RolandThsive/3D-printer-Plastic-Recycler/1.png

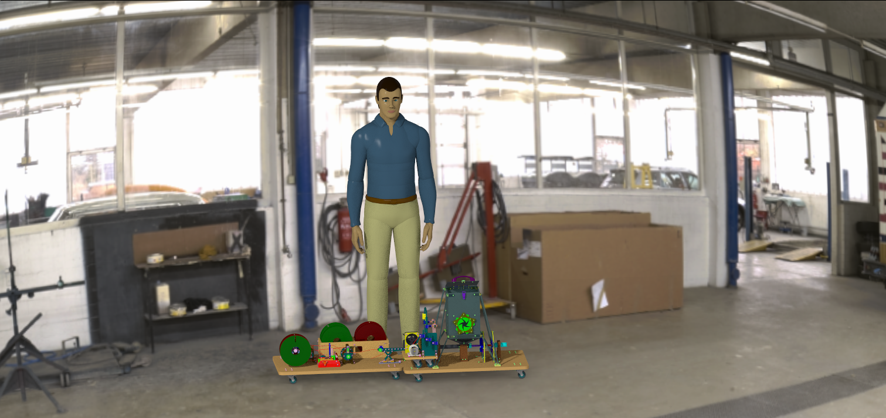
1.png
