RolandThsive/3D-printer-Plastic-Recycler/README.md

# 3D-printer-Plastic-Recycler
A device to recycle 3d Printed plastic back to filament

To view the final file - Go to assemblage_final - It containes the whole assembly.
