RolandThsive/3D-printer-Plastic-Recycler/2020-05-30 Données annexes (André ERNESTO)/2019-12-06 Rapports de conception/Projet Bobineuse - Groupe A1.pdf

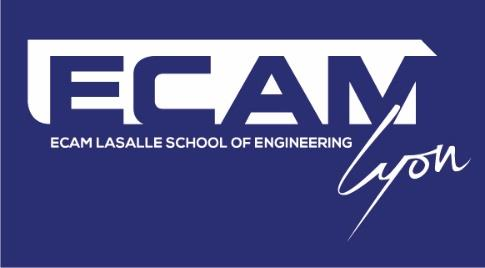
[picture p2: figure]

# RAPPORT DE PROJET BOBINEUSE

### Par FIL’ECAM3D

### ARTS ET METIERS PROMO 2022

Tuteur : Mr. Ernesto André

Membres du projet : | GROUPE A

Ambroggi Franc
Caltran Thibault
De Salins Hippolyte
Hugonnot Sarah

Khelifi Antoine
Masseret Alexandre
Mangin Simon
Picou Adrien

# Sommaire :

# - Introduction au projet

# - Prémices du projet

# - Les différents pôles de la bobineuse : I) Guidage et découpe II) Orientation du fil III) Maintien de la bobine IV) Moteur V) Support général VI) Sécurité et pédagogie

# - Annexes

Introduction du futur projet :

L’année dernière, l’ECAM a mis en place une extrudeuse afin de pouvoir fabriquer son propre fil polymère utilisé pour les imprimantes 3D.

Le but final est de faire des économies quant à l’achat de bobines de fil pour imprimantes 3D mais aussi de participer au recyclage des déchets plastiques (pots de yaourt, emballages, bols…) qui peuvent servir de matière première pour ces fils. Cela ira du nettoyage des déchets plastiques au stockage des bobines avant l’utilisation pour les imprimantes 3D. En outre, l’alimentation en électricité pour être renouvelable (solaire par exemple). Après l’extrusion, une bobineuse est nécessaire pour enrouler le fil proprement sur des bobines et ainsi pouvoir le stocker plus facilement. Cette machine est donc un besoin matériel mais aussi essentiel afin de répondre aux différents besoins. Ce besoin est apparu parce qu’à la sortie de l’extrudeuse, le fil polymère se déposait sur l’embase de l’extrudeuse de manière désorganisée.

Elle devra pouvoir être utilisé par le corps enseignant de l’ECAM mais aussi par les étudiants travaillant sur divers projets. Cette bobineuse se situera au FABLAB sur une chaîne de production juste après l’extrudeuse. Celle-ci pourra aussi être amenée à être déplacé au sein de l’école ou même en dehors selon les cas d’usage. La machine pourra être accessible à tous, que ce soit pour l’observer et comprendre son fonctionnement ou bien l’utiliser en vue de mener divers projets.

De plus, cette machine est avant tout un projet avec un but pédagogique. Celui-ci doit amener les étudiants à travailler en groupe pour commencer à vivre une première expérience de réflexion sur un projet. Ce groupe de travail devra apprendre à résoudre les différents problèmes jalonnant cette entreprise afin de trouver les meilleures solutions et ainsi concevoir une bobineuse avec un rendement optimal. Il aura la fonction de bureau d’études, de bureau des méthodes et enfin d’atelier de fabrication. Pour cela, les huit étudiants en ECAM3 ARTS ET MÉTIERS, Franc AMBROGGI, Thibaud CALTRAN, Hippolyte DE SALINS, Sarah HUGONNOT, Antoine KHELIFI, Alexandre MASSERET, Simon MANGIN et Adrien PICOU devront piloter un projet, concevoir et dimensionner un système mécatronique, utiliser les outils numériques de CAO et fabriquer la bobineuse à l’aide d’un prototypage rapide. Cette équipe sera encadrée par Mr André ERNESTO, professeur de conception mécanique et CAO.

Prémices du projet :

## La mise en forme de notre bobineuse s’est faite à l’aide de

plusieurs outils connus dans le monde de l’industrie.

## Nous avons commencé en créant une bête à cornes puis un diagramme en pieuvre pour pouvoir sortir des fonctions importantes de notre bobineuse. Ces fonctions se sont incorporées dans notre cahier des charges que notre professeur

nous a préalablement fourni.

## Nous avions un budget de 750€ et après estimation, nous

avoisinons les 300€ de frais matériels.

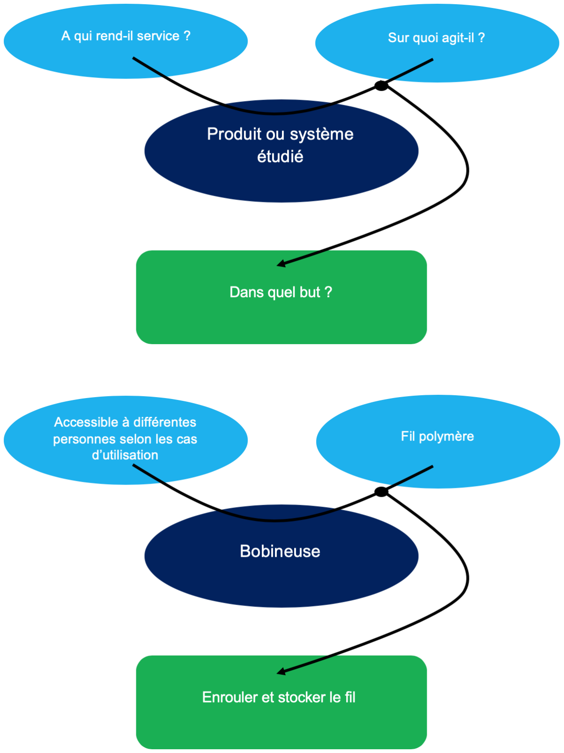
[picture p3: figure]

# La bête à cornes

# Fil

# Bobine

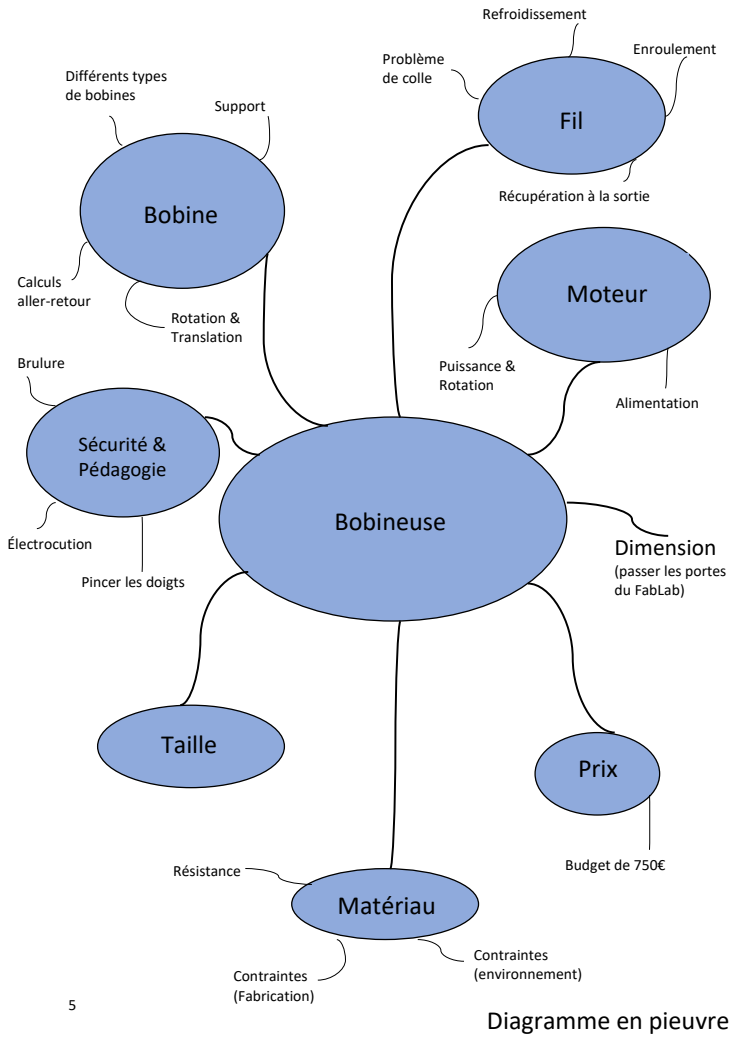
[picture p4: page 6]
Bobineuse; Moteur; Taille; Prix; Matériau; Différents types de bobines; Support; Rotation & Translation; Sécurité & Pédagogie; Calculs aller-retour; Problème de colle; Refroidissement; Enroulement; Résistance; Contraintes; (environnement); (Fabrication); Budget de 750€; Brulure; Électrocution; Puissance & Rotation; Alimentation

Récupération à la sortie

Dimension
(passer les portes
du FabLab)

Pincer les doigts

Diagramme en pieuvre

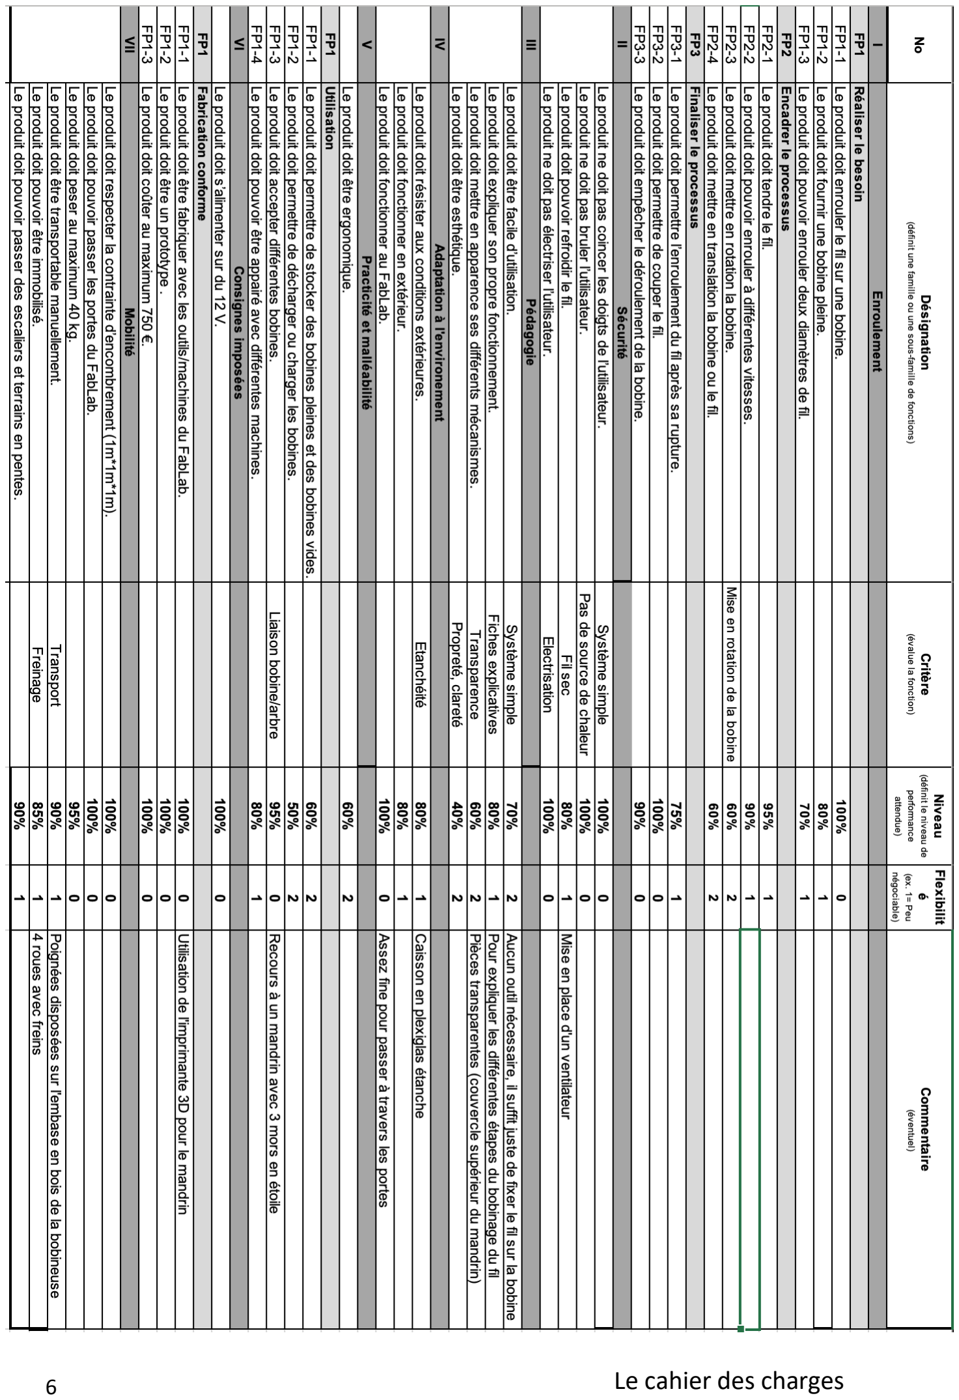
[picture p5: page 7]

6 | Le cahier des charges

# SOUS-ENSEMBLE : GUIDAGE ET DÉCOUPE

## TABLES DES MATIERES :

## I) Description du problème II) Principe du stylo rétractable III) Coûts

I) Description du problème

Tout d’abord, cette partie de la bobineuse est la première de la chaîne. Ce système est composé de deux pièces : une première pour découper le fil et une autre pour maintenir le fil pour éviter que le fil déjà enrouler sur la bobine se déroule. Ce système peut intervenir en cas de problèmes ou lorsque la bobine est pleine. Il fonctionne manuellement et nécessite donc l’aide du technicien responsable de la machine. Il suffit d’appuyer une première fois sur un bouton pour actionner la machine, le fil va alors être découpé au niveau de la sortie de l’extrudeuse. Le système est alors bloqué dans cette position grâce au principe du « stylo » afin que la pince maintienne le fil. Puis pour enlever la bobine pleine, il suffit qu’une personne maintienne le fil, en le gardant tendu, afin que la pince puisse retrouver sa position initiale en appuyant une seconde fois sur le bouton.

II) Principe du stylo rétractable

Le mécanisme a été placé pour la première fois dans un Parker Jotter, (https://en.wikipedia.org/wiki/Jotter) usine de fabrication de stylo, en 1954 et s’est vendu dans cette seule configuration à plus de 750 millions d’exemplaires. Ce système repose en une géométrie simple mais efficace. L'idée nous est venue car nous souhaitions que le fil soit à la fois maintenu et coupé, et qu'une fois coupé ce dernier reste maintenu.

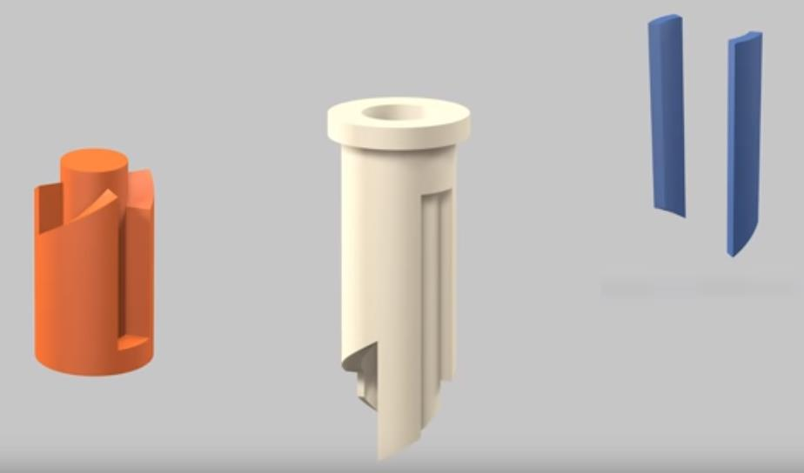
[picture p6: figure]

Vidéo explicative sur YouTube : How a Retractable Ballpoint Pen Works

lien: https://www.youtube.com/watch?v=MhVw-MHGv4s&t=181s

Pourquoi ce système ?

Au départ, nous avions pensé à un mécanisme capable d’effectuer les deux actions simultanément, puis on s’est rendu compte qu’il nous fallait une marge plus grande, pour qu’entre la découpe et le maintien se trouve suffisamment de fil pour ensuite pouvoir le récupérer manuellement. Alors nous avons imaginé un système divisé en deux parties mais qui sont mis en marche en même temps et par le même mécanisme, ici un bouton poussoir.

## III) Coûts

- 20*TÊTE CYLINDRIQUE BOMBÉE LARGE EMPREINTE POZIDRIVE TCBLZ DIN 7985 : 2,06€
- 20*RONDELLE "Z" ACIER ZINGUÉ BLANC NFE 25513 : 0,17€
- Boîte de 5 ressorts de compression : 6,10€
- 1*tige de longueur 80mm et de diamètre 10mm ; tige qui sera ensuite percée puis taraudée aux deux extrémités à 5mm : 3,38€
- Barre de métal carrée creuse (section :10*10mm) et 1 m de longueur pour usinage : 6,10€
- Pylône en acier creux : 20*20mm et 1m de longueur pour usinage : 7,20€
- 2*patins de pinçage en plastique à usiner dans une plaque en plastique : 2€
- 1*cylindre creux (diamètre extérieur : 20mm ; diamètre intérieur : 16mm) : 5€
- 10*écrou M5 : 0,48€
- 1 pièce intermédiaire à usiner : pièce de métal plate de 2mm d’épaisseur, 15mm de hauteur et de 50mm de longueur, trous percés aux 2 extrémités : 3,90€ : -trou de 10,5mm

-trou de 5,5mm

- 2 pièces imprimées en 3D (pour le maintien et l’amortissement de la lame lors de la découpe)
- Lame à découper dans une plaque de métal puis à aiguiser si besoin
- Tôle en métal : 5,99€ ; dans laquelle on usine 3*socles cylindriques ( 1mm d’épaisseur) à souder sur les 2 pylônes et le cylindre creux
- Système du stylo à imprimer en 3D

Total : 42,38€

Sources : | « commentfer.fr » | , | « visseriesfixations.fr », | « rs-online.com »,
« leroymerlin.fr »

# SOUS-ENSEMBLE : ORIENTATION DU FIL

## TABLE DES MATIERES

I- | Schéma cinématique
II- | Fonctions contraintes et principales du Cahier Des
| Charges

## III- Désignations des pièces - Choix matériaux et moyens de fabrication - Dimensionnement - Références des pièces à acheter IV- Analyse budgétaire V- ANNEXE : Dessins

I- Schéma cinématique

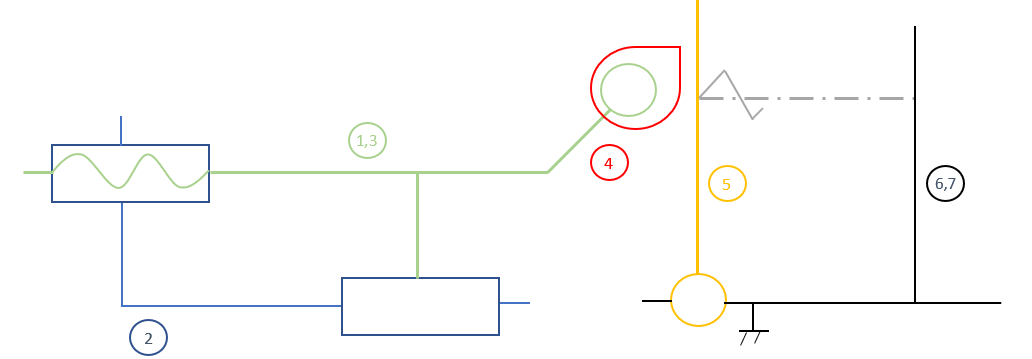
[picture p7: figure]

Fonctionnement global du sous-ensemble :

Le but de ce sous-ensemble est d’orienter le fil de façon à remplir la bobine uniformément entre ses deux extrémités. Pour cela, le fil est contraint de suivre le mouvement de l’extrémité de la pièce N°5. Cette même pièce est en liaison pivot avec le bâti, ce qui lui permet d’osciller dans un mouvement de balancier. Ce mouvement est contrôlé par la came N°4 qui pousse la pièce N°5 dans un sens et par le ressort N°5a qui la ramène dans sa position initiale. Ce mouvement est également implicitement contrôlé par les pièces N°1,3 et N°2. Celles-ci permettent de choisir la distance séparant la came N°4 de la pièce N°5 et ainsi d’obtenir des oscillations d’amplitudes plus ou moins grande. Le mouvement avance/recul de la came N°4 est autorisé grâce à la combinaison des liaisons hélicoïdale et glissière. Finalement, la bobine à remplir est en rotation autour d’un axe perpendiculaire au fil, tandis que celui-ci balaie l’espace disponible : l’enroulement organisé du fil est assuré.

II- Fonctions contraintes et principales du Cahier Des Charges

ENROULEMENT

Le produit doit pouvoir enrouler deux diamètres de fil.
Cela est pris en compte dans la variation de vitesse soit de la came, soit de la bobine.

Le produit doit mettre en translation la bobine ou le fil.
Finalement, le produit met en translation le fil. Plus précisément, la bobine est en rotation autour de son axe et le fil est orienté tout du long de celle-ci. Ce mouvement est possible grâce à la pièce N°4, une came qui vient faire pivoter la pièce N°5 dont le rôle est de soutenir le fil. Ce mouvement de balancier va alors permettre le balayage de la bobine entière par le fil qui va s’enrouler de façon contrôlée et organisée.

PEDAGOGIE

Le produit doit être facile d’utilisation.
L’utilisateur n’a de contact qu’avec une seule pièce, la N°1 : une tige filetée qui permet la translation du moteur servant à mettre en rotation la came N°4. La translation est provoquée par la rotation de la tige filetée N°1. L’utilisateur n’aura alors d’action que sur cette pièce afin de contrôler la distance entre la came N°4 et la pièce N°5. Un seul degré de liberté lui sera accordé, et même conseillé, la rotation de la pièce N°1.

Le produit doit expliquer son propre fonctionnement.
Un tableau explique à l’utilisateur jusqu’où viser afin que la came N°4 soit à son bon positionnement en fonction de la taille de la bobine.

Le produit doit mettre en apparence ses différents mécanismes.
Toutes les pièces principales de ce sous-ensemble sont visibles. La vis N°1, les rails N°2 ainsi que le support moteur N°3 imitent le principe de fonctionnement d’un étau. Le réglage de la distance de la came N°4 est permis grâce à la combinaison des liaisons hélicoïdale (entre les pièces N°1 et N°2) et glissière (entre N°3 et N°2) : la vis N°1 est bloquée en translation dans la pièce N°3 par la vis N°3b positionnée perpendiculairement à celle-ci. Ce principe devient alors très compréhensif lorsque l’on voit le mécanisme en action. Toutes les liaisons mécaniques : hélicoïdale, glissière ainsi que pivot entre N°5 et N°6 sont apparentes.

PRATICITE ET MALLEABILITE

Le produit doit accepter différentes bobines.
Grâce au réglage possible de la position de la came N°4 par rapport à la pièce N°5, le fil peut balayer la distance souhaitée par l’utilisateur et donc le produit peut remplir plusieurs types de bobine.

CONSIGNES IMPOSEES

Le produit doit s’alimenter sur du 12 V.
La pièce N°9, le moteur mettant en translation la came s’alimente en Courant Continu 12V.

III- Désignations des pièces

DESIGNATION DES PIECES
N° DE LA PIECE | NOM DE LA PIECE | MATERIAUX | MOYEN DE FABRICATION
0 | Moteur
1 | Tige filetée | Acier | TCN
1b | Écrou
2 | Rails | Acier | TCN
3 | Support moteur | Acier | TCN
3b | Vis
4 | Came | Plastique | Imprimante 3D
4b | Clavette
5 | Guidage fil | Bois | Découpe laser
5a | Ressort
5b | Joint
6 | Support pivot | Acier | TCN
7 | Support ressort | Bois | Découpe laser
7b | Vis
8 | Arbre moteur | Acier | TCN
8b | Écrou

Pièce N°0 : Moteur

On sait qu’un aller-retour du fil sur la bobine équivaut à un tour complet de la came. De plus, durant un tour complet de la came, la bobine doit effectuer l diamètre du fil

tours. Donc la vitesse de rotation de la came est proportionnelle à celle de la bobine. Pour une vitesse wbobine fixée, wcame =

w.diamètre du fil
l

REFERENCE D’ACHAT : https://www.amazon.fr/DOLITY-Moteur-Courant-Continu-Engrenages/dp/B07HWTQMG8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 (https://www.amazon.fr/DOLITY-Moteur-Courant-Continu-Engrenages/dp/B07HWTQMG8)

Pièce N°1b et Pièce N°8b : Écrous

REFERENCE D’ACHAT : https://fr.rs-online.com/web/p/ecrous-hexagonaux/1224405/ (https://fr.rs-online.com/web/p/ecrous-hexagonaux/1224405/)

Pièce N°3b : Vis

REFERENCE D’ACHAT : https://fr.rs-online.com/web/p/vis-a-six-pans/4838269/

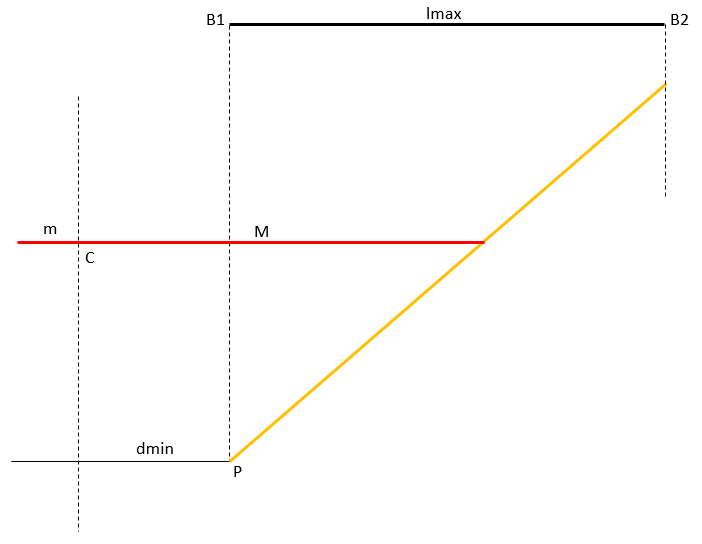
[picture p8: figure]

Pièce N°4 : Came

Dans un premier temps, on se place à dmin= 10mm avec une bobine de longueur maximale lmax. Ainsi on pose m = 8mm < dmin puis on calcul distance M = dmin +

lmax
2

d’après le
théorème de Thalès.
Dans un second temps, une fois la came fixée avec m et M, on calcul d pour un l donné : d = M -

l
2

Pièce N°4b : Clavette

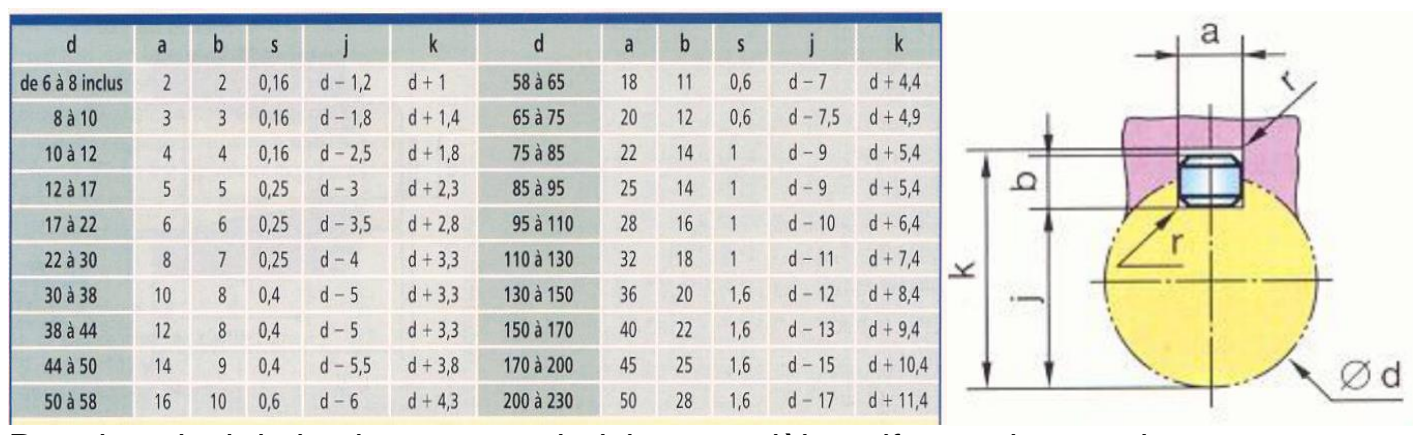
[picture p9: figure]

Pour le calcul de la clavette, on choisit un modèle uniforme de pression au contact entre la clavette et le moyeu : Pour tout MꞒS, p(M) = p = F
S

Calcul de la pression de contact :

d
2

x F = C d’où F = 2C
d

dans l’hypothèse où les
dimensions de la clavette sont petites devant le diamètre.
Avec d : diamètre de l’arbre
h : hauteur de la clavette en contact avec le moyeu et h = j + b - d l : longueur de la clavette
b : hauteur de la clavette
j : cote de position du fond de la rainure

Ainsi S = l x h = l (j + b – d). Soit, en tenant compte du critère : l > 2C padm.d(j+b−d) .

REFERENCE D’ACHAT : https://fr.rs-online.com/web/p/products/3023999/

Pièce N°5a : Ressort

REFERENCE D’ACHAT : https://fr.rs-online.com/web/p/ressorts-de-compression/0821251/ (https://fr.rs-online.com/web/p/ressorts-de-compression/0821251/)

Pièce N°5b : Joint

REFERENCE D’ACHAT : https://www.conrad.fr/p/joint-axxatronic-sa8-noir-1-pcs-1279804 (https://www.conrad.fr/p/joint-axxatronic-sa8-noir-1-pcs-1279804)

Pièce N°7b : Vis

REFERENCE D’ACHAT : https://fr.rs-online.com/web/p/vis-a-six-pans/2328423/
IV- | Analyse budgétaire
N° DE LA PIECE | NOM DE LA PIECE | COUT A L’UNITE (€) | PRIX AU PAQUET (€)
0 | Moteur | 13.13 | 13.13
1 | Tige filetée
1b | Ecrou | 0.17 | 10.18
2 | Rails
3 | Support moteur
3b | Vis | 0.152 | 18.19
4 | Came
4b | Clavette | 0.34 | 3.40
5 | Guidage fil
5a | Ressort | 0.278 | 2.78
5b | Joint | 2.24 | 2.24
6 | Support pivot
7 | Support ressort
7b | Vis | 0.265 x 2 | 15.89
8 | Arbre moteur
8b | Ecrou | 0.17 | ---
TOTAL | | 16.98 | 65.81
V- | ANNEXES

Dessin d’ensemble « Sous-ensemble orientation du fil » : 4 feuilles A3 Dessins de chaque pièce du sous-ensemble : 8 feuilles A4

# SOUS-ENSEMBLE : MAINTIEN DE LA BOBINE

## TABLES DES MATIERES :

## I) Analyse globale de la solution retenue II) Support et rotation de l’arbre III) Arrêt en translation et en rotation du mandrin IV) Étude du mandrin, support de la bobine

Vis à bois à tête cruciforme

I) Analyse globale de la solution retenue :

Afin de pouvoir à la fois maintenir la bobine et s’adapter à différents diamètres de bobines, nous avons décidé de mettre en place un mandrin qui grâce à son système de mors en étoile permettra de répondre à ces deux exigences capitales.

Cet ensemble de pièces sera composé de :

- 3 mors,
- 3 boutons moletés avec pignon,
- Un couvercle supérieur,
- Un couvercle inférieur
- Une pièce complexe cylindrique avec d’un côté des rainures formant une spirale et de l’autre une face dentée.
- Un support maintenu par deux vis sur lequel sera déposé le moteur,
- Deux piliers maintenus par deux vis chacun.

Le moteur sera disposé sur un plateau maintenu par des vis à bois à tête cruciforme de type FZ et entraînera en rotation un arbre qui passera à travers deux piliers. Au bout de cet arbre, nous trouverons le mandrin qui sera arrêté en rotation mais aussi en translation à l’aide d’une clavette et d’un écrou à encoche.

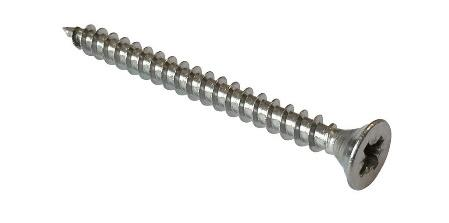
[picture p10: figure]

II) Support et rotation de l’arbre :

L’arbre de sortie du moteur aura un diamètre de 10mm et entraînera en rotation grâce à un méplat mâle dans l’arbre principal de 30mm. Un méplat femelle sera réalisé dans l’arbre principal avec une fraise puis une broche. Il sera disposé sur un support en bois.

Afin d’assurer le maintien de l’arbre et d’éviter un problème de porte-à-faux qui pourrait être fatal à la bobineuse, celui-ci sera soutenu par deux piliers qui seront réalisés en bois. Les piliers seront fixés sur l’embase (elle-aussi en bois) avec des vis à bois à tête cruciforme de type FZ.

Achat : 6 vis tête fraisée pozidrive vis bois VBA TFZ acier zingué bichromaté 4.5x25

Prix unitaire à 0,0240 € (0,03€ TTC), REF : VBATFZ04.5/025BI.

Pour assurer la rotation de l’arbre, il y aura deux coussinets en bronze qui seront disposés à l’intérieur des deux piliers.

L’arbre aura un diamètre de 30mm au début, puis 42mm entre les deux arbres, puis à nouveau 30mm et enfin 10mm sur la surface où sera déposé le mandrin. Il sera réalisé en acier C40 (350MPa≤Re≤460MPa). C’est un acier pour trempe + revenu et pour forgeage non allié avec une teneur moyenne en carbone (0,40% de carbone).

Au niveau du dimensionnement des coussinets, en s’appuyant sur la norme ISO, ils auront un diamètre de 40mm et une longueur de 25mm pour un arbre de diamètre 30mm.

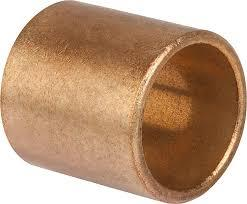
[picture p11: figure]

Pour le calcul des coussinets (en régime non hydrodynamique), il faut déterminer la pression diamétrale (en MPa ou N/mm²
) : p =

F
d×L

avec F la charge sur le palier (en N), d le diamètre de l’alésage (en mm) et L la longueur du coussinet (en mm).

Coussinet utilisé
pour la bobineuse

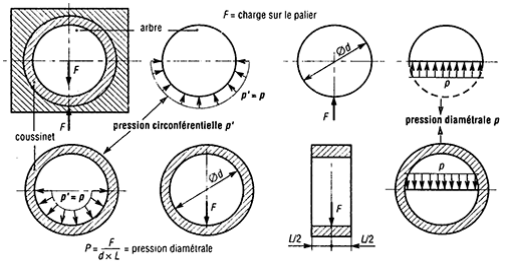
[picture p12: figure]

Pression diamétrale p et
pression circonférentielle p’

La pression diamétrale p répartie uniformément sur la surface diamétrale d×L est égale à la pression circonférentielle p’ répartie uniformément sur une demi périphérie.

Avec la pression diamétrale p calculée, nous pourrons déterminer le produit pV qui permet de mesurer la capacité du matériau à supporter l’énergie engendrée par le frottement. S’il y a dépassement, la température du palier lisse augmente et il y a risque de destruction :

Où v =

πNd
60

avec N la vitesse de rotation (tr.min⁻¹ ) et le diamètre de l’arbre.

Nous avons fait le choix de prendre des coussinets en bronze fritté. Le produit pV admissible doit donc être environ égal à 1,8 (N/mm²
).(m/s).

Au niveau des tolérances, le coussinet doit être monté serrer sur la bague extérieure (tolérance H7) et glissant sur l’intérieur (tolérance f7). Il pourra être monté à la presse.

Calculs :

p =

Charge radiale
Surface projetée

Avec l’abaque, pour d=30mm et n= 600 tr/min, on a p ≈ 1,8MPa.

On a de plus : V= r × ω = 30.10⁻³ × 600 × π
60

= 1 m.s⁻¹
Pour le produit pV ;

pV= 1,8 Nm/mm²s
p =

F
S

=

F
d×L

avec F = 1500N,
pV = F×V
d×L

= 1,8 < 2,
→ L >

1500 ×1
30 ×2

= 25 mm

On prend L = 25 mm.

Désignation : Coussinet cylindrique fritté 30×40×25

Achat : Coussinet cylindrique auto-lubrifiant en bronze fritté

REF : FP38221, 7,2213€ (8,6656 € TVA incluse).

pV = pression diamétrale (N/mm2) × vitesse circonférentielle (m/s)

III) Arrêt en translation et en rotation du mandrin :

Afin d’arrêter le mandrin en rotation et en translation (donc réaliser une liaison encastrement), nous avons choisi comme solution d’arrêter le et en translation à l’aide d’un épaulement à gauche et d’un écrou à encoches à droite avec rondelle de sécurité et en rotation à l’aide d’une clavette parallèle.

L’écrou à encoches a pour fonction d’immobiliser axialement le mandrin à droite. Un problème majeur est que si on vient serrer l’écrou à encoches à droite, l’arbre va vouloir sortir par la gauche. Pour pallier ce problème, nous avons décidé de réaliser un épaulement sur l’arbre entre les deux piliers en bois. Le diamètre sera alors de 42mm.

Les encoches seront utiles pour venir y replier les extrémités de la rondelle frein pour empêcher le desserrage.

Ayant un diamètre de 12mm en bout d’arbre et pour respecter la norme ISO, nous avons décidé de mettre un écrou à encoches de diamètre 12mm, de pas 1mm et d’épaisseur 4mm. La rondelle frein aura alors une épaisseur de 1mm et l’encoche fera 3mm de large pour 1,5mm de haut.

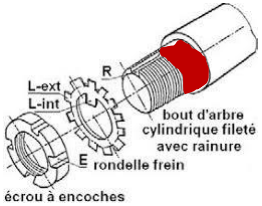
[picture p13: figure]

La rainure sera réalisée avec une fraise à rainurer et le filetage avec un outil à tarauder.

Achat :

- Écrou de serrage à encoches série KM (KM1 c’est-à-dire M12 avec un pas de 1mm) en acier 40 kg/mm²
, prix ; 6,14€ HT (7,31€ TCC), REF : 95018002.
- Rondelle-frein MB1-SKF (diamètre 12mm), prix; 1,56 € TTC,
REF ; 3663952263397

Montage d’un écrou à
encoches avec rondelle frein sur arbre fileté avec rainure

: Surface occupée par le

Pour arrêter l’arbre en translation à droite, un épaulement sera réalisé avec une diminution du diamètre de l’arbre de 30 à 10mm. Cet épaulement évite d’avoir un contact entre le pilier de droite et le mandrin ce qui pourrait entraîner une usure du mandrin.

Les différents diamètres de l’arbre seront réalisés à partir d’un lopin cylindrique de diamètre 35mm que l’on viendra usiner avec un outil à charioter-dresser pour obtenir les différents diamètres et ainsi avoir les épaulements. On viendra ensuite découper ce lopin de 40mm de long avec un outil à tronçonner.

Achat :

- Barre en acier rond INOX 304L diamètre 30mm/longueur 1000mm, prix ; 51,70 € (62,04 € TCC), REF : 304LD30.

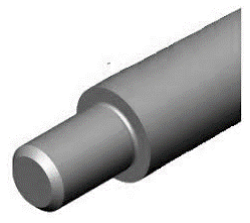
[picture p14: figure]

Enfin pour assurer l’arrêt en rotation, il faudra mettre une clavette en acier. Pour un arbre de diamètre 10mm il faudra une clavette de hauteur 4mm et de largeur 4mm d’après la norme ISO.

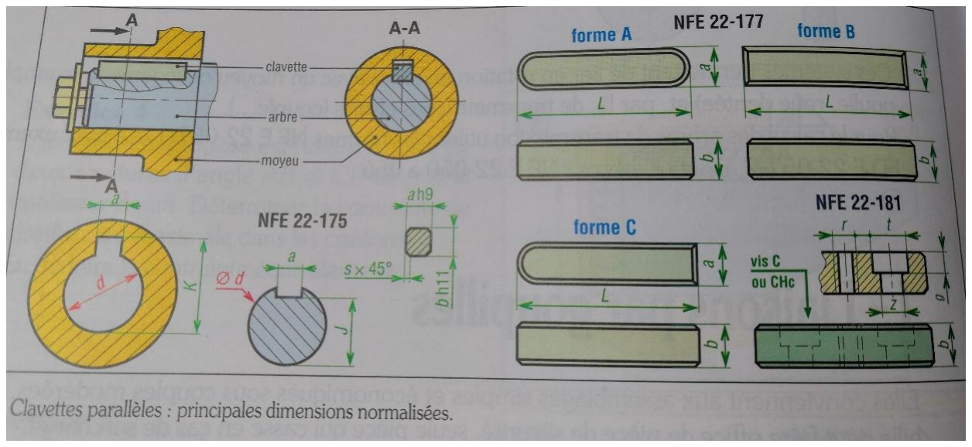
[picture p15: figure]

Dimension des clavettes
parallèles

Épaulement réalisé sur
un arbre

La clavette sera désignée par sa désignation :

Clavette parallèle, forme A, 4×4×L, NF E 22-177

Celle-ci doit respecter la condition suivante : Rr ≥ 600MPa.

Comme les clavettes sont en acier, on prendra un acier C45 (630MPa≤Rr≤850MPa). C’est un acier pour trempe + revenu et pour forgeage non allié avec une teneur moyenne en carbone (0,45% de carbone).

Au niveau des tolérances, nous aurons une tolérance D10/h9 entre le moyeu et la clavette, une tolérance H9/h9 entre l’arbre et la clavette et enfin une tolérance H7/g6 entre l’arbre et le moyeu. Cela correspond à un ajustement serré de la clavette sur l’arbre et « glissant juste » entre la clavette et le moyeu.

La rainure de la clavette sera réalisée avec une fraise à rainurer.

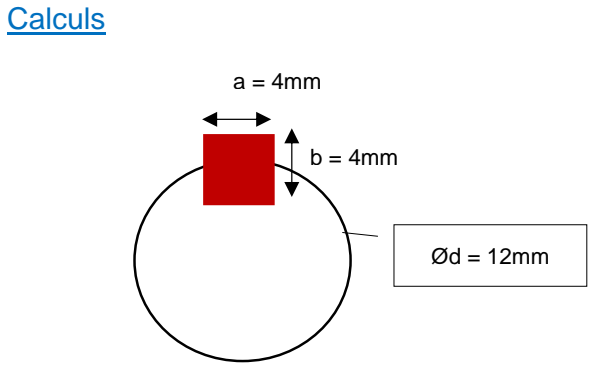
[picture p16: figure]
Calculs

Calcul de la pression de matage car plus restrictif,

- p =

F
S

=

4C
L.b.D

avec F =

C
R

et S = L ×

b
2
- p< padm
- Donc 4C
L.b.D

< padm → L > 4C
L.b.D
Pour un montage fixe avec de bonnes conditions de fonctionnement, on a : padm = 100MPa.

Caractéristiques moteur :

- P = 10W, N = 600 tr.min⁻¹ ,
- ω = 600 × π
30

= 62,8 rad.s⁻¹
,
- P = C × ω = 0,16 Nm.

→ L > 4×0,16.10³
4×12×100 → L > 0,13 mm

a = 4mm

L

Forme A

On veut L
D

< 1,5 donc L < 18mm.
On prend L = 18mm (longueur normalisée).
Désignation : Clavette parallèle, forme A, 4 × 4 × 18, NF E 22-177

Achat : Clavette parallèle dim-6685, type haut en acier (C45)

REF : FP40469, 0,0953€ (0,1144€ TVA incluse).

IV) Etude du mandrin, support de la bobine :

La bobine sera maintenue par un mandrin où toutes les pièces seront en plastique d’impression 3D. Habituellement utilisé sur des tours à commande numérique ou des fraiseuses, cet ensemble de pièces permettra de s’adapter aux différents diamètres de bobines. Il aura un diamètre de 98mm et une hauteur de 45mm.

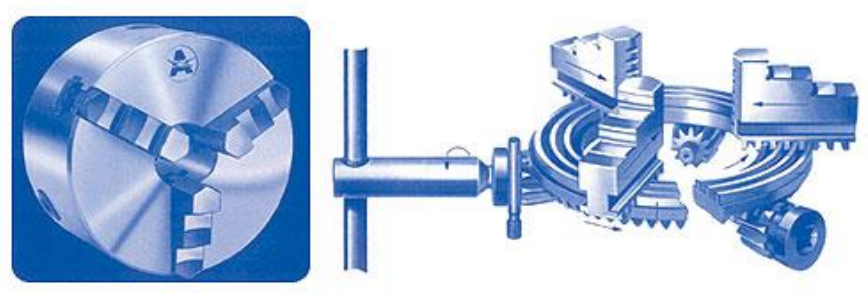
[picture p17: figure]
mandrin à trois mors en étoile

Principe de fonctionnement :
- Un mandrin est composé de :
- 3 mors,
- 3 boutons moletés avec pignon,
- Un couvercle supérieur,
- Un couvercle inférieur
- Une pièce complexe cylindrique avec d’un côté des rainures formant une spirale et de l’autre une face dentée.
- En tournant le bouton moleté à la main, le pignon va entrer en rotation et engrener avec la surface dentée de la pièce complexe. Cette pièce entrera alors elle-aussi en rotation. Sur sa surface rainurée en spirale, il y aura trois mors rainurés sur la surface inférieure. Par ce mouvement de rotation, les trois mors disposés en étoile se translateront soit vers l’avant ou soit vers l’arrière selon la rotation du bouton moleté.

Schéma expliquant le fonctionnement d’un

Schéma expliquant le fonctionnement d’un mandrin à trois mors en étoile

Normalement, ce ne sont pas des boutons moletés qui sont utilisés dans un mandrin mais des vis avec pignons. Nous avons préféré choisir des boutons moletés puisqu’il n’y a pas besoin d’outils (clé…) pour desserrer les mors à l’inverse des vis avec pignons. Cela évite notamment une perte de temps à chercher l’outil si celui-ci n’a pas été replacé à sa place habituelle.

Le moletage permet d’assurer une adhérence suffisante pour la manœuvre d’une pièce à la main. On mettra un moletage droit avec un angle d’inclinaison a de 0°.

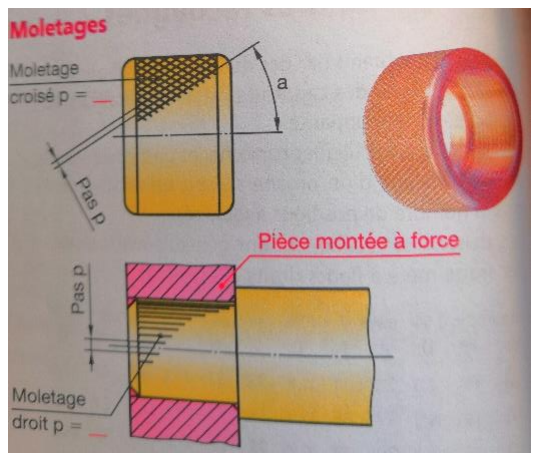
[picture p18: figure]

Ces boutons moletés avec pignon seront réalisés par impression 3D au FabLab de l’ECAM Lyon. Le diamètre des pignons à denture droite sera de 20mm avec un module m=1,3mm donc un nombre de dents Z1= 15 dents.

Le couvercle inférieur sera lui aussi réalisé par impression 3D et présente une rainure de clavette. Pour le couvercle supérieur (qui sera transparent pour expliquer le fonctionnement du madrin), il sera plus complexe à réaliser par impression 3D. Bien sûr il aura lui-aussi une rainure de clavette mais aura de plus trois rainures disposées en étoiles et concourantes vers le centre du couvercle afin d’y accueillir les trois mors. Un alésage de diamètre 10mm sera réalisé dans chaque couvercle pour assurer le passage de l’arbre ainsi que la rainure de clavette.

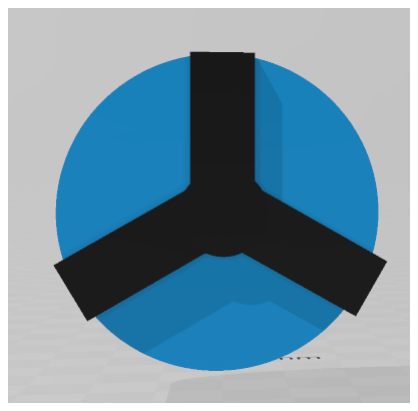
[picture p19: figure]

Ces deux couvercles seront maintenus par l’épaulement à gauche et l’écrou à encoches à droite.

Moletage

Vue de face du couvercle
supérieur avec l’alésage et les trois rainures

Concernant les trois mors, ce seront de simples parallépipèdes et non des mors en escalier (utilisés dans la plupart des cas). L’angle φ entre chaque mors sera de 120°.

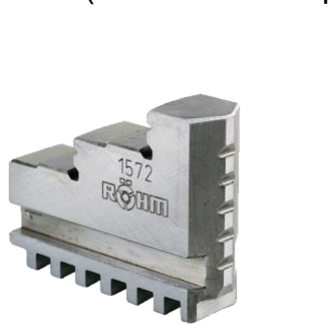
[picture p20: figure]
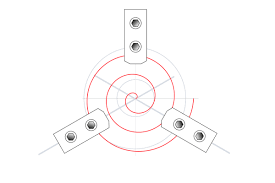
[picture p21: figure]

Ces trois mors seront réalisés par impression 3D.

Les mors feront 10mm de large, 20mm de haut et 7mm d’épaisseur.

Concernant la dernière pièce, elle sera réalisée elle-aussi par impression 3D du fait de sa complexité. Le diamètre extérieur sera de 92mm et celui intérieur sera de 38mm.

Sur la face inférieure de celle-ci, avec un module de 1,3mm, un diamètre moyen de

dmoyen =

(92+38)
2

=204mm donc un pas p= π×m= 4.09mm, on obtient un nombre de dents Z2= 50 dents.

Le fait d’avoir un mandrin réalisé par impression 3D permettra d’avoir un ensemble léger ce qui permettra de ne pas trop solliciter l’arbre.

Disposition des mors

Mors en escalier

Calculs :

Calcul du couple exercé sur le mandrin, avec P = 10W et N = 600tr.min⁻¹ ,

C =

P
ω

=

10
600 ×

π
30

= 0, 16 Nm.

Calcul de la vitesse du mandrin,

v = r × ω = 46. 10⁻³ × 600 ×

π
30

= 2, 8 m. s

−1

Calcul de l’effort exercé sur un mandrin,

P = F × v → F =

P
v

=

10
2,8

= 3, 57 N

Calcul de la masse du mandrin,

F = m × g → m =

F
g

=

3,57
9,81

= 0,364 kg = 364 g

Le mandrin aura alors une masse de 364g.

# SOUS-ENSEMBLE : MOTEUR

## TABLES DES MATIERES :

## I) Le moteur principal II) Le moteur pour la came

## I) Le moteur principal

Fonction à remplir :

Mise en rotation de l’arbre sur lequel sera positionner la bobine

Solution choisie :

L’arbre sur lequel sera positionner la bobine sera en liaison encastrement avec l’arbre d’un moteur électrique à courant continu (avec balai).

Choix du moteur :

Pour dimensionner le moteur, il faut déterminer la vitesse à laquelle il devra tourner le couple nécessaire. De plus notre système doit pouvoir accueillir un large panel de bobines, présentant des rayons intérieurs et des rayons maximums différent. Pour sélectionner le moteur nous avons donc pris l’échantillon de bobines disponible pour déterminer les dimensions extrêmes que pouvait avoir une bobine. Nous avons donc créé un tableau Excel nous permettant d’avoir les cotations d’une bobine aux dimensions minimales et les dimensions d’une bobine maximale. Les valeurs de la colonne min sont les plus petites valeurs auxquelles on a retranché 10%, et, les valeurs de la colonne Max sont les valeurs les plus élevés auxquelles on a ajouté 10%.

La vitesse d’extrusion maximale est de 15mm/s on en déduit la vitesse de rotation maximale en la calculant pour le plus petit rayon possible : v
r

= ω

Ce qui nous donne :

1,5
3,06

= 0,49 rad/s. Ainsi le moteur doit-il pouvoir faire tourner une bobine pleine d’un poids d’environ 1kg, à une vitesse de rotation de maximale de 0,5 rad/s.

Le poids de la bobine ne nous permet pas de déterminer le couple nécessaire

Bobine paramètres | 1 | 2 | 3 | 4 | min | Max
largeur (cm) | 4,7 | 4,1 | 5,5 | 6 | 3,69 | 6,6
rayon de fixation (cm) | 2,27 | 2,25 | 2,255 | 2,28 | 2,025 | 3,8
rayon intérieur (cm) | 5,25 | 3,4 | 4,5 | 5 | 3,06 | 5,775
rayon extérieur (cm) | 8,85 | 9 | 9,1 | 9 | 7,965 | 10,01

directement. En effet seules les forces de frottement dans le moteur et les frottements de l’air s’opposeront à la rotation.

Nous avons donc choisi le moteur suivant proposant une puissance nominale de 10 w permettant de faire tourner notre arbre à une vitesse de 0,5 rad/sec tout en ayant un couple de 20 Nm largement suffisant pour entrainer l’arbre en rotation. En effet un tel couple permettrait de soulever une charge de 2 Kg avec un bras de levier de 1m.

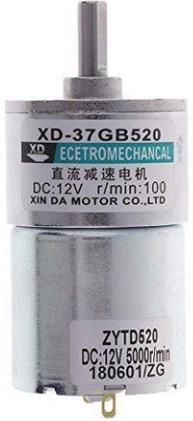
[picture p22: figure]
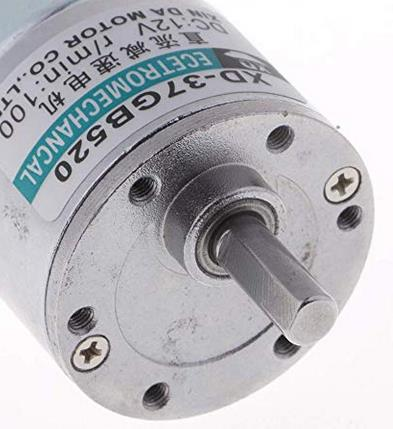
[picture p23: figure]

Il s’agit du Baoblaze XD-37GB520. On a également choisi ce moteur pour son arbre présentant un méplat, ce qui simplifie la fabrication d’une liaison encastrement avec l’arbre sur lequel sera fixé la bobine.

Sous fonction de contrainte :

La vitesse du moteur doit s’adapter à la vitesse d’enroulement du fil qui augmente à mesure que la bobine se rempli. Effectivement la quantité de fil enroulé en un tour de bobine est plus importante lorsque la bobine est presque pleine que lorsque la bobine

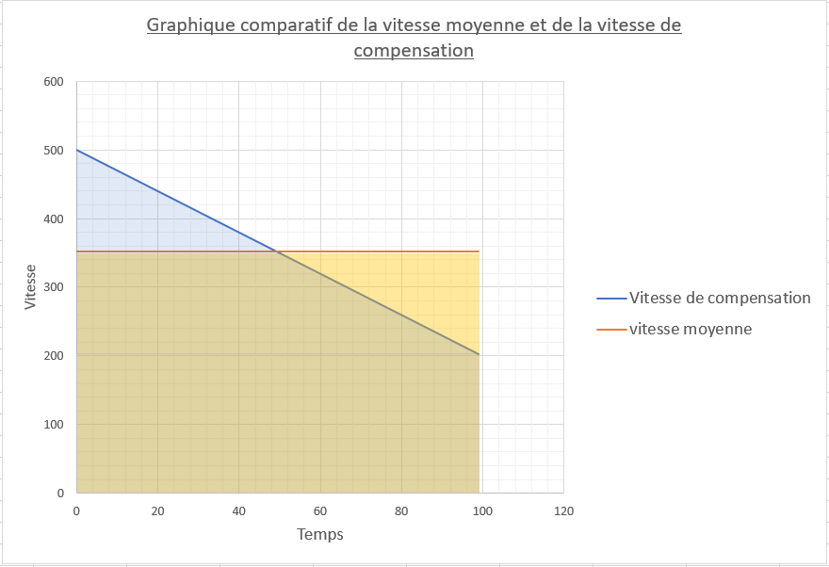
[picture p24: figure]

est vide. Ainsi la vitesse de rotation doit diminuer à mesure que la bobine se remplie de sorte à conserver une vitesse linéaire (vitesse d’enroulement) constante.

Solution choisie :

Nous avons trouvé un moyen de contourner le problème et de ne pas avoir à mettre en œuvre un système faisant varier la vitesse du moteur. Pour ce faire nous avons choisi de faire tourner le moteur qui entraine la bobine à la valeur moyenne des vitesses maximales et minimales. Ainsi en début de bobine la vitesse d’enroulement (vitesse moyenne) sera inférieure à vitesse d’extrusion et du mou se créera. Ensuite lorsque la vitesse moyenne sera supérieure à la vitesse d’extrusion la longueur de mou créé pendant la première partie diminuera complétement jusqu’à ce que la bobine soit terminée. On a représenté sur ce graphique la vitesse du moteur en fonction du temps. La courbe bleue est la vitesse du moteur qui s’adapte progressivement à la vitesse d’enroulement et la courbe orange représente la vitesse moyenne. Les aires sous les courbes représentent la quantité de fil enroulé. On remarque que l’aire sous la courbe bleue et l’aire sous la courbe orange sont égales. En effet pour une vitesse minimale de a mm/s, une vitesse maximale de Amm/s on obtient une vitesse moyenne
de A+a
2

mm/s. Ainsi, l’aire sous la courbe bleue= l’aires sous la courbe orange = A+a
2

∗ t.

Dans notre cas la vitesse de rotation minimale vaut :

Vitesse d

′extrusion

Rayon maximal

=

1
10

= 0,1rad/s,

la vitesse de rotation maximale vaut :

Vitesse d′extrusion
rayon minimal

=

1
3

= 0,33rad/s. On en déduit
une vitesse moyenne de 0,33+0,1
2

= 0,215rad/s.

## II) Le moteur pour la came

Fonction à remplir :

Mise en rotation de l’arbre à came

Solution choisie :

Mise en place d’un deuxième moteur électrique du même type que celui servant à faire tourner l’axe de la bobine.
Nous avons donc opté pour le même moteur, l’alimentation sera commune aux deux moteurs. Ainsi, en cas de problèmes les deux moteurs seront mis hors tension simultanément. De plus les moteurs devront tourner à la même vitesse pour le bon fonctionnement de la came.

# SOUS-ENSEMBLE : SUPPORT GÉNÉRAL

## TABLES DES MATIERES :

## I) Support général II) Environnement extérieur

## I) Support général

L’ensemble des autres pôles viendront se fixer sur une planche en bois. Elle sera pourvue de chevilles métalliques à frapper d’une longueur de 6mm ou de 8mm. Ces chevilles permettront de pouvoir démonter les différents pôles

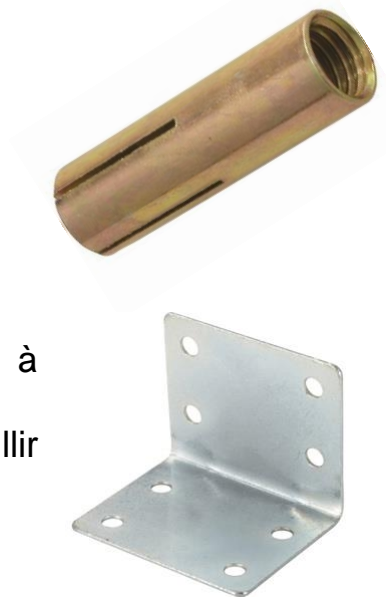
[picture p25: figure]

facilement. La protection en plexiglas est directement visée à même le bois à l’aide d’équerres d’assemblages.
Pour l’assemblage de la came, un trou spécial pouvant accueillir un joint sera fabriqué.

REFERENCE D’ACHAT: https://www.toolstation.fr/chevilles-metalliques-a-frapper/p12620
Prix : Entre 1,91€ et 2,16€ le lot de 10 pièces

## II) Environnement extérieur

A côté de la bobineuse, deux boîtes en bois seront disposées pour permettre le stockage des bobines pleines mais aussi celles vides afin de pouvoir remplacer rapidement les bobines.

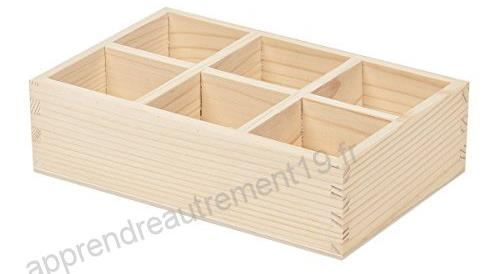
[picture p26: figure]

Ces boîtes seront créées artisanalement à partir de matériaux de récupération pour réduire le coût du projet.

Concernant l’enroulement du fil, aucun outil n’est nécessaire pour desserrer le mandrin puisque nous avons fait le choix de mettre trois boutons moletés qui permettent un desserrage manuel. De même pour la découpe du fil. Si besoin, il y aura à proximité des outils tel que des pinces ou des clés pour gérer la maintenance de la bobineuse.

# SOUS-ENSEMBLE : SÉCURITÉ ET PÉGAGOGIE

## TABLE DES MATIERES :

## I) Sécurité II) Pédagogie

I) Sécurité :

Concernant l’aspect sécurité, la bobineuse doit répondre à plusieurs exigences du cahier des charges :

- Ne pas coincer les doigts de l’utilisateur,
- Ne pas brûler l’utilisateur,
- Ne pas blesser l’utilisateur,
- Être déplacé facilement.

Pour éviter à l’utilisateur de se coincer les doigts, l’équipe a pris la décision de ne pas incorporer d’engrenages ou trains épicycloïdaux dans le système global pour éviter à l’utilisateur de se blesser.

De plus, afin d’assurer une sécurité complète, la bobineuse sera confinée sous un box.

Concernant le risque de brûlures, nous avons décidé de mettre en place un ventilateur en début de chaîne afin d’avoir un fil parfaitement sec en vue de pouvoir l’enrouler sur une bobine.

Un dernier risque à éviter est de blesser l’utilisateur où le personnel se trouvant autour au moment d’une visite du FabLab pour découvrir la bobineuse. Si le fil est amené à être cassé, il y a une possibilité que le fil atteigne le visage d’une personne de manière violente. C’est pour cela qu’une boîte va être déposée sur la bobineuse pour éviter ce genre de situation. Afin de pouvoir accéder à la machine en cas de problème sur celle-ci, nous avons fait le choix de mettre une porte vitrée sur cette boîte. Cette porte comportera une ouverture afin de ne pas gêner le fil au moment de l’ouverture et de la fermeture de la porte. Cette porte sera maintenue par deux charnières à l’arrière De plus, une petite ouverture sera faite à l’arrière pour permettre la sortie des fils des deux moteurs vers le réseau électrique.

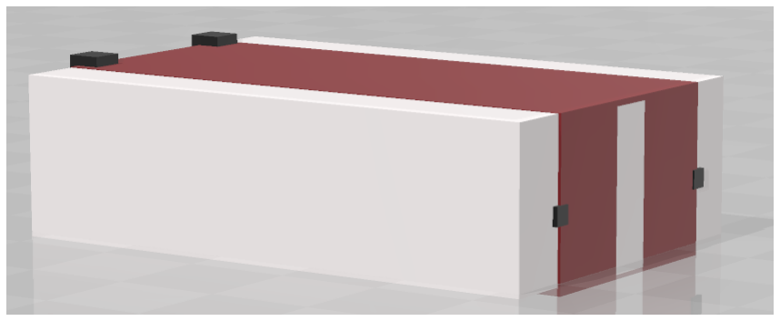
[picture p27: figure]

Vue d’ensemble de la
protection en plexiglas avec la porte avec ouverture fixée avec deux charnières à
l’arrière et deux aimants à l’avant.

Achat :

- Plaque plexiglas 4mm d’épaisseur à 19,16€ (23,00€ TCC), 502×1020mm,
REF ; 100-100-4.
- Lot de 2 aimants magnétiques plastique HETTICH, L.17,3mm×l.75mm (4,30€ l’unité), REF ; 67557952.
- Deux charnières de fixation à 10,72€ l’unité (REF ; ME1059366).
- 8 équerres d'assemblage acier zingué HETTICH, l.32 mm à 0,44€ l’unité

Au niveau de la mobilité de la bobineuse, celle-ci sera fixée sur une planche en bois sur roulettes équipées de freins pour qu’elle soit fixe et stable en phase de fonctionnement. De plus, des poignées seront disposées autour de la bobineuse pour permettre de la porter plus aisément.

Achat :

- Lot de 4 roulettes pivotantes 50mm avec frein (7,69€ TCC), REF ; B006GX8E4O.
- 4 poignées de tirage noires à 1,50€ l’unité, REF ; ME7622726
- Planche en bois

II) Pédagogie :

Au niveau pédagogique, la boîte posée au-dessus de la bobineuse sera transparente pour pouvoir l’observer en fonctionnement au moment d’une visite ou d’un salon. De plus, certaines pièces de la bobineuse comme le couvercle supérieur du mandrin seront transparentes afin de voir le fonctionnement interne de celui-ci du fait de sa complexité technique (pièces complexes).

Afin d’expliquer les différentes étapes du bobinage du fil (découpage du fil, positionnement du fil, enroulement du fil…), des fiches explicatives numérotées seront disposées sur la protection transparente. Celles-ci devront être claires afin de pouvoir expliquer à une personne ne connaissant pas la bobineuse de comprendre facilement son fonctionnement.

Vue de l’arrière de la bobineuse avec l’ouverture arrière
