RolandThsive/3D-printer-Plastic-Recycler/2020-05-30 Données annexes (André ERNESTO)/2019-12-06 Rapports de conception/Projet Bobineuse - Groupe A2.pdf

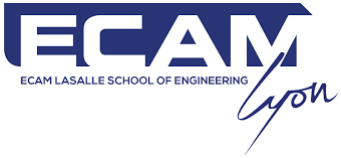
[picture p28: figure]

# Projet de conception : Bobineuse/Enrouleuse de fil

BUDE Matei

CATTAUD Noémie

FABRE Ian

GAUTHIER Loïc

LAMBERT Philéas

REZZOUKI Imad

VUILLERME Paul

ZHANG Bodian

ECAM 3 Arts & Métiers 2022

Groupe A-2

Année 2019-2020

# SOMMAIRE

I. Qu’est-ce que la bobineuse ? | 3
II. Définition du besoin | 3
1. QQOQC | 4
2. Bête à corne | 5
3. Cahier des charges fonctionnel | 6

III. Conception

1. Sous ensemble : transport du fil | 7
2. Sous ensemble : liaison entre le moteur et la bobine | 11
3. Sous ensemble : enroulement homogène du fil | 15
4. Sous-ensemble : détection lorsque la bobine est pleine | 22
IV. Conclusion | 22

## I. Qu’est-ce que la bobineuse ?

L’enrouleuse de bobine ou encore bobineuse est un terme désignant un appareil qui enroule un fil (cuivre, fer, plastique) autour d’une bobine vide.

On se rend compte assez vite que pour stocker le fil de façon ordonnée, le mouvement de rotation de la bobine autour de son propre axe ne suffit pas et qu’il faut ajouter une translation et plus (tronçonnage).

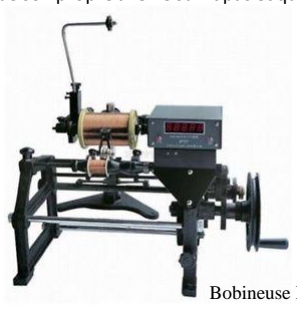
[picture p29: figure]

# II. Définition du besoin

Dans l’objectif de réduction de l’impact écologique des polymère non recyclés sur le campus, l’ECAM Lyon a imaginé un système de recirculation de ce type des matériaux grâce à un procédé autochtone permettant de transformer ces déchets en fil pour les imprimantes 3D.

L’appel d’offre du 01/09/2019 de la fondation ECAM de Lyon, au travers de son commanditaire M.ERNESTO consiste à réaliser une bobineuse qui enroule un fil polymère autour d’une bobine. Notre entreprise « A1 », composée d’élèves de la promotion ECAM3 Arts&Métiers (Noémie CATTAUD, Philéas LAMBERT, Ian FABRE, Imad REZZOUKI, Loïc GAUTHIER, Bodian ZHANG, Paul VUILLERME, Matei BUDE) a répondu à cet appel d’offre et a mené à bien ce projet. La bobineuse complète le système EXTRUDEUSE déjà existant qui en partant de granulés de polymère fabrique notre fil de la façon suivante :

-récupération des granulés dans la trémie d’alimentation
-chauffe du polymère
-extrusion et mise en forme

Étant donné qu’à la sortie de l’extrudeuse le fil n’est ni réceptionné ni stocké, la bobineuse rend service à l’ensemble de l’ECAM Lyon dans ses activités (pédagogiques, de promotion etc.) en enroulant de façon ordonnée le fil extrudé sur des bobines. Ce nouveau besoin est né suite au développement récent (2018/2019) de l’extrudeuse par des membres de la précédente promotion ECAM3 Arts&Métiers.

Notre objectif principal est de satisfaire le besoin de notre client, ainsi les solutions techniques apportées seront précises et détaillées.

Bobineuse Manuelle Avec Comptage Électronique

### 1. QQOQC : Pour exprimer clairement le besoin d‘un objet technique, il faut répondre aux

questions suivantes :

✓ | Quoi ?
| ❖ De quel besoin s'agit-il ?
| Stocker le fil de façon ordonné.
✓ | Qui ?
| ❖ Quelles sont les personnes concernées par ce besoin ?
| Ayant une extrudeuse et une imprimante 3D.
✓ | Où ?
| ❖ À quels endroits ?
| Fablab/ECAM
| ❖ Dans quelles conditions ce besoin est ressenti ?
| Le fil produit par l’extrudeuse n’est pas stocké.
✓ | Quand ?
| ❖ À quels moments ?
| Lors de la sortie du fil de l’extrudeuse. ❖ À quelle époque est exprimé ce besoin ?
| Pendant l’année scolaire 2019/2020.
✓ | Comment ?
| ❖ Sous quelles formes ?
| Sous forme de bobine.
| ❖ Dans quels cas est ressenti le besoin ?
| Quand le fil n’est pas rangé de manière ordonné.
✓ | Pourquoi ?
| ❖ Quelles sont les raisons qui ont fait apparaître ce besoin ?
| Le fil sortant n’est pas facilement stockable à la sortie de l’extrudeuse.
✓ | Combien ?
| ❖ Combien de personnes sont concernées par ce besoin ?
| L’ensemble de l’ECAM.

## 2. Bête à corne

A qui ça rend service ? | Sur quoi agit la bobineuse ?

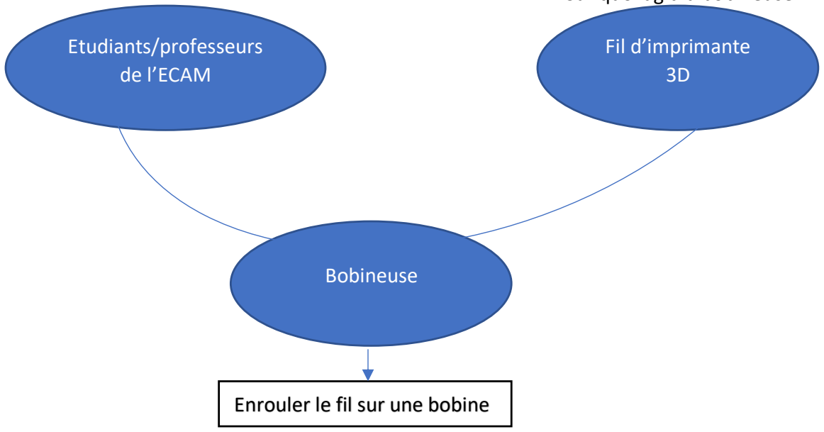
[picture p30: figure]
Etudiants/professeurs de l’ECAM; Fil d’imprimante 3D; Bobineuse; Enrouler le fil sur une bobine
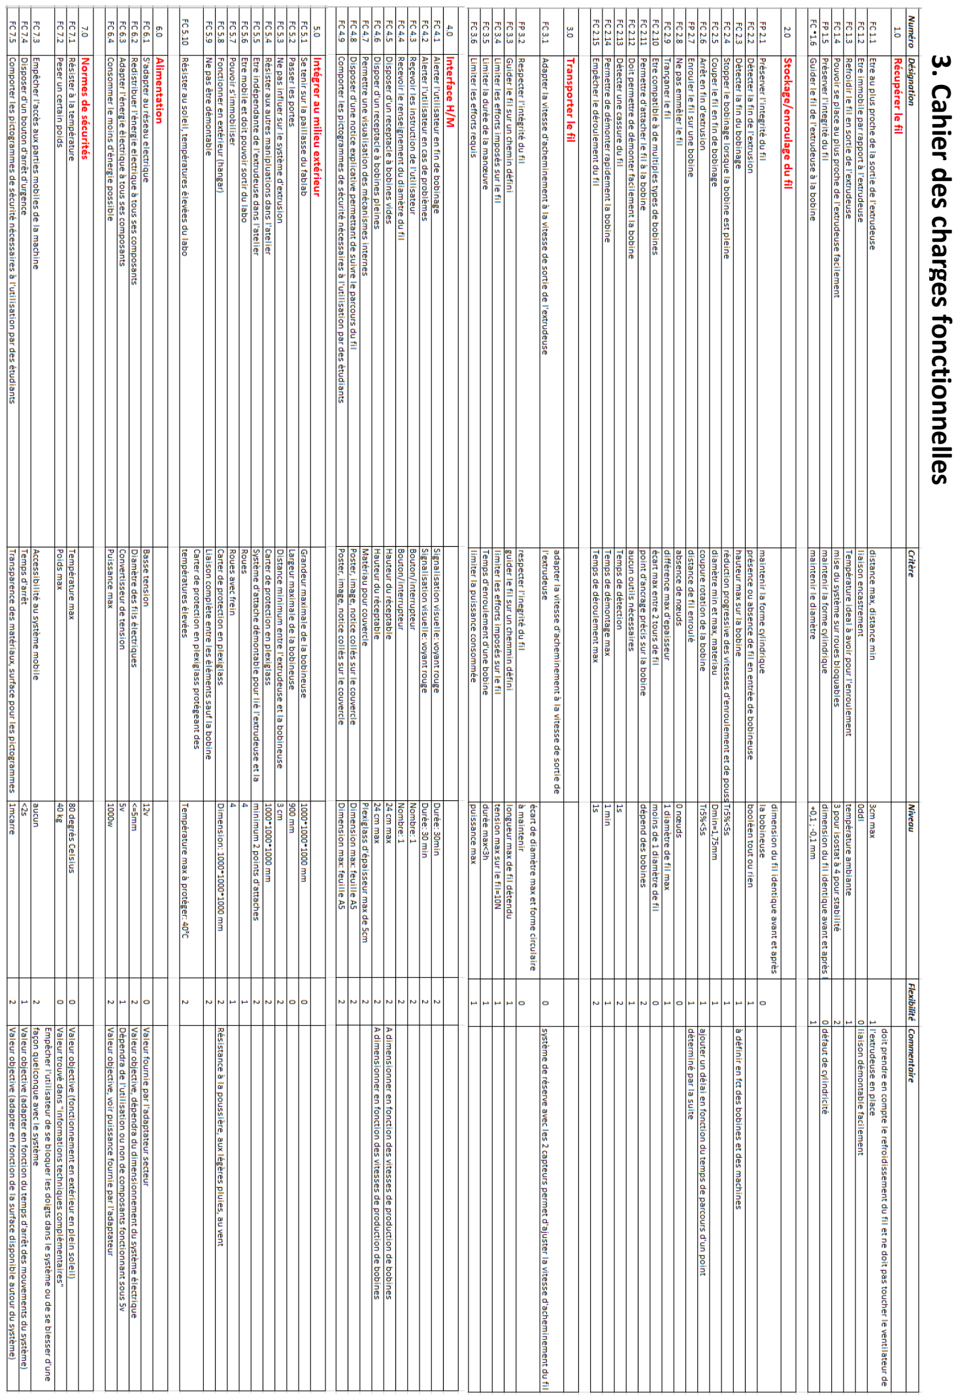
[picture p31: page 6]

## 3. Cahier des charges fonctionnelles

# III. Conception

## 1. Sous ensemble : transport du fil

a) Objectifs :

Intégré à la bobineuse le sous ensemble transport-fil doit permettre de transporter le fil chaud de la sortie de l’extrudeuse au système d’enroulement du fil sur la bobine. Ainsi il doit permettre un guidage précis du fil, sans déformation de celui-ci. Ce mécanisme doit pouvoir s’adapter à différents diamètres de fil et être facile d’utilisation. On pourra profiter du transport du fil pour finaliser son refroidissement.

En tenant compte de ces critères et en minimisant son encombrement on a cherché à développer des solutions possibles.

b) Solution, croquis :

Plusieurs études et croquis ont été fait afin de remplir les fonctions requises du sous-ensemble. Nous avons opté pour une transmission par poulie et ressort. Une poulie avec gorge pour permettre un bon guidage du fil sans trop l’endommager et les ressorts assurent à la fois le maintien du fil contre la 1ére poulie et l’adaptabilité du système à différents diamètre de fil.

Schéma cinématique 2D :

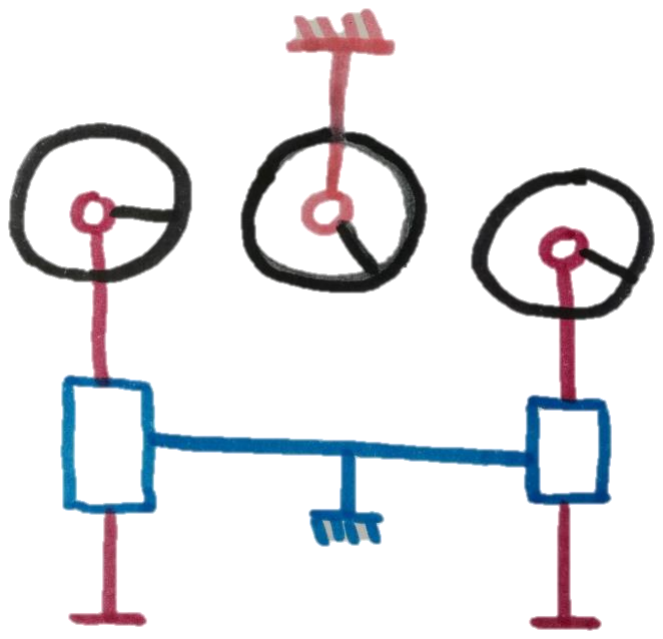
[picture p32: figure]
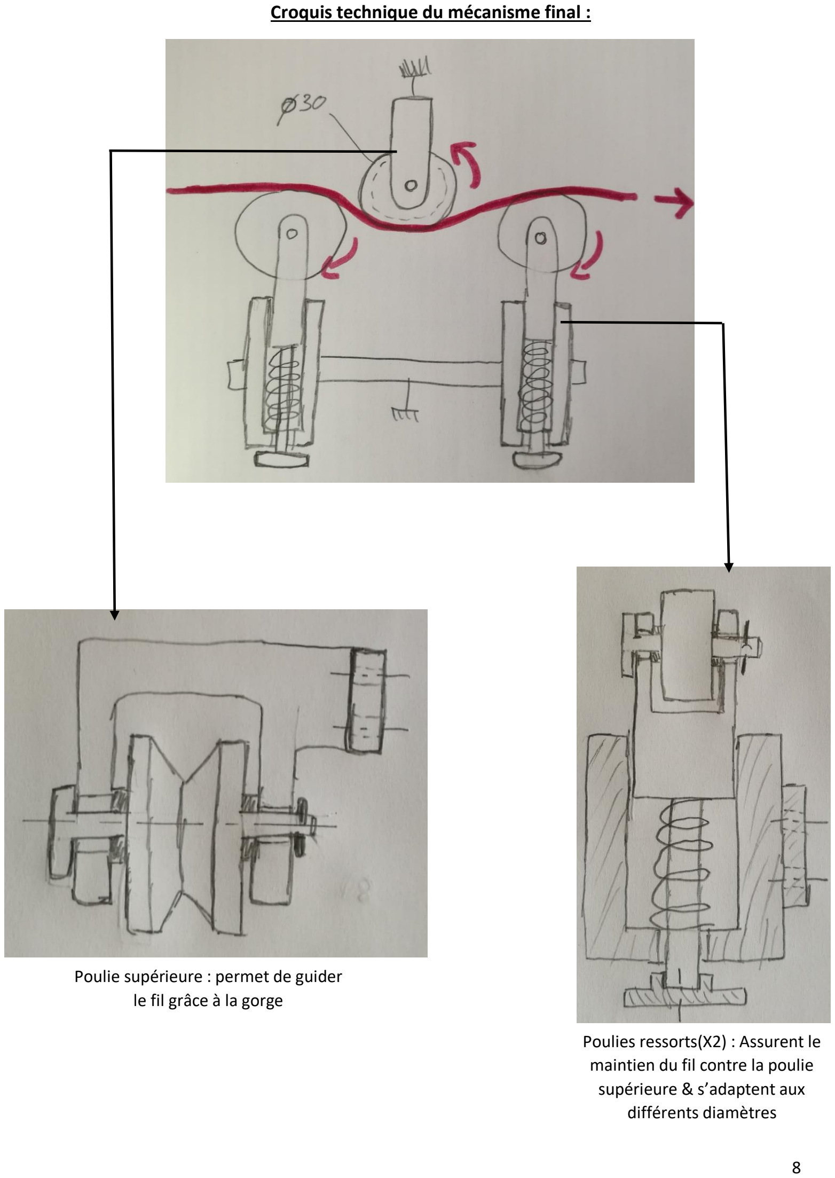
[picture p33: page 8]

Croquis technique du mécanisme final :

Poulie supérieure : permet de guider le fil grâce à la gorge

Poulies ressorts(X2) : Assurent le maintien du fil contre la poulie supérieure & s’adaptent aux différents diamètres

c) Dimensionnement :

Une fois la solution développée sous forme de croquis, il est nécessaire de réaliser une étude de dimensionnement sur les composants afin de donner les dimensions générales du sous-ensemble et de chaque pièce. Une majorité des cotes ont été fixées arbitrairement après avoir dimensionner les cotes les plus importantes.

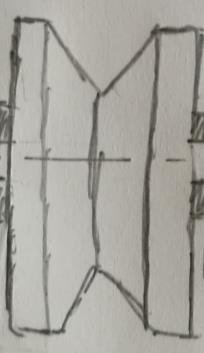
[picture p34: figure]

i. Gorge poulie supérieure :

Afin de pouvoir entrainer tous les fils sans que la gorge soit trop grand un dimensionnement de celle-ci a été fait en tenant compte du plus petit diamètre de fil utilisé (soit Ø1,75mm en rouge sur le schéma) :

D

′après le Theoreme de Thales:

0.875
x

=

5
4

⁄
5

⇔ 0.875 × 4 = x ⇔ x = 3.5mm

Donc α=35°

ii. Axes poulies :

Les axes des poulies sont les pièces les plus sollicitées, notamment en cisaillement : →calcul de la résistance d’une poutre en ABS au cisaillement :

τ =

T
S

< Rpg =

Reg
s

Avec T =

| F
| 2 , F force de renvoi du ressort ; S =

πD²
4

la section de
la poutre ; Reg=39Mpa pour l’ABS et s=5 le coefficient de sécurité.

τ < 7.8Mpa

| Si on prend D = 8mm ⇒ S = 25.13mm² ⇒ T < 196N

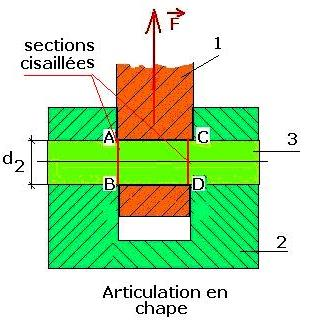
[picture p35: figure]

Donc si on cℎoisit D = 8mm alors F ≤ 392N

iii. | Ressorts :
| On sait que F ≤ 392N , de plus on fixe les deux position suivantes (ressort à vide et ressort comprimé) :

5/4mm

| 1,75/2
α | | 5mm

x

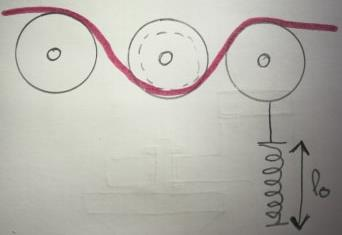
[picture p36: figure]
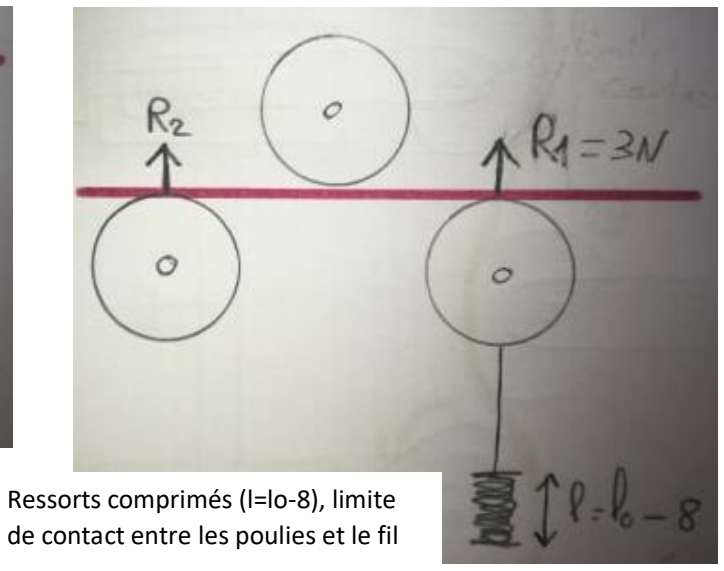
[picture p37: figure]
de contact entre les poulies et le fil

On fixe une force de rappel R1=R2=3N pour chaque ressort, ainsi on détermine la raideur nécessaire :

F = −k(l − lo) ⇔ k =

F
l − lo =

3
8

= 0.38 N/mm

Donc on choisit des ressorts de longueur L=20mm ; de Diamètre intérieur D=9mm et de raideur k=0,38 N/mm

d) Nomenclature :

Les dessins techniques ont été réalisés sur papier, on peut ainsi établir une nomenclature des pièces du sous-assemblage :

N° Pièce | Nom pièce | Mode d’obtention | Matériau | Quantité | Prix unitaire
1 | Poulie supérieure | Impression 3D | PLA | 1 | /
2 | Axe poulie | sous-traitant | inox | 3 | 2.04€
3 | Support poulie supérieure | Impression 3D | PLA | 1 | /
4 | Support poulie ressort | Impression 3D | PLA | 1 | /
5 | Axe ressort | Impression 3D | PLA | 2 | /
6 | Butée poulie ressort | Impression 3D | PLA | 2 | /
7 | Poulie ressort | Impression 3D | PLA | 2 | /
8 | Rondelle plate M3 | Sous-traitant | inox | 2 | 0.064€
9 | Rondelle Grower M3 | Sous-traitant | inox | 2 | 0.071€
10 | Vis CHC 3X8 | Sous-traitant | inox | 2 | 0.018€
11 | Ressort 20mm9mm0.38N/mm | Sous-traitant | inox | 2 | 4.69€
12 | Goupille fendue 1x20 | Sous-traitant | Acier galvanisé | 3 | 0.60€
Ressorts à vide (lo) | Ressorts comprimés (l=lo-8), limite

## 2. Sous-ensemble : liaison entre le moteur et la bobine

Dans cette partie, nous allons dimensionner le moteur que nous allons utiliser pour entraîner la bobine. Pour le dimensionner, il faut 3 données : son couple, sa vitesse de rotation et sa puissance. Il sera également nécessaire d’ajouter un réducteur entre le moteur et la bobine car la bobine tourne beaucoup plus lentement.

Nous souhaitons utiliser la bobineuse sous 2 modes différents :

- Fonctionnement en liaison avec l’extrudeuse : Vmax=15mm/s
- Pour l’enroulement des chutes de fil de plusieurs bobines : Vmax=50 cm/s

Pour satisfaire ses 2 modes de fonctionnement, on choisit un moteur à résistance variable. La vitesse critique nécessaire au dimensionnement du moteur est alors V=50 cm/s.

En ce qui concerne le couple à fournir, la situation critique correspond à lorsqu’on enroule les chutes de fils. En effet, l’utilisateur va devoir tenir la seconde bobine pendant que sera enroulé le fil sur la bobine entrainée par le moteur. Il va alors exercer une tension sur le fil. On peut fixer celle-ci à 1kg. Le rayon critique sera le rayon maximal de la bobine pleine.

Nous pouvons schématiser cette situation :

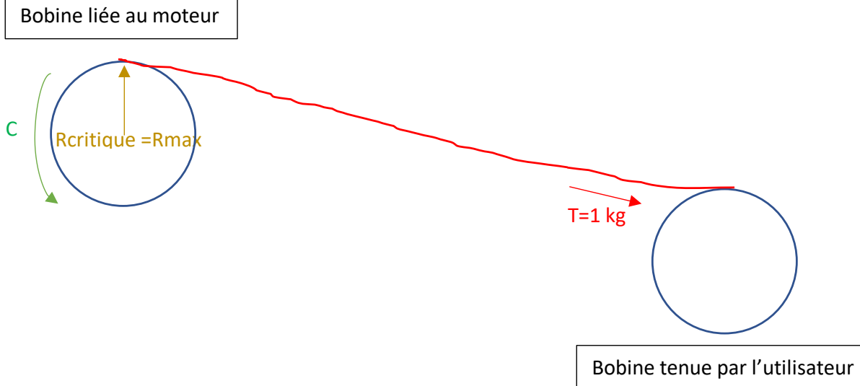
[picture p38: figure]
Rcritique =Rmax; Bobine liée au moteur; Bobine tenue par l’utilisateur

Alors Cmax = T ∗ g ∗ Rmax = 1 ∗ 9,81 ∗ 0,18 = 1,77 Nm

a) Réducteur : nous choisissons un réducteur double étage composé d’un train d’engrenage simple et un train épicycloïdal.

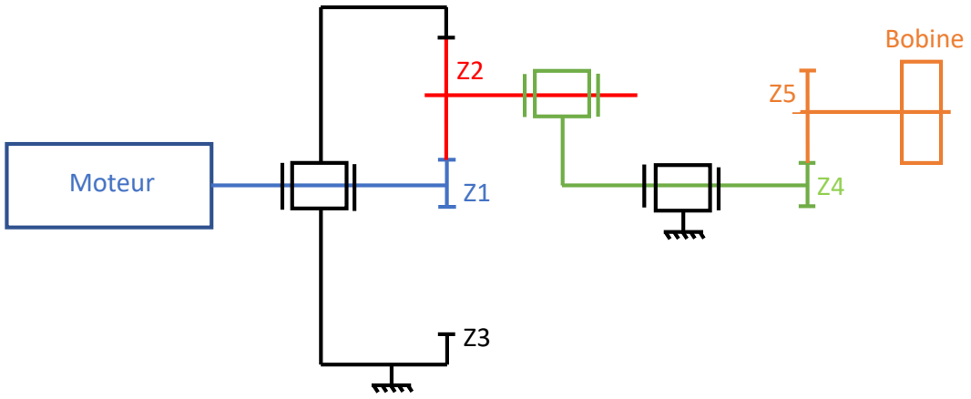
[picture p39: figure]
Moteur; Bobine

Sachant que r1 + d2 = r3 ⇔ Z1 + 2. Z2 = Z3

On a alors ktot = k1 ∗ k2 = 0, 022

- On peut alors savoir la vitesse à laquelle doit tourner notre moteur dans la position critique :

On a ωbob =

Vmax
Rmin =

0,5
0,035

= 14,29 rad/s

De plus: ktot =

ωbob
ωmot

⇔ ωmot =

ωbob
ktot

=

14,29
0,022

= 667 rad/s

Nmot = 6367 tour/min

- On peut déduire également le couple à fournir :

η =

Ps
Pe =

Cbob. ωbob
Cmot. ωmot

=

Cbob
Cmot ∗ k

⇔ Cmot =

Cbob ∗ k
η

On fixe arbitrairement le rendement du réducteur à η = 60% du fait de toutes les pertes du système (entre chaque liaison, entre chaque engrènement). Alors :

Cmot = 0, 064 Nm

Il nous faut donc un moteur à résistance variable ayant un couple au minimum de 0,065 Nm et une vitesse de rotation maximale d’au moins 6400 tour/min.

Une dernière valeur doit être vérifiée pour notre moteur, c’est la puissance. On doit avoir une puissance de Pmeca = Cmot ∗ ωmot = 42,2 W

Nous proposons alors l’utilisation de ce moteur, avec ci-dessous une image présentant son aspect ainsi que son prix et sur la seconde, ses caractéristiques techniques.

Train d'engrenage simple
m (mm) = | 3
Z4= | 12
Z5= | 70
D4 (mm) = | 36
D2 (mm) = | 210
K2= | 0,17142857

Train épicycloïdal
m (mm)= | 3
Z1 (planétaire 1)= | 10
Z2 (satellite)= | 30
Z3 (couronne)= | 70
Encombrement (d3) (mm)= | 210
K1= | 0,125

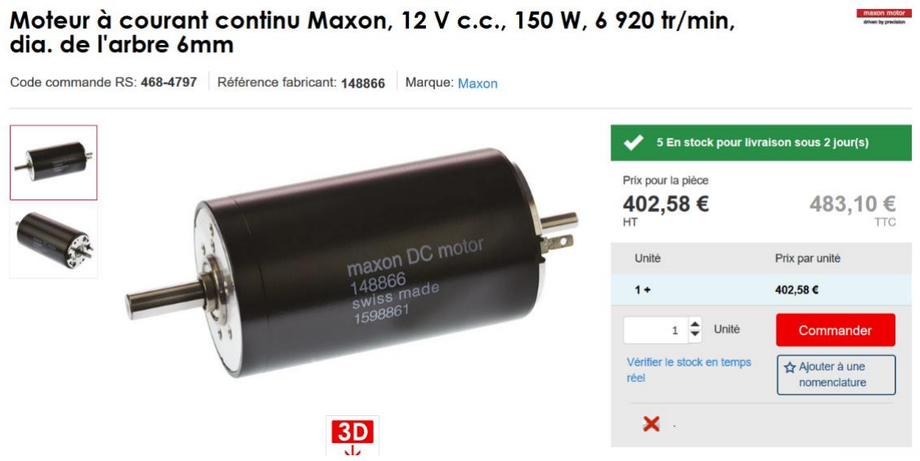
[picture p40: figure]

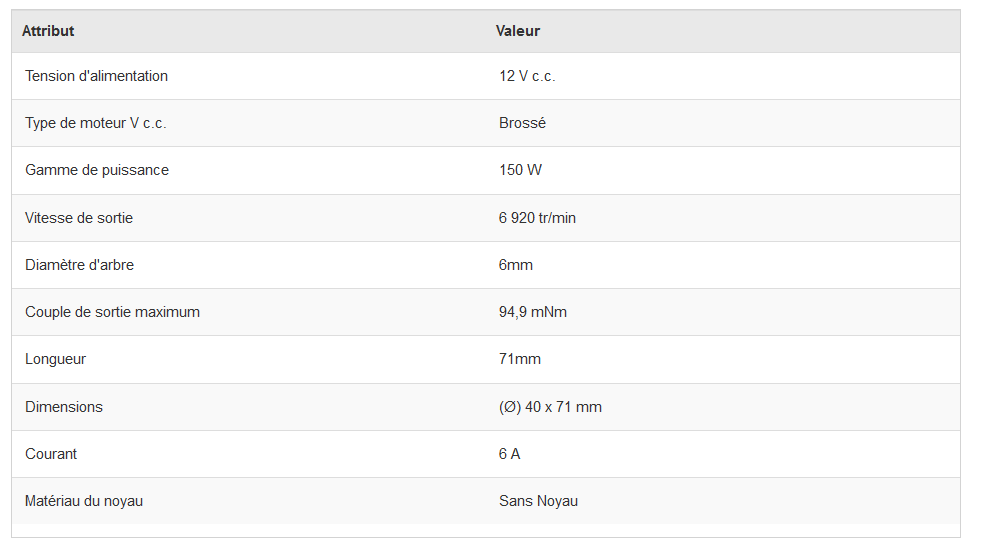
[picture p41: figure]

b) Dimensionnement des clavettes dans le réducteur :

Nous choisissons des clavettes parallèles de forme B.

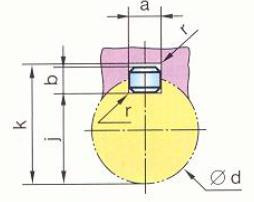
[picture p42: figure]

On prend Padm=60 Mpa, car les conditions d’utilisation sont des conditions moyennes.

Alors Lu =

2∗Ct
Padm∗d∗(j+b−d)

Dans notre montage, le couple maximal correspond au couple exercé sur l’arbre de la bobine.

Cmax = 1,77 Nm

Les arbres présents dans le système ont un diamètre entre 14 et 20mm.

Ainsi, nous pouvons déterminer la longueur minimale des clavettes nécessaire pour notre système dans le pire cas, c’est-à-dire lorsque le couple est maximal et le diamètre est le plus petit :

Lumin = 2,2 mm

Toutes les clavettes devront alors faire au minimum 2,2 mm.

c) Dimensionnement roulement :

Nous voulons utiliser la bobineuse environ 8h par jour, 5 jours par semaine, pendant les semaines de cours uniquement, pendant au moins 10 ans.

Duree de vie souℎaitée = 8 ∗ 5 ∗ 35 ∗ 10 = 14000h

Nous choisissons des roulements résistants à des efforts radiaux, de type roulements à 1 rangée de billes à contact radial. On suppose que les charges axiales sont négligeables et que les charges radiales ne dépassent pas 500N, en prenant un coefficient de sécurité (on compte le poids ainsi que les efforts d’engrènements). Le diamètre étant de 16mm au niveau des roulements, on choisit un roulement de type 16BC02 donc C=960 daN. On peut alors vérifier si notre roulement convient en termes de durée de vie : duree de vie = (

C
Fr

)

3
∗

10⁶
60 N

= 15000h donc le roulement convient bien.

d) Dimensionnement de la résistance variable :

On veut que Vmot = 12V donc Ur = 0Vsoit :

Rmin = 0Ω

Ou Vmot = 0V donc Ur = 12V soit :

Rmax =

Ur
I

=

12
6

= 2Ω

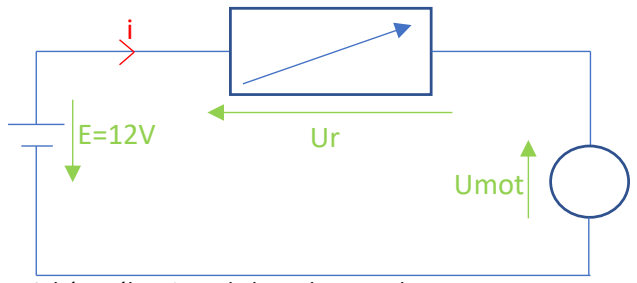
[picture p43: figure]
Umot

Schéma électrique du branchement du moteur au secteur

Il nous faut un potententiomètre avec un résistance variant de 0 à 2Ω, nous pouvons alors utiliser ce type de potentiomètre :

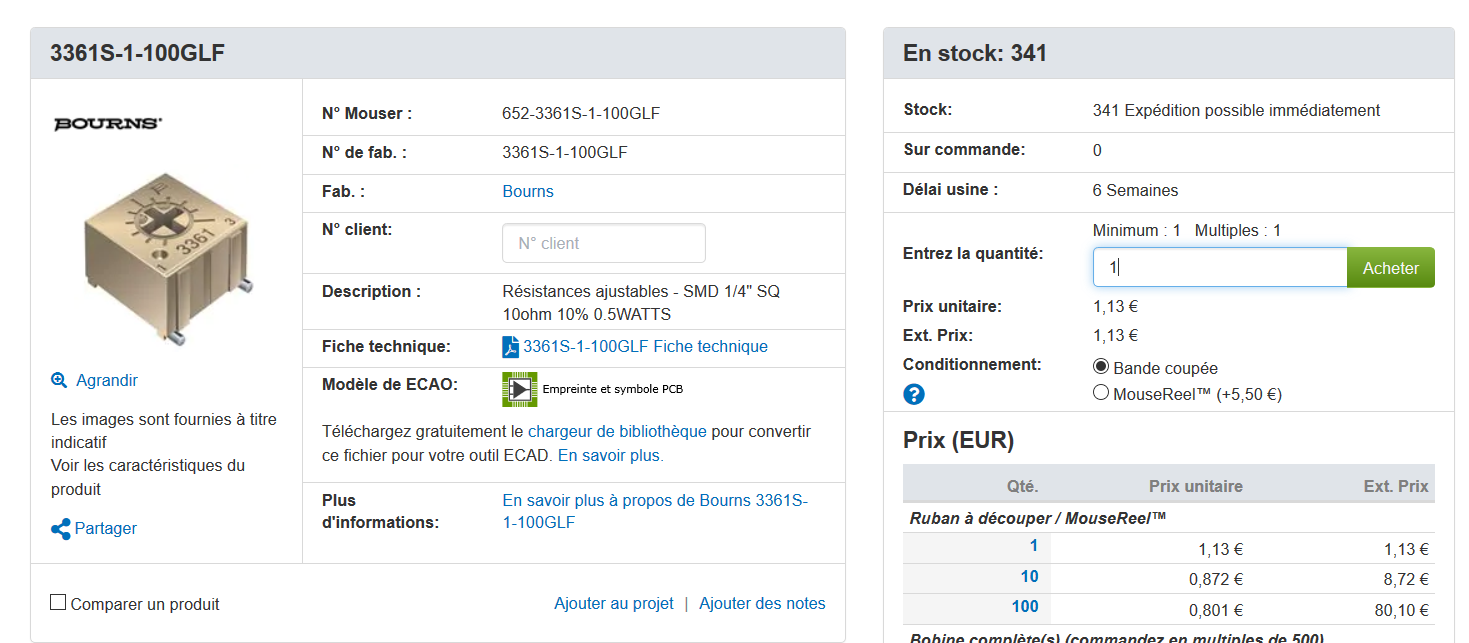
[picture p44: figure]

e) Nomenclature

Pour construire la liaison entre l’axe moteur et l’axe bobine, on choisit d’utiliser des coussinets autolubrifiants (absence des efforts radiaux importants), dont la nomenclature est la suivante :

Désignation | Nombre | Nom | Matériau | Prix unitaire

Dimensions (d – D1 -Dc1 –
e1 – L1) (mm)

Masse(g)

C2-251-60-70 | 2 | Coussinet
fritté
autolubrifiant
à collerette
Bronze | 20-40€ | Ø60 - Ø72 - Ø84 - 6 - 50 | 390
C2-251-30-38 | 2 | Coussinet
fritté
autolubrifiant
à collerette
Bronze | 5-30€ | Ø30 - Ø38 - Ø46 - 4 - 25 | 86

Ensuite on a la nomenclature de la chaîne moteur :

Désignation | Nom | Mode d’obtention | Nombre | Matériau | Prix (€)
Moteur | Moteur | Sous-traitant | 1 | | 402,52
| Potentiomètre | Sous-traitant | 1 | | 1,13
A-1 | Arbre 1 | Impression 3D | 1 | PLA | 0
A-2 | Arbre 2 | Impression 3D | 1 | PLA | 0
A-3 | Arbre 3 | Impression 3D | 1 | PLA | 0
E-1 | Engrenage 1 | Découpe laser | 1 | Bois | 0
E-2 | Engrenage 2 | Découpe laser | 1 | Bois | 0
0 | Engrenage 3 | Découpe laser | 1 | Bois | 0
E-3 | Engrenage 4 | Découpe laser | 1 | Bois | 0
E-4 | Engrenage 5 | Découpe laser | 1 | Bois | 0
8 | Ecrou | Sous-traitant | 4 | Inox | 0-10
9 | Coussinet 2 | Sous-traitant | 1 | Bronze fritté | 4,13
10 | Coussinet 1 | Sous-traitant | 2 | Bronze fritté | 5,47*2
11 | Roulement 16BC02 | Sous-traitant | 2 | | 9,90*2
12 | Clavette | Sous-traitant | 3 | Acier | 0,25*3
13 | Entretoise | Sous-traitant | 1 | Acier | 0-10
14 | Entretoise | Sous-traitant | 1 | Acier | 0-10
15 | Entretoise | Sous-traitant | 1 | Acier | 0-10
16 | Ecrou | Sous-traitant | 4 | Inox | 0-10
17 | Vis CHC M4 | Sous-traitant | 9 | Acier | 0-10
18 | Vis CHC M3 | Sous-traitant | 6 | Acier | 0,05*6

## 3.Sous-assemblage : enroulement homogène du fil

Pour la fonction de l’enroulement de manière homogène, nous choisissons le système de bielle/manivelle dont le dimensionnement est expliqué ci-dessous :

Ce système permet d’assurer une translation de la tête qui apporte le fil à enrouler sur la bobine afin d’assurer un enroulement homogène sur toute la largeur de la bobine

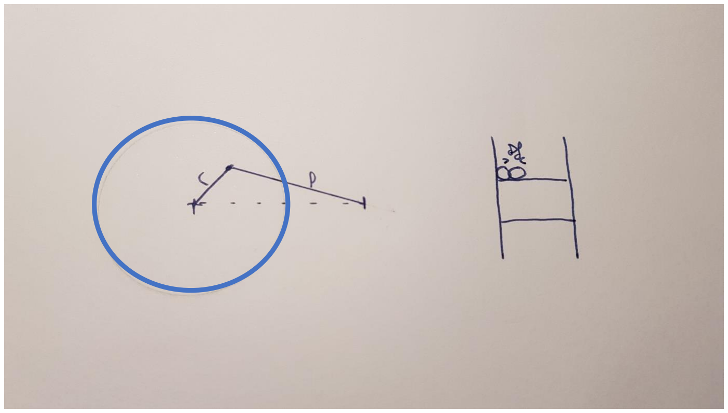
[picture p45: figure]

En considérant le schéma suivant on a donc :

- r : défini par la course du système soit la largeur de la bobine
- l la longueur du bras à régler à l’aide de la vis en fonction de r, du diamètre du fil (Df) et du rapport de réduction (R)via la loi suivante : l² = [Df² - r*cos(2 π*R)]²+ r²*sin²(2 π*R) obtenue à l’aide de la loi entrée-sortie du système poulie-courroie

Pour chaque réglage du réducteur précédent on a donc un l correspondant :

Df | Largeur bobine | Rapport de réduction | l
1,75mm | 59mm | 0,0148 | 0,277mm
1,75mm | 54mm | 0,0162 | 0,252mm
1,75mm | 41mm | 0,0214 | 0,187mm
2,85mm | 59mm | 0,0242 | 0,266mm
2,85mm | 54mm | 0,0264 | 0,241mm
2,85mm | 41mm | 0,0238 | 0,177mm

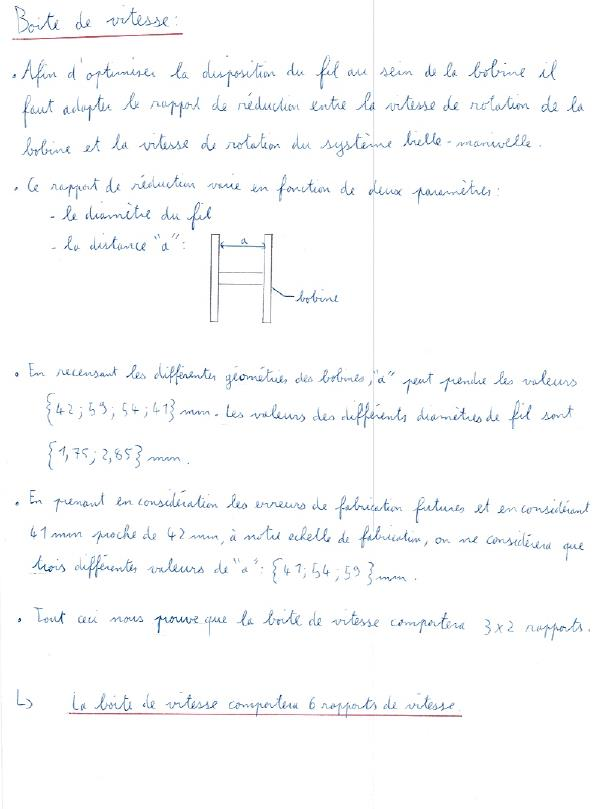
[picture p46: page 17]
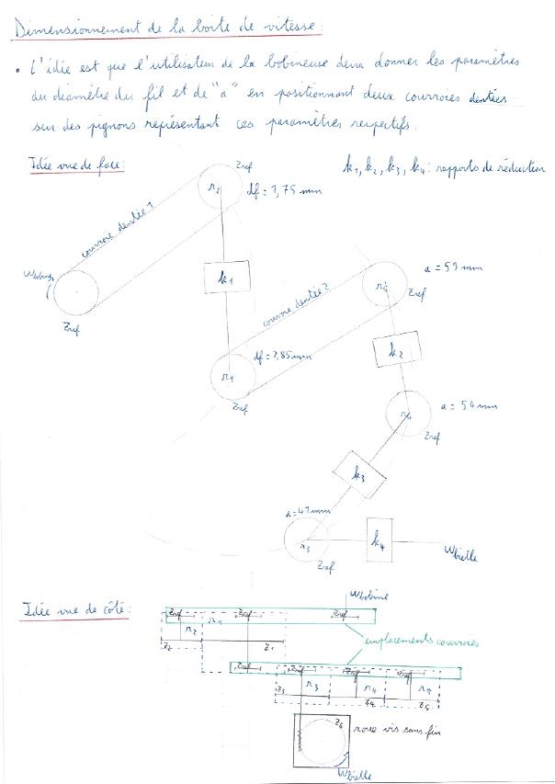
[picture p47: page 18]
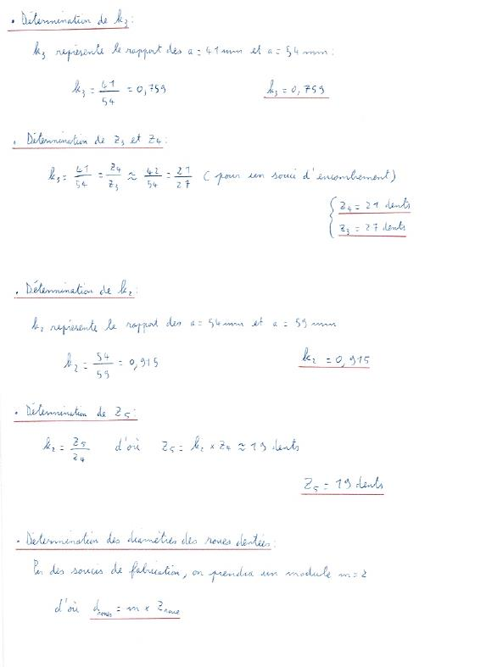
[picture p48: page 19]
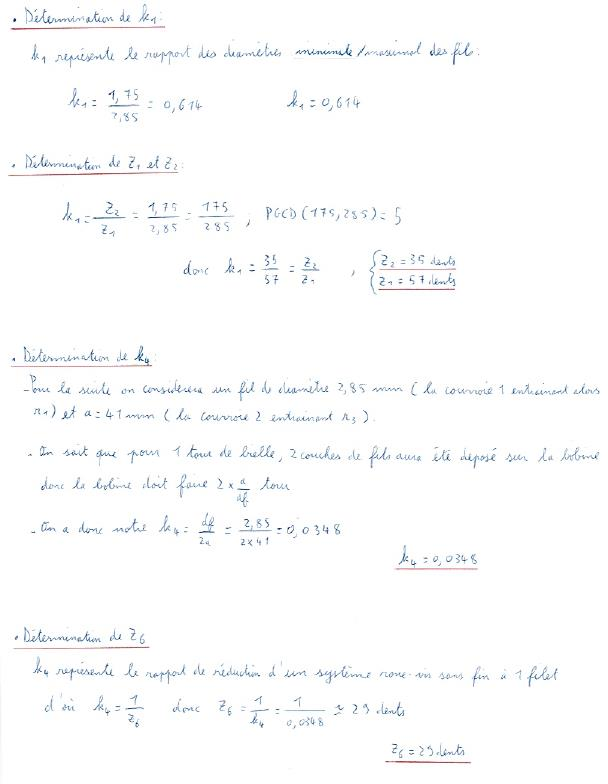
[picture p49: page 20]
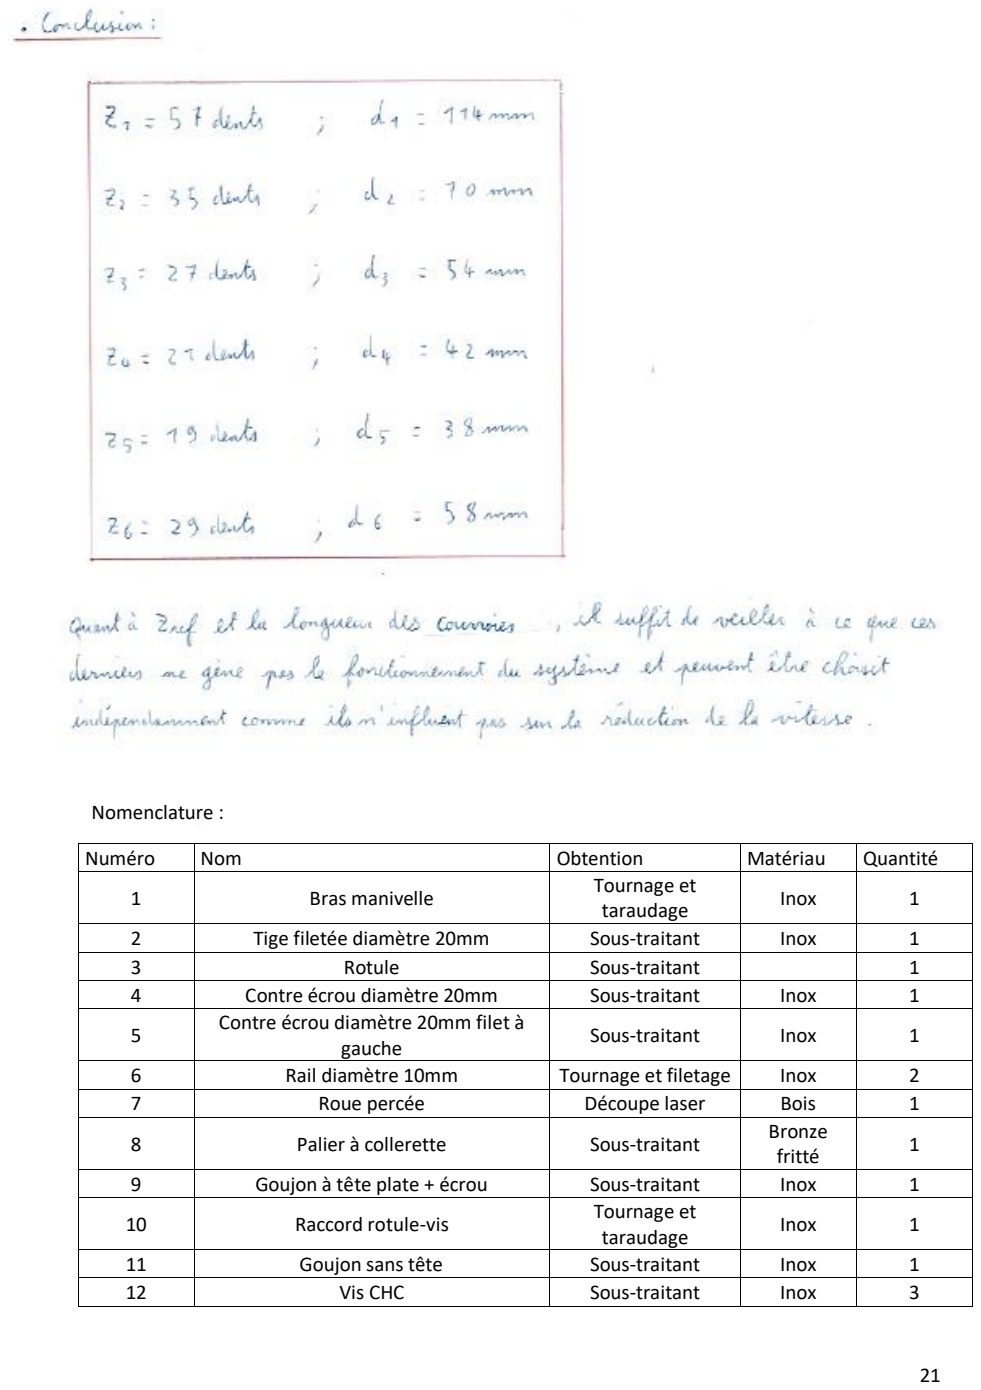
[picture p50: page 21]

Numéro | Nom | Obtention | Matériau | Quantité
1 | Bras manivelle | Tournage et taraudage | Inox | 1
2 | Tige filetée diamètre 20mm | Sous-traitant | Inox | 1
3 | Rotule | Sous-traitant | | 1
4 | Contre écrou diamètre 20mm | Sous-traitant | Inox | 1
5 | Contre écrou diamètre 20mm filet à gauche | Sous-traitant | Inox | 1
6 | Rail diamètre 10mm | Tournage et filetage | Inox | 2
7 | Roue percée | Découpe laser | Bois | 1
8 | Palier à collerette | Sous-traitant | Bronze fritté | 1
9 | Goujon à tête plate + écrou | Sous-traitant | Inox | 1
10 | Raccord rotule-vis | Tournage et taraudage | Inox | 1
11 | Goujon sans tête | Sous-traitant | Inox | 1
12 | Vis CHC | Sous-traitant | Inox | 3

Nomenclature :

## 4. Sous-ensemble : détection lorsque la bobine est pleine

Lorsque la bobine est pleine, il faut que l’enroulement cesse. Il faut savoir à quel moment la bobine est pleine. Pour cela, nous utilisons un capteur tout ou rien placé à l’extrémité de la bobine qui va détecter si oui ou non la bobine est pleine. En effet, lorsque la bobine est pleine (les dernières lignes de fil ont été enroulées), le capteur va alors changer de mode et ceci va provoquer l’arrêt de l’enroulement.

Ce même fonctionnement est envisagé pour détecter la fin de fil qui sort de l’extrudeuse. En effet, nous pouvons mettre un capteur à la sortie de l’extrudeuse qui détecte la présence du fil et dès qu’il n’y a plus de fil produit, le capteur change de mode et la bobineuse se stoppe. Nous n’avons pas ajouté cette fonctionnalité dans le système car avec peu de grain, l’extrudeuse fonctionne pendant un temps très important ainsi, le système devra s’arrêter soit car l’utilisateur le stoppe (arrête le moteur), soit car la bobine est pleine et donc le système se stoppe grâce au capteur cité juste avant.

## IV. Conclusions

Pour conclure, notre entreprise propose une solution pour enrouler le fil qui sort de l’extrudeuse. Le système se divise en différents sous-ensemble répondant à des fonctions et des exigences différentes. Nous répondons aux principales exigences. En effet, si on rassemble toutes les dépenses, celles-ci sont inférieures à 750€, correspondant au prix maximal. De plus, le volume maximal est respecté. Nous répondons à l’exigence d’enroulement du fil, de manière homogène le long de la bobine, quel que soit le type de bobine, quelle que soit la vitesse voulue (soit le fil sort de l’extrudeuse, soit nous voulons enrouler des morceaux de fil) et quel que soit le diamètre de fil.

La fondation ECAM peut faire appel à notre entreprise qui saura répondre à sa demande.

Diamètre
d’enroulement max

On peut illustrer ce fonctionnement avec le schéma ci-contre. Dès que la bille rouge va venir en contact avec le
fil | lorsque | le | diamètre
d’enroulement est maximal, la bobineuse va se stopper.
