RolandThsive/3D-printer-Plastic-Recycler/2020-05-30 Données annexes (André ERNESTO)/2019-12-06 Rapports de conception/Projet Bobineuse - Groupe B2.pdf

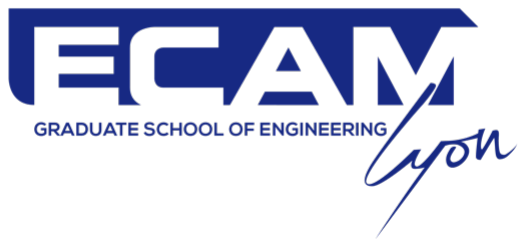
[picture p51: figure]

# Projet de conception d’une bobineuse

## Travaux dirigés par Mr André Ernesto ECAM 3 – Groupe B2

Auteurs : Louise Vigouroux Tom Gavage Raphaël Pelloux Antoine Duclos Antoine Loock Clément Deshormière Théo Pasquet Jihao Zhang

Remerciements

En premier lieu, nous tenions à remercier Monsieur André ERNESTO qui a initié ce projet et qui nous a accompagné depuis le début. Il a su nous orienter au fil des séances afin de nous placer dans le rôle de réels ingénieurs en nous exposant toutes les problématiques auxquelles nous devions répondre.
Nous voulions également remercier l’ECAM de mettre à disposition plusieurs machines industrielles qui nous permettent de concevoir des outils réalisables gratuitement au sein de notre école. De plus l’école nous permet de travailler sur des projets d’avenir et d’utilité générale car de tels projets seront utiles aux personnes interagissant sur notre campus.

Table des matières

## I) Définition du besoin

## 1) Introduction

I. Contexte du projet et visée pédagogique

Ce projet a été proposé par Monsieur André Ernesto, professeur de Mécanique travaillant à l’ECAM Lyon. La mise en place de ce travail a permis une immersion fictive dans le monde de l’entreprise car l’appel d’offre émis par le client (Mr Ernesto, le professeur) aux entreprises concurrentes (différents groupes d’élèves) a favorisé l’importance d’innover et de personnaliser son projet.

Il a été mené par un groupe de 8 étudiants en troisième année à l’ECAM Lyon (section Arts et Métiers). Le groupe est composé de Louise Vigouroux, Tom Gavage, Raphaël Pelloux, Antoine Duclos, Jihao Zhang, Antoine Loock, Théo Pasquet et Clément Deshormières. Ensemble, la finalité du projet était de définir le besoin avant de répondre aux problématiques soulevées et de concevoir et réaliser la machine virtuellement dans un premier temps. Un budget a été alloué à ce projet afin de rendre sa conception possible.

Le projet de conception se déroule sur l’année scolaire 2019-2020 et a pour objectif de permettre aux étudiants de concevoir et de modéliser un outil industriel. La création de cet outil a pour intérêt de développer les connaissances techniques des étudiants dans les domaines de CAO et de Mécanique. De plus les différents groupes d’élèves travaillent en autonomie et doivent considérer ensemble les éventuels problèmes environnementaux, énergétiques ou économiques liés aux choix du groupe.

II. La bobineuse
a. La machine

L’outil qui a été pensé et modélisé est une bobineuse qui récupère un fil de diamètre variable et l’enroule sur différentes sortes de bobines. Ce projet fait suite à la création d’une extrudeuse l’année précédente qui produit du fil en valorisant du plastique usagé récolté sur le campus de l’école. Cet outil devait pouvoir s’insérer à
la suite de l’extrudeuse et leurs utilisations devaient être accordées.

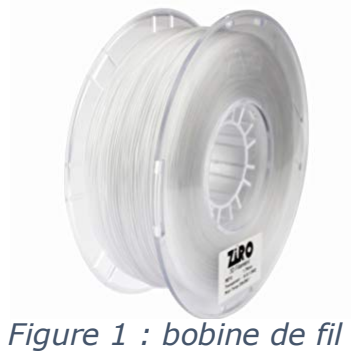
[picture p52: figure]
Figure 1 : bobine de fil

| La bobineuse doit être mobile et en mesure d’être déplacée car son utilisation n’est pas
exclusivement réservée au FabLab. En effet, la bobineuse pourrait être installée à la suite de l’extrudeuse de manière ponctuelle afin de répondre à des besoins particuliers. Également cet outil pourrait être installé dans un atelier afin de rendre sa production continue et pourrait être sujet à des visites pour des intervenants extérieurs à l’ECAM.

b. Les visées de ce projet

Un but écologique : Le contexte actuel du recyclage conduit tous les jours à innover et valoriser nos ressources. Il apparaît que sur le campus, une grande quantité de plastique usagé est disponible. Les professeurs de l’ECAM ont ainsi songé à valoriser ces déchets polluants afin d’allier l’écologie avec la recherche.

Un but économique : Ce travail écologique et éducatif permet ainsi à l’ECAM, d’être auto-suffisant quant à la production de bobine de fil (matière première) destinée à l’utilisation régulière des imprimantes tridimensionnelles. Cette production peut conduire ainsi à de grandes économies si le système de production est à haut rendement.

Un but pédagogique : Les personnes concernées par ce besoin sont principalement les étudiants de l’ECAM, filière Arts et Métiers et Engineering. Néanmoins, les professeurs pourraient également s’appuyer sur la bobineuse lors de leurs cours et travaux pratiques pour en étudier le mécanisme. Un ensemble de 1500 personnes pourrait être ainsi concerné par ce projet (étudiants, professeurs, intervenants extérieurs et industriels)

Un but promotionnel : Cette production Ecamienne peut de
plus avoir une visée communicative pour mettre en avant
les activités diverses réalisées au sein de notre école ainsi
que valoriser l’utilité d’un FabLab.

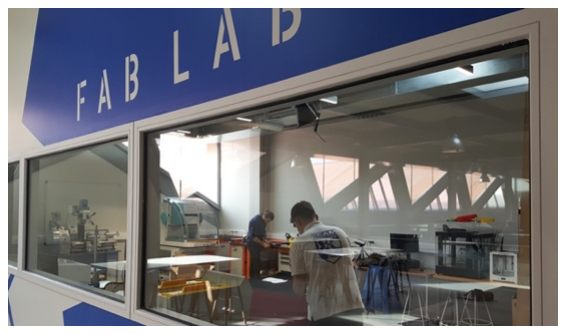
[picture p53: figure]

Figure 2 : FabLab de l'Ecam Lyon

## 2) La demande

ü Quoi ?

v De quel besoin s'agit-il ?

Une machine qui enroule du fil et produit des bobines de fil utilisables directement par l’imprimante 3D

ü Qui ?

v Quelles sont les personnes concernées par ce besoin ?

Les étudiants et professeurs de l’ECAM ainsi que l’ensemble des intervenants extérieurs

ü Où ?

v À quels endroits ?

La machine se trouvera proche d’une extrudeuse, dans un atelier ou le FabLab de l’ECAM

v Dans quelles conditions ce besoin est ressenti ?

Optimisation des ressources, considérations écologiques et économiques, besoin pédagogique innovant

ü Quand ?

v À quels moments ?

Au cours de l’année d’ECAM 3 : La machine devra être opérationnelle en Juin (10 mois de projet)

v À quelle époque est exprimé ce besoin ?

En Septembre 2019 durant l’année scolaire d’ECAM 3 depuis la création de l’extrudeuse

ü Comment ?

v Sous quelles formes ?

Une machine industrielle capable de fonctionner en continu

v Dans quels cas est ressenti le besoin ?

Grand besoin de fil et volonté de réaliser un projet éducatif intéressant

ü Pourquoi ?

v Quelles sont les raisons qui ont fait apparaître ce besoin ?

Pour des raisons économiques, écologiques et pédagogiques ü Combien ?

v Combien de personnes sont concernées par ce besoin ?

A peu près 1500 personnes sur le campus de l’ECAM.

## 3) Diagramme bête à cornes

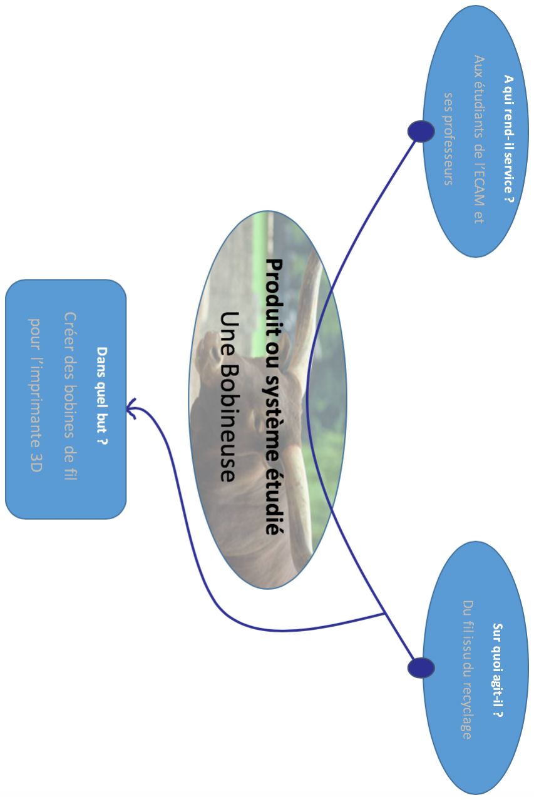
[picture p54: figure]

## 4) Diagramme pieuvre

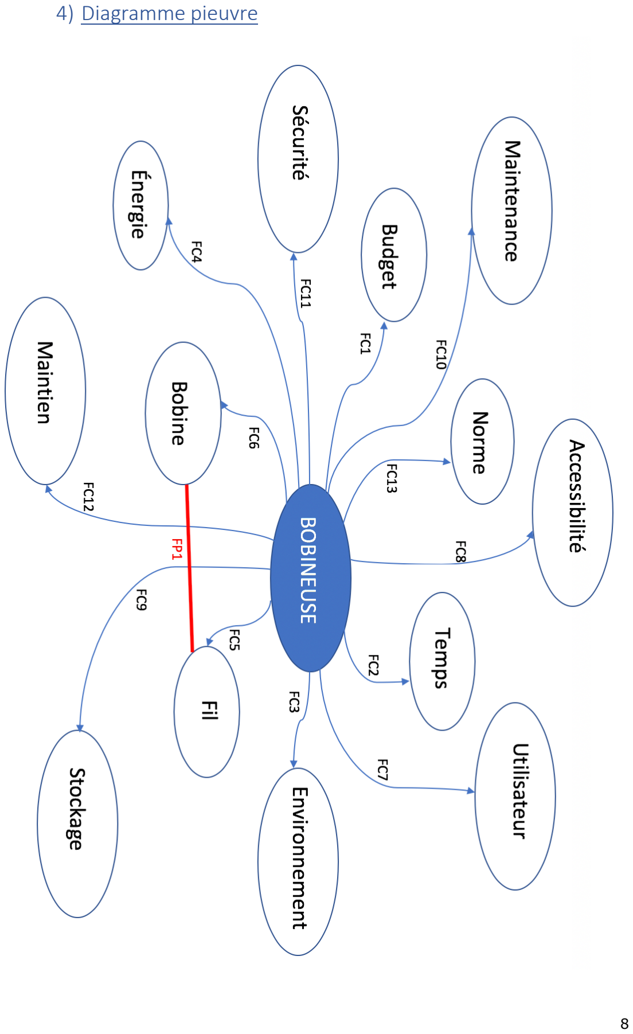
[picture p55: page 8]

## 5) Cahier des charges fonctionnel

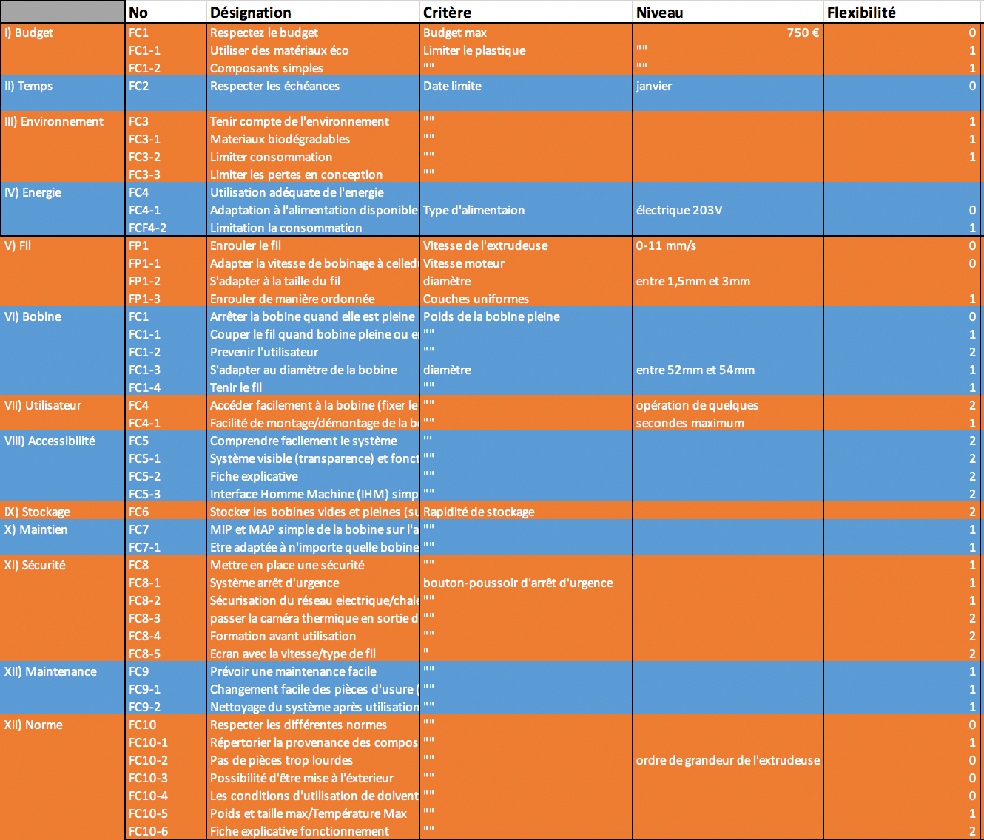
[picture p56: figure]

## II) Conception

## 1) Introduction

Pour la conception de la bobineuse, plusieurs bobines nous ont été mises à disposition. En effet l’outil à concevoir devait enrouler le fil de l’extrudeuse sur différentes sortes de bobines de dimensions variables.
Les dimensions variant le plus suivant les bobines sont répertoriées dans ce tableau :

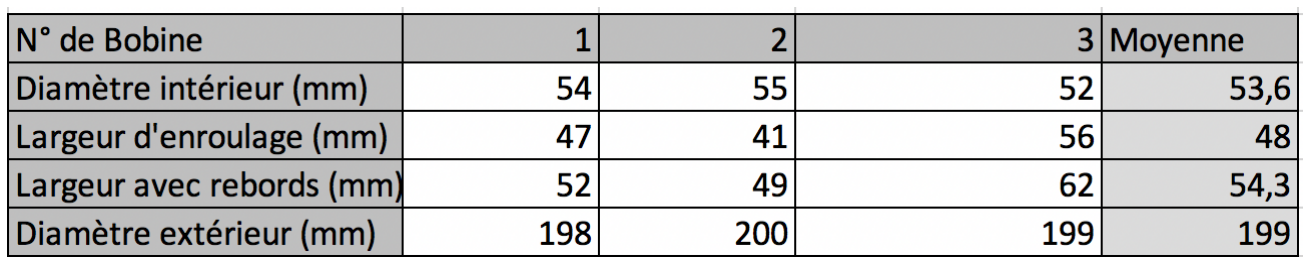
[picture p57: figure]

Pour la conception de la bobineuse, nous avons ainsi divisé la machine en quatre sous-ensembles :
- Acheminement du fil : Théo Pasquet et Antoine Duclos
- Maintien de la bobine et enroulage : Louise Vigouroux, Raphaël Pelloux, Tom Gavage
- Guidage du fil : Clément Deshormières
- Coupage du fil et système d’arrêt : Antoine Loock et Jihao Zhang (système d’arrêt) Ces trois sous-ensembles sont détaillés dans les paragraphes suivants et un dessin d’ensemble a été réalisé pour chacun d’eux.

## 2) Acheminement du fil

Pour amener le fil de la sortie de l’extrudeuse jusqu’à la bobine, il fallait créer un système d’acheminement qui disciplinerait le fil avant son enroulage sur la bobine. Pour ce faire nous avons mis en place une succession de trois poulies à gorge fixées sur un support qui permettront de créer la ligne de guidage que doit suivre le fil. En effet, la gorge permet d’éviter que le fil ne sorte de cette ligne et donc d’être acheminé correctement.
Ce sous ensemble est représenté dans le dessin Sous Ensemble 1.
En faisant varier la hauteur des supports et donc des poulies puis en

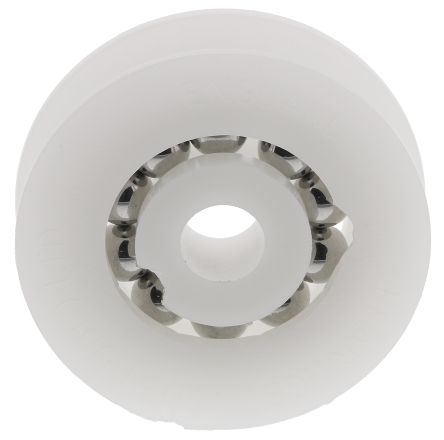
[picture p58: figure]

faisant passer le fil successivement en haut et en bas de celles-ci, le fil est pincé entre les poulies et sa ligne de guidage est assurée.
Ainsi, nous avons imaginé deux supports de taille identique et un légèrement plus grand. Ces supports sont constitués d’un socle et d’une tige au sommet duquel sera placé l’arbre de notre poulie.

Figure 3 : Poulie à gorge

Ces deux constituants sont fixés à l’aide d’une vis et d’une équerre permettant d’assurer la perpendicularité entre les deux. Les deux pièces seront en bois puis fabriquées à l’aide de la machine à découpe laser du FabLab et ensuite usinées à l’aide d’un CUCN.
Quant à l’arbre autour duquel va tourner la poulie, celui-ci est en fait une vis située au sommet de la tige. Cela permet de fixer l’arbre sur le support à l’aide d’un écrou à collerette. Ainsi la poulie sera placée sur la partie non filetée de la vis et l’on réalisera ses arrêts axiaux à l’aide de deux entretoises situées de part et d’autre de la poulie.
L’avantage principal de cette solution est qu’elle permet à l’opérateur de faire passer le fil beaucoup plus facilement dans les poulies au début du cycle d’enroulage d’une bobine sans être gêné par le support. En outre, cette solution présente aussi un avantage économique du fait de la simplicité des composants utilisés.

Estimation du coût :

- Bois : 25€
- 12 vis M6 de longueur l = 30mm : 20€
- 3 vis M6 de longueur l = 60mm et l = 40mm non taraudé : 5€
- 3 poulies à gorge : 10€
- 6 entretoises de diamètre intérieur d = 6mm : 6€
- 3 écrous à collerette M6 : 6€
- 3 équerres de largeur l = 20 mm : 3€
- Usinage CUCN : ECAM
- Découpe laser : ECAM

Le coût de ce sous-ensemble est estimé à 75€.

## 3) Maintien de la bobine

a. Bâti et pièce intérieure 1
Pour la solution technique du maintien de la bobine, nous avons dessiné trois pièces pour répondre aux besoins de notre cahier des charges. Les dessins de ces trois pièces sont joints à ce dossier et dénommés :
- Pièce intérieure 1
- Arbre 1
- Bâti
De plus le montage de la solution technique est détaillé dans le dessin du Sous Ensemble 2. La pièce intérieure viendra se fixer à l’intérieur du bâti car sa réalisation nécessite un usinage précis que l’on obtiendra grâce à l’impression tridimensionnelle. La production du support nécessite lui, beaucoup de matière, il apparaît donc plus efficace de diviser cette pièce en deux. En effet en créant la pièce intérieure 1, le support peut être fabriqué en bois de récupération et la géométrie intérieure de ce support sera produit précisément en impression tridimensionnelle. Enfin l’ensemble sera fixé grâce à deux vis pour assurer le maintien et la mise en position de ces deux pièces l’une par rapport à l’autre.

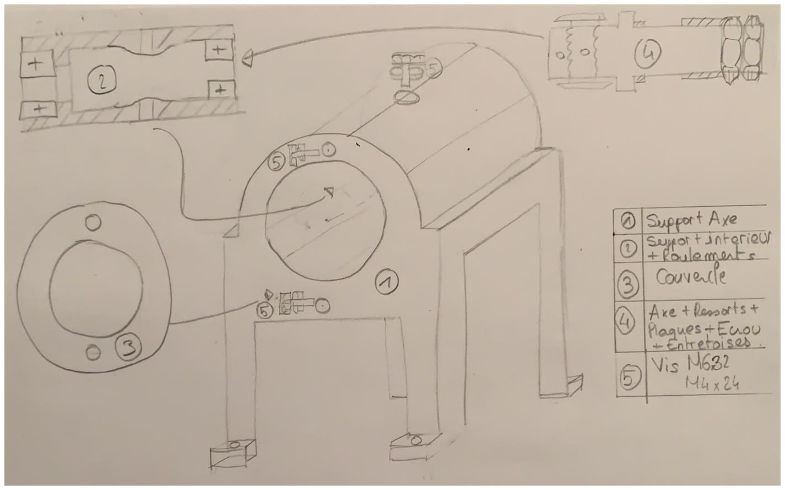
[picture p59: figure]

Figure 4 : Schéma illustrant le sous-ensemble 2
b. Fixation de la bobine sur l’arbre
Pour le maintien de la bobine sur l’arbre, les avis du groupe divergeaient et différentes solutions technologiques ont été proposées.

Solution 1 : Utilisation d’un mandrin industriel
Ce système assure une adaptation idéale aux diamètres des bobines mais son coût est très important. Le mandrin serait normalisé et acheté dans le commerce pour être directement fixé en bout d’arbre. La fixation en bout d’arbre apparaît compliquée.

Solution 2 : Utilisation d’entretoises
La fabrication d’entretoises pour chacun des diamètres assurerait une mise en position mais nécessiterait en plus, un maintien en position. La production sera peu coûteuse (impression tridimensionnelle). Cette solution ne semble pas optimale car elle nécessite une manipulation de l’utilisateur lors de chaque changement de bobines avec de nombreux diamètres différents.

Solution 3 : Utilisation de ressorts
L’implantation des ressorts permettrait de s’adapter parfaitement aux différents diamètres de bobines. Nous pourrions ainsi insérer des ressorts au sein de l’arbre qui s’adapteront en compression aux différents diamètres des bobines. Cette solution a un coût faible.

Pour choisir la solution idéale vis-à-vis de nos critères, nous avons réalisé un tableau de choix :

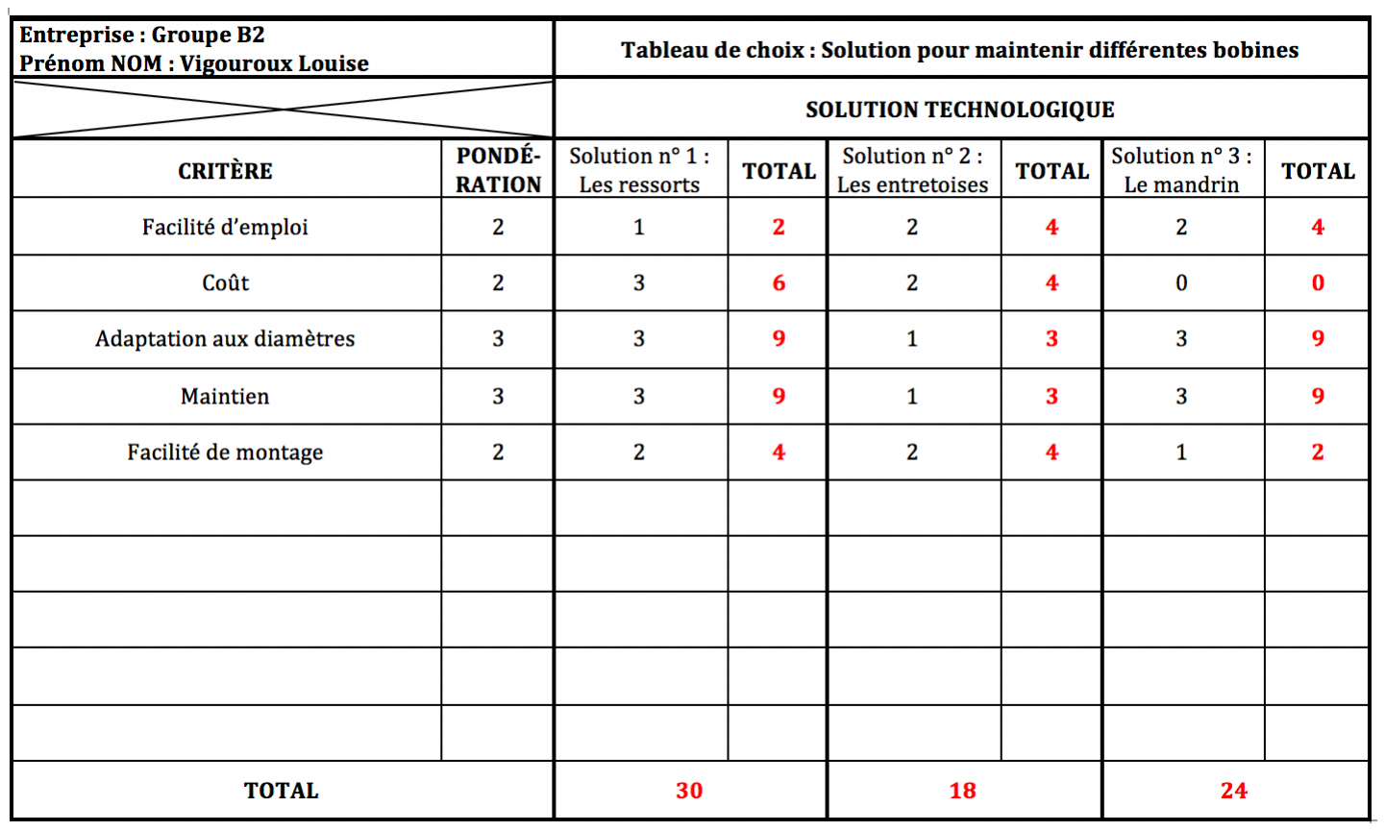
[picture p60: figure]

En effet, il apparaît que l’utilisation de ressorts est idéale car elle assure à la fois un maintien de la bobine seulement grâce à la mise en position mais elle permet également une adaptation parfaite aux différents diamètres. Sa réalisation est de plus très peu coûteuse. L’utilisateur devra serrer les différentes plaques caoutchouteuses, positionner sa bobine puis relâcher les différentes parties. La bobine sera alors encastrée à l’arbre et permettra un enroulage du fil optimal. Le mandrin était également une bonne solution technologique mais son coût était trop élevé et le montage au bout de l’arbre, trop complexe.

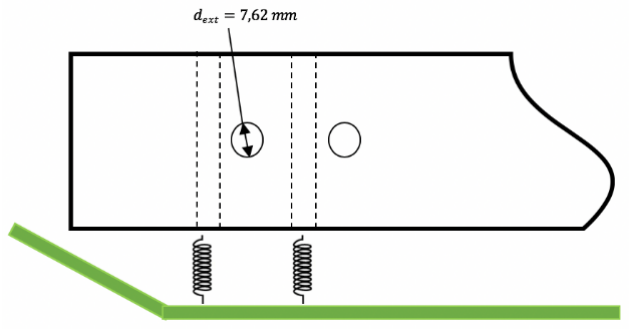
[picture p61: figure]

Ainsi nous fixerons aux extrémités des ressorts des plaques suivant la forme de l’axe sur lesquelles seront fixés des lamelles de caoutchouc afin d’assurer l’adhérence avec le diamètre intérieur de la bobine. Cette solution est adaptable dans notre cas car les efforts à transmettre afin de réaliser la liaison encastrement sont relativement faibles. Si les efforts avaient été plus importants, il aurait été nécessaire d’utiliser des clavettes/cannelures.
La mise en place de cette solution technique nécessite l’utilisation de quatre ressorts. La fixation des morceaux de caoutchouc s’effectuera avec de la colle.

Figure 5 : Schéma du montage

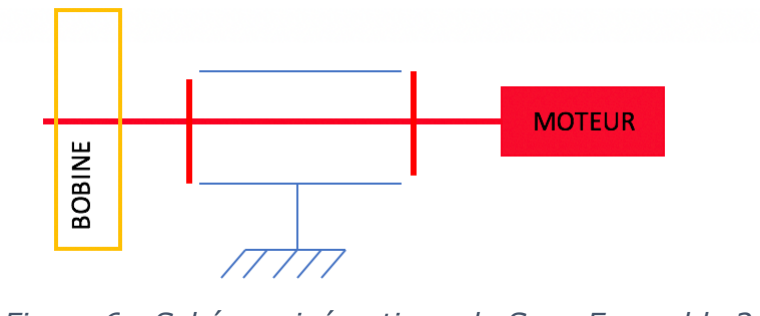
[picture p62: figure]

Pour accompagner la rotation de l’arbre par rapport au support, il a été choisi d’utiliser en plus deux roulements à billes (Voir III.1. Pour le dimensionnement).
L’arbre d’entraînement aura ainsi une géométrie complexe car il doit pouvoir accueillir les 4 supports en caoutchouc et doit assurer les arrêts axiaux des roulements.

Estimation du coût :
- Support en bois de récupération : 10€
- Pièce intérieure 1 : ECAM
- Arbre en acier ∅ = 45mm et l = 246mm : 15€
- Usinage sur TCN : ECAM
- 2 vis CHC M6x32 (capot) : 2€
- 2 vis CHC M4x24(arbre et pièce intérieure 1) : 2€
- 4 rondelles M5 : 2€
- 4 ressorts Sodemann : 18,76€ (voir III. Pour le dimensionnement)
- 2 roulements à billes : 15 €
- 2 écrous : 10€
- 2 entretoises : 10€
- 1 moteur CC : 160€
- Contrôleur de moteur : 15,52€
Le sous ensemble fixation de la bobine sur le support représenterai ainsi un minimum de 75€ si l’usinage de l’arbre et l’impression de la pièce intérieure 1 sont possibles au sein du FabLab de l’ECAM.
4) Enroulage du fil

Il faut pouvoir translater le fil qui vient s’enrouler sur la bobine afin d’avoir un enroulage homogène sur toute la largeur de cette dernière.

Pour ce faire, nous avons deux solutions :
- Un système de bielle-manivelle faisant translater une pièce sur un rail afin d’avoir une course de la largeur de la bobine.
- Un système avec un servomoteur faisant varier l’angle de la pièce guidant le fil afin de couvrir la largeur de la bobine.

La première solution a rapidement été retenue, en effet la largeur de la bobine fait que les dimensions de la pièce guidant le fil pour la deuxième solution étaient disproportionnées par rapport à la bobineuse. De plus, l’utilisation en mode « rapide » de la bobineuse aurait engendré des problèmes en raison de l’inertie qu’aurait eu cette pièce en variant d’angle à haute fréquence.

Figure 6 : Schéma cinématique du Sous Ensemble 2

Il fallut désormais trouver une pièce adaptée pour guider le fil.
La première idée était un simple cube en plastique avec une entaille en V qui translaterait sur deux rails. Mais les frottements engendrés au niveau de l’entaille auraient causé une usure trop rapide de la pièce et le système aurait été défectueux, abîmant le fil à son passage.
Nous avons donc opté pour un roulement à roulette afin qu’il n’y ait aucun frottement avec le fil, le roulement tournant au contact du fil.
Afin de pouvoir translater cet élément, la conception d’une pièce pour se coller au roulement fut effectuée. Cette pièce va ainsi pouvoir se coller sur la bague intérieure du roulement, tout en translatant également sur le rail. Ensuite, une extrusion est prévue avec un taraudage afin que la bielle puisse se fixer à cette pièce avec un système de contre-écrou, mais sans empêcher sa rotation autour de cette extrusion.

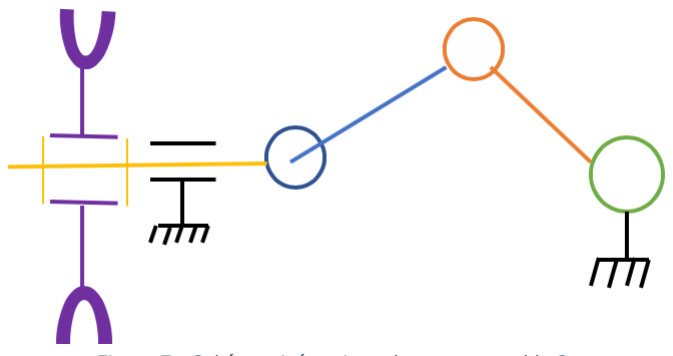
[picture p63: figure]

Figure 7 : Schéma cinématique du sous ensemble 3
De plus, notre système doit pouvoir s’adapter à plusieurs bobines de taille différentes. La distance dont doit translater le fil pour remplir un étage sur la bobine est donc amenée à varier. Pour ce faire, la liaison pivot entre la roue (manivelle) et la bielle est réglable à l’aide d’un axe mobile pouvant translater dans un trou oblong et que l’on serre contre la roue par le biais de deux écrous : plus l’axe est loin du centre de la roue plus la translation du fil est grande et inversement.

Estimation du coût :

- Roulement à roulette : 10€
- Rail en acier : 10€
- Liaison bielle-manivelle : ECAM
- Fixation rail : ECAM
- Support roue et moteur : ECAM
- Roue : ECAM
- Axe mobile acier : 1€
- Moteur CC : 34€
- Bielle : ECAM
- Accouplement roue-moteur : 7€
- Contrôleur de moteur : 15,52€

## 5) Coupage du fil

a. Description et solution

Ce sous-ensemble devra remplir deux fonctions principales : bloquer et sectionner le fil. Ces deux actions devront être liées et pouvoir être effectuées en un seul mouvement, dans un premier temps le fil sera bloqué puis coupé (et non l’inverse pouvant causer des problèmes de retour de fil).
La contrainte associée à ce sous-ensemble est que, comme expliqué précédemment, les deux fonctions doivent être liées dans la première partie du mouvement (blocage/coupage) puis indépendante dans la seconde partie. En effet une fois le fil coupé, celui-ci doit être maintenu fixe même après la remontée de la lame ce qui explique pourquoi les deux actions doivent pouvoir être dissociées l’une de l’autre.
La solution retenue se base sur l’exploitation du « point dur » d’un matériau plastique, le tube carré sur lequel sera fixé la lame viendra appuyer sur cette partie plastique situé au-dessus du fil, passant ainsi le point dur de celui-ci et venant plaquer fermement le fil contre le support. La lame pourra ainsi remonter tout en assurant le maintien du fil.

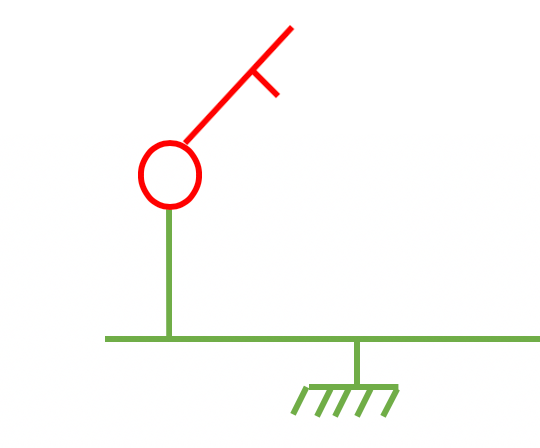
[picture p64: figure]

Figure 8 : Schéma cinématique du sous ensemble 4
Estimation du coût :
- Plateau support (aluminium) : 20€
- 2 supports partie plastique (aluminium) : 7€
- 2 supports axe : 9€
- Partie plastique : 4€
- 2 roulements à billes D./0 = 20mm : 8€
- Axe tube (aluminium) : 4€
- Lame : récupération
- Support lame (aluminium) : 5€
- 4 Vis M6x20 : 6 €
- Usinage : ECAM
- 2 Circlips : 3€

Coût approximatif total : 60€ (ce coût peut varier suivant les matériaux dont dispose déjà l’ECAM.)
Le choix de l’aluminium est principalement dû à la robustesse et la stabilité que doit avoir ce sous-ensemble. De l’impression 3D ne pourrait pas supporter les contraintes exercées. De plus le poids de l’aluminium facilitera le maniement et la prise en main du coupe fil lors de la phase de coupe, contrairement à du plastique.
b. Usinage, montage et durée de vie

L’usinage des différentes pièces est très simple et pourra être effectué sur une fraiseuse conventionnelle pour les pièces carrées et sur un tour conventionnel pour les pièces cylindriques, l’utilisation de machines CN n’est pas indispensable.
En ce qui concerne le montage, celui-ci ne posera pas de problèmes particuliers dû à la géométrie très simple des différentes pièces à assembler, le démontage pourra s’effectuer très rapidement en cas de besoins précis ou de maintenance.
Le facteur « durée de vie » ne pourra qu’être pris en compte au niveau de la lame car c’est la seule pièce d’usure de ce sous-ensemble, celle-ci pourra s’émousser avec le temps pouvant nuire à la découpe du fil, c’est pourquoi elle doit pouvoir être changée très facilement par l’opérateur, ou tout simplement retirée pour être affutée.

## 6) Arrêt de la machine

Afin d’interrompre la rotation de la bobine lorsque cette dernière est pleine nous avons décidé d’utiliser un Interrupteur de fin de course :
Sur la bobineuse, nous avons installé un commutateur de course
supérieure qui se déplace par rapport à celle-ci. Cet interrupteur
est directement connecté à la source de tension du moteur afin que la rotation de la bobine s’arrête lorsque l’alimentation du moteur est coupée.
La butée au point fixe est installée à la position fixe ou, à la position d’installation opposée. Lorsqu’il s’effectue un contact mécanique entre l'interrupteur de course et la butée, le circuit de commande est coupé (ou modifié) et la machine s'arrête ou change de fonctionnement. En raison du mouvement d'inertie de la machine,
cet interrupteur a une certaine "surcourse" qui le protège des
possibles dommages liés aux chocs.

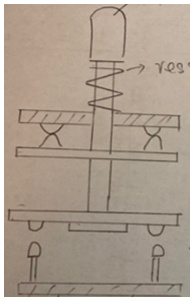
[picture p65: figure]

Dans le cas d’une utilisation réelle, l'interrupteur de fin de course est installé dans une position prédéterminée. Lorsque le module touche l'interrupteur de course, le contact de l'interrupteur de fin de course agit pour réaliser la commutation du circuit. Par conséquent, le commutateur de course est un appareil électrique qui commute le circuit en fonction de la position de course de la pièce mobile et dont la fonction est similaire à celle d’un bouton.

Figure 9 : capteur de fin de course

## 7) Fixation

Mobilité : La bobineuse se divise en plusieurs sous-ensembles ce qui ne facilite pas sa mobilité, c’est pourquoi un plateau support de fixation doit être conçu en parallèle pour pouvoir la déplacer. Ce support pourra aussi faciliter la cratérisation du tout mais aussi la liaison avec l’extrudeuse en créant une liaison fixe entre le plateau de l’extrudeuse déjà existant et le plateau de la bobineuse.
Pour les déplacements, celle-ci devra pouvoir circuler sans problème au sein de bâtiments en ayant la possibilité de passer des portes, des cages d’escalier etc.…

En comparant les dimensions standard de porte, le plateau ne devrai impérativement pas passer 63cm de largeur, la hauteur ne sera à priori pas un problème.
Une fois le plateau construit, celui-ci pourra potentiellement venir se fixer sur un chariot roulant de façon à faciliter accroître sa mobilité.
Le support de l’axe sera fixé sur le bâti par le biais de 4 vis M6. Des trous ont été percés à cet effet.

Maintenance : Les différents sous-ensembles devront obligatoirement pouvoir être démontés du plateau support pour des questions d’entretien et/ou pouvoir subir de potentielles modifications.
Fonctionnement : La bobineuse est liée à l’extrudeuse par un fil (axe) suivant une trajectoire rectiligne jusqu’à l’arrivée dans la bobine. Pour ces raisons, il est très important que chaque sous-ensemble soit placé de manière cohérente afin d’obtenir un meilleur enroulement. En effet le fait de produire un plateau obligeront les sous-ensembles à être situé au même endroit, ainsi obtenir une récurrence dans les résultats et augmenter leur fiabilité.
Par exemple, le coupe/bloque fil devra être placé à la même distance à chaque fois entre l’extrudeuse et la bobine et parfaitement dans l’axe du fil.

Figure 10 : Dimension porte standard

## III) Dimensionnement

## 1) Les roulements situés sur l’arbre

Schéma du montage :

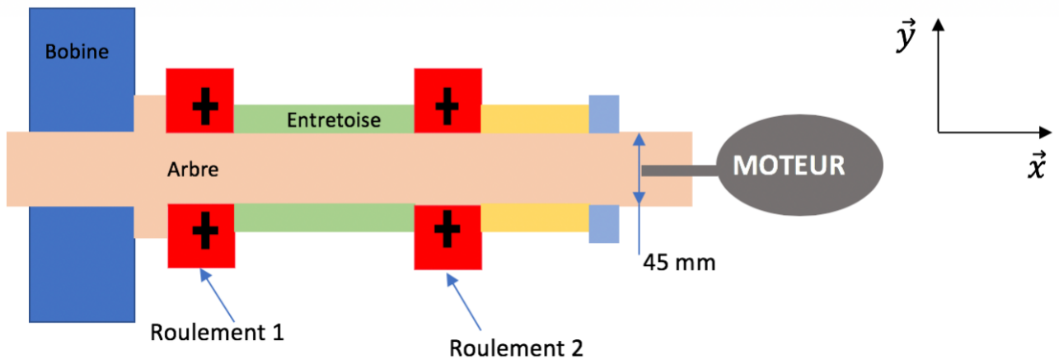
[picture p66: figure]

Données de l’arbre pour le dimensionnement : L = 246 mm et R = 22,5 mm
Les roulements choisis ici sont des roulements à billes car l’effort axial (uniquement les vibrations engendrées lors du fonctionnement de la bobineuse) et car ce sont les moins chers. Efforts présents sur les roulements :
Nous considérons ici uniquement les efforts liés au poids des composants, les vibrations sont négligées pour notre système car peu importantes.
- Poids maximum de la bobine : 1 kg
- Poids de l’arbre : l’arbre est en acier, d’un diamètre de 45 mm sur une longueur de 246mm, ainsi P5676. = Π × (22,5. 10=>)@ × (246. 10=>) × 7800 = 3,05 kg
- Le poids des autres composants est négligé devant le poids de ces deux.
Nous affectons au système un coefficient de sécurité : s = 2.
De cette manière nous obtenons un effort total sur les roulements de F = 79,5N.

Étant donné la configuration du système, l’effort est supposé entièrement appliqué sur le roulement 1 car c’est le plus proche de la bobine. Afin de sécuriser au maximum cette bobineuse, nous considérerons que l’autre roulement sera identique au premier.
Rotation de l’arbre en tours/min :
ω = C

R = 30
2,25 = 13,3 rad. s=M = 127 trs. min=M

Pour cette étude, la vitesse maximum de l’arbre est de 127 tours/min, et la durée de vie souhaité des roulements est d’un million de tours.
Sachant que LMQ = (

R
S

)> pour les roulements à billes, avec LMQ la durée de vie, C la charge de base en Newton qui permet de déterminer le roulement nécessaire et P qui vaut dans le cas présent la charge radiale, F = 79,5N. En effet dans cette modélisation, la charge axiale est supposée nulle.

De cette manière, il faut C ≥ P × ULMQ V | soit C ≥ 79,5 × √1. 10X V | = 795 daN
Grâce à la table de dimensionnement des roulements à billes (voir Annexe), le roulement pour notre système a un diamètre intérieur de dYZ0 = 45 mm, diamètre extérieur de d./0 = 75 mm et une largeur de l = 16 mm.
2) Les ressorts

Nous avons décidé d’utiliser 4 ressorts. Le poids d’une bobine pleine est estimé à P7a7 = 1 kg. Ainsi la puissance maximale sur un ressort est Pb5/ = 0,5 kg
La forme maximale est ainsi : Fb5/ = 4,9 N
La déformation maximum acceptée pour notre système est de defb5/ = 7 mm.
Le diamètre des bobines à remplir est variable et 52 mm < D7a7YZ. < 55 mm donc le support en caoutchouc sera d’une épaisseur de e = 2mm.
Schéma du système ressort-caoutchouc :

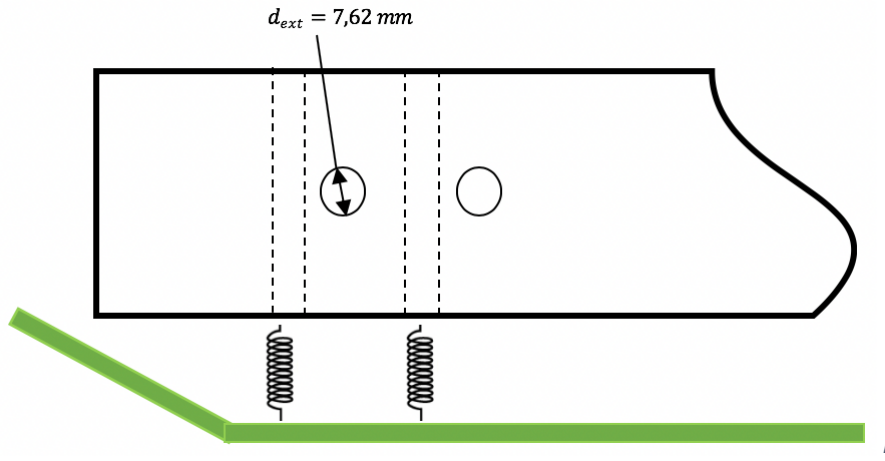
[picture p67: figure]

Figure 11 : Schéma du montage
En utilisant le site internet traceparts, les ressorts sélectionnés sont de la marque Sodemann et leur référence est : C03000512250M
Son diamètre extérieur est de D./0 = 7,62 mm
Son coût est de : PrixhZY0é = 4,69€
3) Le moteur
a. Dimensionnement moteur bobine

Vitesse minimale du moteur bobine : (fil provenant de l’extrudeuse)

Données :
- vitesse minimale de sortie du fil :VbYZ = 15 mm. s=M
- diamètre de la bobine : D7 = 45mm

VbYZ = (

D7
2 ) ∗ ωbYZ

ωbYZ = VbYZ ∗ 2
D7

= 0,66 rd. s=M = 0,11 rd. s=M = 6, 6 tr. min=1

Vitesse maximale du moteur bobine : (fil provenant de chutes de bobines)

Données :
- vitesse maximale de sortie du fil : Vb5/ = 200 mm. s=M
- diamètre de la bobine :D7 = 45mm

Vb5/ = (

D7
2 ) ∗ ωb5/

ωb5/ = Vb5/ ∗ 2
D7

= 8,89 rd. s=M = 1,41 tr. s=M = 84, 6 tr. min=1

Donc pour la vitesse de rotation du moteur de la bobine :

6, 6 tr. min=1 ≤ ωbobine ≤ 84, 6tr. min=1

Le moteur choisi est un moteur CC de référence RS 773_6784. Nous avons décidé d’utiliser un motoréducteur afin d’assurer une vitesse de ω = 85 trs. min=M qui ne nécessite l’ajout d’un système de roue et vis sans fin ou d’engrenages.

b. Dimensionnement moteur guidage en translation du fil (moteur 2)

Vitesse minimale du moteur 2 :

Données :
- vitesse de rotation minimale de la bobine : ωbYZ = 0,11 tr. s=M = 6,6 tr. min=M
- diamètre minimal du fil :DbYZ = 1,5 mm
- diamètre de la bobine : D7 = 45mm
- longueur maximale de la bobine : L b5/ = 58 mm
Temps de remplissage d’un étage de fil :

Nombre de tour pour un aller : n = w xyz
{x|}

= 38,67 trs

Il faut donc n = 38 trs pour remplir un étage de fil.

t 1tour = 1
ωbYZ

= 9, 1 s

La bobine fait un tour en 9,1 s.

taller = n ∗ t 1tour = 346 s

Vitesse minimale du moteur 2 :

Sachant qu’avec le système bielle manivelle un tour de manivelle correspond à un aller-retour pour la pièce guidant le fil sur la longueur de la bobine, le temps pour la roue d’effectuer un tour correspond au temps qu’il faut pour faire deux fois un aller avec le fil sur la bobine.

On a donc : t0ah67a7YZ. = 2 ∗ t5ÑÑ.6

Ainsi, ω2min = M
0Üáàâäáä|}ã

= M
@×taller

= 1,4 × 10=>tr. s=M = 8, 4 × 10=2 tr. min=1

Vitesse maximale du moteur 2 :

Données :
- vitesse de rotation maximale de la bobine : ωb5/ = 1,41 tr. s=M = 84,6 tr. min=M
- diamètre minimal du fil : Db5/ = 3 mm
- diamètre de la bobine : D7 = 45mm
- longueur minimale de la bobine :LbYZ = 41 mm

Temps de remplissage d’un étage de fil :

Nombre de tour pour un aller : n = wx|}
{xyz

= 13,67 trs
Il faut donc n = 13 trs pour remplir un étage de fil.

t 1tour = 1
ωb5/

= 0, 71 s

La bobine fait donc un tour en 0,71 s.

taller = n ∗ t 1tour = 9, 2 s

Vitesse maximale du moteur 2 :

Sachant qu’avec le système bielle manivelle un tour de manivelle correspond à un aller-retour pour la pièce guidant le fil sur la longueur de la bobine, le temps pour la roue d’effectuer un tour correspond au temps qu’il faut pour faire deux fois un aller avec le fil sur la bobine.

On a donc : t0ah67a7YZ. = 2 ∗ t5ÑÑ.6

Ainsi, ω2max = M
0Üáàâäáä|}ã

= M
@×taller

= 0,054 tr. s=M = 3, 2 tr. min=1

Donc pour la vitesse de rotation du moteur 2 :

0, 0084 tr. min=1 ≤ ωmoteur2 ≤ 3, 2 tr. min=1

Le moteur 2 choisi est un moteur à courant continu de référence RS PRO 417-9649 sur le site internet RS Pro. On a choisi ce moteur car la vitesse maximale dont on a besoin est de
3,2 tr/min , étant donné qu’il n’y aura que des efforts relativement faibles, ce moteur de 4 tr/min est amplement suffisant pour faire tourner la roue qui entraînera la bielle et ainsi la translation de la pièce guidant le fil en rotation.
c. Roulement lié au guidage du fil

Le rail sur lequel translate ce roulement a un diamètre de d = 4 mm, de cette manière le roulement choisi, sur le site 123Roulement, est référencé 605 − 2RS − RW, avec un diamètre extérieur de d = 19 mm et une épaisseur de e = 7,9 mm.

## IV) Conclusion :

1) Estimation finale du coût et cahier des charges

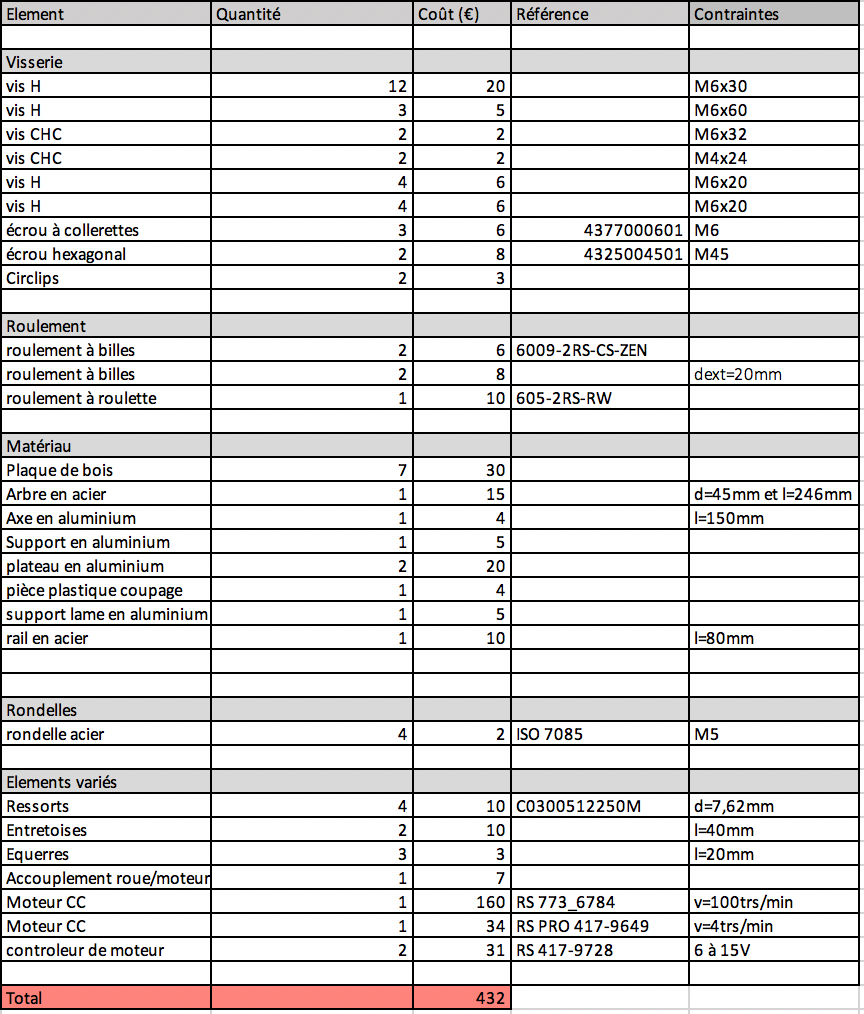
[picture p68: figure]

Le coût des composants nécessaires à la réalisation de notre outil s’élève à 432€. Ainsi le budget de 750€ a été respecté tout en répondant au cahier des charges et l’argent restant pourrait donner lieu à des améliorations de la machine notamment pour la création d’un carter pour être déplacé dans tous les milieux.

2) Enrichissement personnel
Le projet de conception de bobineuse fut une expérience enrichissante pour l’ensemble du groupe car il a permis de développer nos compétences à divers niveaux. En effet en travaillant à huit nous avons pu nous confronter à des avis divergents mais également aux qualités de chacun. Il a été important de tous s’écouter et de travailler de manière dynamique pour que personne ne se sente à l’écart.
La répartition du travail a été importante car la construction d’un tel projet nécessite beaucoup de travail et chacun a dû se concentrer sur sa tâche.
3) Enrichissement technique
La bobineuse est le premier projet de recherche industrielle dans le cadre de nos études à l’ECAM. Il nous a permis de découvrir les problématiques quotidiennes d’un ingénieur. En effet lors de la conception d’un outil industriel, un ingénieur se doit de prendre beaucoup de paramètres en compte. Il est important d’associer la production à la sécurité et à la simplicité d’utilisation tout en minimisant les coûts et l’empreinte écologique. La théorie que nous avons pu acquérir lors de nos deux années précédant l’ECAM 3 nous a permis de mettre en application les notions et les adapter aux besoins de production et aux contraintes de travail. Les principales contraintes rencontrées durant ce projet ont été le temps et le budget qui nous ont été imposés. Le travail au sein du groupe a pu poser un problème également au niveau de la motivation de chacun au cours des séances ou le manque de communication entre les groupes.

## V) Annexes

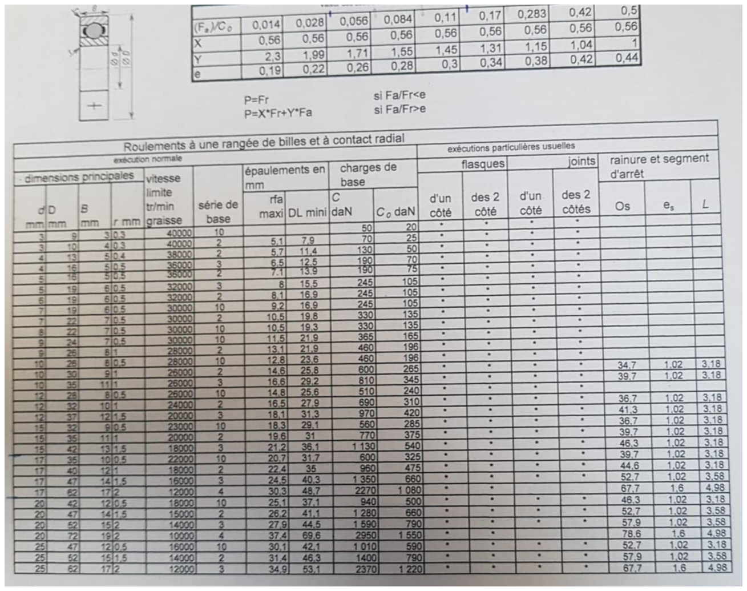
[picture p69: figure]
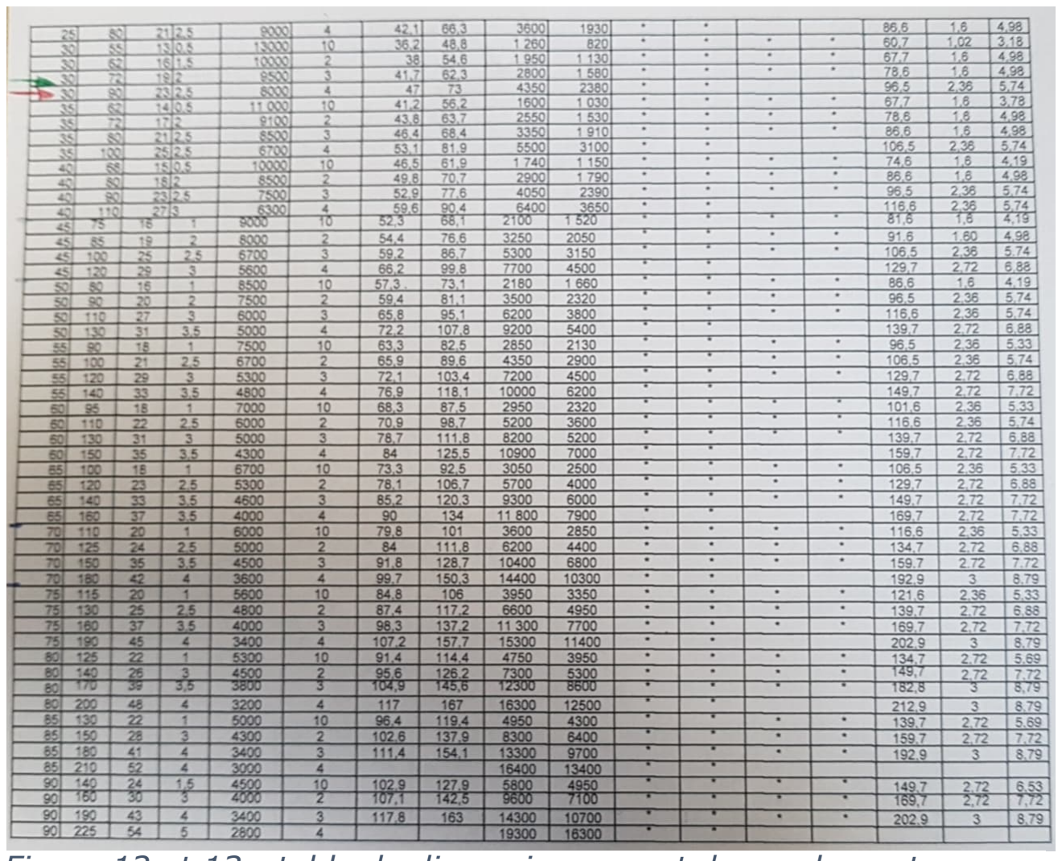
[picture p70: figure]

Figure 12 et 13 : table de dimensionnement des roulements
