RolandThsive/3D-printer-Plastic-Recycler/2020-05-30 Données annexes (André ERNESTO)/2019-12-06 Rapports de conception/Projet Bobineuse - Groupe J1.pdf

No | Désignation | Critère | Niveau | Flexibilité | Commentaire
1 Enroulage FP1 FP1-1 FP1-2 FC1 FC1-1 | Enrouler le fil autour d'une bobine Enrouler à partir de l'extrudeuse Renrouler une bobine possédant déjà du fil Eviter que le fil accroche Refroidir pour pas que le fil ne se colle à lui-même | Vitesse d'enroulement Temps d'enroulement Température maximale du fil en entrée de la bobineuse | Entre 10 et 15 mm/s 20 secondes 50 °C | 0 1 1 | Informations techniques de l'extrudeuse Estimation sur la base d'un enroulement à 50 cm/s de 10 mètres de fil Température de transition vitreuse de 50°C du PLA
2 Intégrité du fil FC2 FC2-1 FC2-2 FC2-3 | Préserver les propriétés du fil Préserver l'intégrité de l'extrème surface Préserver la cylindricité du fil Préserver le diamètre de la section du fil | Proportion maximale de surface polluée Espacement de deux cylindres coaxiaux entre lesquels l'intégralité de la suface est comprise Tolérance par rapport au diamètre commandé | 5% ± 0,02 mm ± 0,02 mm | 2 0 0 | Estimation Tolérance sur l'imprimante Tolérance sur l'imprimante

### 3 Utilisation

FC3 | Être accessible
FC3-1 | Pouvoir changer la bobine facilement et rapidement | Durée max d'un changement | 3 min | 3 | Estimation d'un temps raisonnable et relativement faible par rapport au
| | | | | temps de bobinage (estimé à 5h en sortie d'extrudeuse)
FC3-2 | Stocker les bobines pleines | Capacité de stockage minimale | 3 bobines | 3 | Estimation vis-à-vis de la fréquence à laquelle une bobine est terminée
| | | | | (estimée à une bobine en 5h en sortie d'extrudeuse)
FC3-3 | Stocker les bobines vides | Capacité de stockage minimale | 3 bobines | 3 | Estimation vis-à-vis de la fréquence à laquelle une bobine est terminée
| | | | | (estimée à une bobine en 5h en sortie d'extrudeuse)
FC3-4 | Être accessible à la maintenance | Durée maximale d'intervention nécessaire
| | pour démonter une pièce | 5 min | 3 | Estimation
FC3-5 | Être accessible à l'entretien | Durée maximale d'intervention d'entretien | 1 min | 3 | Estimation
FC3-6 | Être facile à utiliser | Durée maximale de formation à l'utilisation
| | du système | 15 min | 3 | Estimation
FC3-7 | S'adapter au diamètre intérieur de la bobine | Intervalle de variation du diamètre | [49.5 ; 60.5] mm | 0 | Valeur moyenne du diamètre intérieur d'une bobine (55 mm) ± 10%
FC3-8 | Prévoir un arrêt d'urgence | Temps d'arrêt maximal du système | 2 s | 1 | Estimation
FC3-9 | Communiquer avec l'utilisateur | Eclairement minimal des voyants | 150 lux | 2 | Estimation
FC3-10 | Répartir correctement le fil sur la bobine | Proportion maximale de vide sur l'ensemble
| | du volume occupé par le fil | 15% | 2 | Estimation

### 4 Système

FC4 | Préserver l'intégrité du système
FC4-1 | Maintenir la bobine en position | Adhérence minimale | 100% | 1 | La bobine ne doit pas glisser sur l'axe qui l'entraine en rotation
FC4-2 | S'adapter à l'emcombrement de la bobine | Diamètre minimal et hauteur minimale du
| | volume cylindrique libre autour de l'axe de la
| | bobine | Diamètre : 22 cm
| | | Hauteur : 7,5 cm | 1 | Valeur moyenne du diamètre extérieur d'une bobine (20 cm) + 10%
| | | | | Valeur moyenne de la largeur d'une bobine (6,5 cm) + 10%
FC4-3 | Supporter le poids de la bobine | Masse supportée par l'arbre au minimum | 2,5 kg | 1 | Masse maximale de bobine trouvée dans le commerce : 2,3 kg
FC4-4 | Rendre le système solide | Fréquence de vibration à laquelle le système
| | résiste au minimum | 5 Hz | 1 | Estimation
FC4-5 | Adapter la vitesse de la bobine par rapport au débit du fil | Ecart relatif maximal entre la vitesse du fil en
| | entrée de la bobineuse et celle au niveau de
| | la bobine | 1% | 1 | Estimation pour éviter d'abimer le fil
FC4-6 | Adapter la vitesse de la bobine par rapport à son remplissage | Ecart relatif maximal entre la vitesse du fil en entrée de la bobineuse et celle au niveau de la bobine | 1% | 1 | Estimation pour éviter d'abimer le fil
FC4-7 | Limiter les frottements lors de la rotation de la bobine | Rendement energétique minimum | 90% | 2 | Estimation

## Fonction principale et fonctions contraintes

5 Mobilité FC5 FC5-1 FC5-2 FC5-3 | Être transportable Être transportable par deux opérateurs (homme ou femme) Être adaptable au chassis de l'extrudeuse Être compact | Masse maximale du système Largeur maximale du chassis Emcombrement maximal du système | 40 kg 800 mm 1000x850x1000 mm | 0 2 0 | Masse maximale qu'une femme est autorisée à porter seule : 25 kg (article R4541-9 du code du travail) Largeur du chassis de l'extrudeuse : 700 mm Encombrement maximal de 1000x1000x1000 mm dans le document technique et possibilité de passer les portes (largeur 900 mm)
6 Sécurité FC61 FC61-1 FC62-2 FC62 FC62-1 FC62-2 | Être protégé de l'environnement extérieur Cartériser le système Rendre le système étanche Respecter les mesures de sécurité Réguler la chaleur du système Isoler électriquement le système | Proportion minimale du système couverte Proportion minimale du système protégée de l'eau Température maximale à la surface du système Proportion minimale des systèmes électriques isolés | 100% 95% 50°C 100% | 2 1 1 0 | Nécessaire pour assurer une bonne protection du système Estimation Eliminer les risques de brûlures (destruction rapide des tissus à partir de 52°C) Eliminer les risques d'électrocution
7 Ecole FC7 FC7-1 FC7-2 FC7-3 | Être pédagogique Rendre le système observable Avoir une notice d'utilisation claire Rendre le système esthétique | Proportion minimale de pièce visible Nombre maximal de pages Nombre minimal de personnes trouvant la machine belle sur 20 personnes interrogées | 85% 5 pages 15 | 3 3 3 | Estimation Estimation Estimation
8 Automatisme FC8 FC8-1 FC8-2 FC8-3 FC8-4 FC8-5 | Rendre le système autonome Détecter que la bobine est pleine Arrêter la bobine une fois pleine Anticiper la bobine pleine (arrêt de l'extrudeuse) Bloquer le fil lorsque la bobine est pleine Couper le fil lorsque la bobine est pleine | Erreur maximale sur le remplissage de la bobine en pourcentage de la masse voulue Temps d'arrêt maximal du système Instant de l'arrêt de l'extrudeuse Déplacement maximal du fil dans la bobine une fois la bobine pleine Temps maximal entre l'arrêt du système et la coupe du fil | ± 2% 2 s 3 min avant la fin du remplissage 2 mm 5 s | 1 1 1 1 3 | Estimation Estimation Estimation du temps pendant lequel l'extrudeuse continue de débiter du fil après l'arrêt de son moteur Estimation pour que le fil ne se déroule pas Estimation
9 Energie FC9 FC9-1 | Être alimenté en énergie électrique Être économe en énergie | Consommation énergétique maximale | 12 W | 1 | Fonctionnement en basse tension : 12 V x 1 A
10 Economie FC10 FC10-1 FC10-2 | Respecter le budget Limiter les coûts d'entretien Assurer une durée de vie convenable | Coûts d'entretien maximum par an Durée de vie minimale | 50 € 5 ans | 2 2 | Estimation vis-à-vis du budget de départ pour la construction du système Estimation
