RolandThsive/3D-printer-Plastic-Recycler/2020-05-30 Données annexes (André ERNESTO)/2019-12-06 Rapports de conception/Projet Bobineuse - Groupe E2.pdf

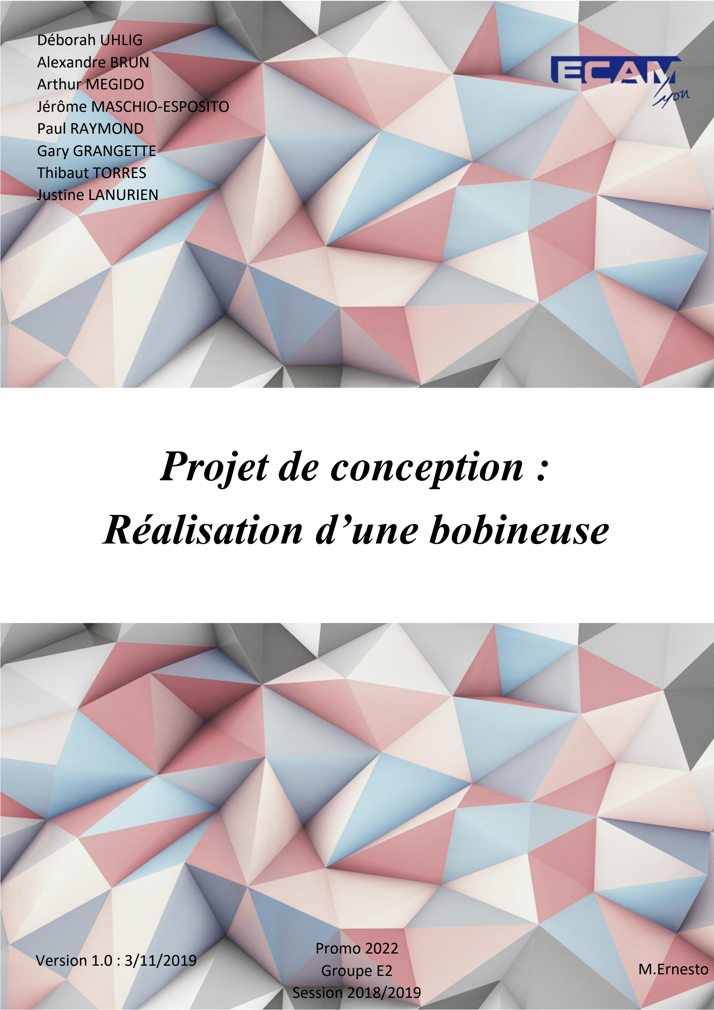
[picture p227: page 1]

11111122

Déborah UHLIG
Alexandre BRUN
Arthur MEGIDO
Jérôme MASCHIO-ESPOSITO
Paul RAYMOND
Gary GRANGETTE
Thibaut TORRES
Justine LANURIEN

Promo 2022
Groupe E2
Session 2018/2019

M.Ernesto Version 1.0 : 3/11/2019

# Projet de conception :

# Réalisation d’une bobineuse

2 /30

## SOMMAIRE

### I. Analyse du besoin et étude de la faisabilité

a. Contexte général du projet
b. Cahier des charges

### II. Conception et définition du produit

a. Structure du système
i. Schéma cinématique
ii. Première esquisse 2D du prototype
iii. Esquisse 3D du prototype
b. Description du fonctionnement général du système
c. Choix technologiques

### III. Etude de la fabrication du produit

a. Moyens disponibles
b. Sous-traitance éventuelle

### IV. Conclusion

### V. Annexes

a. Annexe 1A : Diagramme de bête à cornes
b. Annexe 1B : Diagramme pieuvre
c. Annexe 1C : QQOQCPC

### VI. Conception et dessin

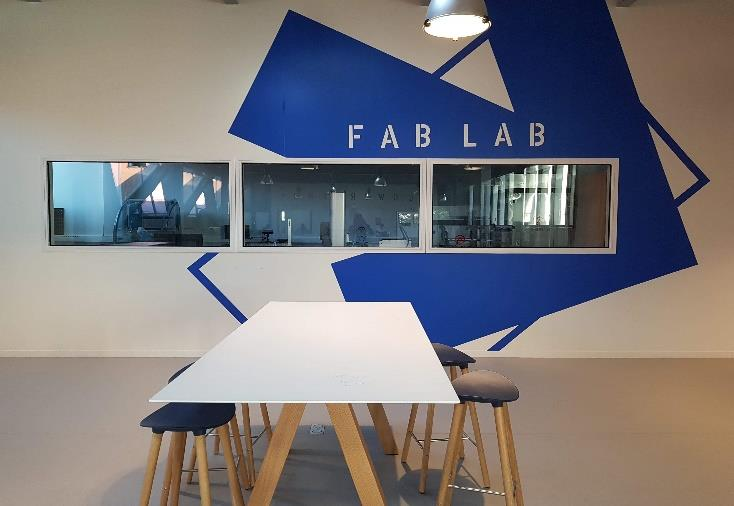
[picture p228: figure]

3 /30

I. Analyse du besoin et étude de faisabilité
a. Contexte général du projet

Le travail suivant s’inscrit dans le cadre d’une approche pédagogique en conception lors de notre cursus en troisième année à l’ECAM (Ecole Catholique des Arts et Métiers) Lyon. Il a pour but de permettre aux étudiants de découvrir les méthodes de travail qui se rapprochent le plus possible de celui de l’ingénieur en conception, et ceux, au sein d’un groupe de 8 élèves.

Ce projet tend à réaliser
une bobineuse qui sera
utilisée prochainement au
sein de l’ECAM, plus
spécifiquement dans un
espace de travail : le
FabLab.

Récemment, les imprimantes 3D ont subi une augmentation conséquente de leurs utilisations engendrant des coûts supplémentaires (fils/ matière première principalement : 30€/bobine). L’ECAM Lyon avec la complicité de M.ERNESTO ont donc lancé un appel d’offre à laquelle notre entreprise a décidé de répondre, avec pour objectif d’améliorer les dépenses financières de l’école dans les imprimantes 3D.
L’année dernière, une extrudeuse fut conçue par nos camarades d’ECAM 3 promo 2021 dans le but de répondre à la problématique. Cette année, pour donner suite à l’appel d’offre, l’entreprise E2 est amenée à concevoir une bobineuse.

Ainsi, il s’agit de concevoir un système qui permettrait d’enrouler autour de bobines de plusieurs tailles, différents diamètres de fils provenant de l’extrudeuse.
Pour se faire, les étudiants auront à leur disposition un logiciel de conception 3D (CREO 3.0 PARAMETRIC), des machines de prototypages rapides et un dossier de conception.

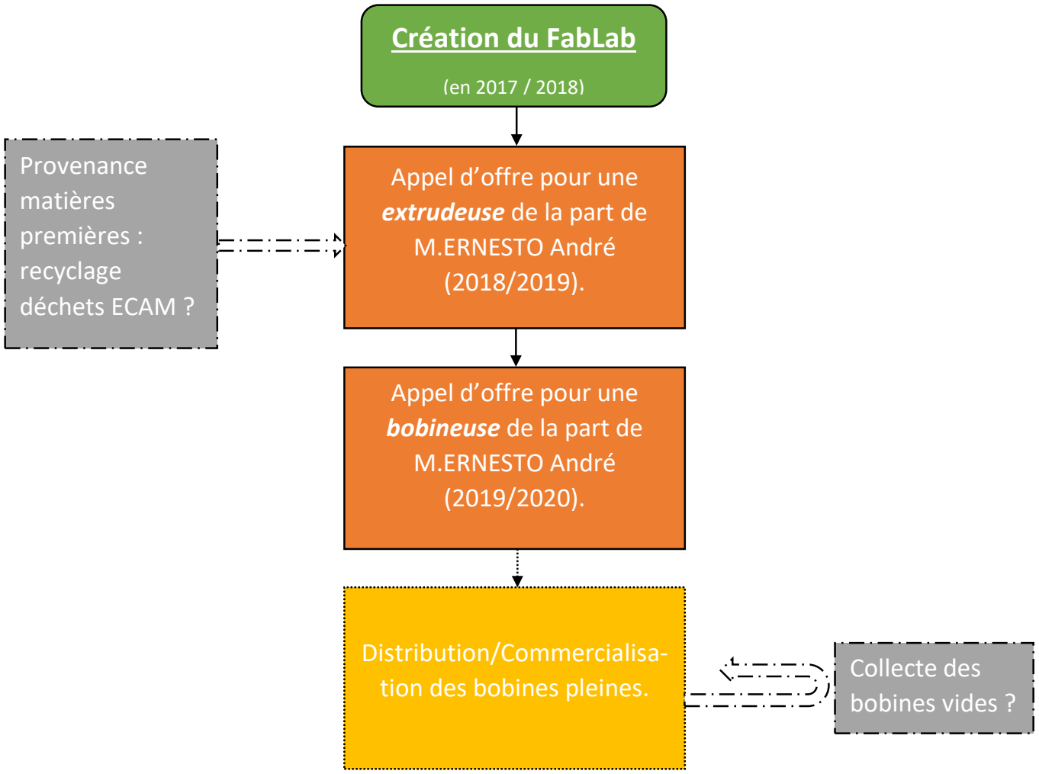
[picture p229: figure]
Création du FabLab; Appel d’offre pour une extrudeuse de la part de M.ERNESTO André (2018/2019).; Appel d’offre pour une bobineuse de la part de M.ERNESTO André (2019/2020).; Distribution/Commercialisa- tion des bobines pleines.; Collecte des bobines vides ?; Provenance matières premières : recyclage déchets ECAM ?

4 /30

Et après ? Pour aller plus loin dans la démarche, l’école pourrait fabriquer et commercialiser ses propres bobines de fils pour la bobineuse. De plus toute une réflexion peut se faire autour de la provenance de la matière premières pour fabriquer le fils : qu’en est-il du recyclage des matières plastiques fait à l’ECAM ?

Le schéma suivant récapitule les démarches de l’entreprise et ceux depuis la création de FabLab jusqu’à potentiellement toutes les idées à venir concernant la réduction des dépenses dans le prototypage rapide.

N.B : la méthode du Q.Q.O.Q.C.P.C et le diagramme de bête à cornes nous ont permis de mettre en évidence le cadre général du projet.

5 /30

a. Cahier des charges
II | Adaptabilité
FC1 | Facilement transportable
FC1-1 | Mobile pour être transportée
FC1-2 | Rendue statique ou fixe | Degrés de mobilité | 0 | 0
FC1-3 | Avoir un poids adapté pour être portée par 2 personnes | Poids | 40kg | 0
FC1-4 | Avoir une dimension maximale | Dimensions | 1000*1000*1000 mm | 0
FC2 | Coût
FC2-1 | Le prix de la bobineuse ne doit pas dépasser un certain coût | Prix | 750€ | 0 | Peut être inférieur.
III | S'ajuster
FP3 | Polyvalent
FP3-1 | Réglable en hauteur | Translation verticale | 10cm < L < 100cm | 2
FP3-2 | Capable de se déplacer en translation horizontale | Translation horizontale | ? | 2
FP3-3 | Capable d'accepter plusieurs diamètres de bobines | Diamètre variable | ? | 0
FP3-4 | Pouvoir enrouler 2 types de fils | Diamètre variable | {2,85; 1,75} mm | 0
FP3-5 | Avoir une vitesse modifiable en temps réel | Vitesse variable | ? | 1
No | Désignation | Critère | Niveau | Flexibilité | Commentaire
I | Enrouler le fil
FP1 | Faciliter la manœuvre
FP1-1 | Enrouler le fil à une vitesse ajustée | Vitesse max | 10 tr/min | 0
FP1-2 | Avoir un système de démarrage simple pour l’utilisateur | Nombre de composants max. | 2 composants | 2
FP1-3 | Avoir un système d’arrêt automatique | Nombre de composants max. | 2 composants | 1
FP2 | Homogénéiser la répartition du fil sur la bobineuse
FP2-1 | Permettre un balayage horizontal pour l’embobinage | Vitesse | 1 mm/s | 0
FP2-2 | Tendre le fil pour permettre l’embobinage | Force max. | 5 N | 0

6 /30

No | Désignation | Critère | Niveau | Flexibilité | Commentaire
IV | Utilisation
FP4 | Faciliter l’utilisation
FP4-1 | Avoir un stockage de bobine plein et un stockage de bobine vide à proximité | Stockage max. | 30 bobines | 2
FP4-2 | Démontage rapide et simple d’utilisation | Durée max. | 1 min | 1
FP4-3 | Fournir un effort pour maintenir le fil lors de la découpe | Force max. | 30 N | 0
FP4-4 | Avoir un stockage de fils défectueux | Stockage max. | 2 bassines | 2
FP4-5 | Avoir un moyen d’alimentation | Nombre de composants max. | 1 batterie | 0
FP5 | Communiquer avec l’utilisateur
FP5-1 | Avoir un moyen de prévention lorsque la bobine est pleine | Nombre de composants max. | 1 LED | 0
FP5-2 | Avoir un système d’affichage lorsque la machine est en marche | Nombre de composants max. | 2/3 LED | 1
FP5-3 | Avoir un manuel d’utilisation | Nombre de composants max. | 1 manuel | 0
FP5-4 | Avoir une légende sur les composants | Nombre de composants max. | 10 composants | 1
V | Sécurité
FP6 | Protéger l'utilisateur | | | 2
FP6-1 | Stabilité de l'appareil lors de l'utilisation | | | 2
FP6-2 | Protéger l'utilisateur contre l'électrocution | | | 2 | Fil terre
FP6-3 | Protéger l'utilisateur contre les blessures mécaniques | | | 2
FP6-4 | Protéger l’utilisateur des brûlures dû au contact avec le fil chaud | Présence de gants | 1 paires | 1
FP7 | Protéger la machine | | | 2
FP7-1 | Protéger la machine d'un point de vue électrique | | | 2 | Fusible, isolement
FP7-2 | Protéger la machine de l'environnement extérieur | | | 2
FP7-3 | Protéger la machine de l'environnement extérieur | | | 2

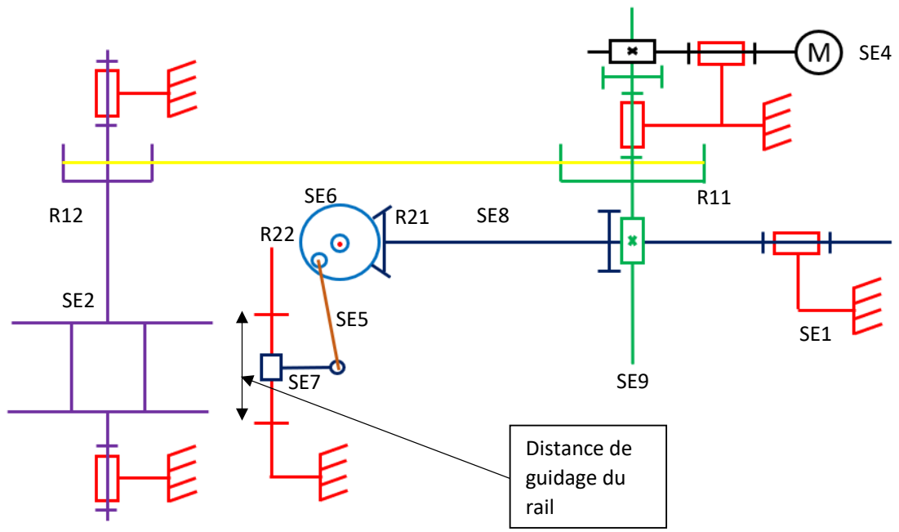
[picture p230: figure]
Distance de guidage du rail

7 /30

II. Conception et définition du produit
a. Structure du système
i. Schéma cinématique vue de dessus

Sous-ensemble 1 : Bâti.

Sous-ensemble 2 : Bobine, Arbre de guidage bobine, Poulie crantée R12.

Sous-ensemble 3 : Courroie crantée.

Sous-ensemble 4 : Moteur, Vis sans fin 1.

Sous-ensemble 5 : Bielle.

Sous-ensemble 6 : Engrenage conique R22.

Sous-ensemble 7 : Rail de guidage.

Sous-ensemble 8 : Roue du système roue et vis sans fin 2, Engrenage conique R21.

Sous ensemble 9 : Arbre de transmission en sortie du moteur, Poulie crantée R11, Vis sans fin 2, Roue du système roue et vis sans fin 1.

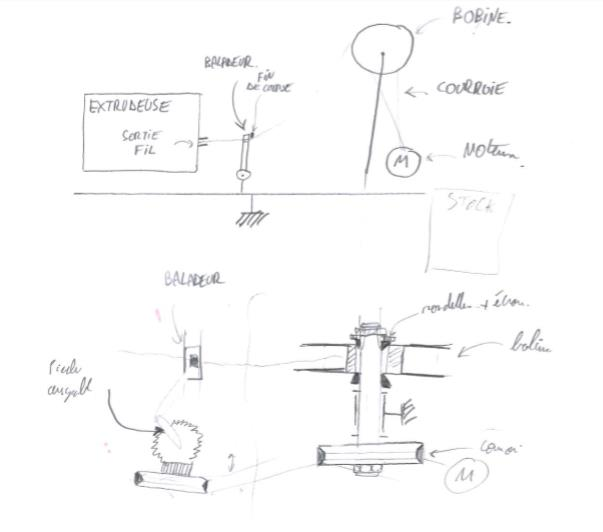
[picture p231: figure]

8 /30

ii. Première esquisse 2D du prototype :

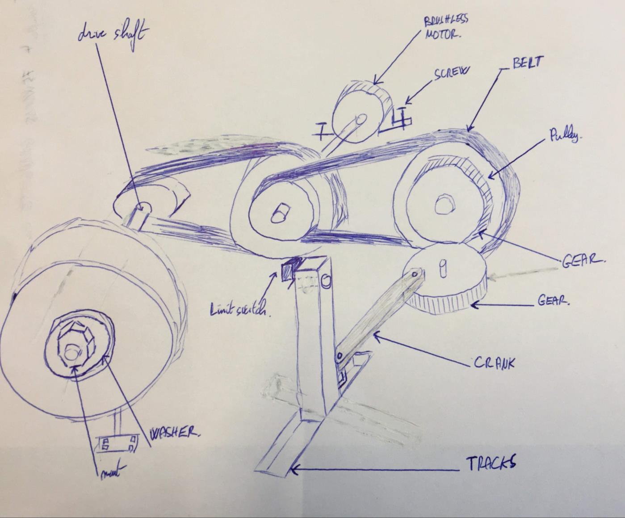
[picture p232: figure]

9 /30

iii. Esquisse 3D du prototype (version sans roue et vis sans fin)

Ordre de grandeur des dimensions de la bobineuse : 800mm x 500mm x 600mm

10 /30

b. Description du fonctionnement général du système

En entrée du système on a un moteur. Ce moteur sera accouplé à un système de roue et vis sans fin (le 1er) fournissant un premier rapport de réduction. La roue du système roue et vis sans fin est en liaison pivot avec le bâti et celle-ci est fixé sur un arbre. Sur ce même arbre est fixé une poulie crantée R11 et une deuxième vis sans fin. A partir de là le système possède deux parties de fonctionnement distincts :

- La première : la poulie R11 est relié à une seconde poulie R12 à l’aide d’un courroie crantée (2ème rapport de réduction). Cette deuxième poulie R12 est liée à un second arbre qui est en liaison pivot avec le bâti et sur lequel est monté la bobine.
- Le deuxième : La vis sans fin 2 engraine sur la roue du système roue et vis sans fin 2 ce qui induit un troisième rapport de réduction. La roue est fixée sur un troisième arbre en liaison pivot avec le bâti et sur lequel est fixé un
engrenage conique R21. Cet engrenage engraine avec un autre : R22. Et enfin sur R22 est fixé un baladeur qui va permettre de répartir le fil de manière homogène sur la bobine.

11 /30

c. Choix technologiques
i. Enrouler le fil

FP1-1 : Enrouler le fil à une vitesse adaptée

C’est une des fonctions principales à satisfaire. En effet, au fur et à mesure de l’enroulement du fil autour de la bobine le rayon d’enroulement R de la bobine varie, ainsi il faut ajuster la vitesse de rotation du moteur ω car la vitesse de sortie du fil V doit est constante.

V= R×ω

Pour répondre à cette fonction nous avons étudié 2 solutions :

- Capteur de fin de course
- Potentiomètre

Après études de ces deux solutions, le capteur de fin de course s’est avéré la meilleure solution. En effet, le potentiomètre permet de choisir un grand panel de vitesse de rotation pour le moteur, cependant ce système nécessite qu’un utilisateur soit constamment présent lors du bobinage pour adapter ω, or une des fonctions contraintes du système est d’être autonome dès lors que l’utilisateur a mis en route la bobineuse et accrocher le fil sur la bobine.

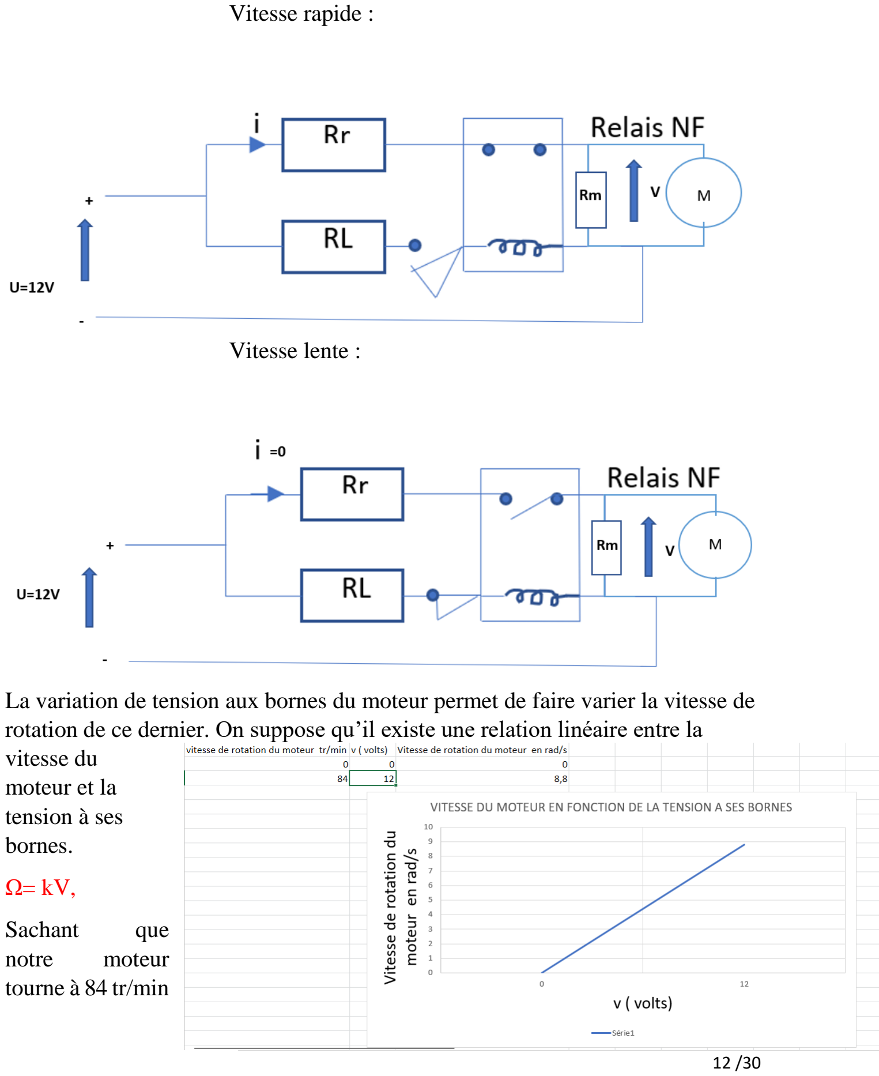
[picture p233: page 12]

12 /30

Vitesse rapide :

Vitesse lente :

La variation de tension aux bornes du moteur permet de faire varier la vitesse de rotation de ce dernier. On suppose qu’il existe une relation linéaire entre la vitesse du
moteur et la
tension à ses
bornes.

Ω= kV,

Sachant | que
notre | moteur
tourne à 84 tr/min

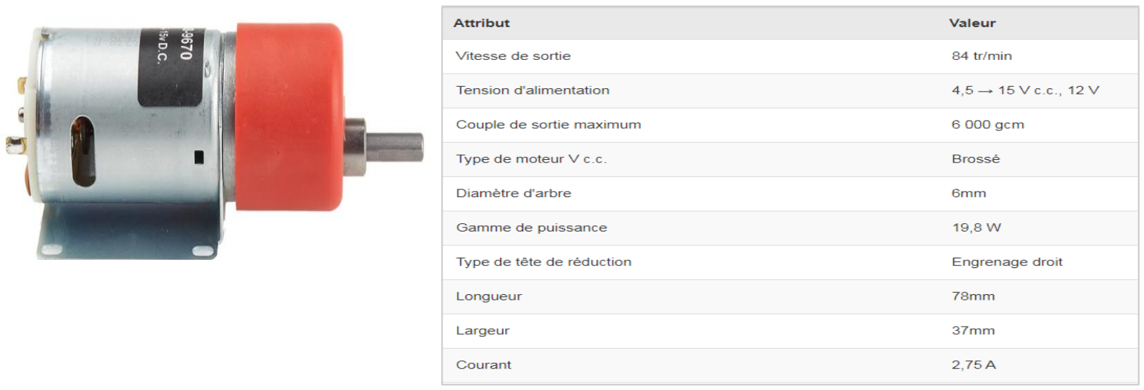
[picture p234: figure]

13 /30

à 12 V on trouve k=0,73 pour notre moteur.

Dimensionnement des résistances : on fixe Rm =1 Ω

Lorsque notre bobine est pleine, la vitesse de rotation de notre bobineuse est minime.

On va dimensionner le couple RL qui permet d’imposer une tension précise au moteur et faire tourner notre bobineuse à une vitesse minimum.

Dans le cas où le fin de course est activé (ωbob minimum) :

ωbob : vitesse de rotation de la bobineuse en rad/s
Vsortie = 0,015 m/s : vitesse de sortie du fil au niveau de l’extrudeuse rymax = 0,2 m : rayon de la bobine lorsque celle-ci est pleine
V : tension aux bornes du moteur
ωm: vitesse de rotation du moteur en rad/s
U : tension du générateur 12v
Rl : résistance à dimensionner
Rr : résistance à dimensionner

14 /30

ωbob =

Vsortie

rymax(1+

15
100

)

or

ωbob

ωm

= 1/25 donc ωm = 25 Vsortie

rymax(1+

15
100

)

On a vu avant que ωm = k x V

Donc V = 25 | Vsortie
| k ×rymax(1+

15
100

)

= 2,2 V

On applique maintenant un diviseur de tension on obtient :

U
V

=

Rm
Rm+RL

<=> Rl = Rm (1 −

V
U

) ×

U
V

= 4,45 Ω

De la même manière lorsque la bobine n’a encore enroulé aucun fil, la vitesse de la bobineuse est maximale.

Cas du fin de course non activé ( ωbobmax) :

rymin=0,1 cm

ωbob =

Vsortie

rymin(1−

15
100

)

or

ωbob
ωm

= 1/25 donc ωm = 25 Vsortie

rymin(1−

15
100

)

On a vu avant que ωm = k x V

Donc V = 25 | Vsortie
| k ×rymin(1−

15
100

)

= 6V

Or U
V

=

Rm
Rm+Rr

donc Rr = Rm (1 −

V
U

) ×

U
V

=1 Ω

Finalement : Rr =1 Ω et RL= 4,45 Ω

Afin de mener au bon fonctionnement et au suivi de la bobineuse on pourra rajouter des LEDs qui permettront de suivre en temps réel la vitesse de cette dernière. Ces LEDs faciliteront la communication avec l’utilisateur et l’une d’entre elle permettra de répondre à la fonction FP5-1 « Avoir un moyen de prévention lorsque la bobine est pleine », en effet lorsque la bobine sera pleine toutes les LEDs seront éteintes grâce à la fonction d’arrêt automatique FP1-3 du système assuré par un autre fin de course qui coupera l’alimentation lorsque la bobine sera pleine. Ce fin de course sera placé à une distance R de l’axe de la bobine qui correspond au rayon de la bobine pleine. Aussi un fusible sera

15 /30

également ajouté afin de protéger le moteur, soit la fonction FP7-1 « protéger la machine d’un point de vue électrique ».

| Type de roue | Diamètre primitif (mm) | Nombre de dents
R12 | Poulie crantée | 20
R11 | | 40
R21 | Roue conique | 26
R22 | | 70
Vis sans fin 1 | Roue dent droite | | 50
Vis sans fin 2 | | | 40

TRANSMISSION ROUE ET VIS SANS FIN :

Combien de tours de bobine faut-il pour enrouler le fil sur toute sa largeur? Lbobine
Øfil = n [tour] = n. 2. π [rad]

Combien de temps faut-il pour enrouler le fil sur une largeur ? Soit ω’ la vitesse de rotation de la bobine.

Vis sans fin
r=1/50

Système poulie
crantée r=2

bobine R=1/25

Vis sans fin
r=1/40

roue conique
r=10/27

Baladeur
R=1/5400

16 /30

t =

n.2.π
ω′

=

Lbobine.2.π
Øfil.ω′

=

Lbobine.2.π.R11.ω
Øfil.R12

[s] avec w la vitesse de rotation du

moteur.

On veut que t soit égale à la demi période du déplacement du baladeur, ainsi le baladeur permettra d’enrouler sur toute la largeur de la bobine, le fil extrudé.

t =

T
2

=

π
ω′′

Ainsi :

ω

′′ =

Øfil. ω. R11
Lbobine. 2. π. R12
w’’ correspond à la vitesse de rotation de sortie de la roue R22.

En appliquant les valeurs numériques on trouve un rapport de réduction de 1/5400 noté r2.

Globalement on cherche à réduire cinématiquement fortement nos transmissions. C’est pour cette raison que nous mettrons dès la sortie de l’arbre moteur une roue et vis sans fin avec un rapport de 1/50. Nous obtiendrons r1 en multipliant ce rapport par deux avec un système courroie poulie cranté (système transmettant le mouvement synchrone et de manière amortie).

Nous obtiendrons r2 avec une roue et vis sans fin d’un rapport de réduction de 1/40 et des engrenages coniques pour le renvoie d’angle à 90° avec un rapport de 1/2,7. On a bien r2 = 1/5400.

17 /30

ii. Adaptabilité

FC1-1 : Mobile pour être transportée

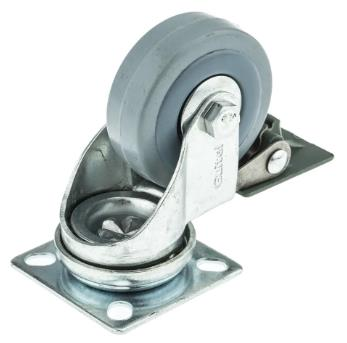
[picture p235: figure]

La bobineuse repose entièrement sur un socle d’un mètre carré. Ce socle est constitué de 4 roulettes de part et d’autre qui permettront la mobilité et la stabilité du système.

Notre choix s’est porté sur les roulettes suivantes, avantageuses au niveau du coût, d’efforts supportés, de leurs tailles et aussi du fait que ce sont les mêmes que l’extrudeuse.

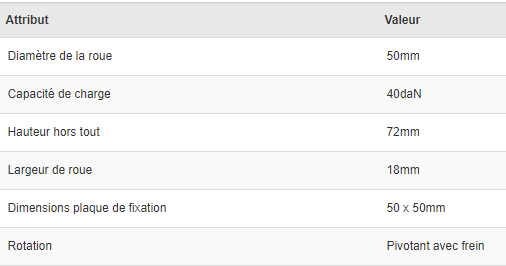
[picture p236: figure]

iii. S’ajuster

FP3-2 : Capable de se déplacer en translation horizontale

Dans un premier temps, notre choix technologique pour cette fonction s’était porté sur le déplacement en translation de la bobine directement. Plusieurs solutions s’offraient à nous seulement aucune ne convenaient. Le mécanisme pignon crémaillère pouvait provoquer trop de frottements. Le système bielle manivelle en rotation lente proposait un fonctionnement sinusoïdal qui ne correspondait avec le cahier des charges « une bonne répartition du fil sur toute la surface de la bobine ». Enfin nous avions pensé au moteur pas à pas mais la manipulation retour aurait été difficile à obtenir.

18 /30

Nous avons finalement pris la décision de déplacer le fil. Il s’est révélé que cette solution était beaucoup plus pratique. Le fil sera introduit dans un fin perçage relié au baladeur afin qu’il soit réparti le long de la surface de la bobine. Le perçage sera assez grand afin de respecter la fonction FP3-4 du cahier des charge qui permet à l’utilisateur d’enrouler 2 types de fils. Le baladeur quant à lui obtiendra son mouvement de translation via un système de rotation entrainé par un enchainement d’engrenages.

FP3-1 : Réglage en hauteur

De la même manière pour cette fonction nous aurions pu travailler sur le socle de maintien de la bobine mais nous avons préféré user du système précédent pour régler la hauteur d’arrivée du fil, qui varie selon le diamètre des bobines. Le système est simple, sur le sous-ensemble engrenage conique on placera sur la roue plusieurs perçages à des distances différentes du centre. Ainsi le déplacement de la bielle sera plus ou moins important en hauteur et le guidage du fil également.

Grace à ces différents réglages, notre système de bobineuse est capable d’accepter tout type de bobine et donc répond à la fonction FP3-3 du cahier des charges.

iv. Utilisation

FP4-1 : Avoir un stockage à proximité de bobines pleines et vides.

Nous avons pensé à 3 solutions différentes pour répondre à cette fonction :

- Solution n°1 : Présence de deux bacs sous la table (un pour les bobines vides, un autre pour les bobines pleines).
- Solution n°2 : Fixation de deux baguettes verticales (une pour les bobines vides, une autre pour les bobines pleines) sur le socle.
- Solution n°3 : Fixation de deux poteaux sur le socle équipés de deux barres horizontales mobiles (un pour les bobines vides, un autre pour les bobines pleines).

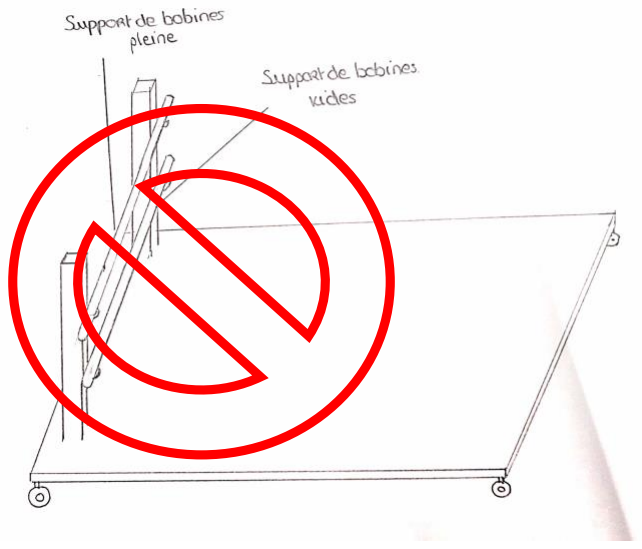
[picture p237: figure]

19 /30

Critère | Pondération | Solution n°1 | Total | Solution n°2 | Total | Solution n°3 | Total
Encombrement | 1 | 3 | 3 | 3 | 3 | 3 | 1
Faciliter de mise en œuvre | 1 | 3 | 3 | 3 | 3 | 2 | 2
Prix | 1 | 2 | 2 | 2 | 2 | 2 | 2
Mobilité (lié au socle) | 1 | 0 | 0 | 3 | 3 | 3 | 3
Total | | 8 | | 11 | | 8

Grâce à ce tableau, les solutions n°1 et 3 n’ont pas été retenue respectivement à cause de la mobilité et de son encombrement.

On choisira donc la solution n°2.

Choix des matériaux :

- Liteaux à sections circulaires de diamètre compris en 20 et 50 mm

FP4-2 : démontage rapide et simple de la bobine

On a réfléchi à plusieurs solutions pour la mise en place de la bobine sur son arbre de rotation.

Solution n°1 : Soufflet avec un système bielle manivelle et un ressort

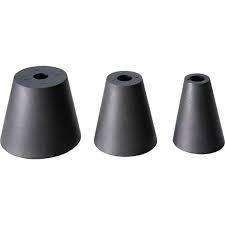
[picture p238: figure]

Solution n°2 : Cônes

20 /30

Critère | Pondération | Solution n°1 | Solution n°2
Encombrement | 1 | 1 | 3
Facilité d’utilisation | 1 | 1 | 3
Coût | 1 | 2 | 2
Mobilité (remplacé la bobine facilement) | 1 | 1 | 3
Précision de maintien | 1 | 3 | 2
Total | | 8 | 13

Finalement la solution n°2 nous a paru la plus appropriée notamment pour sa facilité d’utilisation et sa mobilité. Lorsqu’on utilisera la bobineuse, la rapidité de changement de la bobine est importante. Ainsi les critères de mobilité et de facilité d’utilisation sont primordiaux.

FP4-3 : avoir un système de découpe du fil quand la bobine est pleine

Un ciseau (pince coupante) sera placé à côté de la bobineuse.

FP4-4 : avoir un stockage de fil défectueux

Une petite poubelle en-dessous de la bobineuse sera mis à disposition.

v. Sécurité

Afin de protéger notre système contre les intempéries on va venir poser une protection en plexiglass ou PET autour de notre bobineuse, nous avons choisi le matériaux plexiglass ou le PET afin de pouvoir observer notre système à travers cette protection .

On va prendre un dôme de plexiglass rectangulaire de 99cm x 99cm x 60 cm que l’on viendra déposer sur le plateau qui supporte notre bobineuse comme on le voit ci-dessous :

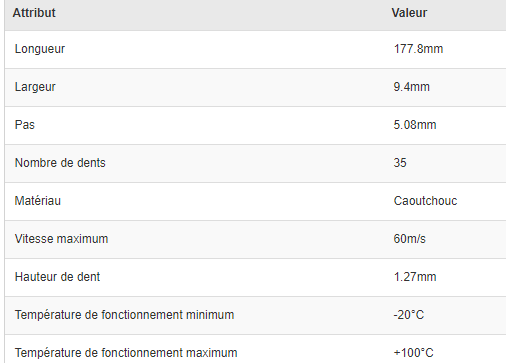
[picture p239: figure]

21 /30

III. Etude de la fabrication du produit
a. Moyens disponibles

Nous avons dans un premier temps l’accès au site d’achat des différents éléments nécessaires « Radio spare » qui nous a permis de choisir quelques pièces en adéquation avec notre système et correspondant aux normes industrielles.

Liaison poulie-courroie :

Notre choix de courroie s’est portée sur une courroie synchrone dont le pas est de 5mm.

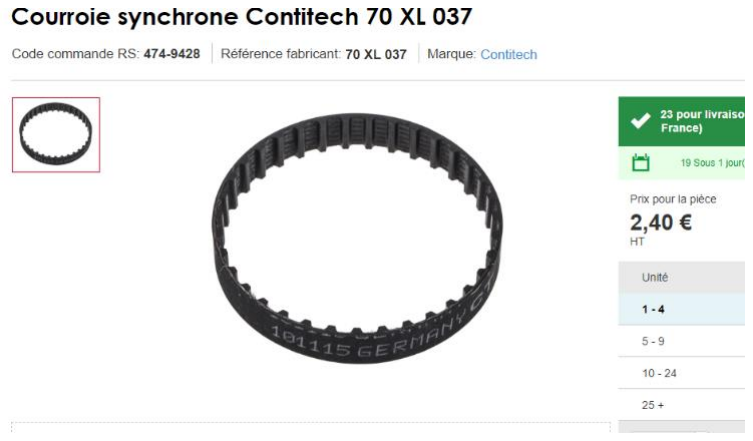
[picture p240: figure]

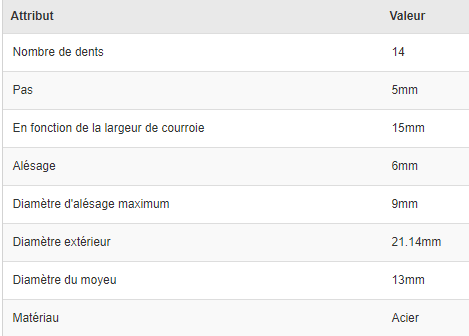
[picture p241: figure]
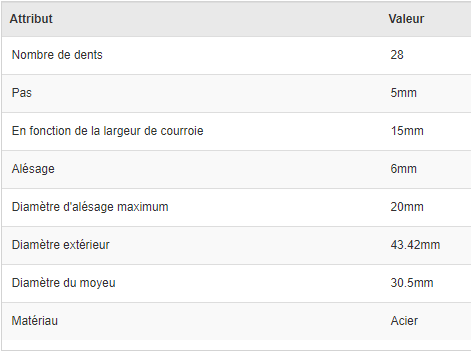
[picture p242: figure]
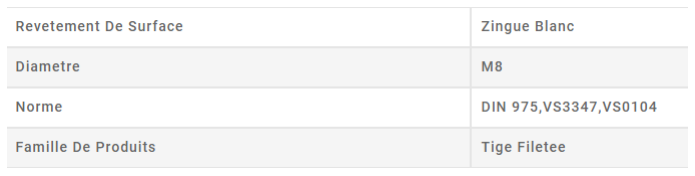
[picture p243: figure]

22 /30

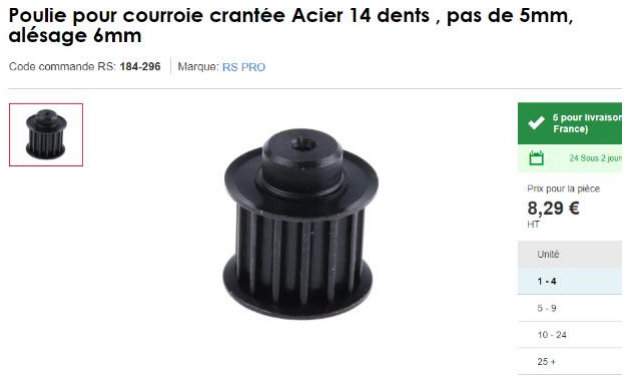
[picture p244: figure]
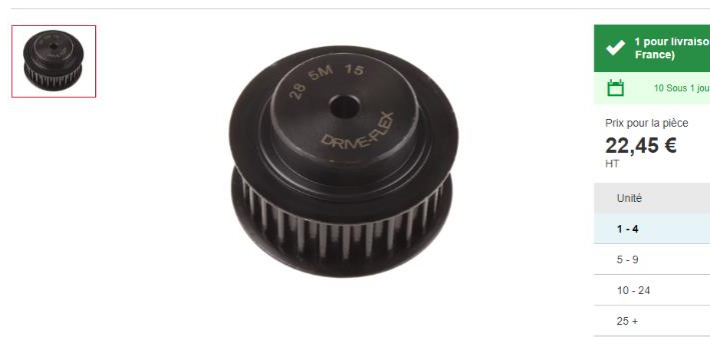
[picture p245: figure]

Afin de créer notre liaison poulie-courroie, ce qui était important de respecter dans le choix de poulie, était la valeur du pas qui devait être égale à celle de la courroie, de 5mm. On cherchait également un diamètre de 20mm. La valeur la plus approchée était de 21mm. Notre choix se portera sur les mêmes caractéristiques pour la deuxième poulie R11.

Cette tige correspond à l’arbre qui sera en liaison encastrement avec la bobine et la roue R12.

On a choisi un arbre assez résistant pour soutenir le poids de la bobine.

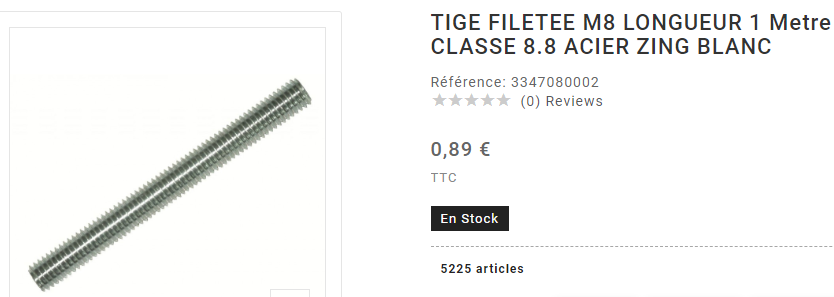
[picture p246: figure]

Afin d’obtenir une liaison encastrement entre l’arbre et la bobine, on placera des écrous aux extrémités des cônes pour bloquer la translation.

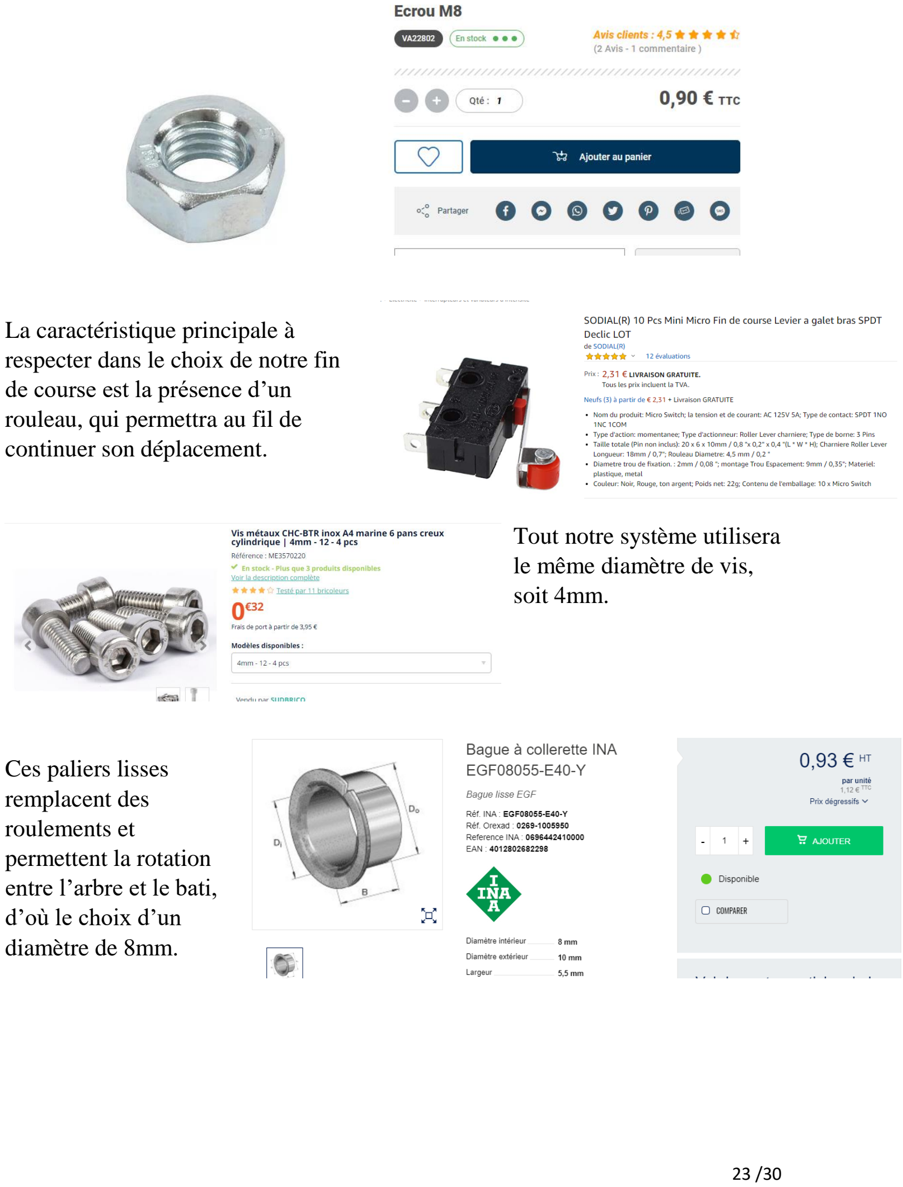
[picture p247: page 23]

23 /30

La caractéristique principale à respecter dans le choix de notre fin de course est la présence d’un rouleau, qui permettra au fil de continuer son déplacement.

Tout notre système utilisera le même diamètre de vis,
soit 4mm.

Ces paliers lisses
remplacent des
roulements et
permettent la rotation
entre l’arbre et le bati,
d’où le choix d’un
diamètre de 8mm.

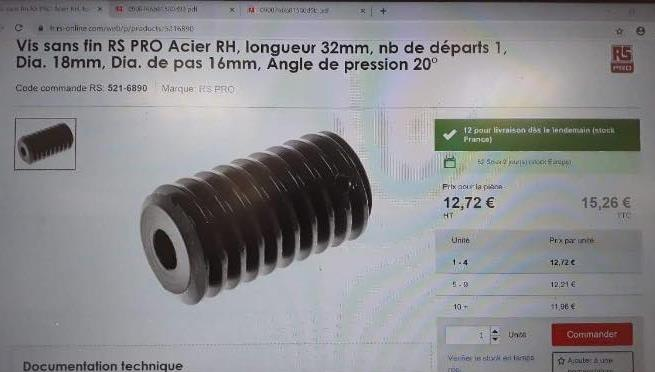
[picture p248: figure]

24 /30

Ces plaques de PET seront reliées les unes autres par des équerres, elles-mêmes fixées par des vis-écrous, afin de former notre protection du système.

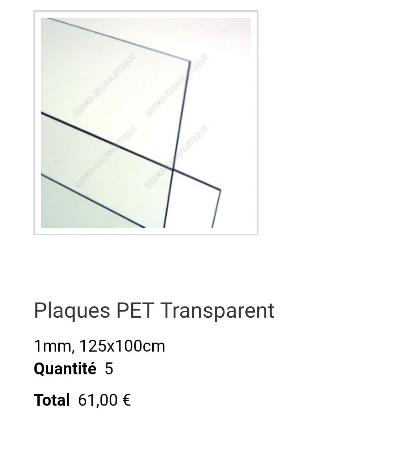
[picture p249: figure]

Notre choix de vis sans fin s’est porté sur ce modèle pour la valeur de son pas.

L’ECAM Lyon met également à notre disposition toutes les machines nécessaires à la fabrication de nos produits :

- Découpe laser.
- Tour.
- Fraise.
- Imprimantes 3D.

Certaines pièces du système sont à usiner notamment le support en forme de L dans lequel nous devons intégrer un rail pour le baladeur. Également, la pièce de guidage sera à usiner pour laquelle il faudra penser au matériau. En effet cette pièce devra être résistante à la température dans le cas où le ventilateur à la sortie de l’extrudeuse n’est pas assez efficace. Le matériau qui semble le plus approprié est le polymère-céramique.

En considérant que la vitesse de rotation de notre système de manière globale n’est pas très élevée, nous avons décidé de réaliser la liaison roue-conique (R22-R21) en impression 3D.

Les cônes qui permettent le blocage en rotation par frottement, seront réalisés en impression 3D, car les diamètres recherchés ne sont pas disponibles dans le milieu industriel.

25 /30

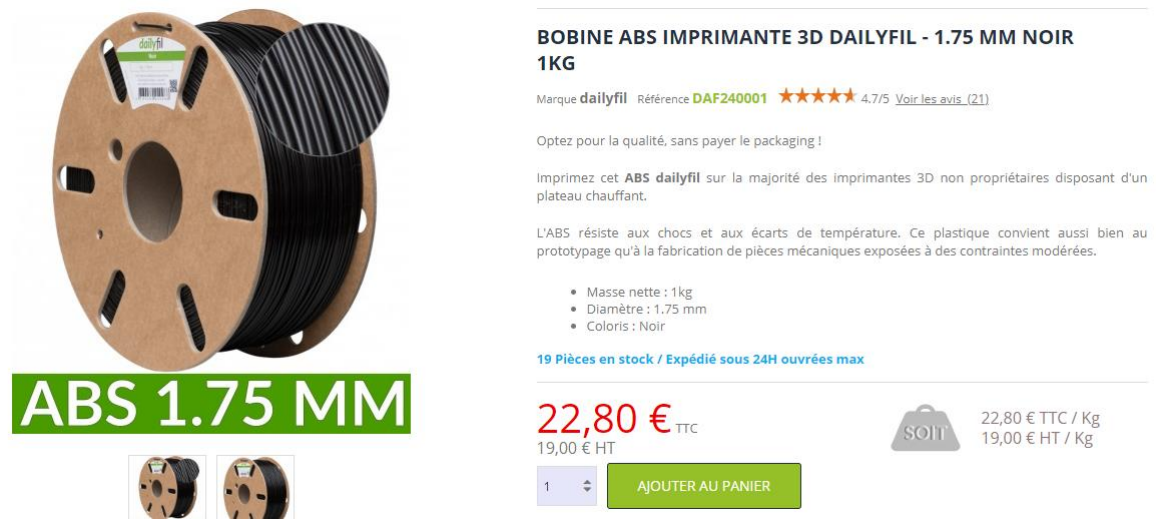
[picture p250: figure]

Afin d’imprimer ces
pièces, on aura besoin
d’une importante
quantité de fil à
imprimante 3D si
l’école n’en met pas à
notre disposition.

D’autres pièces à usiner ? Quelles techniques d’usinage ? MIP ? Machines ? Outils ?

b. Sous-traitance éventuelle

Quelque chose de non réalisable à l’ECAM (soudage par exemple) ? Achat des pièces sur d’autres sites ?

26 /30

IV. Conclusion

Dans l’appel d’offre lancée par l’école, la bobineuse ne devait pas dépasser un certain coût fixé, soit 750 euros. Ci-dessous, vous trouverez un récapitulatif des pièces que nous devrons acheter sur le site Radio Spare.

Pièces | Prix(euros)
Courroie synchrone | 2,40
Poulie R12 | 8,29
Poulie R11 | 22,45
Tige filetée | 0,89
Ecrou (x4) | 3,6
Fin de course (lot de 10) | 2,31
Fil à imprimante 3D | 22,80
Vis 4mm (x4) | 1,28
Bague à colerette(x2) | 1,86
Plaque de PET | 61
Roue vis sans fin(x2) | 25,44
Résistance (x12) | 3
Total | 135,32

Le prix de notre bobineuse est largement inférieur à 750 euros ce qui nous laisse de la marge pour tout autre achat. Ainsi la fonction FC2-1 est respectée.

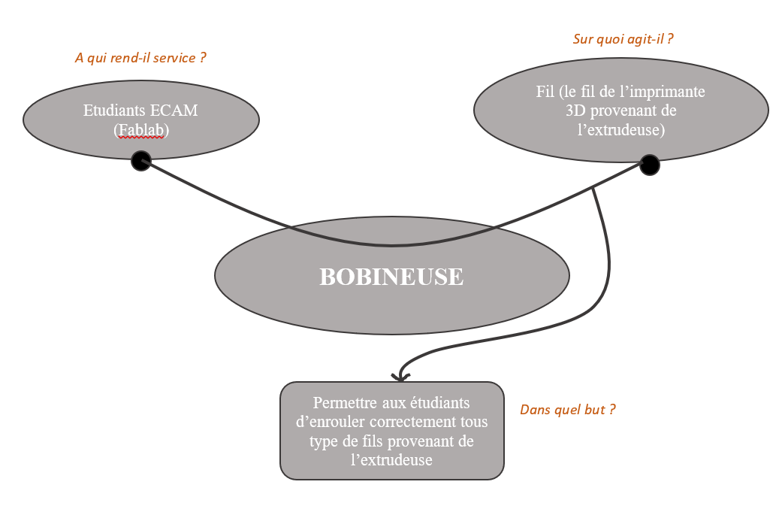
[picture p251: figure]

27 /30

V. Annexes
a. Annexe 1a : Diagramme de bête à cornes

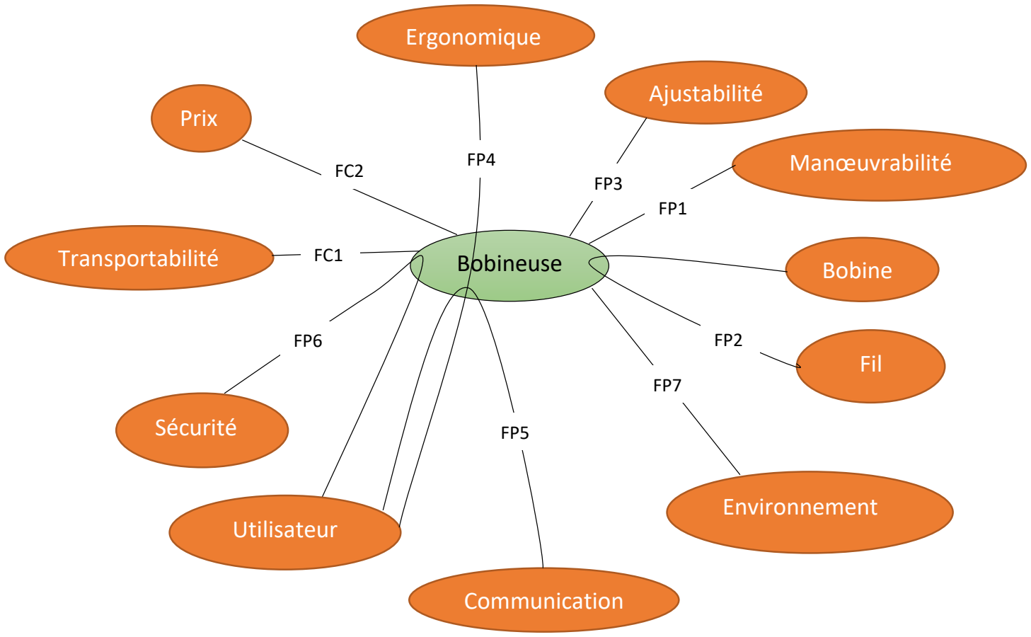
[picture p252: figure]
Bobineuse; Transportabilité; Ajustabilité; Sécurité; Prix; Fil; Manœuvrabilité; Environnement; Ergonomique; Utilisateur; Communication; Bobine

28 /30

b. Annexe 1B : Diagramme pieuvre

Se référer au CDCF pour les noms des différentes fonctions.

29 /30

c. Annexe 1C : Q.Q.O.Q.C.P.C

Pour exprimer clairement le besoin d‘un objet technique, il faut répondre aux questions suivantes :

✓ | Quoi ?
| ❖ De quel besoin s'agit-il ?

Bobineuse.

✓ | Qui ?
| ❖ Quelles sont les personnes concernées par ce besoin ?
| Etudiants, personnel ECAM, dans un probable futur : industriels.
✓ | Où ?
| ❖ À quels endroits ?

Dans les locaux de l’ECAM Lyon : FabLab.

| ❖ Dans quelles conditions ce besoin est ressenti ?

Réduire les coûts liés à l’augmentation conséquente de l’utilisation des imprimantes 3D. Suite logique après la fabrication d’une extrudeuse. Pédagogique.
Environnementale : réduire les déchets = réutilisation des déchets plastiques de l’ECAM pour produire du fil.
✓ | Quand ?
| ❖ À quels moments ?

En ECAM 3 (Durée : 1 an)

| ❖ À quelle époque est exprimé ce besoin ?
| Actuel (2019/2020), à la suite de la création du FabLab.
✓ | Comment ?
| ❖ Sous quelles formes ?

CAO, prototypages rapides et dossier de conception.

| ❖ Dans quels cas est ressenti le besoin ?

Inexistant actuellement.

✓ | Pourquoi ?
| ❖ Quelles sont les raisons qui ont fait apparaître ce besoin ?
| Augmentation spectaculaire de l’utilisation des imprimantes 3D.
✓ | Combien ?

30 /30

❖ Combien de personnes sont concernées par ce besoin ?

Etudiants, personnel ECAM.

### VI. Conception et dessin

Voir feuille A4 jointes au dossier.
