RolandThsive/3D-printer-Plastic-Recycler/2020-05-30 Données annexes (André ERNESTO)/2019-12-06 Rapports de conception/Projet Bobineuse - Groupe H1.pdf

Page 1 sur 44; Enseignant tuteur :; André ERNESTO; Groupe H1 :; TP Conception : ECAM3 A&M; Année 2019/2020

Dossier de Conception : Bobineuse

Projet de Conception ECAM3 : Bobineuse | Année 2019 / 2020

Page 2 sur 44

Sommaire :

Page 3 sur 44

Page 4 sur 44

I- Présentation de l’appel d’offre

Contexte

L’équipe de projet H1 a reçu une appel d’offres de la fondation ECAM de Lyon, au travers de son commanditaire M. ERNESTO, afin de concevoir et fabriquer une bobineuse capable d’enrouler un fil polymère autour de bobines. Cette bobineuse devra fonctionner en complément d’une extrudeuse (qui produira un fil à partir de granulés en polymère) réalisée précédemment.

Le groupe H1 est composée de 8 étudiants d’ECAM 3 A&M de l’Entreprise H : Groupe H1
Motors, | travaillant | ensemble | dans | le | cadre | de | la | matière | conception.
Cette entreprise est spécialisée dans la conception mécanique et l’automatisation de process. Elle s'inscrit dans la lignée d’ingénieurs formée depuis plus de 100 ans à L’ECAM Lyon. L’établissement bénéficie d'une grande expérience et renommée auprès des entreprises Lyonnaise.

De la réponse d'appels d'offres à la livraison des produits, tout est traité par le Groupe H1. Innovant par leur jeunesse, performant par leurs valeurs, savoir être et connaissances générales et techniques, par leur formation professionnelle, les membres du groupe H1 s'adaptent à tous vos besoins pour trouver la solution qui vous convient. Forts de la confiance qui leur est accordé par les entreprises, ils représentent le futur. En les choisissant les entreprises choisissent la sécurité, l'économie, l'écologie et la technologie.

Réponse à l’appel d’offre

Pour répondre à l’appel d’offres de la fondation ECAM Lyon, nous concevrons une machine automatisée pouvant enrouler du fil polymère (PLA) autour de bobines existantes de différentes tailles. Nous nous assurerons que cette machine puisse non seulement fonctionner en complément d’une extrudeuse, mais aussi indépendamment de cette dernière. Elle sera évidemment facile à transporter et à utiliser, et devra fonctionner dans un environnement extérieur afin de servir de support pédagogique auprès des différents publics auxquels l’établissement peut s’adresser.
Dans le cadre du développement de travaux pratiques s’articulant autour de projets de mécanique et de CAO, ainsi que l’augmentation de l’utilisation des imprimantes 3D de l’ECAM, il est nécessaire que la bobineuse puisse stocker un certain nombre de bobines afin d’alimenter leurs différentes imprimantes. Plusieurs personnes doivent pouvoir accéder à cette machine. En effet, que ce soit le personnel de la fondation, les étudiants ou chercheurs dans les pôles de l’ECAM, ils doivent tous pouvoir avoir accès à la bobineuse. Elle devra alors être facile d’accès et d’utilisation. Des notices seront fournies pour soutenir et aider les personnes devant utiliser la bobineuse. Enfin l’aspect sécuritaire étant un des critères primordiaux de l’entreprise, nous veillerons à cartériser la bobineuse, pour le bien de ses utilisateurs.

Page 5 sur 44

II- Enoncé fonctionnel du besoin

1) Enoncé et caractérisation des fonctions de service et des contraintes

Le système doit :

Page 6 sur 44

Fonctions principales et contraintes | Désignationdela fonction | Critères | Niveau | Flexibilité | Commentaires
FP1 | Enrouler le fil
FP1.1 | Gérer la Vitesse d’enroulement | Vitesse linéaire constante | 15mm/s Max (±1 mm/s) | 1 | La vitesse d’enroulement va dépendre du rayon du fil et de la vitesse de sortie de fil de l’extrudeuse
FP1.2 | Tendre le fil | Tension constante | Oui | 2 | Adapter la vitesse de bobinage correspondant à la valeur de tension du fil
FP1.3 | Maintenir la tension du fil | Gestion de la force et des angles d’enroulement | xx N | 2 | Assurer la conservation du diamètre du fil et sa continuité
FP1.4 | Répartir de façon ordonnée le fil sur la bobine | Gestion du déplacement de la bobine | xx mm/s | 3 | Eviter l’emmêlement du fil pour faciliter son déroulement
FP1.5 | Assurer l’enroulement du fil | Adhérence du fil | | 2 | Choix de matériaux adapter pour éviter le risque de glissement
FP2 | Couper le fil
FP2.1 | Couper à une longueur prédéfinie | Tolérance de longueur | ± 5mm | 1 | Permet d’assurer le poids maximum de la bobine
FP2.2 | Détecter une bobine remplie | Capteur de détection du diamètre de la bobine | 750g | 1 | Valeur connue dépendant du diamètre du fil et de son type
FP2.2 | Couper différents type de fil | Force de cisaillement de l’ABS et PLA et adhérence du système de coupe | 110/293N | 2 | Eviter que le fil ne colle au système de coupe
FP2.4 | Être peu encombrant | Dimension maximum | 40x40 mm | 4
FC1 | Résister à son environnement
FC1.1 | Être étanche | Système de protection (parois…) | IP1 | 3 | Résister au risque de projection d’eau ou de pluie faible

Page 7 sur 44

FC1.2 | Résister à la température du fil | Choix des matériaux (adhérence et température de fusion) | Tf=190°C PLA Tf=240°C ABS | 3 | Les températures de fusion des matériaux devront être inférieur à 120°C (le fil aura déjà refroidit)
FC1.3 | Être utilisable dehors | Système de protection au vent et aux corps extérieur | IP1 | 5 | Protection à la poussière et autres type d’impureté
FC2 | Être transportable
FC2.1 | Être facilement déplaçable | Poids maximum | 40 Kg maximum | 2
FC2.2 | Être facile de préhension | Géométrie simple | Oui | 3 | Forme cubique
FC2.3 | Ne pas dépasser un volume maximum | Encombrement | 1000x100x900m m | 2 | Correspond aux dimensions des portes de l’ECAM
FC2.4 | Être démontable | Démontable | 5 min | 3
FC2.5 | Résister aux chocs et vibration | Résistant au vibrations et chocs liés aux transport | Oui | 4
FC3 | Être facile de maintenance
FC3.1 | Être facilement démontable | Démontable | 5 min | 2 | Montage du système réversible
FC3.2 | Permettre une réparation manuelle en cas de panne | Choix de composant standard | Oui | 2
FC4 | Avoir plusieurs mode de fonctionnement
FC4.1 | S’adapter à l’extrude | Système de fixation à l’extrudeuse démontable | Oui | 1
FC4.2 | Fonctionner seul | Embobiner du fil seul | Oui | 2 | Châssis différent de celui de l’extrudeuse
FC5 | Respecter le budget
FC5.1 | Respecter le budget | Coût | 750€ max | 1

Page 8 sur 44

FC6 | Communiquer avec l’opérateur
FC6.1 | Informer l’opérateur de couper le fil | Présence de voyants | Voyant | 1
FC6.2 | Indiquer des disfonctionnement (pannes) | Présence de capteurs | Voyants et alarmes | 1
FC6.3 | Pouvoir régler l’épaisseur du fil | Automate commun avec l’extrudeuse | IHM/clavier | 3 | Permet de savoir à quelle longueur couper le fil
FC6.4 | Pouvoir régler le diamètre de bobine | Automate commun avec l’extrudeuse | IHM/clavier | 3 | Permet de savoir à quelle hauteur la bobine est remplie
FC7 | Être facile d’utilisation
FC7.1 | Être facilement arrêtable | Présence de bouton d’arrêt d’urgence et stop | Boutons stop et d’arrêt d’urgence | 2
FC7.2 | Nécessiter un seul opérateur | Nécessite un seul opérateur | Oui | 2
FC7.3 | Permettre de resouder le fil en cas de coupe | Température de fusion | Tf=190°C PLA Tf=240°C ABS | 1
FC8 | Respecter les normes de sécurités
FC8.1 | Être cartérisé | Cartériser tous les moteurs et autres zones à risque | Oui | 1 | Choisir des matériaux transparent afin de répondre à FC9
FC8.2 | Avoir un géométrie simple | Limiter les angles vifs, et surfaces coupantes | Oui | 1
FC8.3 | Indiquer les dysfonctionnements | Présence de voyants | Oui | 1
FC8.4 | S’arrêter en cas de panne | Boutons d’arrêt d’urgence et sécurités | Oui | 1
FC8.5 | Respecter l’environnement | Matériaux recyclable | Oui | 2 | Choisir des matériaux respectant les normes d’usage et environnemental

Page 9 sur 44

FC9 | Être pédagogique
FC9.1 | Pouvoir être utilisé comme support de cours | Être pédagogique | Matériaux transparent | 2
FC9.2 | Être simple d’utilisation | Emploie de notices de fonctionnement | Notice de fonctionnement , étiquettes… | 2
FC9.3 | Avoir un bon design | Être attrayant | Couleurs, formes, matériaux… | 2
FC10 | Être alimenté
FC10.1 | Pouvoir convertir l’énergie électrique | Convertir AC/DC | De 230V en 12V | 1 | Correspondant à la tension du Fablab
FC10.2 | Minimiser les pertes | Limiter les frottements, les chocs… | Choix des matériaux, lubrification… | 2
FC11 | Être automatisable
FC11.1 | Vérifier le bon fonctionnement du système | Contrôle du processus | Capteurs | 4
FC11.2 | Pouvoir avoir un automate commun avec l’extrudeuse | Automatisation d’une partie du fonctionnement | Oui | 4

Page 10 sur 44

2) Cycle d’utilisation du produit et identification de son environnement
| Utilisateur du produit | Equipements | Matière
Fabrication | Elève ECAM 3 A&M | Machine de production du Fablab | -
Livraison | M. ERNESTO | - | -
Utilisation | Fondation ECAM de Lyon/ Professeurs | - | Fils de PLA / ABS
Recyclage | - | Adapté aux matériaux et technologies utilisés aujourd’hui | Adapté aux matériaux et technologies utilisés

Analyse de l’existant :

Bobineuse Bricolage TSF

Description :


Cette machine est conçue pour embobiner des fils allant d’un diamètre de 0,5/10 à 1mm. Un potentiomètre est utilisé pour faire varier la vitesse de rotation de la bobine. La répartition du fil sur la bobine s’effectue grâce à un levier qui assure la fonction de débrayage. La tension du fil se fait à l’aide de pince réglable et/ou de galets caoutchoutés suivant le diamètre du fil.


Page 11 sur 44

Lien : http://hubert.frappier.free.fr/radio/brico/bobineuse/P-bobineuse.html

Prix : inconnu ?

Bobineuse molle de bobine de fil à coudre


Description :

Cette machine est conçue pour embobiner du fil de coton sur des bobines molle de diamètre 250 mm maximum. Un système de came cylindrique est utilisé pour la répartition du fil sur la bobine afin d’éviter l’emmêlement de ce dernier. Le process est entièrement automatisé et fonctionne avec 12 bobine chacune motorisée en même temps.

Liens : https://french.alibaba.com/product-detail/sewing-thread-bobbin-soft-winding-machine-before-yarn-dyeing-60521346507.html (https://french.alibaba.com/product-detail/sewing-thread-bobbin-soft-winding-machine-before-yarn-dyeing-60521346507.html)

Prix : 28 000$

TwinTAPE 200XL de Starlinger company

Page 12 sur 44

Description :

Cette machine est conçue pour embobiner des fils de PP/HDPE de 1.8 à 6mm de diamètre. Chaque axe accueillant une bobine de diamètre allant jusqu’à 35mm de diamètre est motoriser, est la vitesse de rotation est gérée par un variateur de fréquence. Un système de galet pouvant se déplacer, permet de gérer le glissement du fil et les à-coups lors de l’enroulement. Le fil est guidé tout au long du processus à travers des orifices pour éviter tout emmêlement.

Liens : https://www.starlinger.com/en/packaging/extrusion-winding/twintape/

Prix : Non indiqué

Machine de bobinage de fils textiles


Description :

Cette machine embobine du fil textile rigide ou élastique de grande largeur (60mm). Un variateur de fréquence de fréquence est utilisé pour faire varier la vitesse de rotation de la bobine et un guide fil standard se déplace transversalement et en hauteur pour répartir le fil sur la bobine. Le comptage des mètres ainsi que tous les autres systèmes sont automatisés.

Liens :

https://www.rius-comatex.com/pages/fr/machines/enroulage/enrouleuses.php?id=367&lang=FR

Prix : Non indiqué


Page 13 sur 44

Bobinoir croisé


Description :

Cette machine est conçue pour bobiner du fil de laine de façon croisée. Un système de came cylindrique assure la répartition du fil sur la bobine ainsi que le motif croisé. Un mécanisme de va est vient est unique suivant la largeur du ruban et la largeur de la bobine. De plus un dispositif de tension du fil assure le maintien de ce dernier sur la bobine et limite les risques de glissement.

Liens : https://www.rius-comatex.com/pages/fr/machines/enroulage/bobinoir-croise.php?id=358&lang=FR

Prix : Non indiqué

Chariot manipulateur de bobine


Page 14 sur 44

Description :

Cette machine permet de déplacer et retourner à 90° des bobines. Son mandrin extensible lui permet de s’adapter aux différents alésages de bobines à manipuler. Il assure le maintien en position d’une bobine afin que celle-ci puisse être débobinée. Un vérin hydraulique lui permet de soulever des charges jusqu’à 600Kg.

Liens : http://www.zoneindustrie.com/Produit/Chariot-manipulateur-de-bobines-19704.html (http://www.zoneindustrie.com/Produit/Chariot-manipulateur-de-bobines-19704.html)

Prix : Non indiqué

Page 15 sur 44

III- Choix techniques et technologiques

Système de notation :

+++ : Très bon | - - - : Très mauvais
++ : Bon | - - : Mauvais
+ : Correct | - : Moyen

Système de découpe du fil

Une fois que la bobine a atteint son poids maximum, le fil doit être coupé afin de pouvoir commencer à bobiner une nouvelle bobine.

Voici les différents systèmes auxquels nous avons pensé :

- Système de type guillotine : Une lame est actionnée en translation et viens couper le fil sur une plaque sur lequel est en appui.
- Système de balayage circulaire : Une lame circulaire est fixée en sortie de l’extrudeuse et tourne pour couper le fil.
- Système à lame excentrée : Une lame est en liaison pivot avec la plaque sur laquelle le fil glisse. L’opérateur n’a alors qu’à faire descendre la lame pour couper le fil.
- Système de fil chaud : un fil est chauffé avec le courant électrique et un mouvement de translation est réalisé pour couper le fil.
| Guillotine | Balayage circulaire | Lame excentrée | Fil chaud
Efficacité | +++ | ++ | +++ | +++
Adaptabilité | +++ | - - | +++ | -
Coût | +++ | ++ | +++ | -
Encombrement | ++ | +++ | +++ | +++
Sécurité | ++ | ++ | ++ | -

Le système de lame excentrée est choisi car il nécessite un encombrement inférieur au système de guillotine. De plus il nécessite moins de pièce est facile à mettre en œuvre. Afin d’améliorer la découpe du fil et sont maintient en position une fois coupé et assurer le maintien en tension du fil enroulé dans la bobine, un système de sauterelle de serrage sera fixé sur le bâti.

Page 16 sur 44

Système de transport du fil

Le fil doit être récupéré en sortie de l’extrudeuse et être transporté jusqu’à la bobine afin d’y être enroulé. De plus le système de transport doit prendre en compte la mise en place du système de coupe du fil, choisi précédemment.

Voici les différents systèmes auxquels nous avons pensé :

- Système de convoyeur : par gravité, le fil tombe sur un convoyeur situé à une hauteur inférieure de la sortie de l’extrudeuse. La phase de découpe s’effectuerai sur le convoyeur ( risque d’usure et de détérioration). Deux types de convoyeurs sont alors possible, un convoyeur à courroie ou un convoyeur à rouleaux.
- Système de galets : des galets seraient positionnés de la sortie de l’extrudeuse jusqu’à la bobine, avec un passage sur une planche afin de procéder à la coupe du fil. Afin de pourvoir s’adapter aux différents diamètres de fils, des galets en caoutchouc seront utilisé pour ne pas déformer le fil.
| Convoyeur | Galets
Efficacité | ++ | ++
Adaptabilité | + | ++
Coût | - - | ++
Encombrement | - | ++
Déformation du fil | ++ | +
Frottement | - | +
Glissement | + | - -

La solution des galets est choisie puisqu’elle permet de limiter l’encombrement du système et est plus facilement adaptable avec le système de coupe du fil. Deux galets seront positionnés en sortie de l’extrudeuse afin d’exercer une pression sur le fil et ainsi de limiter tout risque de glissement du fil sur le galet inférieur. De plus la vitesse de rotation devant être constante, chaque galet sera relié à un unique moteur dans le mouvement de rotation sera transmis par un système de poulies/courroies qui est plus avantageux (prix, bruit, rendement, poids…) qu’un système de chaine/pignons et que nous dimensionnerons par la suite:

Page 17 sur 44

Solution des pignons et chaînes :

Avantages | Inconvénients
Résistant à des milieux difficiles (température) | Bruit
Longévité | Nécessite beaucoup d’énergie d’entrainement (frottement/inertie)
Rendement élevé | Poids
Puissance de transmission importante | Nécessite du graissage
| S’utilise pour des vitesses réduite
| Prix

Solution des poulies et courroie :

Avantages | Inconvénients
Adapté pour réduire les vibrations | Rapport de réduction limité sur la transmission de puissance
Coût faible | Durée de vie plus faible
Rendement élevé ( 98%) | Résiste moins à la température

Nécessite peu d’entretien

Nécessite une faible puissance pour entraîner les éléments

Léger

Système de rotation de la bobine et répartition du fil

Pour être correctement utilisé et être la plus rentable possible, le fil être disposé de façon ordonnée sur la bobine. Pour cela un chariot ou un mouvement de translation de la bobine tout entière est nécessaire. Ainsi le fil sera disposé de façon repartie horizontalement.

Cette partie a été travaillée de façon conjointe avec la partie de répartition du fil, puisque la deuxième partie sont dépendante l’une de l’autre.


Page 18 sur 44

Nous avions plusieurs choix :

- Augmenter la vitesse du fil de façon linéaire avec la bobine (à cause de la relation : v = ω × r, avec r augmentant au fur et à mesure qu’une rangée de fil est déposée)
- Garder la vitesse constante. Cela étant une question importante pour garder le fil dans un état optimale.

Voici les différents systèmes auxquels nous avons pensé :

- Système de bielle et pivot glissant : Pour cette solution la bobine entière se déplace, cela évite l’utilisation de chariot et au fil de se tordre. Ainsi, le système de bielle est directement relié au pivot glissant de la bobine qui lui octroie la translation, le moteur étant placé sur la partie de la pivot ne tournant pas et relié par un réducteur au système pivotant.

Schéma du système pivot glissant

Pour l’incrémentation de la vitesse, un système de poussoir relié à un potentiomètre par le biais d’une roue à dent rétractable viendrait augmenter la vitesse du moteur grâce aux relation électrique liant la vitesse et le courant. Ainsi à chaque fois que la bobine serait en position extrême, le poussoir solidaire de la bobine viendrait tirer la roue et donc changer la valeur de résistance.


Schéma du mécanisme de dents rétractables

Page 19 sur 44

- Système de motorisation sur cylindre avec glissement :

(Les deux systèmes utilisent la même méthode de motorisation de la bobine et un chariot pour répartir le fil, car la bobine cette fois-ci n’est animée que par une rotation). Ces solutions privilégient le fait de garder la vitesse de la bobine constante, pour ce faire la bobine est placé sur deux cylindres (un motorisé l’autre libre). La vitesse de ce galet est la même que celui situé en sortie d’extrudeuse puisqu’ils sont entraînés par un système de poulies/courroie comme expliqué précédemment. La bobine est donc entraînée à la vitesse constante (celle du fil), mais cette dernière aura tendance à accélérer à cause de l’effet indiqué plus tôt. Pour que la vitesse du système reste constante il suffit de faire glisser la bobine sur le cylindre.

Vis de trancannage :
Une fois cette motorisation réalisée il faut guider le fil, pour cela il est possible de relier un chariot avec une vis de trancannage, qui permet de mettre en œuvre la translation nécessaire sur la largeur de la bobine.


Figure 1 Vis de trancannage (www.pinterest.com)

Came cylindrique :
Il s’agit du même principe que la vis de trancannage cependant avec une seule rainure guide, il faut simplement faire attention aux frottements et à la durabilité de la pièce ( cela fera partie d’une étude ultérieurement).


Figure 2 Came cylindrique (http://jeanclaude.deponte.free.fr)

Page 20 sur 44

Transmission du mouvement de rotation :

| Transmission par cylindre | Transmission par dent
Efficacité | ++ | +++
Adaptabilité | +++ | +
Coût | +++ | +++
Changement de vitesse | +++ | - - -
Facilité de mise en œuvre | ++ | - - -

Sur un grand nombre de point, la transmission par contact direct est plus intéressante, mais son avantage le plus grand est le changement de vitesse. En effet en partant sur cette solution nous n’avons plus ce caractère à prendre en compte grâce au glissement. Effectivement devoir changer de vitesse de façon mécanique et non informatique est très dur à mettre en œuvre (Cf. > roue denté), ainsi éviter ce désagréments est grandement préférable, c’est donc l’argument principal de son choix.

Répartition du fil

| Translation de la bobine | Bobine « fixe »
Vis de trancannage | Came cylindrique
Facilité de mise en œuvre | - - - | ++ | ++
Détérioration du fil | +++ | + | +
Coût | + | - - | +++
Encombrement | - - - | +++ | +++
Frottement | - | - | - -
Nombre de pièces utilisées | - - | ++ | ++

Pour ce système là nous avons préféré un système à bobine fixe car la mise en place du procédé est bien plus simple, en effet réalisé une pivot glissant s’avère assez complexe et venir faire translater la bobine prends bien plus de place que simplement un chariot.

Quant à la vis de trancannage nous nous sommes rendu compte que bien que son fonctionnement soit très intéressant, elle est assez difficile à réaliser avec nos moyens comparés à une came cylindrique qui est principalement utilisée dans l’industrie. Ainsi il aurait fallu acheter cet élément technologique qui peut être assez onéreux, ainsi cela nous a

Page 21 sur 44

conduit à privilégier la came. L’un des seuls défauts de la came cylindrique étant les frottements présents lors de son fonctionnement, ainsi chercher à les réduire au maximum est un des objectifs à atteindre.

Cette solution sera donc logiquement animée par un second moteur et donc un réducteur de taille conforme et la came n’aura qu’une rainure.

Combinaison des solutions

De ces deux systèmes nous pouvons en conclure que la combinaison la plus intéressante est :

- Transmission par cylindre
- Répartition du fil grâce à un chariot guidé par came cylindrique

Ainsi cette combinaison, outre les avantages déjà cités nous permet de réaliser les fonctions demandées avec premièrement moins de pièces, des pièces plus simples à fabriqués et une utilisation très simple car il suffit de simplement de poser la bobine et de placé le fil dessus.

Support de bobine

La bobineuse devant également pouvoir servir à réembobiner du fil ou à souder plusieurs bobines de fils, une partie totalement autonome du système peut y est rajouté afin d’y remplir ce rôle. Ce système reprend le principe du bras manipulateur de robot. Un éperon qui servira à fixer la bobine, peut translater verticalement grâce à un trou oblong dans le bâti afin d’être compatible avec des bobines de différents diamètres. Un système d’écrou contre écrou assura le maintien à une certaine hauteur de l’éperon correspondant à son utilisation. Une fois la bobine en place, l’utilisateur n’aura qu’à dérouler le fil pour le faire passer entre les galets normalement situés en sortie d’extrudeuse, et la sauterelle assurera le rôle de maintien en place du fil lors des opération de soudage entre deux bobines. (cf dessin)

Stockage des bobines

Notre système sera mis en place sur un chariot à roulette à 2 plateaux, afin de pouvoir y stocker des bobines vides et des bobines à souder. Cet élément n’étant pas réalisable au fablab (nécessité d’une structure soudée), il sera acheté. Cependant, le système sera utilisable sur d’autres support (tables…) puisqu’il ne sera pas fixe sur le chariot. Cela permettra un emploie plus facile de la bobineuse et une non obligation d’achat du chariot.


Page 22 sur 44

IV- Notice de dimensionnement

1) Système de transport
a) Choix du moteur

Pour le transport du fil, nous avons choisis le système des galets. Afin de limiter le nombre de moteur un système de poulies/courroie transmettra le mouvement de rotation au second galet qui assure la rotation de la bobine pour enrouler le fil. Le système possède donc deux moteurs ( un pour le galet moteur et le second pour la came cylindrique). Nous avons cherché sur le site RS un moteur à courant continu ayant une vitesse de rotation la plus faible possible, un diamètre d’arbre suffisant afin de pouvoir clavetter ou faire un méplat dessus, une tension d’alimentation de 24V et enfin le prix le plus faible possible pour respecter le budget. Nous avons finalement opté pour le moteur suivant dont voici les caractéristiques techniques :

Afin de faciliter le système et les calculs, nous choisirons le même moteur pour la came cylindrique mais avec un réducteur adapté à la vitesse nécessaire au niveau de la came.

b) Dimensionnement du système poulies/courroie

Une fois le moteur choisi nous cherché à déterminer le rapport de réduction nécessaire afin de s’adapter à la vitesse linéaire de sortie du fil de l’extrudeuse qui est de 15mm/s. Nous avons cherché sur le site RS des galets en caoutchouc, pour ne pas déformer le fil avec un alésage proche du diamètre de l’axe du moteur

Voici le galet que nous avons choisi pour le système, il a un diamètre extérieur de 48mm et un alésage de 6,5mm et est recouvert de 2mm de caoutchouc :


A partir de son diamètre extérieur nous pouvons calculer la vitesse linéaire du galet :

Vgalet = ω ∗ R = 3600 ∗ π/30 ∗ 24 = 9048 mm/s

On en déduit le rapport de réduction au niveau du galet :

Rgalet =

Vfil
Vgalet =

15
9048 = 1,657 ∗ 10e − 3

Cela équivaut à diminuer par 603 la vitesse de rotation du moteur.

Afin de sélectionner notre courroie, nous avions besoin du facteur de service de l’emploie de cette dernière. Nous l’avons déterminée à l’aide du Manuel de détermination Courroies synchrones industrielles de l’entreprise GATES. Nous avons un moteur à courant continu utilisé dans le cadre d’un convoyeur, cela nous donne un facteur de service de 1,2 :

Page 23 sur 44

Page 24 sur 44

En rentrant toutes les informations dans le logiciel DesignFlexPro et en sélectionnant uniquement les courroies de type trapézoïdales, nous avons obtenu les résultats suivants :

Nous avons sélectionné des courroies de type trapézoïdale et plus particulière de type Poly-V, car elles présentent de nombreux avantages :

Dimensions de la bobine

Page 25 sur 44

A cause de l’entraxe important entre les deux galets qui est nécessaire pour le système de coupe et de répartition du fil, le site RS de propose aucune courroie aux dimensions nécessaire ou même proche des courroies dimensionnées. Cependant la première courroie est disponible sur le site 123Courroies :

Nous optons donc pour une courroie trapézoïdale de type Poly-V à 9 stries et de longueur 558mm et dont les données techniques et dimensions des poulies sont données en annexe 5.

2) Système de came cylindrique
- Dans un premier temps nous cherchons à déterminer la vitesse linéaire du chariot ( dispositif qui guide le fil sur la came) :

Le périmètre intérieur de la bobine est : Pbobine = 2πR bobine = 2 ∗ π ∗

Le temps nécessaire pour enrouler une largeur de fil: t1 tour bobine= Pbobine /Vfil = 172,78/15 =11,52s.

Sur une rangée il y a : Nbfil = 41/2.85 = 14

Il faut donc t1 rangée pour remplir une rangée : t1 rangée = t1 tour × 14 = 161,26 s.

Donc V déplacement chariot = Largeur bobine / t1 rangée = 41 / 161,62 = 0,25 mm/s.


Page 26 sur 44

De plus on sait que la came fait ½ en 161,26s, il lui faut donc 322,52s pour faire un tour complet, on en déduit donc la vitesse de rotation de la came ( qui est calculé sur le diamètre le plus petit de la bobine) : ω =

1
322,52

∗ 60 = 0,186 tr/min

Le rapport de réduction entre le moteur et la came est: Rcame = 0,186/3600 = 5,17x10-5

Il faut donc réduire la vitesse de 19354 fois. Ce résultat est tout à fait cohérent puisqu’il correspond environ à 28 fois le rapport de réduction du galet, or sur la came nous répartissons 28 diamètre de fils. Ainsi pour facilité le dimensionnement des réducteurs, nous réutiliserons le réducteur du galet, auxquels on ajoutera en série un réducteur de 28.

- Nous allons maintenant calculer la longueur et l’angle de la rainure.

D’après le “ théorème de Pythagore “ , on obtient la longueur de la rainure sur 1 demi-cylindre qui est =√ 41² + 62,8² = 75 mm

L’angle ɸ est d’alors : tan(ɸ) = 41 / 62,8. Soit ɸ = arctan (41/62,8) = 33,14°.

On a alors, une longueur de rainure sur tout le cylindre de 75 mm et de largeur 11 mm.

- Le frottement étant un des désavantages de la came cylindrique, nous allons étudier deux solutions pour déterminer laquelle répond au mieux à cette problématique.

40 mm

Page 27 sur 44

Cas de la bille :

de frottement (cf schéma).; V déplacement; phi

On a des appuis ponctuels entre la bille et la rainure. On trace alors les cônes de frottement en A et B. On sait que la force tangentielle est égale au produit du coefficient de frottement et de la force normale. Or la force tangentielle s’oppose à la vitesse de déplacement. De plus, on a glissement en A et B; on en déduit alors que la force résultante à B est dans la partie droite et tangent au cône

De plus, on a le poids de la bille qui est de 0,001kg soit une action P=9,8*10⁻³ N. On réalise donc un produit en croix pour connaître les forces en A et B.

On a TA = 0,00612 N et NA = 0,03 N. | Et TB = 0,0049 N et NB = 0,0196 N.

Or μA = TA / NA et μB = TB / NB.

On a donc μA = 0,20 et μB = 0,25.

Cas d’un roulement à aiguilles
| On a le poids de l’aiguille qui est de 0,003kg soit une action P=0,0294 N. On réalise donc un produit en croix pour connaître les forces en A et B.

On a TA’ = 0,0294 N et NA’ = 0,124 N.

Et TB’ = 0,02205 N et NB’ = 0,06615 N.

Or μA’ = TA / NA et μB’ = TB / NB.

On a donc μA’ = 0,23 et μB’ = 0,33.

V déplacement; phi

On obtient donc : μA < μA’et μB < μB’


Page 28 sur 44

Conclusion : On a un coefficient de frottement plus élevé sur le roulement à aiguilles, de par sa surface de contact avec la rainure qui est plus grande que la bille (contact ponctuel). De plus, le prix est plus élevé pour le roulement à aiguilles que pour celui à bille. On choisit donc la bille pour notre système.

| Roulement à aiguilles | Bille
Prix | - | +
Frottement horizontal | - | ++
Frottement vertical | ++ | +
Usure de la pièce | + | -
3) Dimensionnement des réducteurs

Comme expliqué précédemment, nous dimensionnerons deux blocs réducteurs. Un premiers de rapport 603 entre le moteur et le galet, et un second qui sera positionné en série avec un second de rapport 30 ( en prenant en compte les erreurs dû aux arrondis des calculs).

- 1er cas : Pour obtenir le premier rapport k = 1 ⁄ 603 nous faisons une combinaison de trains épicycloïdaux comme sur le schéma suivant de rapport k1, k2 et k3 :

On a également k1k2k3 =

1
603

et k1 = k2 = k3 =

1
8,44

afin de faciliter les calculs et

l’usinages des trains


Page 29 sur 44

Nous avons la formule suivante :

k =

ȠS

ȠE

=

ȠPS′′
1

= (

Z1
Z1 + Z3

) . (
Z1

′

Z1

′ + Z3

′

) . (
Z1

′′

Z1

′′ + Z3

′′) = k1k2k3

Comme les trois trains ont le même rapport de réduction, on obtient : Z1 = Z1

′ = Z1

′′ et Z3 = Z3

′ = Z3

′′

Finalement, (

Z1
Z1+Z3

) =

1
8,4

On fixe Z1 = 10 dents, on obtient alors Z3 = 75 dents

- 2

ème Cas : on veut un rapport de réduction de 30, on note k = 1 30 ⁄

Nous utiliserons le même système que précédemment mais avec seulement 2 trains.

On a la formule suivante :

k =

ȠS

ȠE

= (

Z1
Z1 + Z3

) . (
Z1

′
Z1

′ + Z3

′

) = k1k2

On impose au deux trains le même rapport de réduction : k1 = k2 =

1
5,5

On a alors Z1 = Z1

′
et Z3 = Z3

′

et finalement, (

Z1
Z1+Z3

) =

1
5,5
On fixe Z1 = 10 dents et on a Z3 = 45 dents.

Système de découpe : dimensionnement des roulements

Le système de découpe utilise deux roulements, au niveau de la lame. Ces roulements ne sont pas constamment en rotation et ne tournent à une vitesse faible. De plus nous n’avons pas de contraintes concernant les dimensions des roulements ( encombrement).

Nous choisissons des roulements à billes qui supportent les efforts radiaux, tolèrent les efforts axiaux, contrairement aux roulements à aiguilles. Ils seront montés en X.

Calcul de la tension du fil

Page 30 sur 44

Bilan des forces sur N : - Poids P=mg.

-R réaction du plan perpendiculaire au plan.

- T tension porté par le fil.

On applique le principe fondamental de la dynamique : mg+R+T=ma

On projette l’expression vectorielle sur la base polaire cylindrique.

mlφ’²=-T sur up | mlφ’’=0 sur uφ | -mg+R=0 sur ez

or φ’’=0 donc φ=constante=ω (vitesse angulaire)

donc on obtient T=mlω²

Application numérique : T=3.58 N

Calcul de glissements des galets

On applique le modèle de Coulomb sur les galets :

On sait que V = r ∗ ωbobine et que ωbobine =

Vini
r+(n−1)dfil

La loi de frottement de Coulomb relie localement les composantes normales et tangentielles de vecteur densité de force soit : f(M, 1 → 2) = FNn + Ft

Deux cas sont à envisager :

- si adhérence {

V(M, S1|S2) = 0
||ft|| ⩽ f│fN│

-si glissement {

T opposé et de même direction que V(M, S1|S2) ||ft|| = f│fN│

Avec fc, le coefficient de frottement dont la valeur dépend des caractéristiques de contact (couple de matériaux, lubrifiant, état de surface) ; valeurs communément comprises entre 0,1 et 0,6. Le vecteur densité de force ne peut pas sortir d’un cône de demi-angle au sommet φ tel que f = tan φ. Pour un contact ponctuel en M, le torseur des actions mécaniques s’écrit {T(S1 → S2)} ={
Nn + T
0

}M

-si adhérence {

V(M, S1|S2) = 0
||T|| ⩽ f│N│

Hypothèses :
-fil inextensible
-Pas de frottement
→ | → | →
→ | →

→

→

→

→

→

→ →

→

Page 31 sur 44

-si glissement {

T opposé et de même direction que V(M, S1|S2) ||T|| = f│N│

df(M, 1 → 2) = f(M, 1 → 2)ds

Dans notre cas il faut du glissement entre le galet et la bobine.

Pour le coefficient de frottement on choisit de prendre fc= 0,3.

Donc ||T||=0.3*|N|

f=N(1+0.3) et φ=arctan(f)

Le tableau des coefficients de frottement est donné en annexe 6.

Dimensionnement des goupilles

Pour réaliser la liaison complète des poulies avec les axes, nous avons opté pour du goupillage. Ces goupilles seront en en acier et nous souhaitons savoir le diamètre minimum des goupilles que nous pouvons utiliser.

On suppose que la distribution des forces extérieures et que la distribution des fores tangentielles dans la section soient réparties uniformément dans l’aire de la section de cisaillement.

Dimensionnement au cisaillement :

La détermination du diamètre d’une goupille s’effectue d’après la condition de résistance au cisaillement :

T =

V
Acis

≤ Tadmcis Et avec A

cis =

π∗db²
4

On obtient db ≥ √
4V
| π∗Tadmcis


Application numérique : db⩾0.9 mm Nous prenons un coefficient de sécurité de 2 ce qui nous donne un diamètre de goupille de 1,8mm qui est bien inférieur au 1/3 du diamètre de l’arbre qui est de 6,5mm.

(S2)

(S1)

P ds

df(M,1→2)

→

→ | →

V : effort tranchant

Acis : section de la goupille au cisaillement

Db : diamètre de la goupille

Tadmcis : contrainte admissible du matériau de la goupille


Page 32 sur 44

Dimensionnement de la clavette

L’axe du moteur étant de 5mm et le diamètre d’une goupille ne pouvant dépasser le tiers du diamètre de l’arbre, nous optons pour le choix d’une clavette afin de réaliser la liaison entre l’axe du moteur et le reste du système.Nous la dimensionnerons au cisaillement :

Hypothèses :

-La clavette est encastrée dans l’arbre.

-La clavette exerce une action de contact uniformément répartie sur le moyeu.


Extrait du guide du dessinateur industriel

d=5 mm | a=2 mm | b=2 mm
s=0.16 | j=d-1.2 | k=d+1

Page 33 sur 44

On a la surface cisaillée Acis de la clavette qui est égale à Acis= a*l

τmoyen =

V
Acis =

V
a ∗ l

V =

2Mt
d
Donc : τmoyen =

2Mt
a∗l∗d

≤ τadmcis

D’où l ≥

2Mt
a∗d∗τadmcis

τadmcis = 0.58 ∗

Re
S
Application numérique : l ≥ 0.18 mm l : longueur de la clavette

V : effort tranchant s’exerçant sur la clavette

Mt : moment de torsion

τadm : dans le cas d’un matériau ductile la contrainte tangentielle admissible en cisaillement est obtenue en tenant compte d’un coefficient de sécurité S par rapport à la limite élastique en cisaillement

S : coefficient de sécurité

Re : limite élastique.

Page 34 sur 44

V- Tableau des coûts prévisionnels

a) Liste des composants standard
- Moteur : https://fr.rs-online.com/web/p/moteurs-a-courant-continu/8814488/
- Galet : https://fr.rs-online.com/web/p/galets-de-guidage/2352230/
- Courroie : https://www.123courroies.com/courroie-flexonic/80292-courroie-betonniere-
| 558j9.html (https://www.123courroies.com/courroie-flexonic/80292-courroie-betonniere-558j9.html)
- Roulements rigides à billes : https://fr.rs-online.com/web/p/roulements-a-billes/6190086/
- Vis H M5-15 : https://fr.rs-online.com/web/p/vis-sans-tete-et-vis-de-reglage/4827786/
- rondelle plate M10 : https://fr.rs-online.com/web/p/rondelles-plates/0189670/
- écrou hexagonal M10 : https://fr.rs-online.com/web/p/ecrous-hexagonaux/0189614/
- Vis à bois F3 : https://fr.rs-online.com/web/p/vis-a-bois/2631808/
- Vis à six pans : https://fr.rs-online.com/web/p/vis-a-six-pans/1838597/
- Roulement à bille : https://fr.rs-online.com/web/p/roulements-a-billes/6189957/
- Rondelles plates : https://fr.rs-online.com/web/p/rondelles-plates/0189620/
- Circlips : https://fr.rs-online.com/web/p/circlips/2096621/

Les différents arbres, la lames de découpes qui nécessite des dimensions précises, le bâti, la came… seront usiné et fabriqué au Fablab.

b) Tableau des coûts
Composant | Quantité | Prix (€) | Prix total (€)
Moteur | 2 | 26,97 | 53,94
Galets | 4 | 21,07 | 21,07 (sachet de 10)
Courroie | 1 | 41,91 | 41,91
Roulement rigide à bille | 2 | 2,81 | 5,62
Rondelle plate M10 | 2 | 11,70 | 11,70 (sachet de 50)
Ecrou hexagonal M10 | 2 | 28,18 | 28,18 (sachet de 50)
Vis H M5-15 | 4 | 27,07 | 27,07 (sachet de 100)
Vis à bois F3 | 1 | 2,52 | 2,52 (sachet de 100)
Vis à six pans | 16 | 17,46 | 17,46 (sachet de 100)
Roulement à bille | 4 | 2,81 | 11,24
Rondelle plate | 1 | 5,75 | 5,75 (sachet de 100)
Circlips | 8 | 13,24 | 13,24 (sachet de 50)
| | Total | 239,70€

NB : Ce prix ne tiens pas compte des coûts des bruts nécessaire à l’usinage des pièces que nous réaliserons.

Page 35 sur 44; Annexe; A la fondation ECAM; Le Fil polymère; A qui rend-il service ?; Sur quoi agit-il ?; BOBINEUSE; Bobineuse; Fil; Sécurité; Budget; Bobine; Energie; Environnement; Extrudeuse; Opérateur/utilisateur

1) Analyser le besoin

Dans quel but ?

Stocker le fil de manière ordonnée sur une bobine

La bobineuse doit acheminer le fil en sortie de l’extrudeuse jusqu’à la bobine afin d’y déposer le fil de
manière ordonnée sur la bobine.

2) Organisation des fonctions

Système de coupe


Page 36 sur 44

3) Fiche technique ABS


Page 37 sur 44


Page 38 sur 44

4) Fiche technique PLA


Page 39 sur 44

Page 40 sur 44


Page 41 sur 44

5) Fiche techniques poulies et courroie
6) Tableau des coefficients de frottements
Matériaux | Matériaux | Contact | Coefficient de frottement | Facteur d'adhérence
Acier | Acier | - | 0,1 | 0,2
Acier | Acier | graisse | 0,05 | 0,1
Acier trempé | Acier trempé | huile | 0,1 / 0,07 | 0,11
Acier trempé | Acier trempé | huile sous pression | 0,05 | 0,11
Acier | XC35 | eau | 0,25 | .
XC35 | XC35 | huile | 0,09 | .
Acier 16NC6 | Acier | eau | 0,065 | .
Acier cémenté | fonte trempée | - | 0,15 | .
Acier cémenté | fonte trempée | lubrifié | 0,08 | .
Acier | fonte | lubrifié | 0,08 / 0,05 | 0,08
Acier | fonte | - | 0,1 | 0,12

Page 42 sur 44

Acier Z30C13 | Fonte grise alliée | huile | 0,23
Acier 16NC6 | AU4G | eau | 0,45 | .
Acier 16NC6 | AU4G | vaseline | 0,075 | .
Acier trempé | Bronze trempé | - | 0,25 /0,15 | 0,2
Acier trempé | Bronze trempé | lubrifié | 0,12 | 0,2
Acier trempé | Bronze trempé | huile sous pression | 0,05 | 0,11 / 0,12
Acier 16NC6 | CuSn12Zn1P | eau/vaseline | 0,17 | .
Acier inoxydable chromé | Aluminium | - | 0,4 | .
Acier inoxydable chromé | Aluminium | lubrifié | 0,1 | .
Acier | Cuivre étamé | - | 0,12 | .
Acier | Cuivre étamé | lubrifié | 0,09 | .
Acier | Métal Fritté | - | 0,1/0,12 | .
Acier | Métal Fritté | lubrifié | 0,03/0,06 | .
Acier | Ferrodo | - | 0,25/0,35 | .
Acier | Graphite | lubrifié | 0,09 | .
Acier graphité | Téflon | - | 0,1 | .
Acier graphité | Téflon (PTFE) | lubrifié | 0,05/0,08 | .
Acier | Téflon (PTFE) | - | 0,1 | 0,15
Acier inoxydable | Téflon graphité | eau | 0,06 | .
Acier | Palier PTFE | - | 0,02/0,08 | .
Acier | Palier PTFE | lubrifié | 0,003! /0,05 | .
Acier | Polyéthylène | - | 0,3/0,8 | .
Acier | Nylon | - | 0,15 | 0,2
Acier | Nylon | eau | 0,5 | .
Acier | Nylon | huile | 0,1 | 0,15
Acier | Acétal | huile | 0,2 | .
Acier | Polyamide 6.6 | huile | 0,12 | .
Fonte grise alliée | Fonte GS rectifiée | huile | 0,13 | .
Fonte grise alliée | Fonte blanche | huile | 0,11 | .
Fonte | Bronze | - | 0,21 | 0,43
Fonte | Caoutchouc | - | 0,20 | 0,80
Fonte polie | Cuir | - | 0,10 | 0,43
Fonte polie | Cuir | gras | 0,20 | 0,43
Fonte polie | Corde neuve | - | 0,075 | 0,79
Bronze | Bronze | - | 0,20 | 0,43
Caoutchouc | Fonte polie | - | 0,20 | 0,80
Caoutchouc | Sol moyen | - | 0,65 | 0,80
Caoutchouc | Sol moyen | humide | 0,30 | 0,80
Caoutchouc | Sol moyen | boueux | 0,10 | 0,80
Caoutchouc | Sol moyen | très mouillé | 0,25 | 0,80
Pneu | Route | - | 0,5/0,6 | .

Page 43 sur 44

Pneu | Route | mouillé | 0,3/0,5 | .
Pneu | Asphalte à 25km/h | - | 0,02/0,03 | .
Roues en fer | Asphalte bon état | - | 0,010 | .
Roues en fer | Dalles en pierre | - | 0,006 | .
Roues en fer | Rail sec | - | 0,35 | .
Roues en fer | Pavé bois | - | 0,018 | .
Roues en fer | Pavé pierre | - | 0,02 | .
Roues en fer | Pavé pierre mauvaise état | - | 0,033 | .
Roues en fer | Route empierré bon état | - | 0,023 | .
Roues en fer | Route empierré avec poussière | - | 0,028 | .
Roues en fer | Route empierré défoncée, boue | - | 0,035 | .
Roues en fer | Chemin terre bon état | - | 0,08 | .
Roues en fer | Chemin terre mauvais état | - | 0,16 | .
Roues en fer | sable | - | 0,15 /0,30 | .
Chêne | Chêne | - | 0,34 | 0,54
Chêne | Chêne | savonné | 0,16 | 0,44
Chêne | Chêne | humide | 0,25 | 0,71
Chêne | Corde neuve | - | 0,52 | 0,80
Chêne | Cuir | - | 0,33 | 0,43
Chêne(sens des fibres) | Fer | humide | 0,26 | 0,65
Billes | Plan | - | 0,05 | .
Galets | Plan | - | 0,005 | .
Roulements | rail | - | 0,003 | .
Douilles à billes | Axes | - | 0,002 | .
Sources: Formulaire technique de Mécanique Générale par Jacques Muller Systèmes mécaniques - Théorie et dimensionnement / DUNOD Construction mécanique - 1ére et Terminale / DUNOD Précis de construction mécanique - Tome 3 / AFNOR-NATHAN


Page 44 sur 44

7) Schéma cinématique
a) Système de découpe
b) Système de came cylindrique
Vue de face | Vue de droite
