RolandThsive/3D-printer-Plastic-Recycler/2020-05-30 Données annexes (André ERNESTO)/2019-10-21 Nomenclatures des entreprises (André ERNESTO).xlsx

Sheet: Nomenclature
Total |  |  |  |  | #REF! | #REF! | #REF! | #REF! | 853.38 €
Entreprise | Fonction | Pièce | Référence | Lien | Site | Quantité | Prix HT | Prix TTC | Prix final | Commentaires
 |  | Roulettes | 400-003 | https://fr.rs-online.com/web/p/roulettes-industrielles/0400003/?sra=pstk | RS | 4 | 4.19 € | 5.03 € | 20.11 €
B1 | Guidage du fil | Poulie | 352-0664 | https://fr.rs-online.com/web/p/poulies-pour-courroies-trapezoidales/3520664/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 | RS | 1 | 2.37 € | 2.84 € | 2.84 €
B1 | Guidage du fil | Microrupteur | D2SW-01L3H | https://fr.rs-online.com/web/p/microrupteurs/6822086/ | RS | 2 | 3.62 € | 4.34 € | 8.68 €
B1 | Motorisation | Moteur | 162.4101.2B.00 | https://fr.rs-online.com/web/p/moteurs-a-courant-continu/8496232/ | RS | 1 | 107.09 € | 128.51 € | 128.51 €
B2 | acheminement du fil | poulie à gorge creuse | AF4P32/2N/D | https://fr.rs-online.com/web/p/poulies-pour-courroies-trapezoidales/3520664/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 | radiospare | 3 | 2.37 € | 2.84 € | 8.53 €
I2 | acheminement du fil | poulie | Estink9zmu5xbsg4 | https://www.amazon.fr/Roulement-Guidage-Mouvement-Lin%C3%A9aire-Syst%C3%A8me/dp/B07KS329GF?hvadid=330871957614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 | Amazon | 1 | 6.49 € | 7.79 € | 7.79 € | Groupe I2
D2 | Découpe fil | Poignées | 237-439 | https://fr.rs-online.com/web/p/poignees-de-tiroirs-et-d-armoires/0237439/ | RS | 2 | 12.12 € | 14.54 € | 29.08 € | Poignées pour la découpe + la portabilité
K2 | Motorisation | Roue du système roue et vis sans fin | 521-6957 | https://fr.rs-online.com/web/p/roues-et-vis-sans-fin/5216957/?searchHistory=%7B%22enabled%22%3Atrue%7D | RS | 1 | 27.51 € | 33.01 € | 33.01 €
K2 | Motorisation | Vis du système roue et vis sans fin | 521-6890 | https://fr.rs-online.com/web/p/vis-sans-fin/5216890/?searchHistory=%7B%22enabled%22%3Atrue%7D | RS | 1 | 13.23 € | 15.88 € | 15.88 €
A1 | Maintien de la bobine | Clavette | 302-3949 | https://fr.rs-online.com/web/p/clavettes/3023949/ | RS | 1 | 4.62 € | 5.58 € | 5.58 €
A1 | Maintien de la bobine | Roulement | 618-9862 | https://fr.rs-online.com/web/p/roulements-a-billes/6189862/ | RS | 2 | 4.68 € | 5.62 € | 5.62 €
A1 | Maintien de la bobine | Clavette | 302-4015 | https://fr.rs-online.com/web/p/clavettes/3024015/ | RS | 1 | 3.92 € | 4.70 € | 4.70 €
C1 | Reducteur Guidage | Roulements a bille | 893-7424 | https://fr.rs-online.com/web/p/roulements-a-billes/8937424/?searchHistory=%7B%22enabled%22%3Atrue%7D | RS | 6 | 2.92 € | 3.50 € | 21.02 € | Semblables a ceux de l'extrudeuse
H1 | Guidage de l'arbre bobine | Roulement à bille | 618-9957 | https://fr.rs-online.com/web/p/roulements-a-billes/6189957/ | RS | 2 | 2.34 € | 2.81 € | 5.62 €
H1 | bridage fil avant decoupe | sauterelle | 254-620 | https://fr.rs-online.com/web/p/outils-de-serrage/0254620/ | RS | 1 | 9.91 € | 11.89 € | 11.89 €
G1 | guidage arbre trancannage | Palier auto-aligneur à semelle avec serrage par vis | 747-440 | https://fr.rs-online.com/web/p/roulements-paliers-et-accessoires/0747440/ | radiospare | 2 | 33.40 € | 40.08 € | 80.16 € | tracepart :https://www.traceparts.com/fr/product/nsk-palier-auto-aligneur-a-semelle-avec-serrage-par-vis-np15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
André ERNESTO |  | Equerre extrudeuse |  | https://www.amazon.fr/dp/B07CKW1HHD/ref=pe_3044141_189395771_TE_dp_1 | Amazon |  |  | 0.00 € | 0.00 € | Celles de l'extrudeuse
J1 | Mise en rotation galet | Ecrou H M10 | 122-4405 | https://fr.rs-online.com/web/p/ecrous-hexagonaux/1224405/ | RS | 1 | 8.48 € | 10.18 € | 10.18 € | 4 pièces nécessaires
J1 | Mise en rotation galet | Tige filetée M10 L200 |  | https://www.leroymerlin.fr/v3/p/produits/lot-de-2-tiges-filetees-acier-zingue-l-200-x-diam-10-mm-standers-e123816 | Leroy Merlin | 1 | 3.33 € | 4.00 € | 4.00 € | 2x 200 mm nécessaires
J1 | Mise en rotation galet | Tube acier D30 L100 |  | https://www.metalaladecoupe.com/francais/panier.asp?tbout=acier | Metalaladecoupe | 2 | 4.48 € | 5.37 € | 10.74 € | 2x 100 mm nécessaires
J1 | Mise en rotation galet | Roulement rigide à bille | 619-0187 | https://fr.rs-online.com/web/p/roulements-a-billes/6190187/ | RS | 4 | 2.80 € | 3.36 € | 13.44 € | 4 pièces nécessaires
A2 | Arret axial arbres poulies | Goupille Beta | 827342 | https://www.amazon.fr/Goupille-beta-2mm-48mm-AISI/dp/B001MSEGNQ?__mk_fr_FR=%C3%85M%C3%85%C5%BD%C3%95%C3%91 | Amazon | 3 | 2.07 € | 2.07 € | 6.21 €
H2 | Motorisation bielle-manivelle | Moteur CC 33tr/min 24V c.c. | 921-1454 | https://fr.rs-online.com/web/p/motoreducteurs-a-courant-continu/9211454/ https://fr.rs-online.com/web/p/motoreducteurs-a-courant-continu/9211454/ https://fr.rs-online.com/web/p/motoreducteurs-a-courant-continu/9211454/ | RS | 1 | 25.92 € | 31.10 € | 31.10 € | Référence fabricant : HG37-120-AB-00
H2 | Guidage du fil en translation | Vis sans fin | 136-3885 | https://fr.rs-online.com/web/p/entretoises/1363885/ | RS | 1 | 25.09 € | 30.11 € | 30.11 € | groupe I2
H2 | Guidage du fil en translation | Roue et vis sans fin | 521-6979 | https://fr.rs-online.com/web/p/roues-et-vis-sans-fin/5216979 | RS | 1 | 53.23 € | 63.88 € | 63.88 € | 8 sur 50 utilisées
G2 | Fixation ventilateur supplémentaire | Vis à six pans creux, M3 x 10mm | 797-6266 | https://fr.rs-online.com/web/p/vis-a-six-pans/7976266/ | RS | 1 | 15.74 € | 18.89 € | 18.89 € | 4 sur 50 utilisées
G2 | Fixation ventilateur supplémentaire | Rondelle plate, M3, Acier, 3.2mm x 7mm | 560-338 | https://fr.rs-online.com/web/p/rondelles-plates/0560338/ | RS | 1 | 1.72 € | 2.06 € | 2.06 € | 8 sur 250 utilisées
G2 | Fixation ventilateur supplémentaire | Écrou hexagonal M3 | 560-293 | https://fr.rs-online.com/web/p/ecrous-hexagonaux/0560293/ | RS | 1 | 6.17 € | 7.40 € | 7.40 € | 16 sur 250 utilisés
C2 | Guidage de l'arbre bobine | roulement à billes à contact radiaux | 6800-2RS | https://fr.rs-online.com/web/p/roulements-a-billes/6189979/?searchHistory=%7B%22enabled%22%3Atrue%7D | RS | 2 | 3.10 € | 3.72 € | 7.44 €
G2 | Transport | Roulette pivotante | 828-6293 | https://fr.rs-online.com/web/p/roulettes-industrielles/8286293/ | RS | 4 | 6.71 € | 8.05 € | 32.21 € | Supporte 50kg
H2 | Motorisation bielle-manivelle | Alimentation de bureau 60W sortie 24V c.c. | 188-781 | https://fr.rs-online.com/web/p/alimentations-de-bureau/0188781/ | RS | 1 | 37.88 € | 45.46 € | 45.46 €
H2 | Motorisation bielle-manivelle | Câble d'alimentation pour alimentation de bureau | 626-6694 | https://fr.rs-online.com/web/p/products/6266694/ | RS | 1 | 5.16 € | 6.19 € | 6.19 €
B2 | Motorisation bielle-manivelle | Moteur | 417-9649 | https://fr.rs-online.com/web/p/motoreducteurs-a-courant-continu/4179649/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 | RS | 1 | 33.97 € | 40.76 € | 40.76 €
COLORATION D | Entrainement du fil | Assemblage de glissière linéaire | 749-323 (commande RS); BSR1530SL (référence fabricant) | https://fr.rs-online.com/web/p/glissieres-lineaires-assemblees/0749323/ | RS | 1 | 47.82 € | 57.38 € | 57.38 €
COLORATION D | Entrainement du fil | Galet | 125-1219 | https://fr.rs-online.com/web/p/galets/1251219/ | RS | 1 | 36.06 € | 43.27 € | 43.27 €
 |  | Ressort de compression | 821-380 | https://fr.rs-online.com/web/p/ressorts-de-compression/0821380/ | RS | 1 | 5.50 € | 6.60 € | 6.60 €
 |  | Ressort de compression | 821-245 | https://fr.rs-online.com/web/p/ressorts-de-compression/0821245/ | RS | 1 | 3.52 € | 4.22 € | 4.22 € | coloration D ; 2 pièces nécessaires (2 sur 10 utlisées)
H1 | bridage du fil avant decoupe | p clip | 187-7592 | https://fr.rs-online.com/web/p/p-clips/1877592/ | RS | 1 |  | 10.61 € | 10.61 €
COLORATION A |  |  | 171347 | https://www.bricodepot.fr/catalogue/profile-en-u-aluminium-brut-l-250m15x20x15-mm-interieur-17mm/prod1723/ | brico depot | 1 |  | 10.20 € | 10.20 € | profilé en U coloration B
COLORATION A | anneau ressort soudage fil | anneau de levage | B07PQPKWKP | https://www.amazon.fr/M10X18-Inoxydable-Filetage-Anneau-Machines/dp/B07PQPKWKP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 | amazon | 1 |  | 1.99 € | 1.99 € | sur amazon car non existant sur rs

Sheet: TCD
Étiquettes de lignes | Somme de Prix final
A1+A2 | 33.02
Bricovis | 33.02
A1 | 443.89
123 roulement | 4.44
Castorama | 8.9
plaqueplexiglass | 12.62
Leroy Merlin | 17.5
metalaladecoupe | 37.89
Amazon | 114.52
RS Pro | 248.02
A2 | 542.53
Axall | 1.6
Leroy Merlin | 6.75
(vide) | 21.3
123 roulement | 40
Amazon | 70.74
plaqueplexiglass | 73.8
Castorama | 83.2
RS Pro | 245.14
Total général | 1019.44
