RolandThsive/3D-printer-Plastic-Recycler/Nomenclature.xlsx

Sheet: Nomenclature
Index | Désignation | Quantité | Matériau | Fabrication | Check
70 | SOCLE_MOTEUR_STIRLING | 1 | Bois | Découple laser
84 | SUPPORT_VENTILATEUR | 1 | Bois | Découple laser
3 | BIELLETTE_A_MOTEUR_STIRLING | 2 | Plexiglass | Découple laser
4 | CHAPEAU_EXT_STIRLING | 1 | Plexiglass | Découple laser
21 | FLASQUE_POULIE_A_STIRLING | 2 | Plexiglass | Découple laser
22 | FLASQUE_POULIE_SUPPORT_BOBINE | 2 | Plexiglass | Découple laser
29 | PLAQUE_REGENERATEUR_STIRLING | 2 | Plexiglass | Découple laser
33 | RONDELLE_MANIVELLE_STIRLING | 2 | Plexiglass | Découple laser
25 | MORS_1_VOLANT_INERTIE_STIR | 1 | Acier | GHC
5 | CLAVETTE_3_3_12 | 4 | Commerce
7 | COLLIER_CHAUFFANT | 1 | Commerce
8 | COLLIER_SERRAGE_30 | 5 | Commerce
10 | COURROIE_STIRLING | 1 | Commerce
11 | DURITE_A_STIRLING | 3 | Commerce
12 | ECROU_FREIN_M3 | 22 | Commerce
13 | ECROU_FREIN_M4 | 39 | Commerce
14 | ECROU_HEX_M4 | 4 | Commerce
15 | ECROU_M8 | 14 | Commerce
20 | EQUERRE_METALLIQUE | 4 | Commerce
28 | MOTEUR_ELECTRIQUE_STIRLING | 1 | Commerce
34 | RONDELLE_PLATE_M3 | 40 | Commerce
35 | RONDELLE_PLATE_M4 | 82 | Commerce
36 | RONDELLE_PLATE_M8 | 17 | Commerce
43 | ROULEMENT_BILLES_12_32_10 | 1 | Commerce
44 | ROULEMENT_BILLES_12_32_10_A | 1 | Commerce
45 | ROULEMENT_BILLES_12_32_10_B | 1 | Commerce
46 | ROULEMENT_BILLES_12_32_10_C | 1 | Commerce
47 | ROULEMENT_BILLES_12_32_10_D | 1 | Commerce
48 | ROULEMENT_BILLES_12_32_10_E | 1 | Commerce
49 | ROULEMENT_BILLES_12_37_12 | 1 | Commerce
50 | ROULEMENT_BILLES_12_37_12_A | 1 | Commerce
51 | ROULEMENT_BILLES_12_37_12_B | 1 | Commerce
52 | ROULEMENT_BILLES_12_37_12_C | 1 | Commerce
53 | ROULEMENT_BILLES_12_37_12_D | 1 | Commerce
54 | ROULEMENT_BILLES_12_37_12_E | 1 | Commerce
55 | ROULEMENT_BILLES_25_37_7 | 1 | Commerce
56 | ROULEMENT_BILLES_25_37_7_A | 1 | Commerce
57 | ROULEMENT_BILLES_25_37_7_B | 1 | Commerce
58 | ROULEMENT_BILLES_25_37_7_C | 1 | Commerce
59 | ROULEMENT_BILLES_25_37_7_D | 1 | Commerce
60 | ROULEMENT_BILLES_25_37_7_E | 1 | Commerce
37 | ROULEMENT_BILLES_3_8_4 | 4 | Commerce
38 | ROULEMENT_BILLES_3_8_4_A | 4 | Commerce
39 | ROULEMENT_BILLES_3_8_4_B | 4 | Commerce
40 | ROULEMENT_BILLES_3_8_4_C | 4 | Commerce
41 | ROULEMENT_BILLES_3_8_4_D | 4 | Commerce
42 | ROULEMENT_BILLES_3_8_4_E | 4 | Commerce
61 | ROULETTE_DEPLACEMENT | 4 | Commerce
62 | ROULETTE_PARTIE_A | 4 | Commerce
63 | ROULETTE_PARTIE_B | 4 | Commerce
64 | ROULETTE_PARTIE_C | 4 | Commerce
65 | SERINGUE_EXTERIEURE_PLASTIQUE | 3 | Commerce
66 | SERINGUE_EXTERIEURE_VERRE | 2 | Commerce
67 | SERINGUE_INTERIEURE_PLASTIQUE | 3 | Commerce
68 | SERINGUE_INTERIEURE_VERRE | 2 | Commerce
85 | THERMOCOUPLE_FOURREAU | 1 | Commerce
90 | VENTILATEUR_REFROIDISSEUR_FIL | 1 | Commerce
91 | VIS_CHC_M3_16 | 7 | Commerce
92 | VIS_CHC_M3_20 | 8 | Commerce
93 | VIS_CHC_M3_25 | 2 | Commerce
94 | VIS_CHC_M4_20 | 34 | Commerce
95 | VIS_CHC_M4_30 | 16 | Commerce
26 | MORS_2_VOLANT_INERTIE_STIR | 1 | Acier | GHC
27 | MORS_3_VOLANT_INERTIE_STIR | 1 | Acier | GHC
83 | SUPPORT_MOTEUR_STIRLING | 1 | PLA | Imprimante 3D | Oui
1 | ARBRE_ENTRAINEMENT_STIRLING | 1 | PLA | Imprimante 3D
6 | COLLECTEUR_VENTILATEUR | 1 | PLA | Imprimante 3D
9 | COQUILLE_SERINGUE_STIRLING | 4 | PLA | Imprimante 3D
16 | ECROU_RENVOIT_ANGLE_STIRLING | 2 | PLA | Imprimante 3D
17 | ENTRETOISE_A_STIRLING | 1 | PLA | Imprimante 3D
18 | ENTRETOISE_B_STIRLING | 1 | PLA | Imprimante 3D
19 | ENTRETOISE_TRANSMISSION_STIRLIN | 4 | PLA | Imprimante 3D
23 | MANIVELLE_MOTEUR_STIRLING | 2 | PLA | Imprimante 3D
30 | PORTE_MORS_VOLANT_INERTIE_STIR | 1 | PLA | Imprimante 3D
31 | POULIE_132D_7L_STIRLING | 1 | PLA | Imprimante 3D
32 | POULIE_42D_7L_A_MOTEUR_STIRLING | 1 | PLA | Imprimante 3D
69 | SERRE_MORS_VOLANT_INERTIE_STIR | 1 | PLA | Imprimante 3D
82 | SUPPORT_ARBRE_STRILING | 1 | PLA | Imprimante 3D
86 | TIGE_FILETEE_A_M3_STIRLING | 3 | Acier | Scie à métaux
87 | TIGE_FILETEE_A_M8_STIRLING | 2 | Acier | Scie à métaux
88 | TIGE_FILETEE_B_M3_STIRLING | 1 | Acier | Scie à métaux
89 | TIGE_FILETEE_B_M8_STIRLING | 2 | Acier | Scie à métaux
2 | ASSEMBLAGE_MOTEUR_STIRLING | 1 | N.C.
24 | MANNEQUIN | 1 | N.C.
71 | SOL_MOTEUR_STIRLING | 1 | N.C.
72 | SOUS_ASSEMBLAGE_ARBRE_STIRLING | 1 | N.C.
73 | SOUS_ASSEMBLAGE_BIELLE_STIRLING | 2 | N.C.
74 | SOUS_ASSEMBLAGE_REGENERATEUR_ST | 1 | N.C.
75 | SOUS_ASSEMBLAGE_ROUES_STIRLING | 1 | N.C.
76 | SOUS_ASSEMBLAGE_SERINGUE_CHAUDE | 1 | N.C.
77 | SOUS_ASSEMBLAGE_SERINGUE_FROIDE | 1 | N.C.
78 | SOUS_ASSEMBLAGE_SOL_STIRLING | 1 | N.C.
79 | SOUS_ASSEMBLAGE_TRANSMISSION_ST | 1 | N.C.
80 | SOUS_ASSEMBLAGE_VENTILATEUR_STI | 1 | N.C.
81 | SOUS_ASSEMBLAGE_VOLANT_INERTIE | 1 | N.C.

Sheet: Data
Étiquettes de lignes | Somme de Quantité
Découple laser | 13
Bois | 2
Plexiglass | 11
GHC | 3
Acier | 3
Imprimante 3D | 22
PLA | 22
Scie à métaux | 8
Acier | 8
Total général | 46
