RolandThsive/3D-printer-Plastic-Recycler/augmente_couple_2.stl

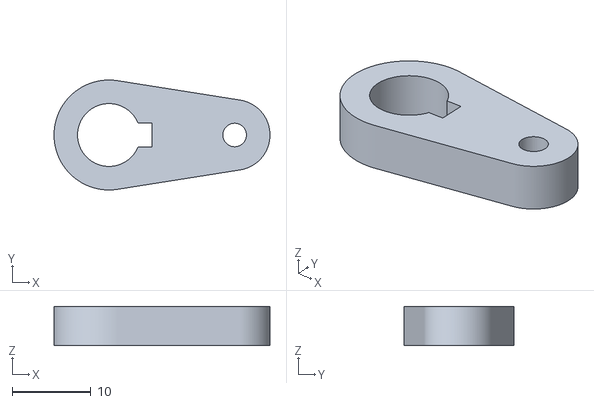
[picture p302: CAD file, 2021-12-22]
augmente_couple_2.stl
27.5 x 14.0 x 5.00
