RolandThsive/3D-printer-Plastic-Recycler/entretoise_a_stirling.stl

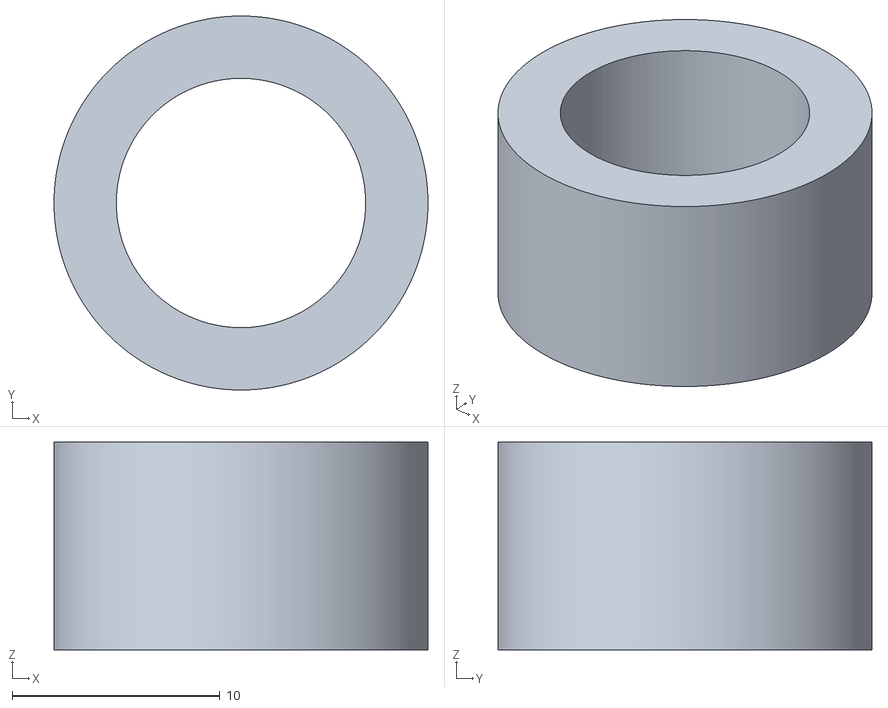
[picture p303: CAD file, 2021-12-22]
entretoise_a_stirling.stl
18.0 x 18.0 x 10.0
