RolandThsive/3D-printer-Plastic-Recycler/support_hauban_mince_pince.stl

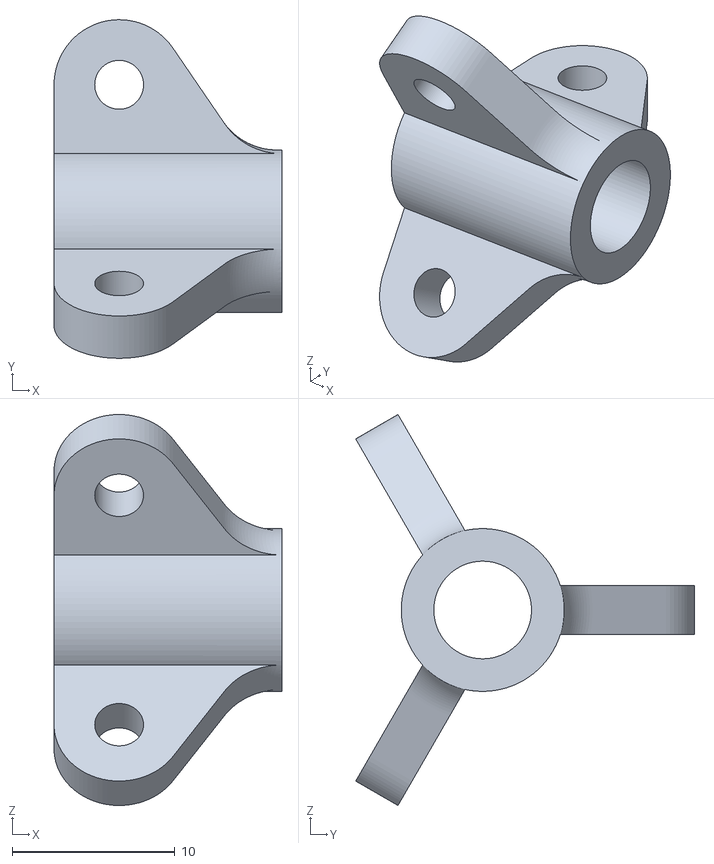
[picture p304: CAD file, 2021-12-22]
support_hauban_mince_pince.stl
14.0 x 20.8 x 24.0
