RolandThsive/3D-printer-Plastic-Recycler/arbre_droit_limiteur_couple.stl

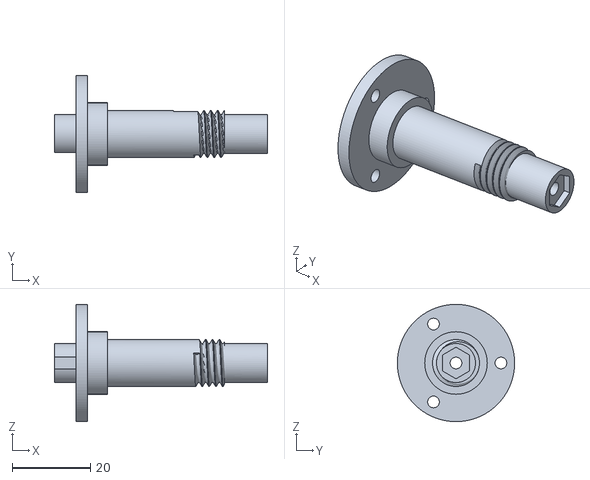
[picture p305: CAD file, 2021-12-22]
arbre_droit_limiteur_couple.stl
54.5 x 30.0 x 30.0
