RolandThsive/3D-printer-Plastic-Recycler/entretoise_b_guide_fil.stl

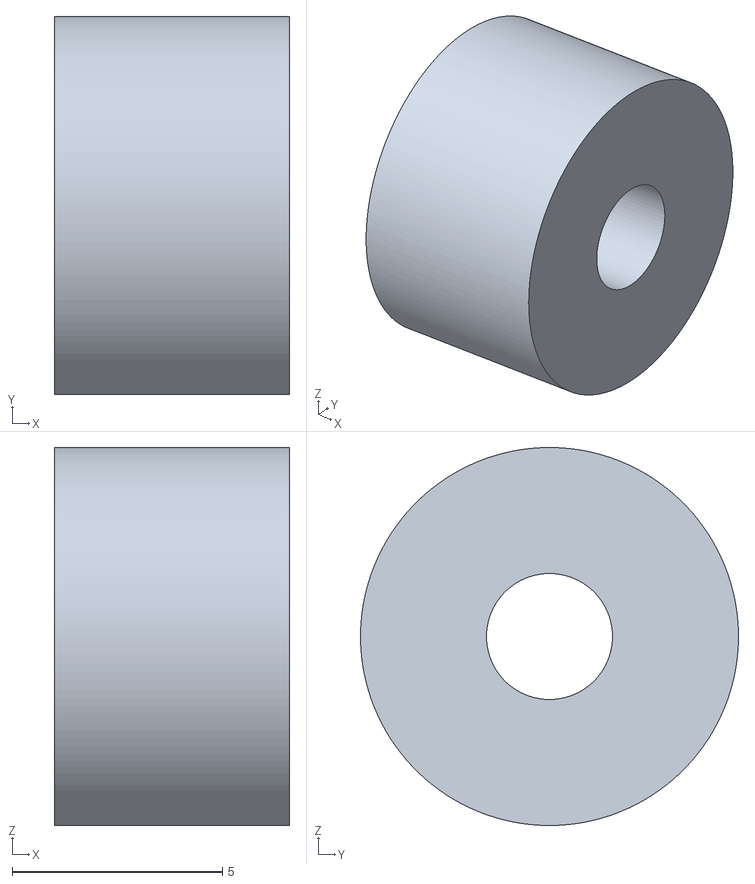
[picture p306: CAD file, 2021-12-22]
entretoise_b_guide_fil.stl
5.60 x 9.00 x 9.00
