RolandThsive/3D-printer-Plastic-Recycler/poulie_84d_7l_entrainement_fil.stl

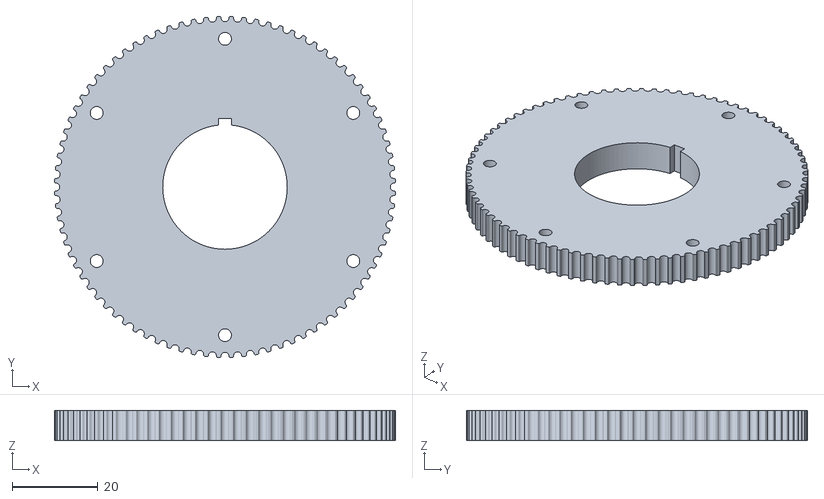
[picture p307: CAD file, 2021-12-22]
poulie_84d_7l_entrainement_fil.stl
79.4 x 79.4 x 7.00
