RolandThsive/3D-printer-Plastic-Recycler/entretoise_entrainement_fil.stl

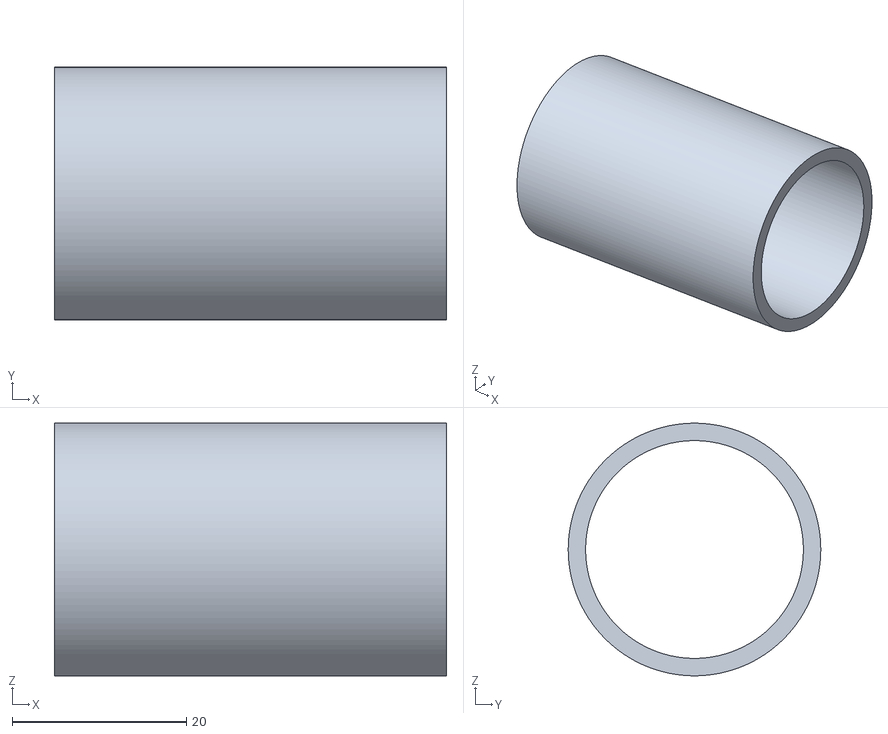
[picture p308: CAD file, 2021-12-22]
entretoise_entrainement_fil.stl
45.0 x 29.0 x 29.0
