RolandThsive/3D-printer-Plastic-Recycler/manivelle_moteur_stirling.stl

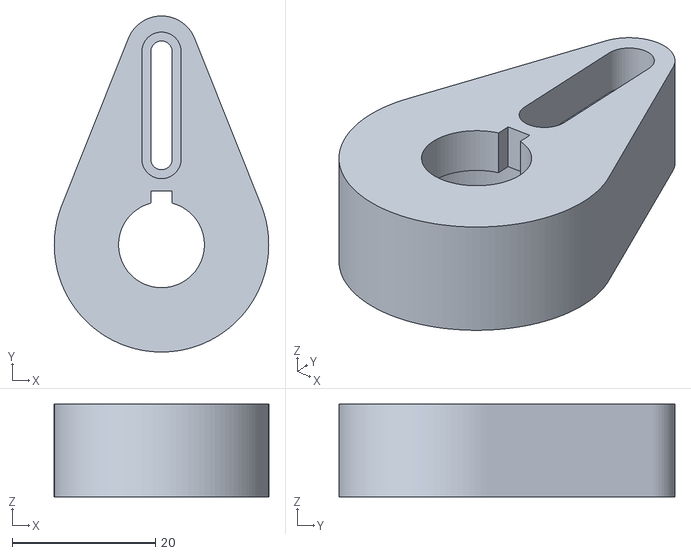
[picture p309: CAD file, 2021-12-22]
manivelle_moteur_stirling.stl
30.0 x 47.0 x 13.0
