RolandThsive/3D-printer-Plastic-Recycler/flasque_poulie_support_bobine.dxf

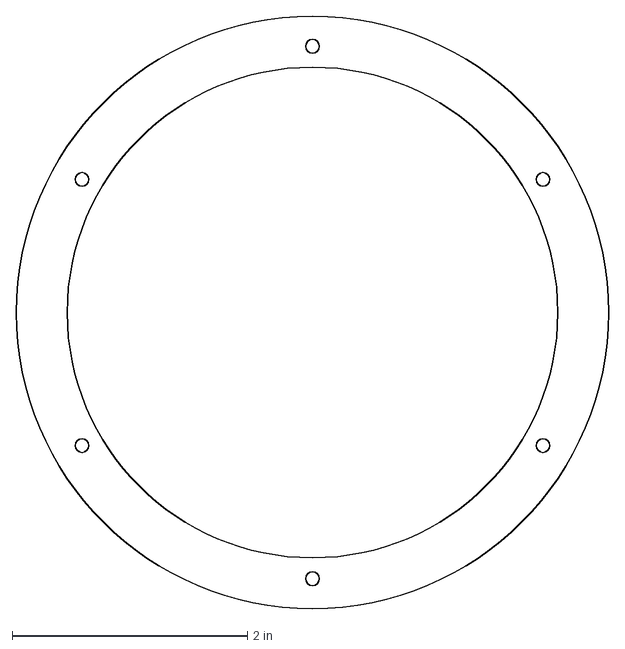
[picture p310: CAD file, 2021-12-22]
flasque_poulie_support_bobine.dxf
5.04 x 5.04 in
