RolandThsive/3D-printer-Plastic-Recycler/entretoise_transmission_stirlin.stl

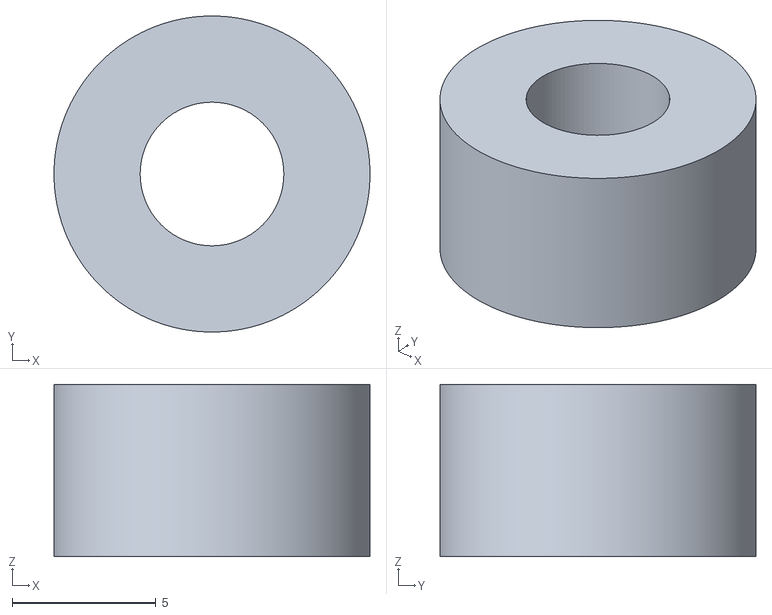
[picture p311: CAD file, 2021-12-22]
entretoise_transmission_stirlin.stl
11.0 x 11.0 x 6.00
