RolandThsive/3D-printer-Plastic-Recycler/fourche_trancannage.stl

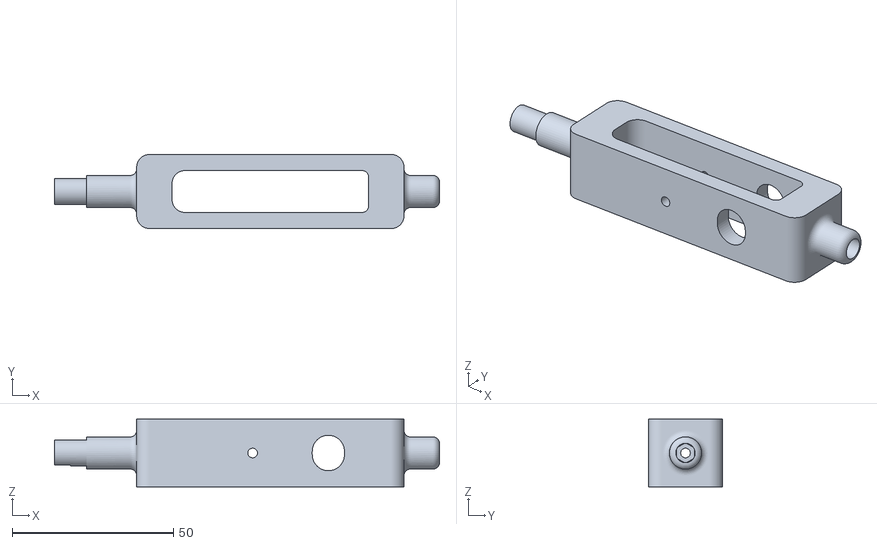
[picture p312: CAD file, 2021-12-22]
fourche_trancannage.stl
119.5 x 23.0 x 21.0
