RolandThsive/3D-printer-Plastic-Recycler/rondelle_manivelle_stirling.dxf

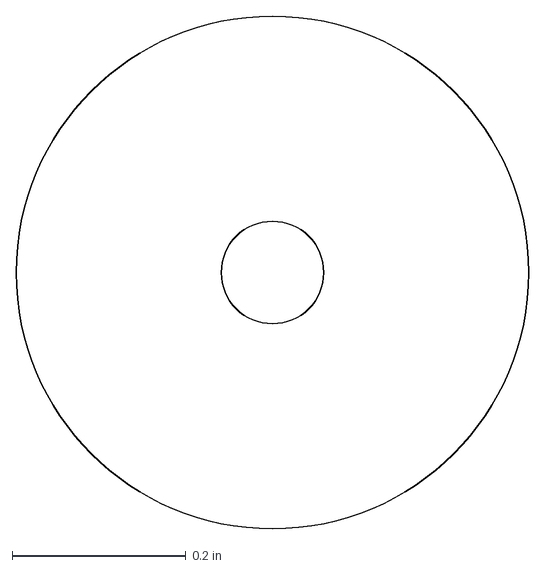
[picture p313: CAD file, 2021-12-22]
rondelle_manivelle_stirling.dxf
0.591 x 0.591 in
