RolandThsive/3D-printer-Plastic-Recycler/bati.stl

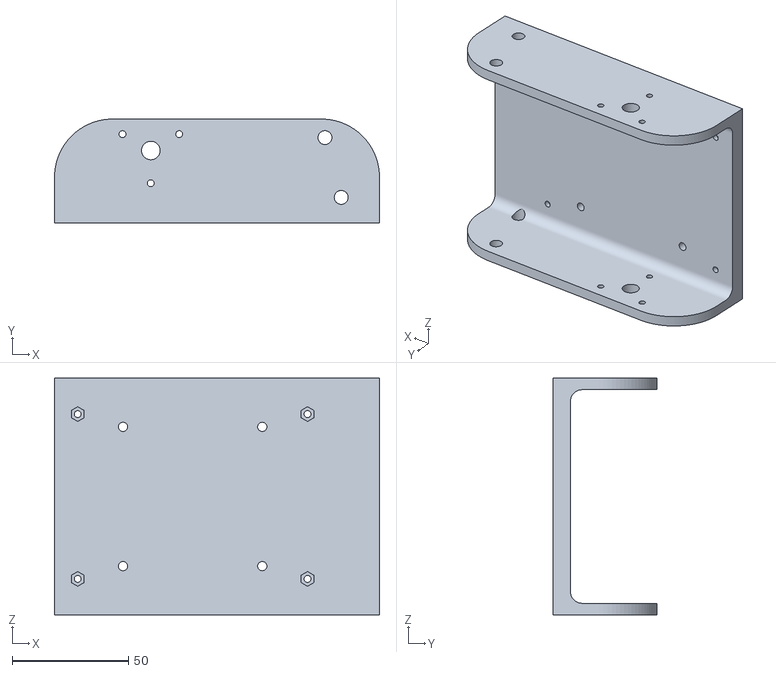
[picture p314: CAD file, 2021-12-22]
bati.stl
140.0 x 44.8 x 102.0
