RolandThsive/3D-printer-Plastic-Recycler/ecrou_renvoit_angle_stirling.stl

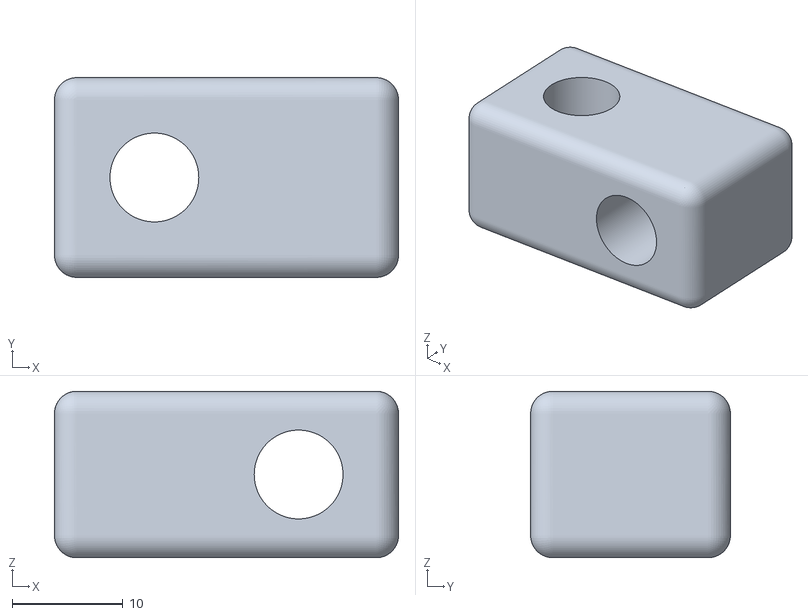
[picture p315: CAD file, 2021-12-22]
ecrou_renvoit_angle_stirling.stl
31.0 x 18.0 x 15.0
