RolandThsive/3D-printer-Plastic-Recycler/arbre_gauche_limiteur_couple.stl

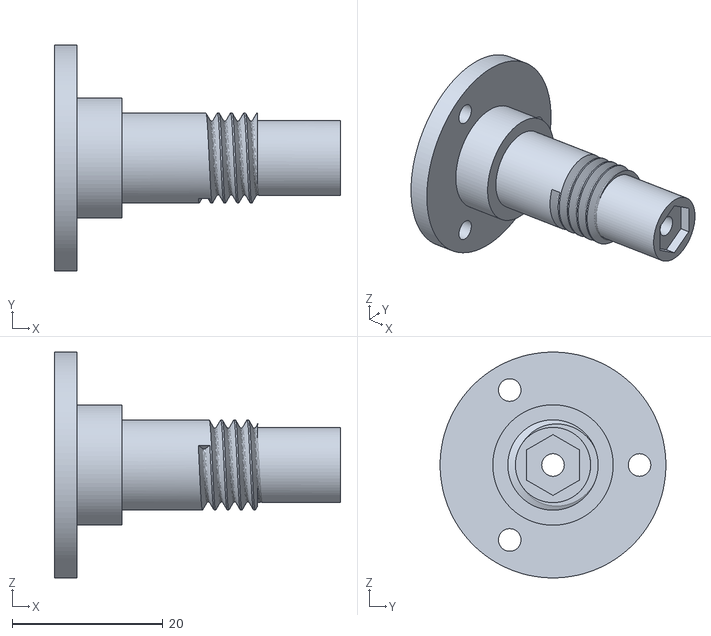
[picture p316: CAD file, 2021-12-22]
arbre_gauche_limiteur_couple.stl
38.0 x 30.0 x 30.0
