RolandThsive/3D-printer-Plastic-Recycler/poulie_entrainement_guide_fil.stl

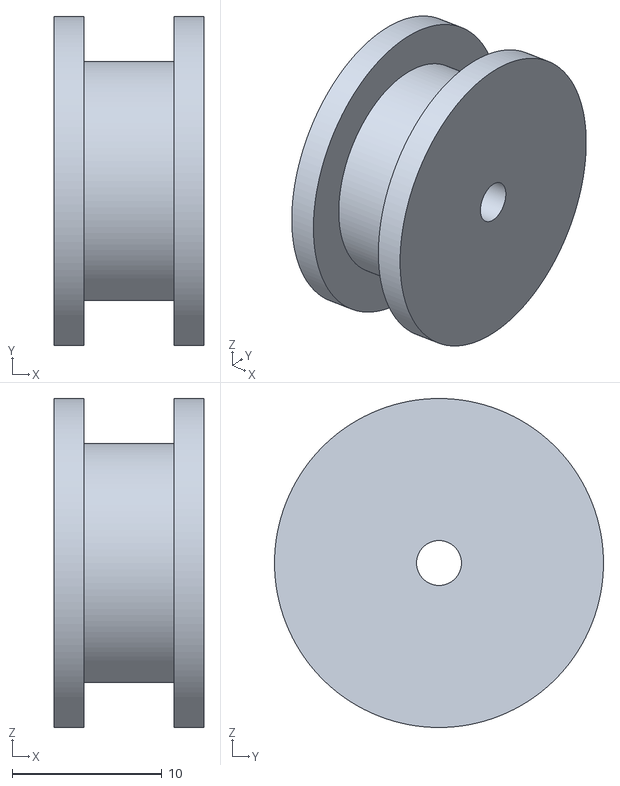
[picture p317: CAD file, 2021-12-22]
poulie_entrainement_guide_fil.stl
10.0 x 22.0 x 22.0
