RolandThsive/3D-printer-Plastic-Recycler/chapeau_ext_stirling.dxf

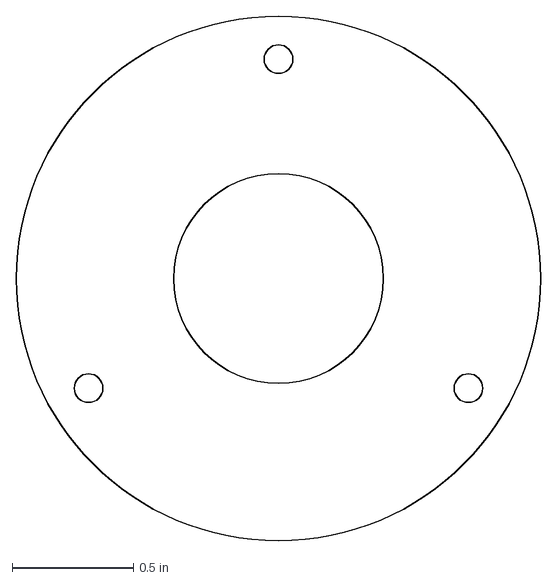
[picture p318: CAD file, 2021-12-22]
chapeau_ext_stirling.dxf
2.17 x 2.17 in
