RolandThsive/3D-printer-Plastic-Recycler/chapeau_gauche_limiteur_couple.stl

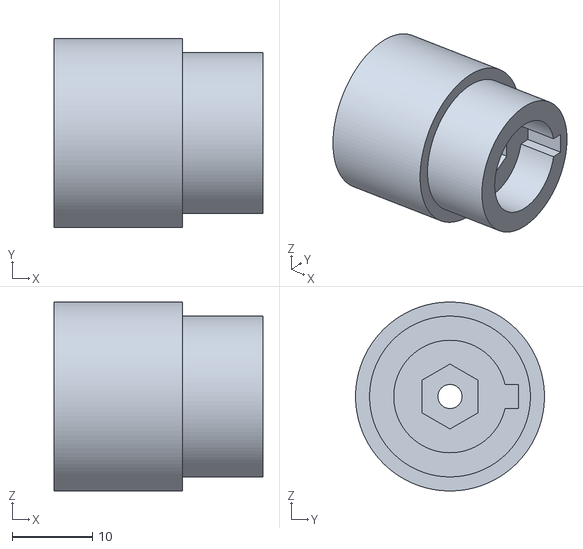
[picture p319: CAD file, 2021-12-22]
chapeau_gauche_limiteur_couple.stl
26.0 x 23.5 x 23.5
