RolandThsive/3D-printer-Plastic-Recycler/reglage_hauteur_trancannage_db.stl

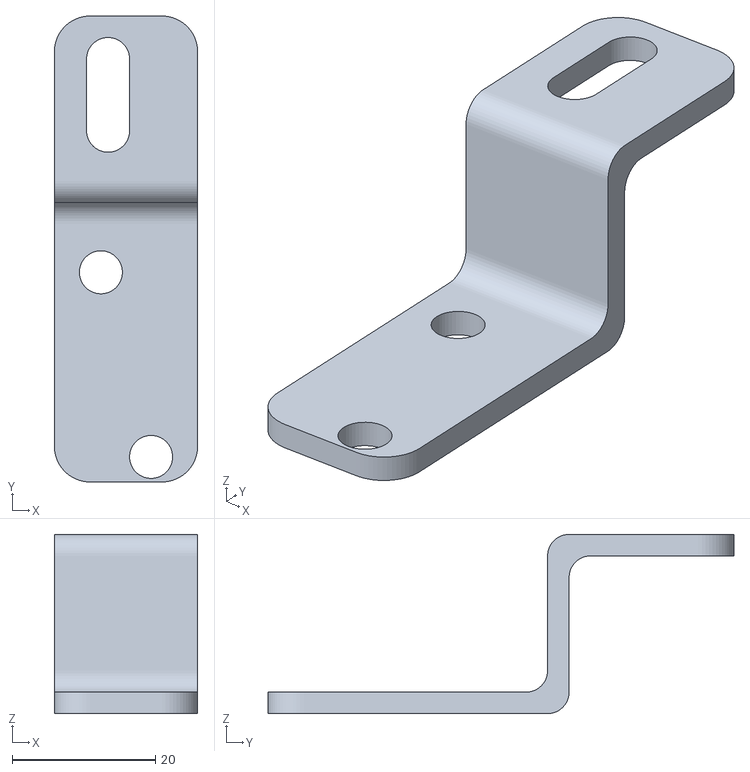
[picture p320: CAD file, 2021-12-22]
reglage_hauteur_trancannage_db.stl
20.0 x 65.0 x 25.0
