RolandThsive/3D-printer-Plastic-Recycler/support_roulement_d_trancannage.stl

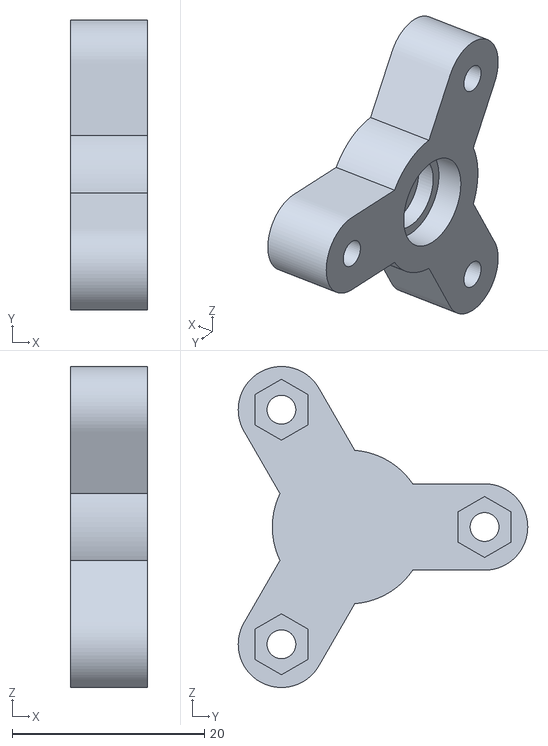
[picture p321: CAD file, 2021-12-22]
support_roulement_d_trancannage.stl
8.00 x 30.1 x 33.4
