RolandThsive/3D-printer-Plastic-Recycler/support_arbre_entrainement_fil.stl

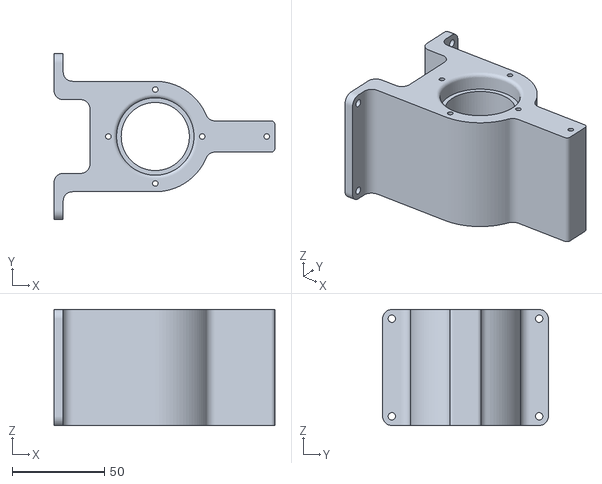
[picture p322: CAD file, 2021-12-22]
support_arbre_entrainement_fil.stl
120.0 x 90.0 x 63.0
