RolandThsive/3D-printer-Plastic-Recycler/porte_roulement_billes.stl

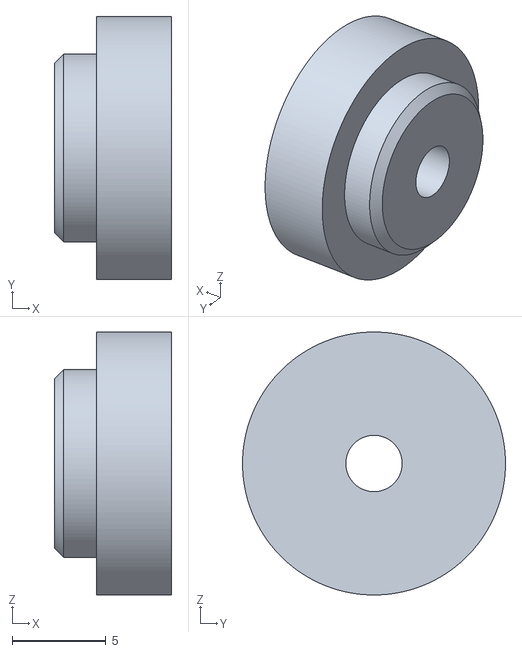
[picture p323: CAD file, 2021-12-22]
porte_roulement_billes.stl
6.25 x 14.0 x 14.0
