RolandThsive/3D-printer-Plastic-Recycler/poulie_132d_7l_support_bobine.stl

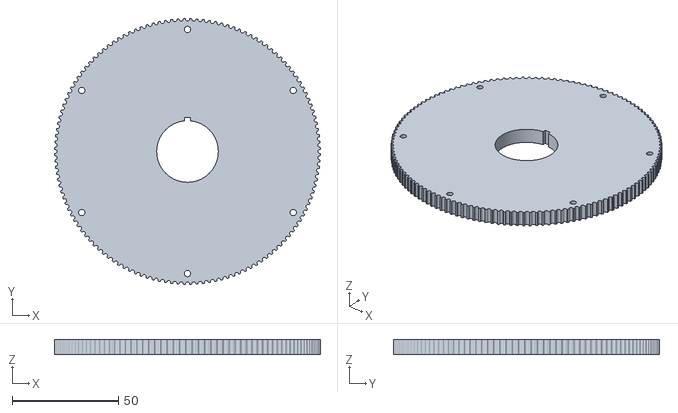
[picture p324: CAD file, 2021-12-22]
poulie_132d_7l_support_bobine.stl
125.3 x 125.3 x 7.00
