RolandThsive/3D-printer-Plastic-Recycler/reglage_hauteur_trancannage_d.stl

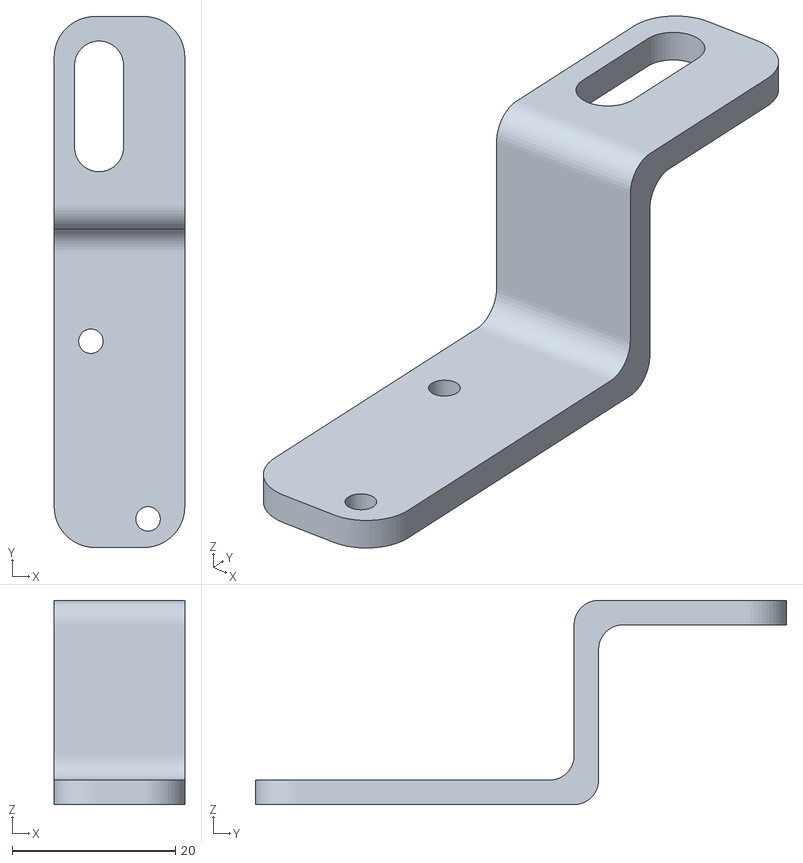
[picture p325: CAD file, 2021-12-22]
reglage_hauteur_trancannage_d.stl
16.0 x 65.0 x 25.0
