RolandThsive/3D-printer-Plastic-Recycler/tenseur_guide_fil.stl

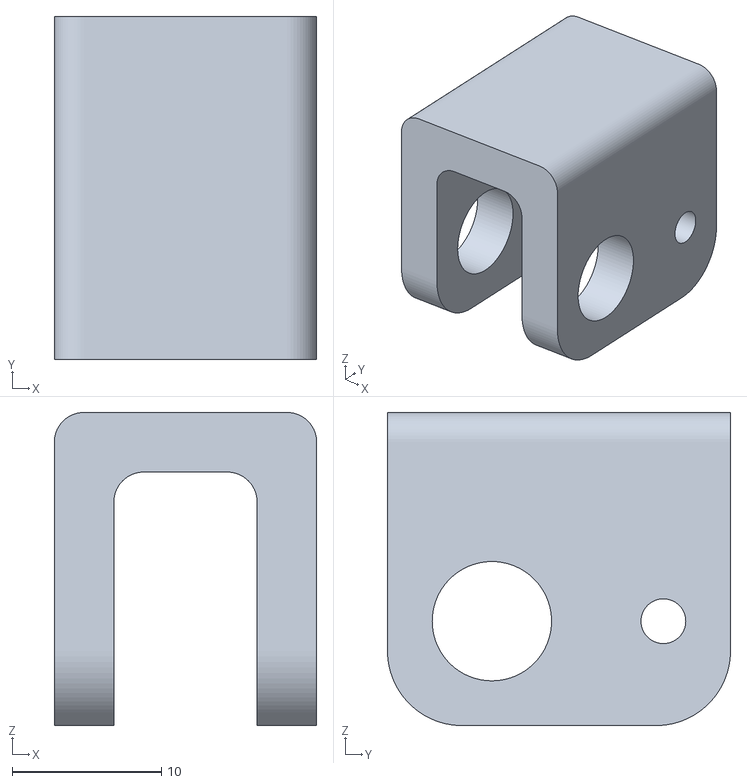
[picture p326: CAD file, 2021-12-22]
tenseur_guide_fil.stl
17.6 x 23.0 x 21.0
