RolandThsive/3D-printer-Plastic-Recycler/flasque_poulie_trancannage.dxf

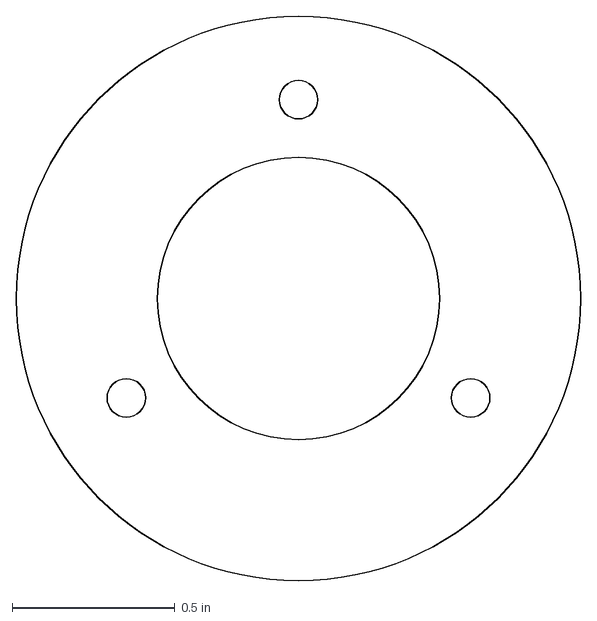
[picture p327: CAD file, 2021-12-22]
flasque_poulie_trancannage.dxf
1.73 x 1.73 in
