RolandThsive/3D-printer-Plastic-Recycler/poulie_44d_7l_b_stirling.stl

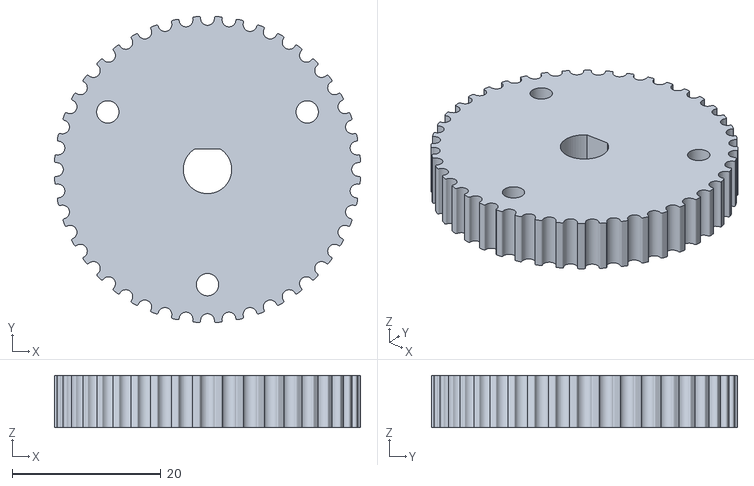
[picture p328: CAD file, 2021-12-22]
poulie_44d_7l_b_stirling.stl
41.2 x 41.2 x 7.00
