RolandThsive/3D-printer-Plastic-Recycler/collecteur_ventilateur.stl

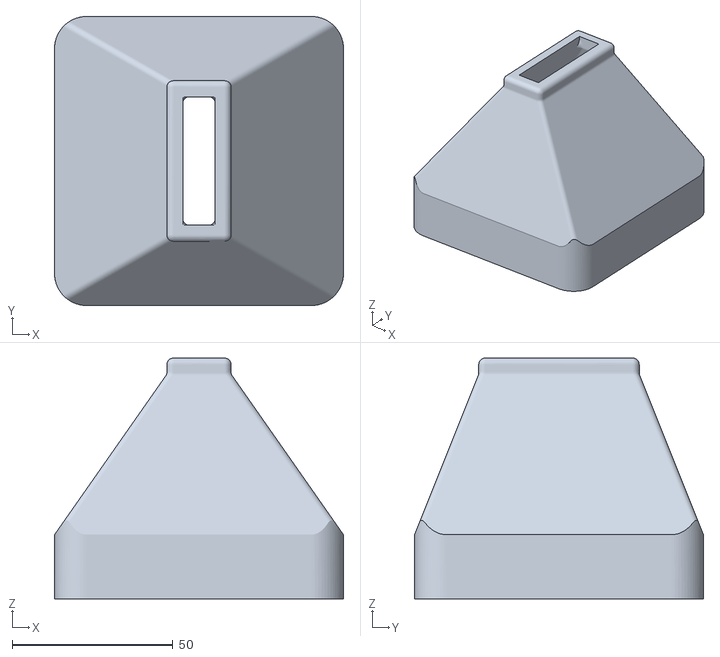
[picture p329: CAD file, 2021-12-22]
collecteur_ventilateur.stl
90.0 x 90.0 x 75.0
