RolandThsive/3D-printer-Plastic-Recycler/poulie_42d_7l_b_limiteur_couple.stl

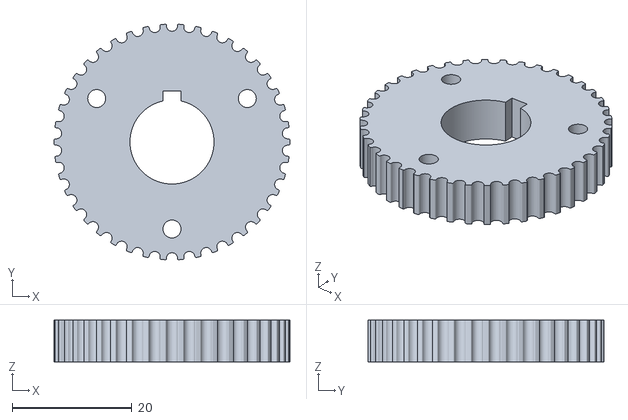
[picture p330: CAD file, 2021-12-22]
poulie_42d_7l_b_limiteur_couple.stl
39.3 x 39.3 x 7.00
