RolandThsive/3D-printer-Plastic-Recycler/support_hauban_a_guide_fil.stl

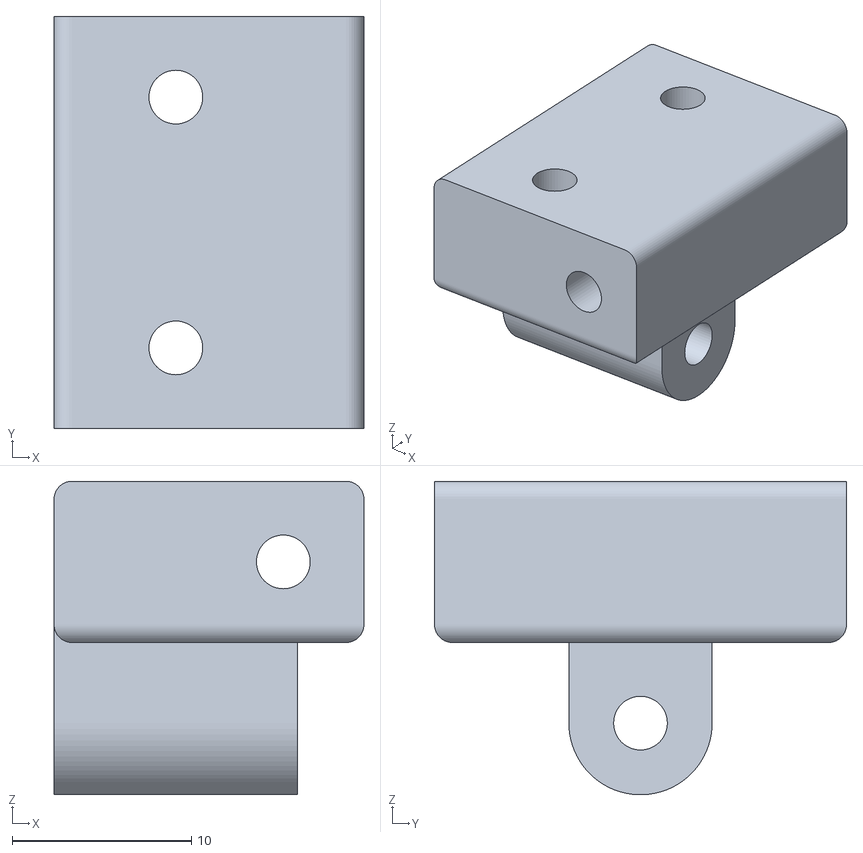
[picture p331: CAD file, 2021-12-22]
support_hauban_a_guide_fil.stl
17.3 x 23.0 x 17.5
