RolandThsive/3D-printer-Plastic-Recycler/entretoise_a_guide_fil.stl

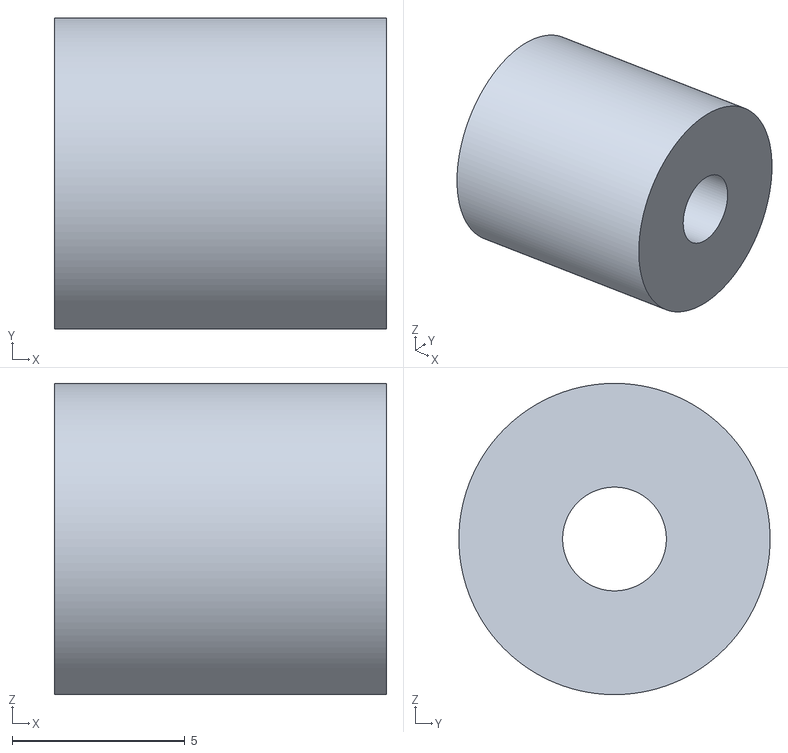
[picture p332: CAD file, 2021-12-22]
entretoise_a_guide_fil.stl
9.60 x 9.00 x 9.00
