RolandThsive/3D-printer-Plastic-Recycler/entretoise_ext_entrainement_fil.stl

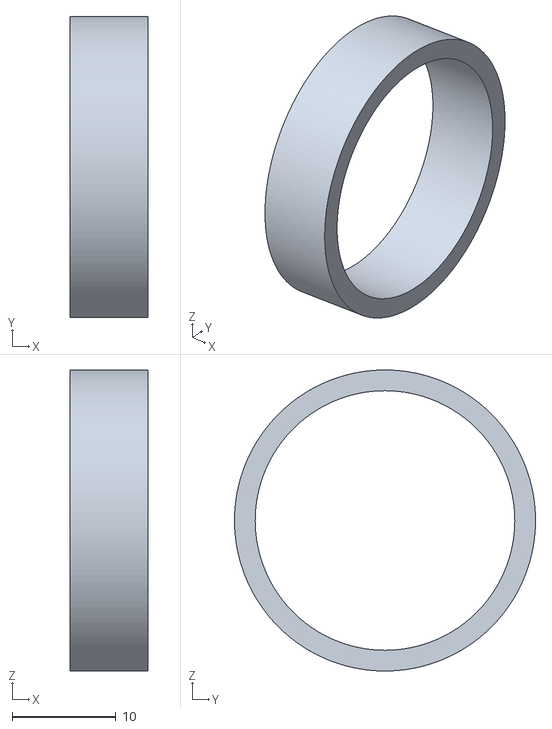
[picture p333: CAD file, 2021-12-22]
entretoise_ext_entrainement_fil.stl
7.50 x 29.0 x 29.0
