RolandThsive/3D-printer-Plastic-Recycler/porte_fil_caoutchouc_droit.stl

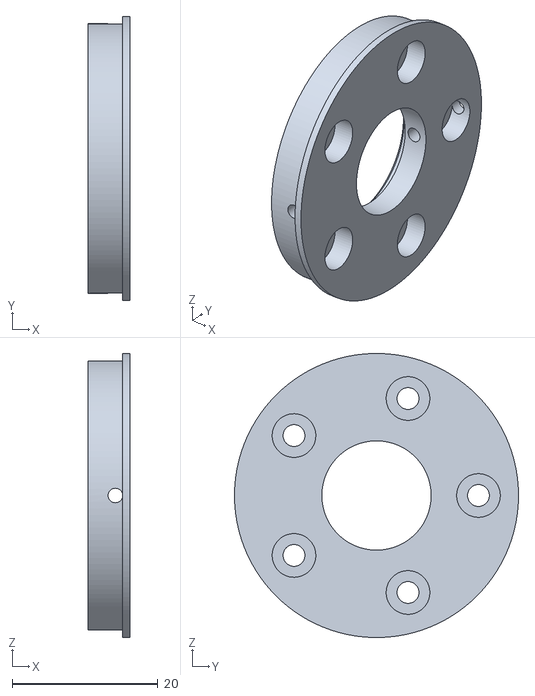
[picture p334: CAD file, 2021-12-22]
porte_fil_caoutchouc_droit.stl
5.75 x 39.0 x 39.0
