RolandThsive/3D-printer-Plastic-Recycler/support_ressort_entrainement.stl

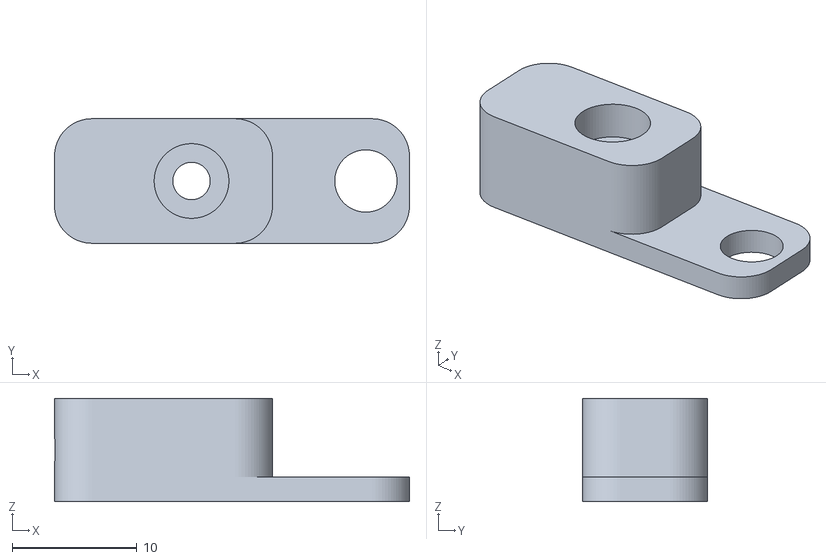
[picture p335: CAD file, 2021-12-22]
support_ressort_entrainement.stl
28.5 x 10.0 x 8.30
