RolandThsive/3D-printer-Plastic-Recycler/arbre_entrainement_stirling.stl

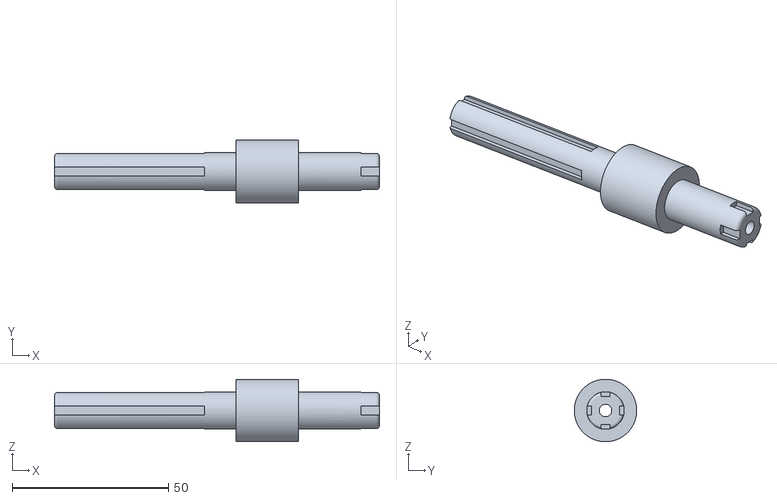
[picture p336: CAD file, 2021-12-22]
arbre_entrainement_stirling.stl
104.0 x 20.0 x 20.0
