RolandThsive/3D-printer-Plastic-Recycler/poulie_entrainement_fil.stl

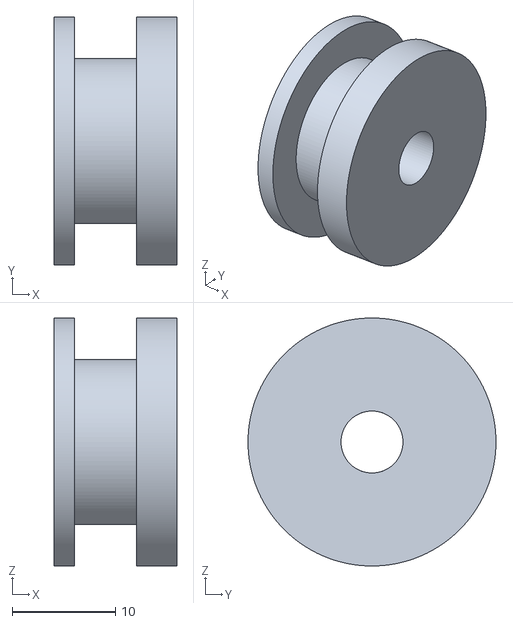
[picture p337: CAD file, 2021-12-22]
poulie_entrainement_fil.stl
11.9 x 24.0 x 24.0
