RolandThsive/3D-printer-Plastic-Recycler/arbre_trancannage.stl

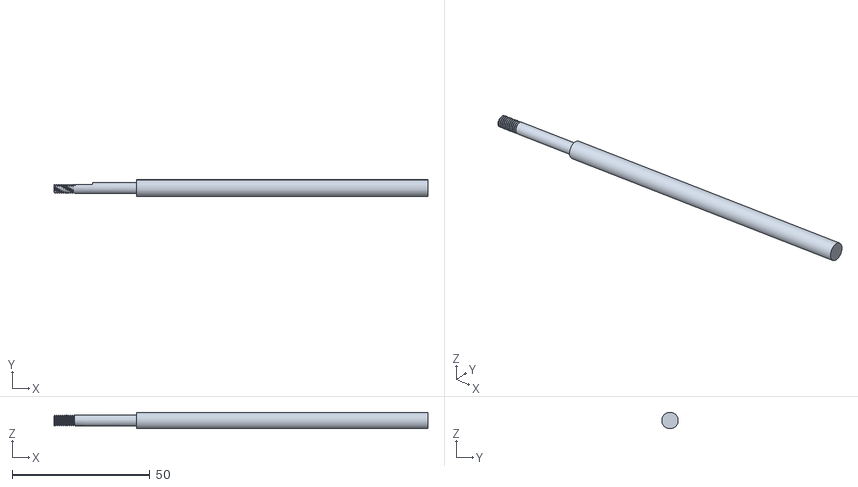
[picture p338: CAD file, 2021-12-22]
arbre_trancannage.stl
136.0 x 6.00 x 5.97
