RolandThsive/3D-printer-Plastic-Recycler/entretoise_d_guide_fil.stl

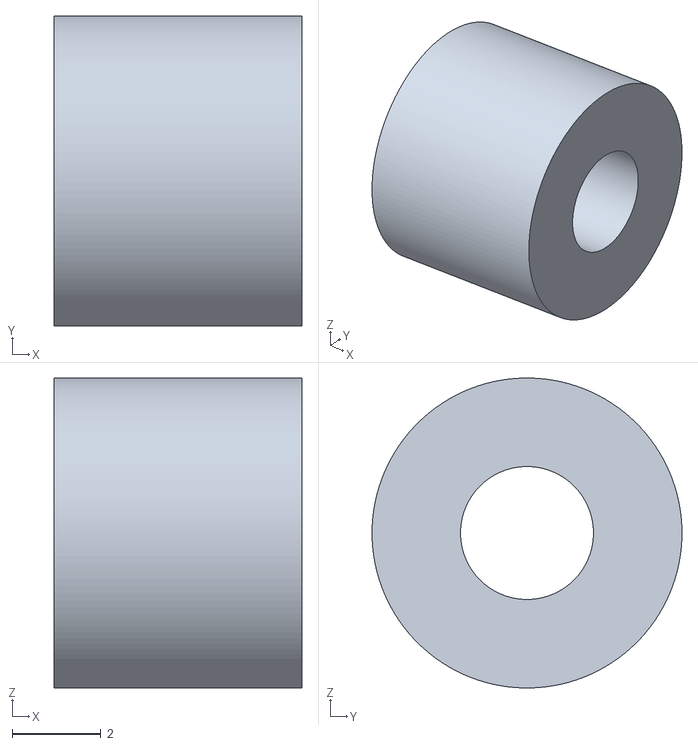
[picture p339: CAD file, 2021-12-22]
entretoise_d_guide_fil.stl
5.60 x 7.00 x 7.00
