RolandThsive/3D-printer-Plastic-Recycler/augmente_couple_1.stl

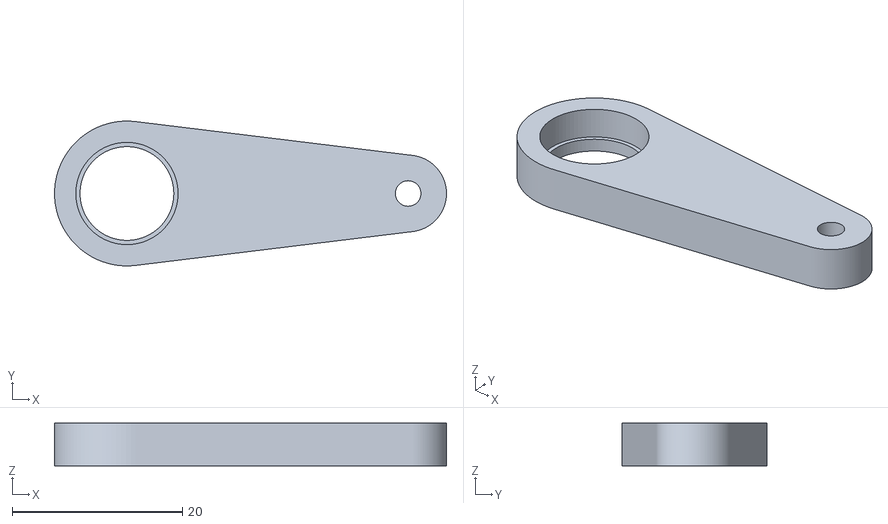
[picture p340: CAD file, 2021-12-22]
augmente_couple_1.stl
46.0 x 17.0 x 5.00
