RolandThsive/3D-printer-Plastic-Recycler/support_gauche_trancannage.stl

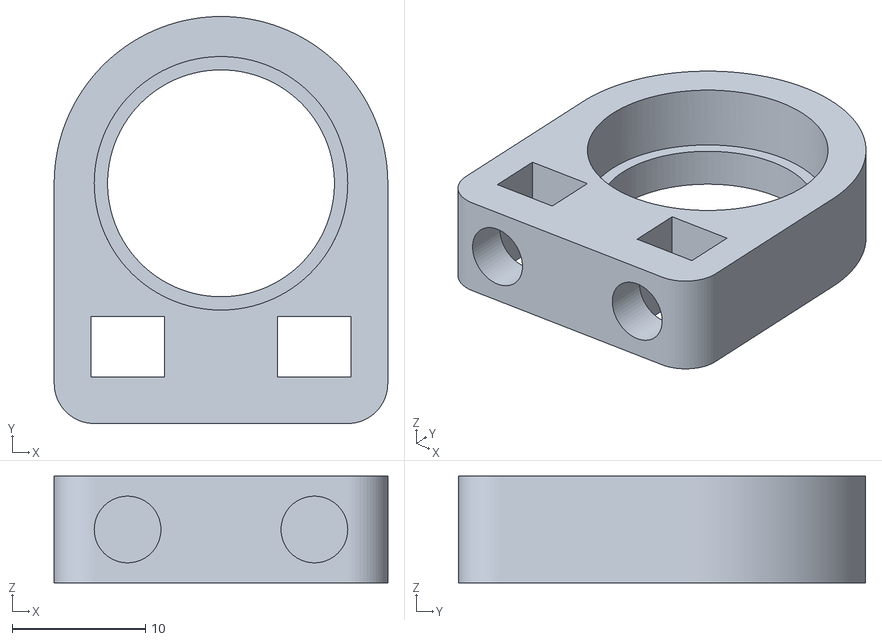
[picture p341: CAD file, 2021-12-22]
support_gauche_trancannage.stl
25.0 x 30.5 x 8.00
