RolandThsive/3D-printer-Plastic-Recycler/guide_fil_trancannage.stl

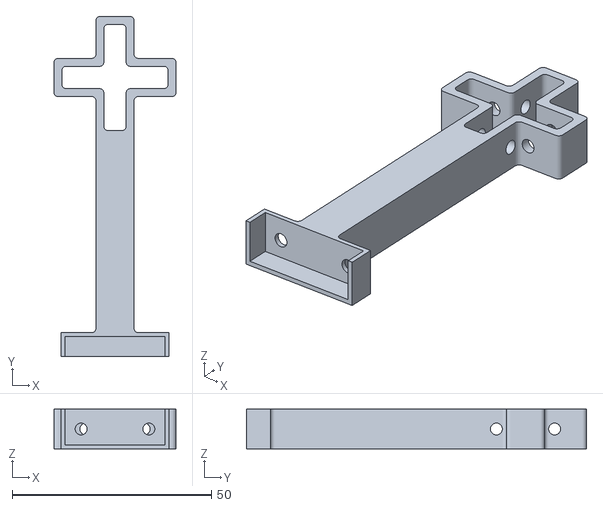
[picture p342: CAD file, 2021-12-22]
guide_fil_trancannage.stl
30.6 x 85.3 x 10.0
