RolandThsive/3D-printer-Plastic-Recycler/galet_entrainement_fil_test_fab.stl

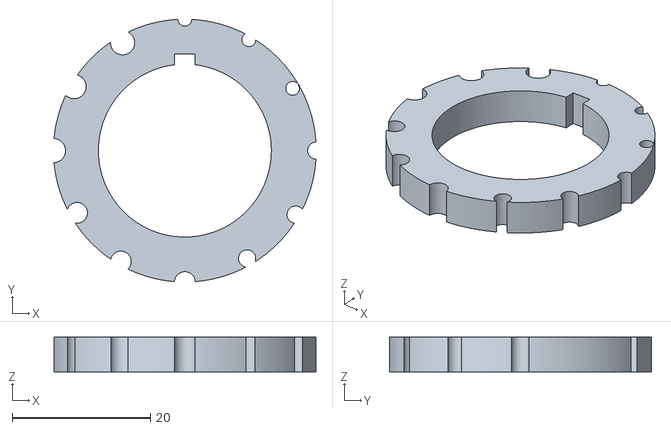
[picture p343: CAD file, 2021-12-22]
galet_entrainement_fil_test_fab.stl
37.9 x 37.9 x 5.00
