RolandThsive/3D-printer-Plastic-Recycler/support_hauban_large_pince.stl

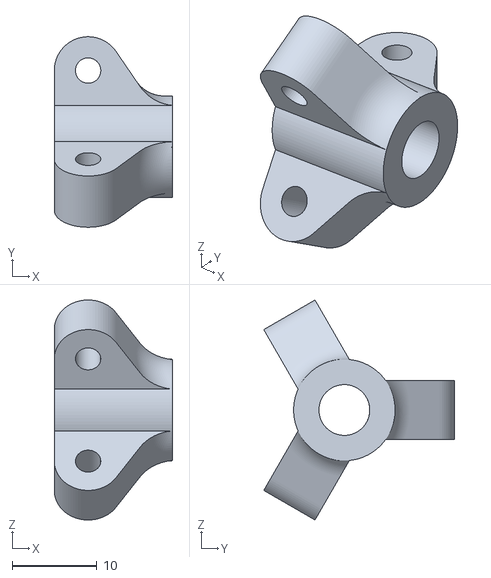
[picture p344: CAD file, 2021-12-22]
support_hauban_large_pince.stl
14.0 x 22.5 x 26.0
