RolandThsive/3D-printer-Plastic-Recycler/serre_mors_volant_inertie_stir.stl

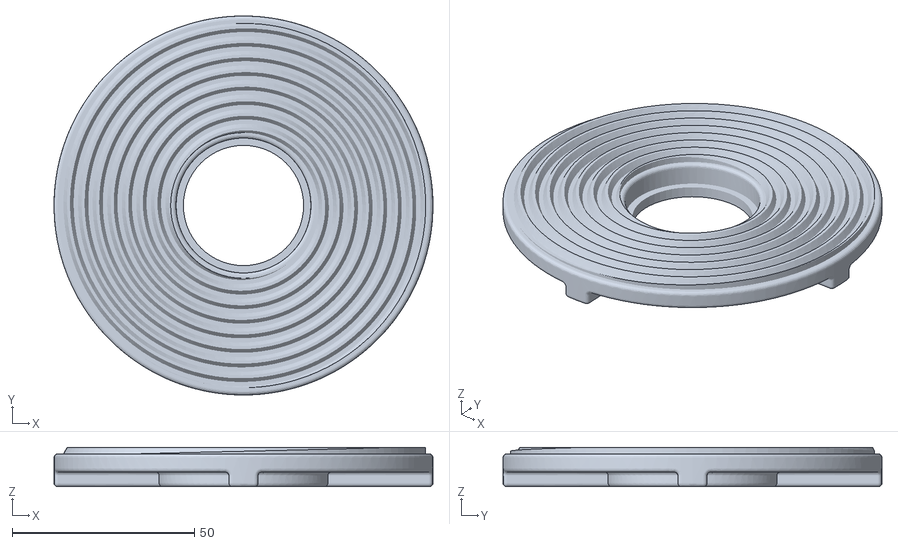
[picture p345: CAD file, 2021-12-22]
serre_mors_volant_inertie_stir.stl
104.0 x 104.0 x 10.8
