RolandThsive/3D-printer-Plastic-Recycler/porte_pince.stl

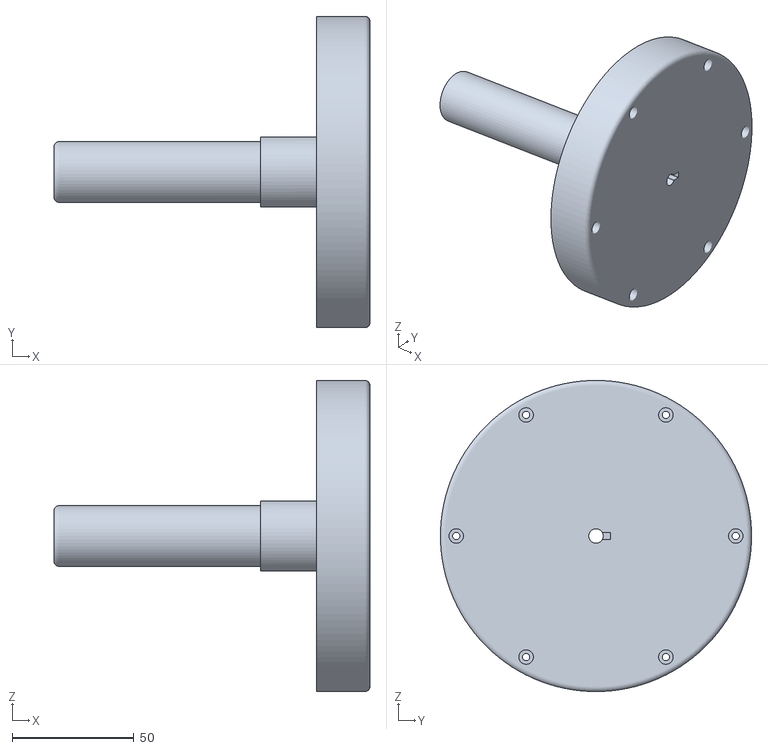
[picture p346: CAD file, 2021-12-22]
porte_pince.stl
130.0 x 128.0 x 128.0
