RolandThsive/3D-printer-Plastic-Recycler/chapeau_droit_limiteur_couple.stl

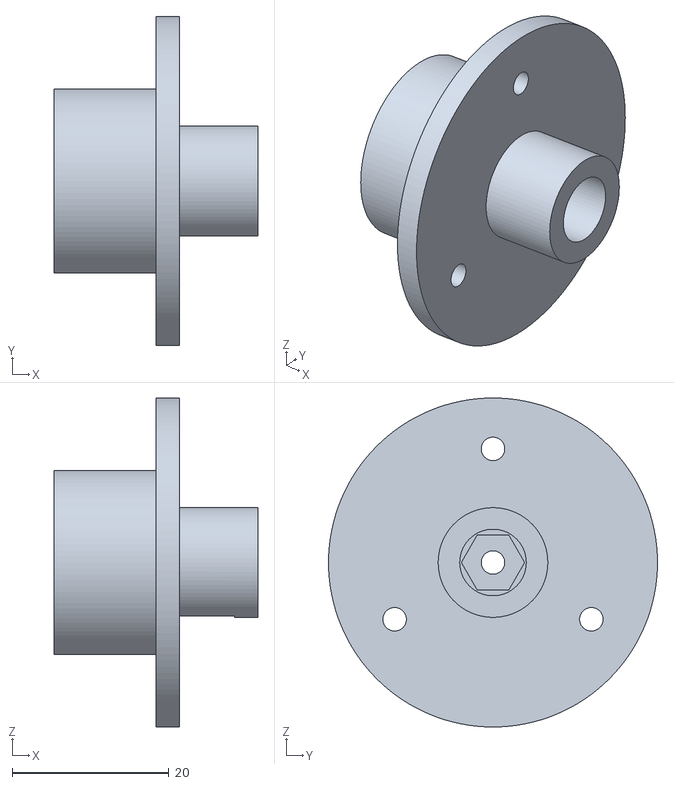
[picture p347: CAD file, 2021-12-22]
chapeau_droit_limiteur_couple.stl
26.0 x 42.0 x 42.0
