RolandThsive/3D-printer-Plastic-Recycler/entretoise_b_limiteur_couple.stl

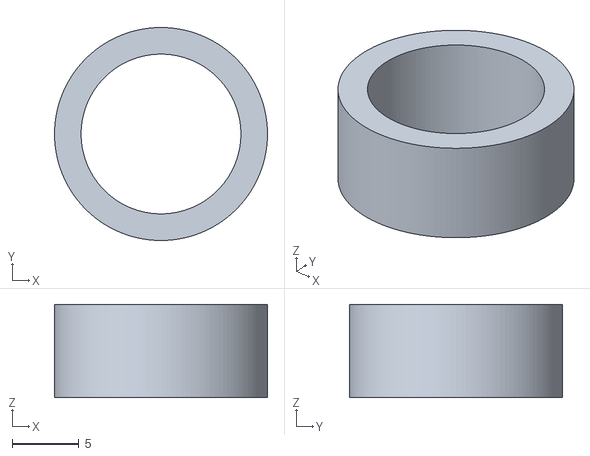
[picture p349: CAD file, 2021-12-22]
entretoise_b_limiteur_couple.stl
16.0 x 16.0 x 7.00
