RolandThsive/3D-printer-Plastic-Recycler/tenseur_gauche_guide_fil.stl

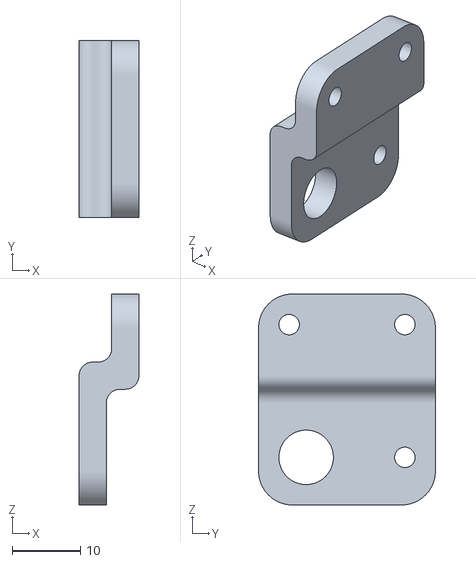
[picture p350: CAD file, 2021-12-22]
tenseur_gauche_guide_fil.stl
8.80 x 26.0 x 31.0
