RolandThsive/3D-printer-Plastic-Recycler/porteur_support_bobine.stl

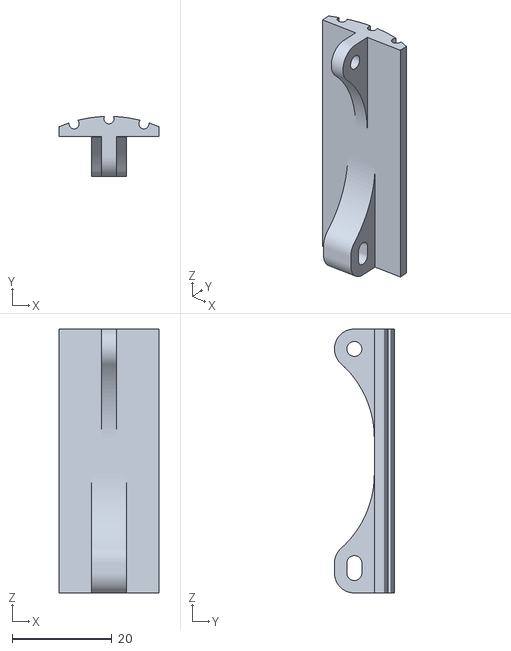
[picture p352: CAD file, 2021-12-22]
porteur_support_bobine.stl
20.0 x 12.1 x 53.0
