RolandThsive/3D-printer-Plastic-Recycler/porte_mors_volant_inertie_stir.stl

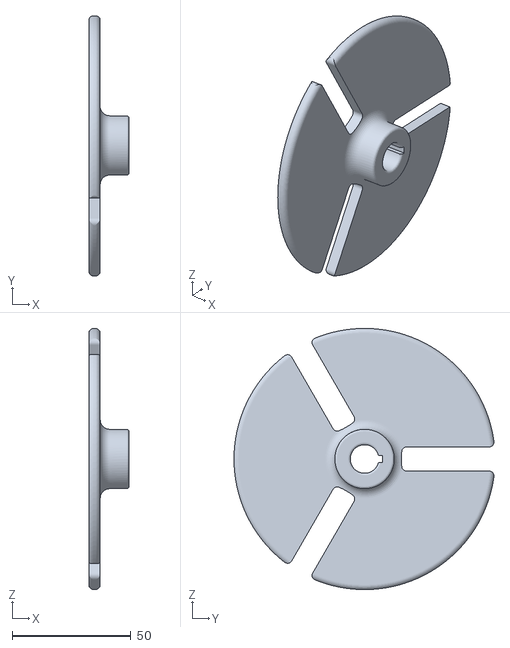
[picture p353: CAD file, 2021-12-22]
porte_mors_volant_inertie_stir.stl
17.0 x 109.5 x 110.0
