RolandThsive/3D-printer-Plastic-Recycler/plaque_regenerateur_stirling.dxf

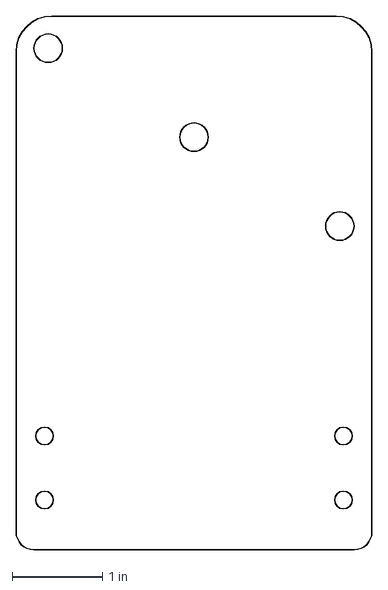
[picture p354: CAD file, 2021-12-22]
plaque_regenerateur_stirling.dxf
3.94 x 5.91 in
