RolandThsive/3D-printer-Plastic-Recycler/support_moteur_stirling.stl

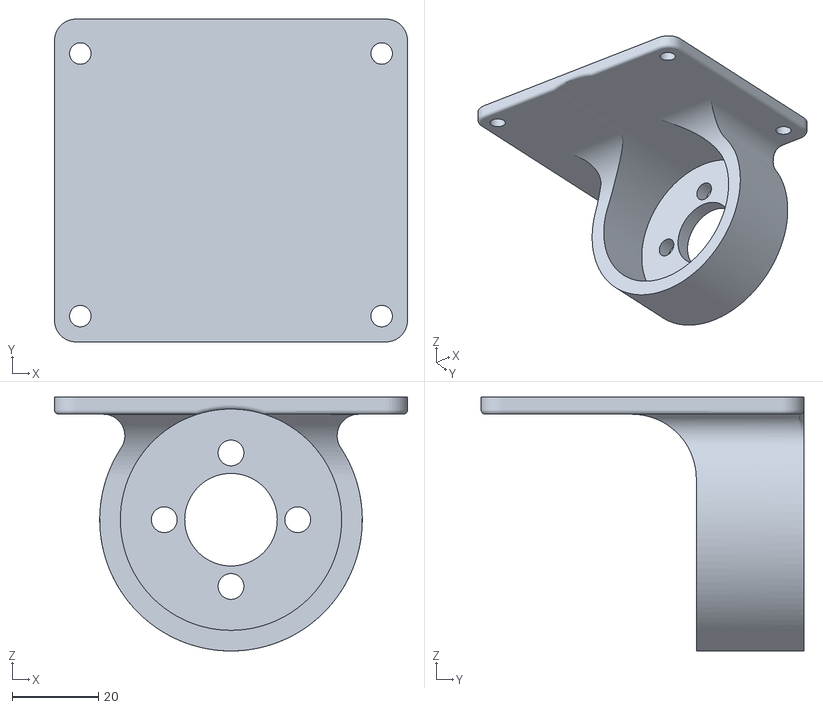
[picture p355: CAD file, 2021-12-22]
support_moteur_stirling.stl
82.0 x 75.0 x 59.0
