RolandThsive/3D-printer-Plastic-Recycler/entretoise_support_pince.stl

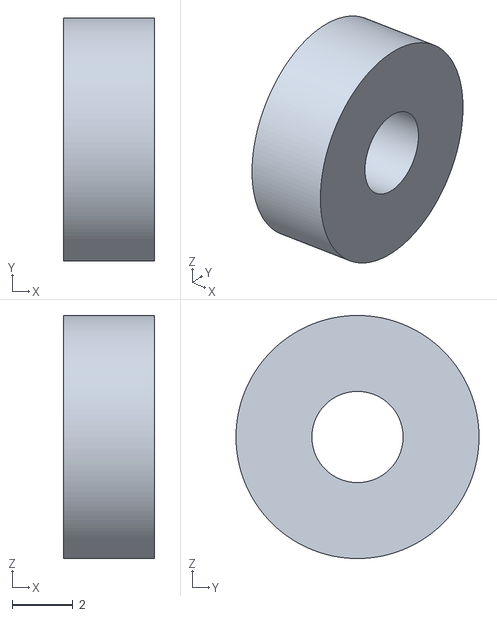
[picture p356: CAD file, 2021-12-22]
entretoise_support_pince.stl
3.00 x 8.00 x 8.00
