RolandThsive/3D-printer-Plastic-Recycler/entretoise_arbre_pince.stl

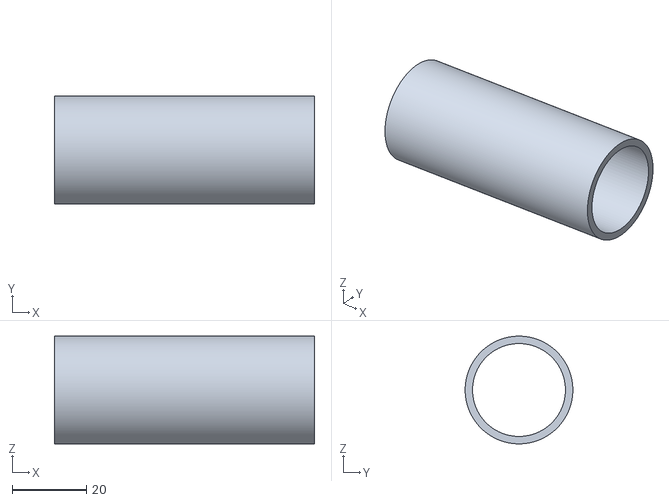
[picture p357: CAD file, 2021-12-22]
entretoise_arbre_pince.stl
70.0 x 29.0 x 29.0
