RolandThsive/3D-printer-Plastic-Recycler/galet_entrainement_guide_fil.stl

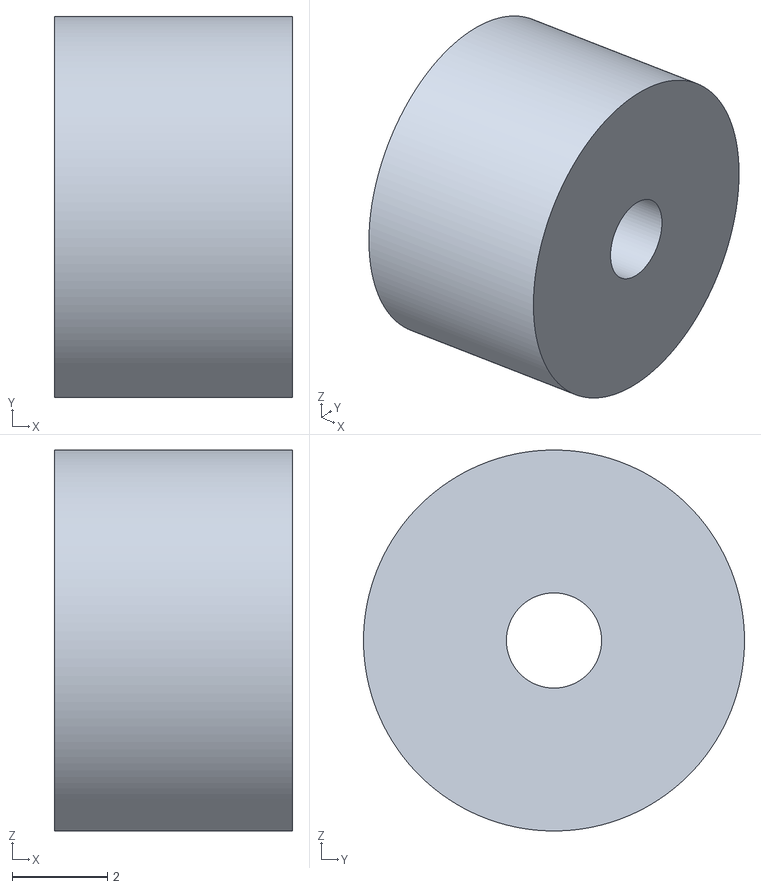
[picture p358: CAD file, 2021-12-22]
galet_entrainement_guide_fil.stl
5.00 x 8.00 x 8.00
