RolandThsive/3D-printer-Plastic-Recycler/support_arbre_support_bobine.stl

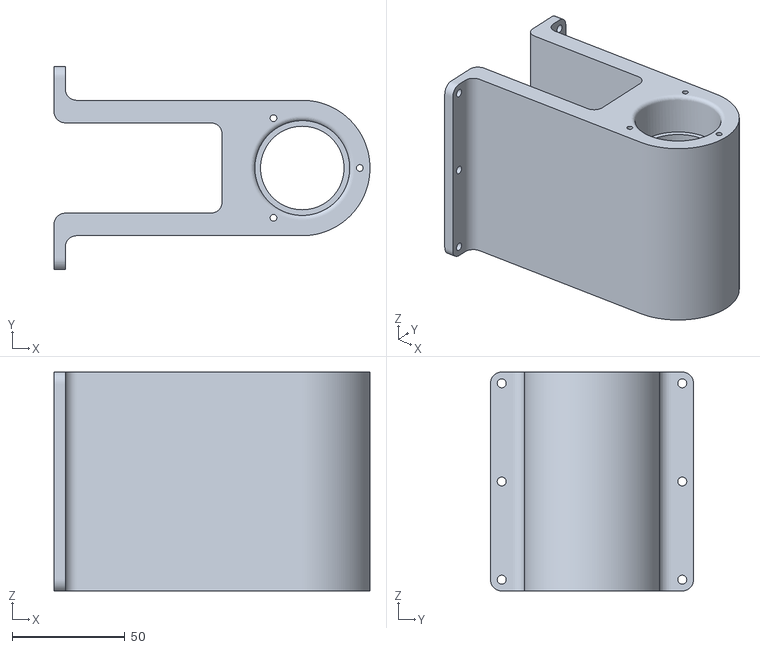
[picture p359: CAD file, 2021-12-22]
support_arbre_support_bobine.stl
140.0 x 90.0 x 97.0
