RolandThsive/3D-printer-Plastic-Recycler/socle_moteur_stirling.dxf

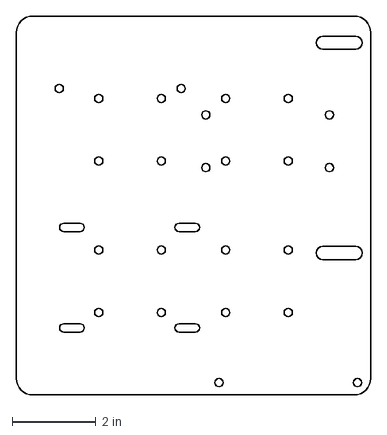
[picture p360: CAD file, 2021-12-22]
socle_moteur_stirling.dxf
8.46 x 9.06 in
