RolandThsive/3D-printer-Plastic-Recycler/entretoise_a_limiteur_couple.stl

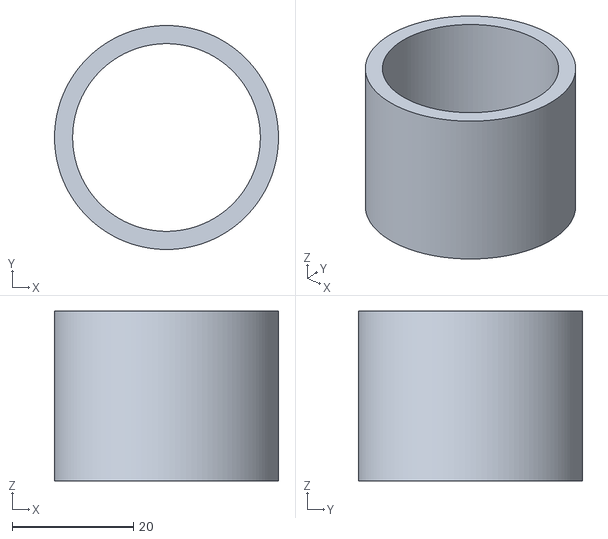
[picture p361: CAD file, 2021-12-22]
entretoise_a_limiteur_couple.stl
37.0 x 37.0 x 28.0
