RolandThsive/3D-printer-Plastic-Recycler/support_arbre_limiteur_couple.stl

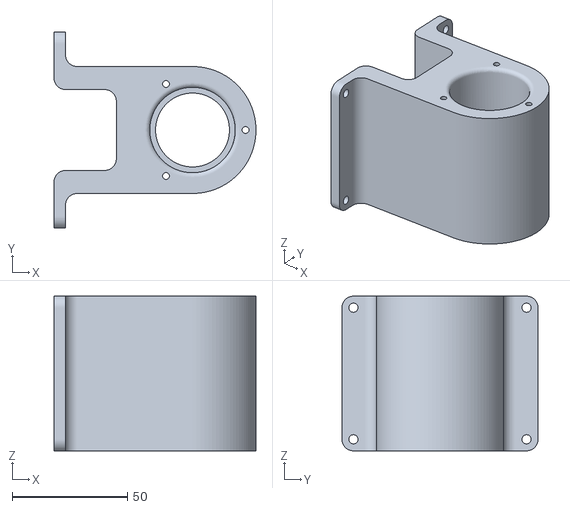
[picture p362: CAD file, 2021-12-22]
support_arbre_limiteur_couple.stl
87.5 x 85.0 x 67.0
