RolandThsive/3D-printer-Plastic-Recycler/support_arbre_striling.stl

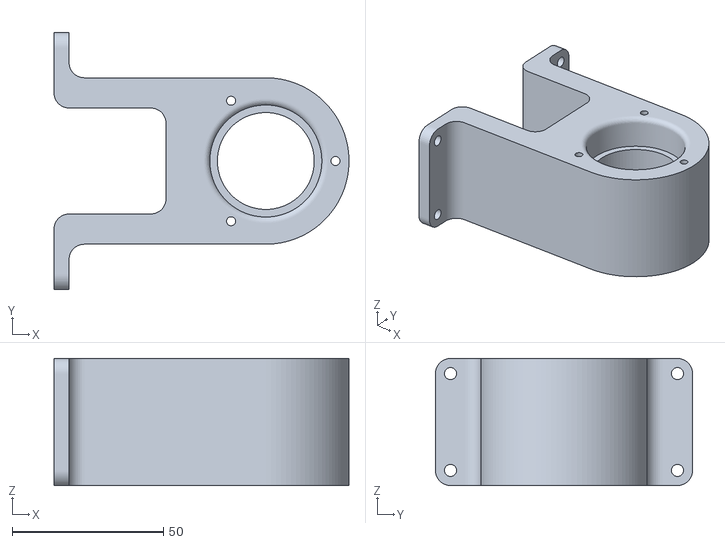
[picture p363: CAD file, 2021-12-22]
support_arbre_striling.stl
97.5 x 85.0 x 42.0
