RolandThsive/3D-printer-Plastic-Recycler/arbre_entrainement_fil.stl

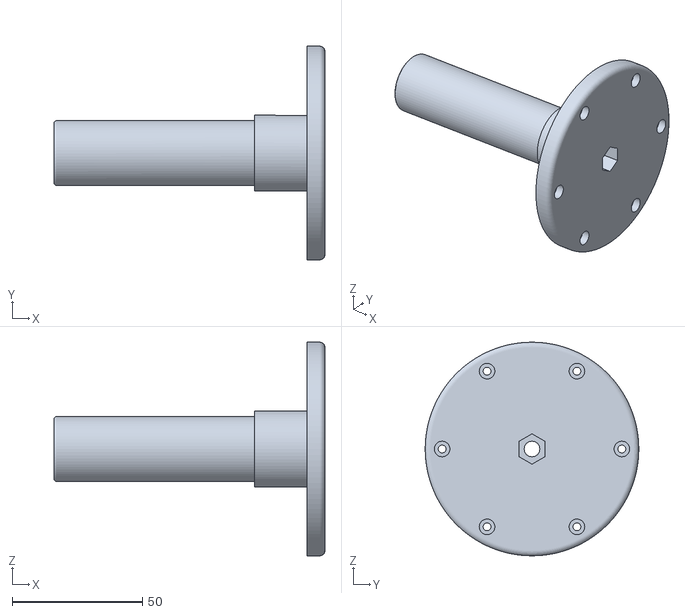
[picture p364: CAD file, 2021-12-22]
arbre_entrainement_fil.stl
104.0 x 82.0 x 82.0
