RolandThsive/3D-printer-Plastic-Recycler/entretoise_support_bobine.stl

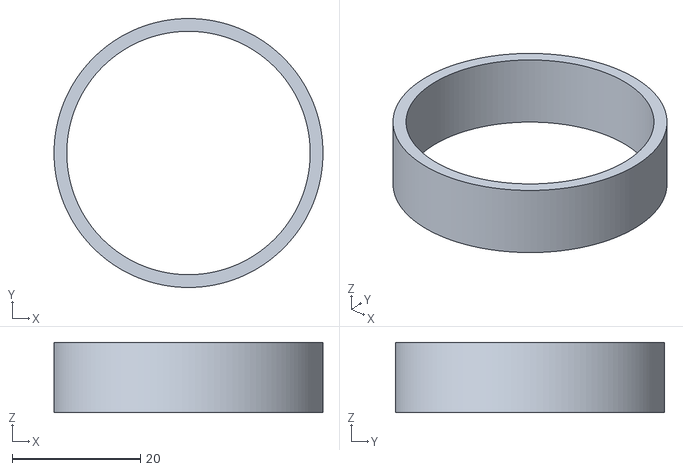
[picture p365: CAD file, 2021-12-22]
entretoise_support_bobine.stl
42.0 x 42.0 x 11.0
