RolandThsive/3D-printer-Plastic-Recycler/test_fil_caoutchouc.stl

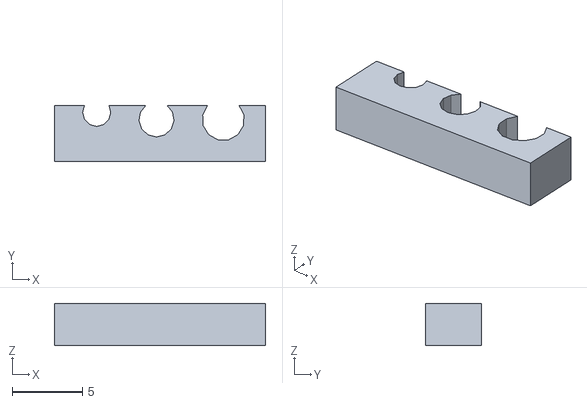
[picture p366: CAD file, 2021-12-22]
test_fil_caoutchouc.stl
15.0 x 4.00 x 3.00
