RolandThsive/3D-printer-Plastic-Recycler/poulie_132d_7l_a_stirling.stl

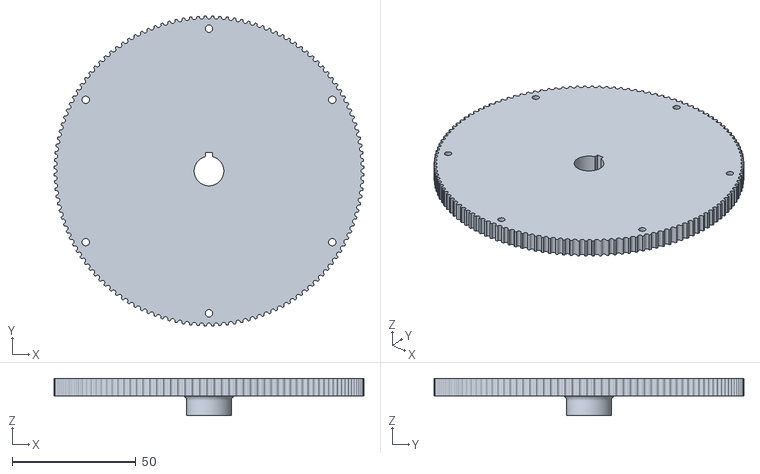
[picture p367: CAD file, 2021-12-22]
poulie_132d_7l_a_stirling.stl
125.3 x 125.3 x 15.0
