RolandThsive/3D-printer-Plastic-Recycler/entretoise_arbre_trancannage.stl

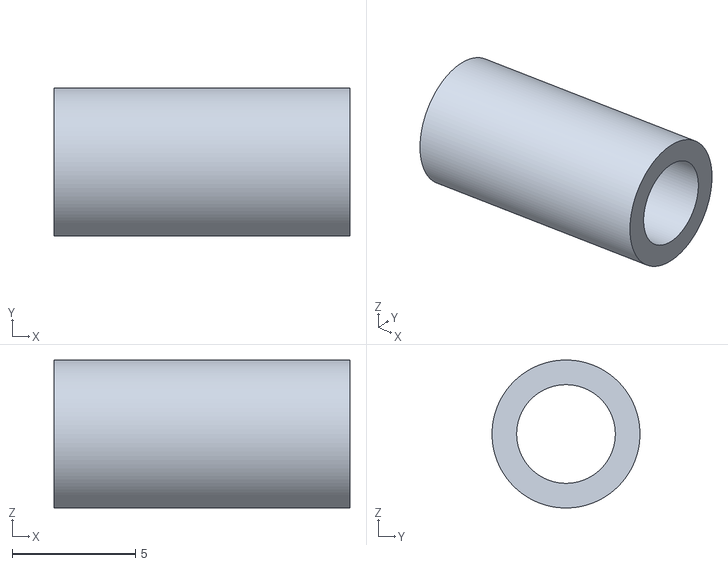
[picture p368: CAD file, 2021-12-22]
entretoise_arbre_trancannage.stl
12.0 x 6.00 x 6.00
