RolandThsive/3D-printer-Plastic-Recycler/galet_entrainement_fil.stl

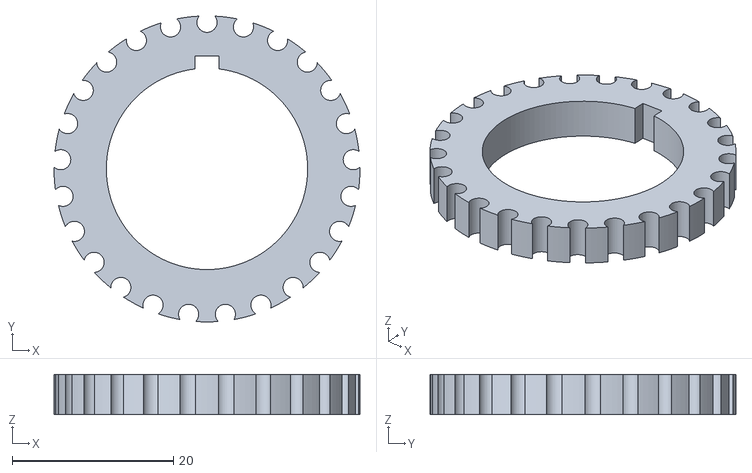
[picture p369: CAD file, 2021-12-22]
galet_entrainement_fil.stl
38.0 x 38.0 x 5.00
