RolandThsive/3D-printer-Plastic-Recycler/biellette_a_moteur_stirling.stl

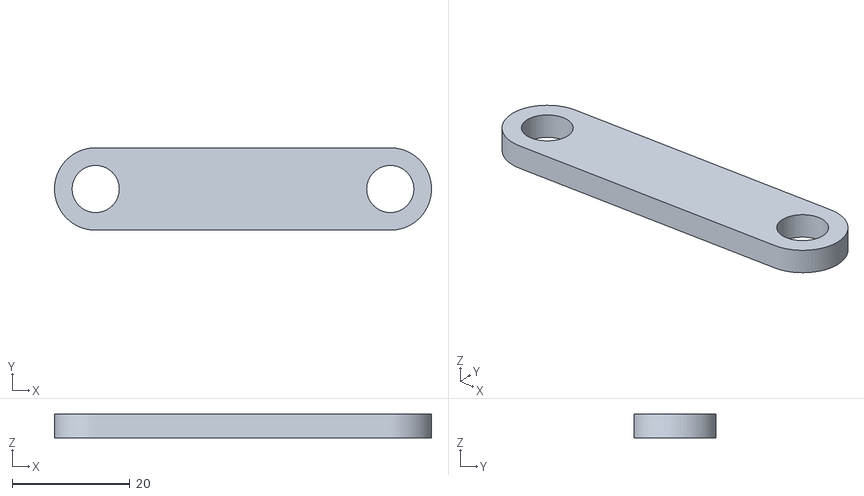
[picture p370: CAD file, 2021-12-22]
biellette_a_moteur_stirling.stl
64.0 x 14.0 x 4.00
