RolandThsive/3D-printer-Plastic-Recycler/accouplement_limiteur_couple.stl

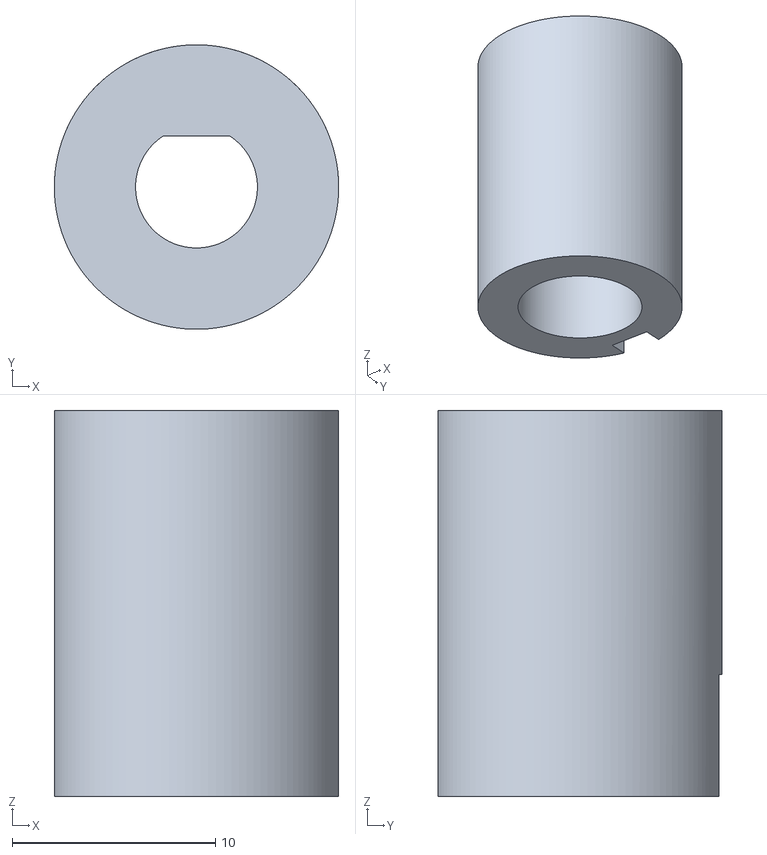
[picture p371: CAD file, 2021-12-22]
accouplement_limiteur_couple.stl
14.0 x 14.0 x 19.0
