RolandThsive/3D-printer-Plastic-Recycler/support_hauban_b_guide_fil.stl

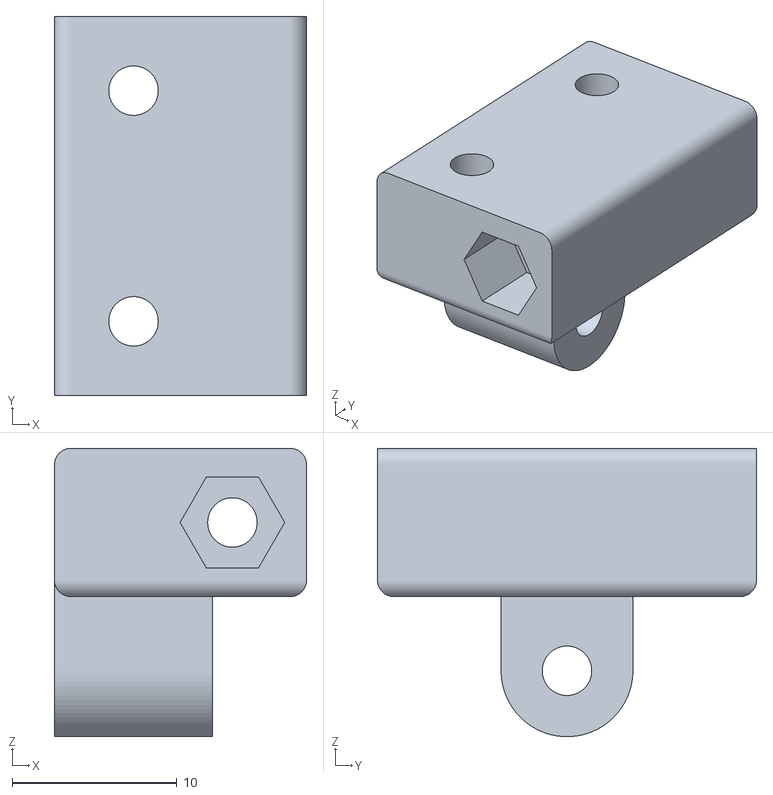
[picture p372: CAD file, 2021-12-22]
support_hauban_b_guide_fil.stl
15.3 x 23.0 x 17.5
