RolandThsive/3D-printer-Plastic-Recycler/flasque_guide_fil.stl

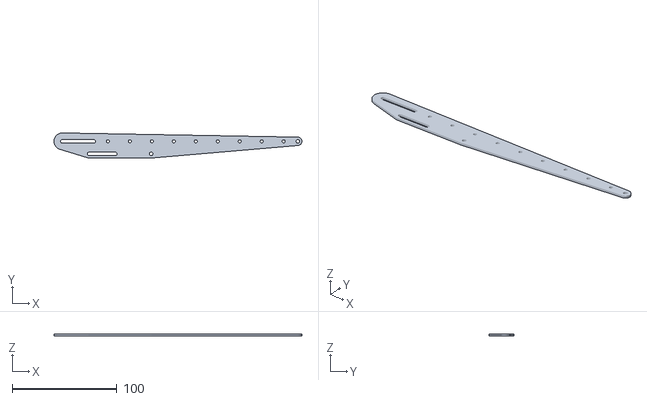
[picture p373: CAD file, 2021-12-22]
flasque_guide_fil.stl
237.0 x 24.0 x 2.00
