RolandThsive/3D-printer-Plastic-Recycler/coquille_seringue_stirling.stl

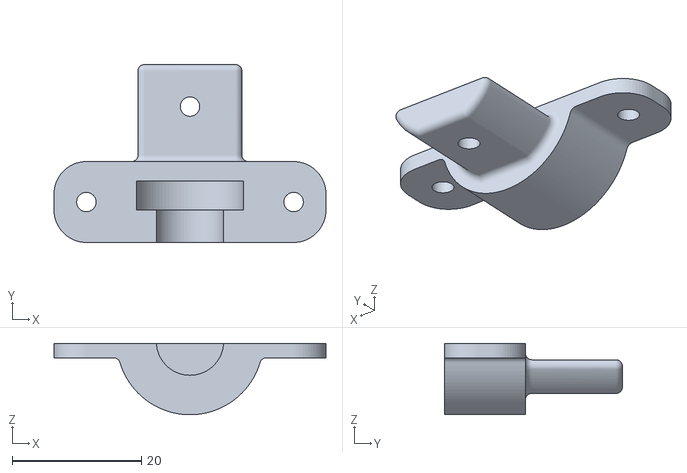
[picture p374: CAD file, 2021-12-22]
coquille_seringue_stirling.stl
42.0 x 27.5 x 11.1
