RolandThsive/3D-printer-Plastic-Recycler/support_droit_trancannage.stl

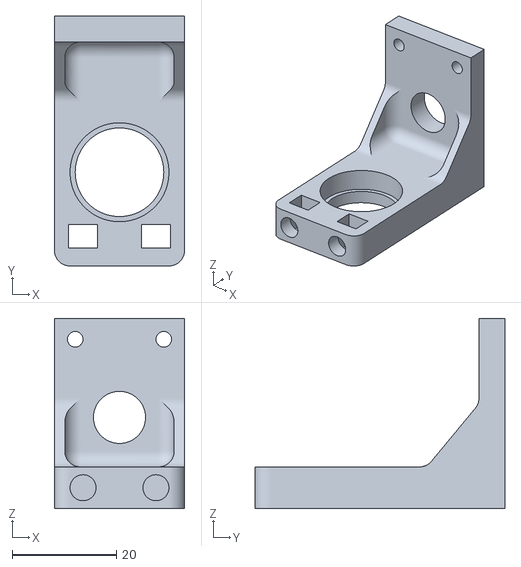
[picture p375: CAD file, 2021-12-22]
support_droit_trancannage.stl
25.0 x 48.0 x 36.5
