RolandThsive/3D-printer-Plastic-Recycler/support_ventilateur.dxf

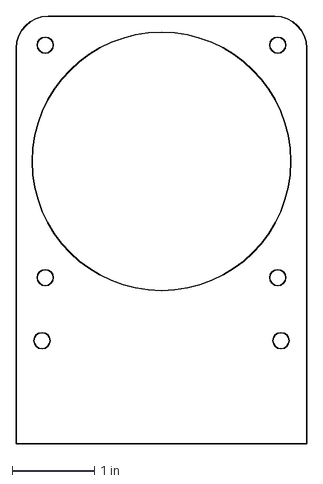
[picture p376: CAD file, 2021-12-22]
support_ventilateur.dxf
3.54 x 5.22 in
