RolandThsive/3D-printer-Plastic-Recycler/(list of files, cad)

Other CAD files:
entretoise_b_stirling.stl
poulie_44d_7l_trancannage.stl
support_roulement_g_trancannage.stl
reglage_hauteur_trancannage_g.stl
reglage_hauteur_trancannage_gb.stl
tenseur_droit_guide_fil.stl
accouplement_limiteur_couple.prt
arbre_droit_limiteur_couple.prt
arbre_entrainement_fil.prt
arbre_entrainement_stirling.prt
arbre_gauche_limiteur_couple.prt
arbre_trancannage.prt
augmente_couple_1.prt
augmente_couple_2.prt
axe_transmission_couple.prt
bande_poncage_12_457_guide_fil.prt
base_inferieure.prt
base_laterale.prt
base_maintien.prt
bati.prt
biellette_a_moteur_stirling.prt
bille_pla.prt
bille_porteuse_m6_15_d13.prt
buse_fourreau.prt
cage_protection.prt
cage_protection_bobineuse.prt
chapeau_droit_limiteur_couple.prt
chapeau_ext_limiteur_couple.prt
chapeau_ext_stirling.prt
chapeau_exterieur_bobine.prt
chapeau_exterieur_entrainement.prt
chapeau_gauche_limiteur_couple.prt
chapeau_interieur_bobine.prt
chapeau_interieur_entrainement.prt
chariot_glissiere_igus.prt
charniere_partie_1.prt
charniere_partie_2.prt
clavette_3_3_12.prt
cle_allen_m3.prt
collecteur_tremie.prt
collecteur_ventilateur.prt
collier_chauffant.prt
collier_serrage_30.prt
collier_serrage_buse.prt
collier_serrage_fourreau.prt
coquille_seringue_stirling.prt
couvercle_tremie.prt
durite_a_stirling.prt
durite_b_stirling.prt
ecrou_frein_m3.prt
ecrou_frein_m4.prt
ecrou_frein_m6.prt
ecrou_hex_fin_m12.prt
ecrou_hex_fin_m4.prt
ecrou_hex_m3.prt
ecrou_hex_m4.prt
ecrou_m4.prt
ecrou_m8.prt
ecrou_molete_m3_amazon.prt
ecrou_molete_m4.prt
ecrou_molete_m6.prt
ecrou_renvoit_angle_stirling.prt
entretoise_a_guide_fil.prt
entretoise_a_limiteur_couple.prt
entretoise_a_stirling.prt
entretoise_arbre_pince.prt
entretoise_arbre_trancannage.prt
entretoise_b_guide_fil.prt
entretoise_b_limiteur_couple.prt
entretoise_b_stirling.prt
entretoise_c_guide_fil.prt
entretoise_clavette_bobine.prt
entretoise_d_guide_fil.prt
entretoise_entrainement_fil.prt
entretoise_ext_entrainement_fil.prt
entretoise_porte_satellite_0.prt
entretoise_porte_satellite_2.prt
entretoise_rotation_trancannage.prt
entretoise_support_bobine.prt
entretoise_support_pince.prt
entretoise_transmission_stirlin.prt
equerre_metallique.prt
fil_bobineuse_pla_175.prt
fil_caoutchouc_entrainement_fil.prt
fil_caoutchouc_support_bobine.prt
fil_caoutchouc_trancannage.prt
fil_pla_175.prt
fil_test_trancannage.prt
flasque_galet_entrainement_fil.prt
flasque_guide_fil.prt
flasque_pouli_a_limiteur_couple.prt
flasque_pouli_b_limiteur_couple.prt
flasque_poulie_entrainement_fil.prt
flasque_poulie_support_bobine.prt
flasque_poulie_trancannage.prt
foret_bois.prt
fourche_trancannage.prt
fourreau.prt
galet_entrainement_fil.prt
galet_entrainement_guide_fil.prt
grande_bobine.prt
guide_fil_trancannage.prt
hauban_guide_fil.prt
hauban_support_bobine.prt
iris_base.prt
iris_blade.prt
iris_ring.prt
liaison_fourreau_tremie_1.prt
liaison_fourreau_tremie_2.prt
manivelle_moteur_stirling.prt
mors_1_volant_inertie_stir.prt
mors_2_volant_inertie_stir.prt
mors_3_volant_inertie_stir.prt
moteur_6v_15v.prt
moteur_electrique_stirling.prt
petite_bobine.prt
planetaire_exterieur_couronne.prt
planetaire_interieur_pignon_1.prt
planetaire_interieur_pignon_2.prt
plaque_regenerateur_stirling.prt
plaque_support_bobineuse.prt
plaque_support_extrudeuse.prt
plaque_tremie_arriere.prt
plaque_tremie_avant.prt
plaque_tremie_laterale.prt
poignee_couvercle_tremie.prt
porte_fil_caoutchouc_droit.prt
porte_fil_caoutchouc_gauche.prt
porte_mors_volant_inertie_stir.prt
porte_pince.prt
porte_roulement_billes.prt
porte_satellite_0.prt
porte_satellite_2.prt
porteur_support_bobine.prt
poulie_132d_7l_a_stirling.prt
poulie_132d_7l_support_bobine.prt
poulie_42d_7l_a_limiteur_couple.prt
poulie_42d_7l_b_limiteur_couple.prt
poulie_44d_7l_b_stirling.prt
poulie_44d_7l_trancannage.prt
poulie_84d_7l_entrainement_fil.prt
poulie_entrainement_fil.prt
poulie_entrainement_guide_fil.prt
rail_entrainement_fil.prt
rail_guide_fil.prt
rail_trancannage.prt
rayon_stockage.prt
reglage_angle_trancannage.prt
reglage_hauteur_trancannage_d.prt
reglage_hauteur_trancannage_g.prt
ressort_entrainement_fil.prt
ressort_guide_fil.prt
ressort_support_bobine.prt
ressort_traction_trancannage.prt
rondelle_belleville_m3.prt
rondelle_manivelle_stirling.prt
rondelle_plate_m3.prt
rondelle_plate_m4.prt
rondelle_plate_m6.prt
rondelle_plate_m8.prt
roulement_bille_d12.prt
roulement_billes_03_10_04_a.prt
roulement_billes_03_10_04_b.prt
roulement_billes_03_10_04_c.prt
roulement_billes_03_10_04_d.prt
roulement_billes_03_10_04_e.prt
roulement_billes_08_12_35_a.prt
roulement_billes_08_12_35_b.prt
roulement_billes_08_12_35_c.prt
roulement_billes_08_12_35_d.prt
roulement_billes_08_12_35_e.prt
roulement_billes_10_19_5_a.prt
roulement_billes_10_19_5_b.prt
roulement_billes_10_19_5_c.prt
roulement_billes_10_19_5_d.prt
roulement_billes_10_19_5_e.prt
roulement_billes_12_32_10_a.prt
roulement_billes_12_32_10_b.prt
roulement_billes_12_32_10_c.prt
roulement_billes_12_32_10_d.prt
roulement_billes_12_32_10_e.prt
roulement_billes_12_37_12_a.prt
roulement_billes_12_37_12_b.prt
roulement_billes_12_37_12_c.prt
roulement_billes_12_37_12_d.prt
roulement_billes_12_37_12_e.prt
roulement_billes_25_37_7_a.prt
roulement_billes_25_37_7_b.prt
roulement_billes_25_37_7_c.prt
roulement_billes_25_37_7_d.prt
roulement_billes_25_37_7_e.prt
roulement_billes_25_42_9_a.prt
roulement_billes_25_42_9_b.prt
roulement_billes_25_42_9_c.prt
roulement_billes_25_42_9_d.prt
roulement_billes_25_42_9_e.prt
roulement_billes_3_8_4_a.prt
roulement_billes_3_8_4_b.prt
roulement_billes_3_8_4_c.prt
roulement_billes_3_8_4_d.prt
roulement_billes_3_8_4_e.prt
roulement_billes_4_12_4_a.prt
roulement_billes_4_12_4_b.prt
roulement_billes_4_12_4_c.prt
roulement_billes_4_12_4_d.prt
roulement_billes_4_12_4_e.prt
roulement_billes_6_10_3_a.prt
roulement_billes_6_10_3_b.prt
roulement_billes_6_10_3_c.prt
roulement_billes_6_10_3_d.prt
roulement_billes_6_10_3_e.prt
roulette_partie_a.prt
roulette_partie_b.prt
roulette_partie_c.prt
satellite_porte_satellite.prt
seringue_exterieure_plastique.prt
seringue_exterieure_verre.prt
seringue_interieure_plastique.prt
seringue_interieure_verre.prt
serre_mors_volant_inertie_stir.prt
socle_moteur_stirling.prt
support_arbre_entrainement_fil.prt
support_arbre_limiteur_couple.prt
support_arbre_striling.prt
support_arbre_support_bobine.prt
support_droit_trancannage.prt
support_fourreau.prt
support_gauche_trancannage.prt
support_hauban_a_guide_fil.prt
support_hauban_b_guide_fil.prt
support_hauban_large_pince.prt
support_hauban_mince_pince.prt
support_moteur_bobineuse.prt
support_moteur_extrudeuse.prt
support_moteur_stirling.prt
support_planetaire_exterieur.prt
support_ressort_entrainement.prt
support_roulement_d_trancannage.prt
support_roulement_g_trancannage.prt
support_tremie_haut.prt
support_tremie_sol.prt
support_ventilateur.prt
tenseur_droit_guide_fil.prt
tenseur_gauche_guide_fil.prt
thermocouple_fourreau.prt
tige_filetee_a_m3_stirling.prt
tige_filetee_a_m8_stirling.prt
tige_filetee_b_m3_stirling.prt
tige_filetee_b_m8_stirling.prt
tige_filetee_m3_entrainement.prt
tige_filetee_m3_guide_fil.prt
tige_filetee_m3_limiteur_couple.prt
tige_filetee_m3_support_bobine.prt
tige_filetee_m6_entrainement.prt
tige_filetee_m6_support_bobine.prt
tirant_bas_tremie.prt
tirant_haut_tremie.prt
trappe_tremie.prt
ventilateur_refroidisseur_fil.prt
verrou_tremie_01.prt
verrou_tremie_02.prt
verrou_tremie_03.prt
verrou_tremie_04.prt
vis_chc_m3_10.prt
vis_chc_m3_16.prt
vis_chc_m3_20.prt
vis_chc_m3_25.prt
vis_chc_m3_30.prt
vis_chc_m3_40.prt
vis_chc_m3_45.prt
vis_chc_m3_70.prt
vis_chc_m4_20.prt
vis_chc_m4_30.prt
vis_m4_10.prt
vis_m4_16.prt
vis_m4_25.prt
vis_m4_35.prt
vis_m4_55.prt
vis_micrometrique_trancannage.prt
vis_sans_tete_m3_10.prt
