RolandThsive/3D-printer-Plastic-Recycler/assemblage_moteur_stirling-1.pdf

# COUPE A-A

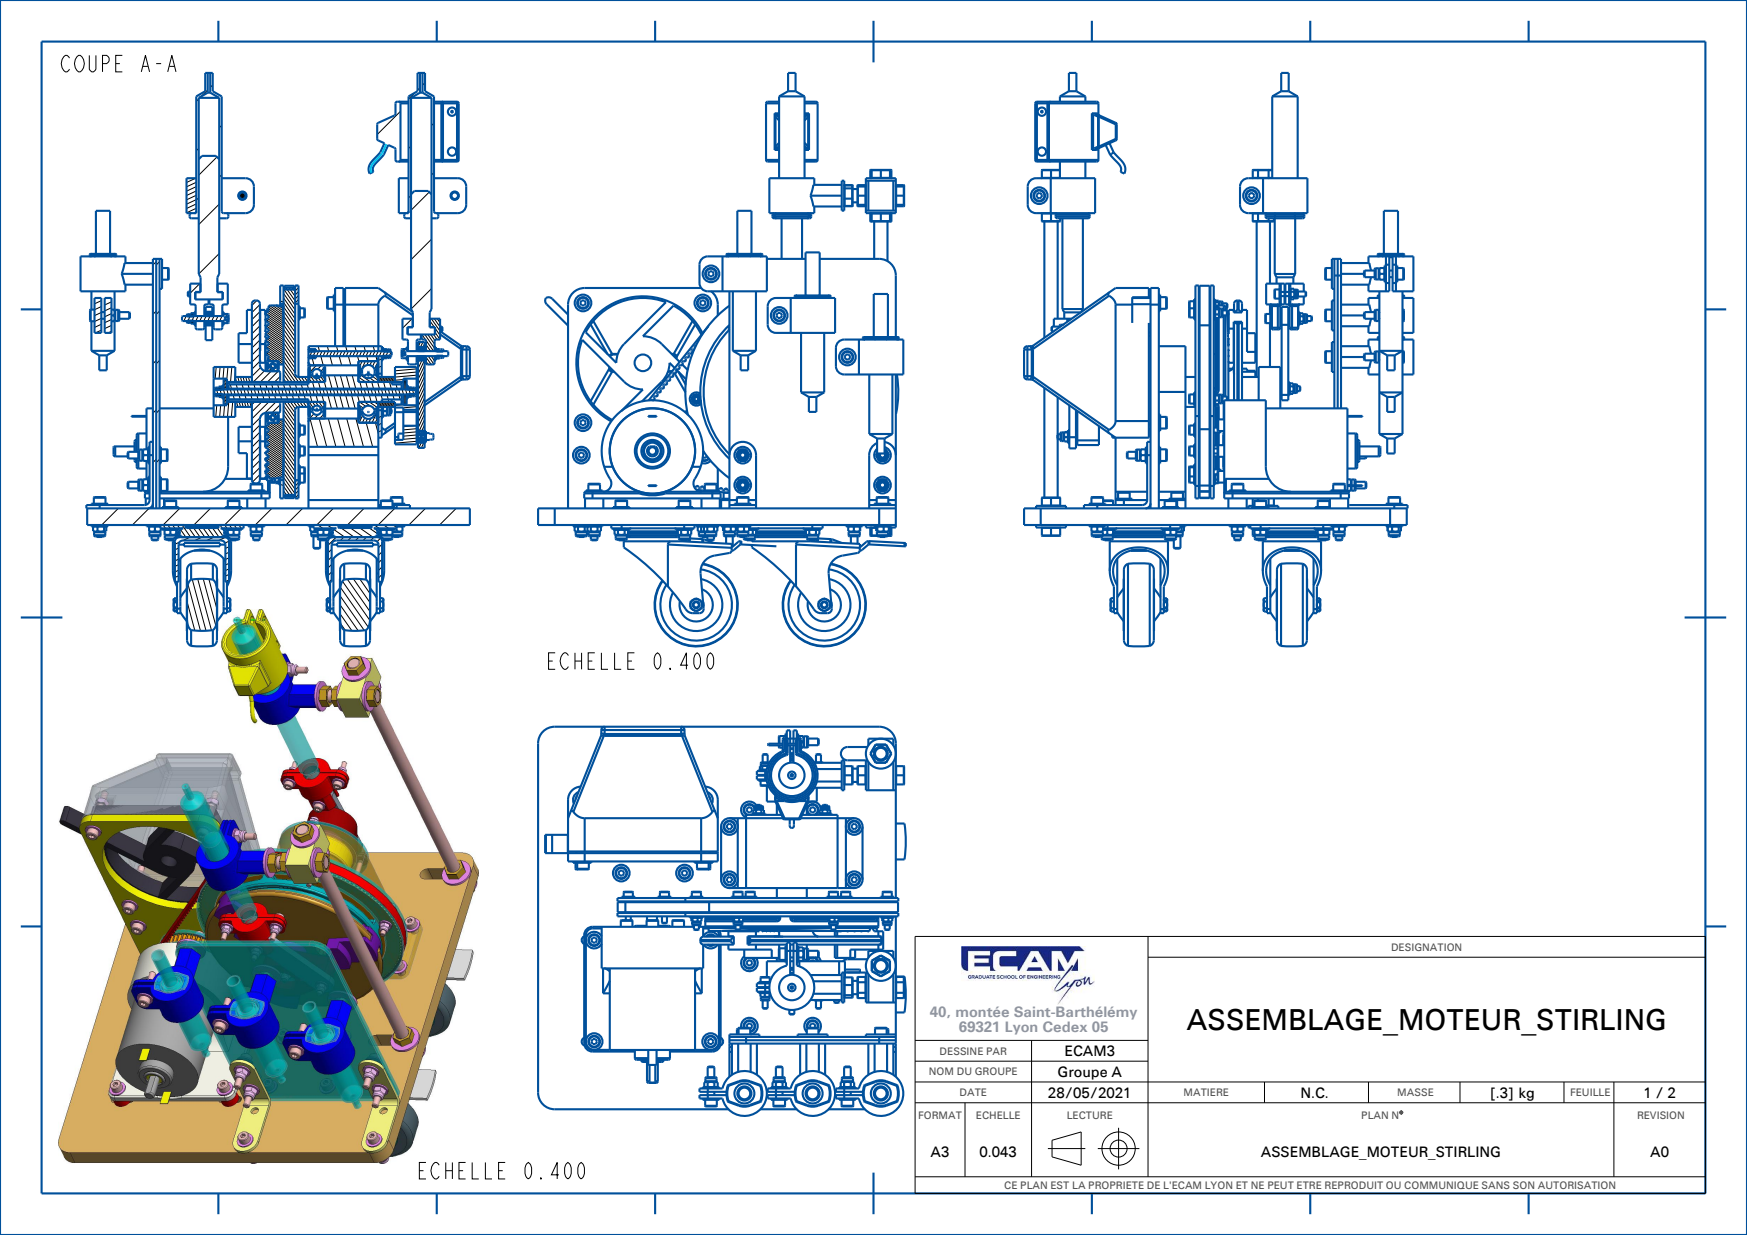
[picture p378: page 1]
ECHELLE 0.400; DESIGNATION; 69321 Lyon Cedex 05; ASSEMBLAGE_MOTEUR_STIRLING; DESSINE PAR; ECAM3; NOM DU GROUPE; Groupe A; DATE; MATIERE; MASSE; FEUILLE; FORMAT; ECHELLE; LECTURE; PLAN N; REVISION

40, montée Saint-Barthélémy

CE PLAN EST LA PROPRIETE DE L'ECAM LYON ET NE PEUT ETRE REPRODUIT OU COMMUNIQUE SANS SON AUTORISATION
