RolandThsive/3D-printer-Plastic-Recycler/assemblage_moteur_stirling.pdf

# COUPE A-A

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

40, montée Saint-Barthélémy

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

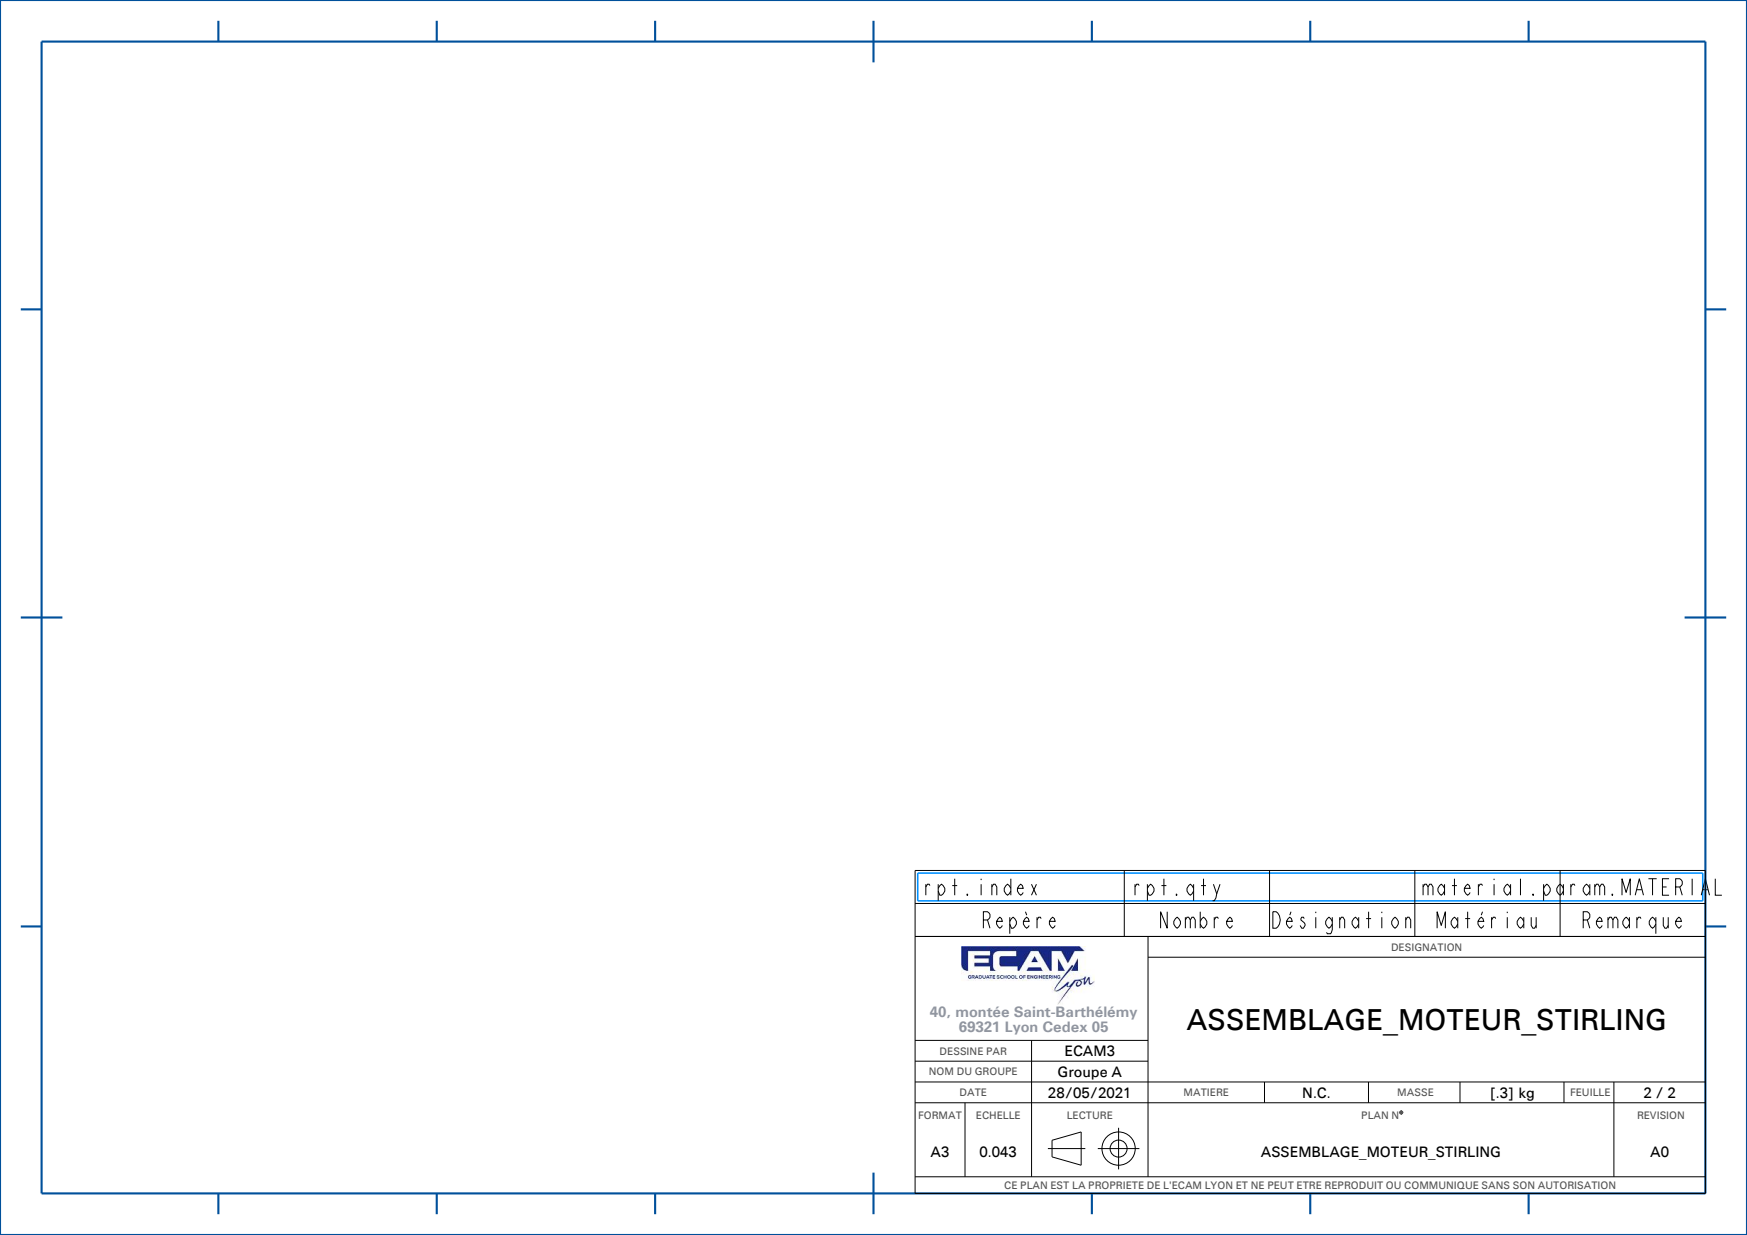
[picture p379: page 2]
Repère; Nombre; Désignation; Matériau; Remarque; rpt.index; rpt.qty; material.param.MATERIAL; DESIGNATION; 69321 Lyon Cedex 05; ASSEMBLAGE_MOTEUR_STIRLING

40, montée Saint-Barthélémy

DESSINE PAR | ECAM3
NOM DU GROUPE | Groupe A
DATE | 28/05/2021 | MATIERE | N.C. | MASSE | [.3] kg | FEUILLE | 2 / 2

FORMAT A3 | ECHELLE 0.043 | LECTURE | | | PLAN N ASSEMBLAGE_MOTEUR_STIRLING | REVISION A0

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
